friendshipismagic/SpiROSE/README.md

This is the default README, please edit me.
