friendshipismagic/SpiROSE/PCB/Rotative_base/Integration/AugmentedPins.txt

------------------------------------------------------------------------
            Part/Reference             | Pin | Augmented Net Name
------------------------------------------------------------------------
 Part 40-0219                          |
       U8                              |    3| <unconnected pin>
       U8                              |    6| <unconnected pin>
       U7                              |    3| <unconnected pin>
       U7                              |    6| <unconnected pin>
