friendshipismagic/SpiROSE/docs/ROSE_slides/SpiROSE soutenance finale.pptx

## Spi ROSE

## L’équipe

- Alexis Bauvin
- Vincent Charbonniéras
- Clément Decoodt
- Alexandre Janniaux
- Adrien Marcenat

## Objectifs du projet

- Framework de développement sur PC
- Reconfigurable à distance
- Haute densité de LED
- Persistance de vision
- Jusqu'à 30 RPS

Notes: Reprise et amélioration de l’idée de HAARP, projet antérieur.

## Pour quels usages ?

- Visualisation de données (e.g. champ magnétique)
- Visualisation 3D
- Exposition
- Jeux

## Architecture

## Slide 6

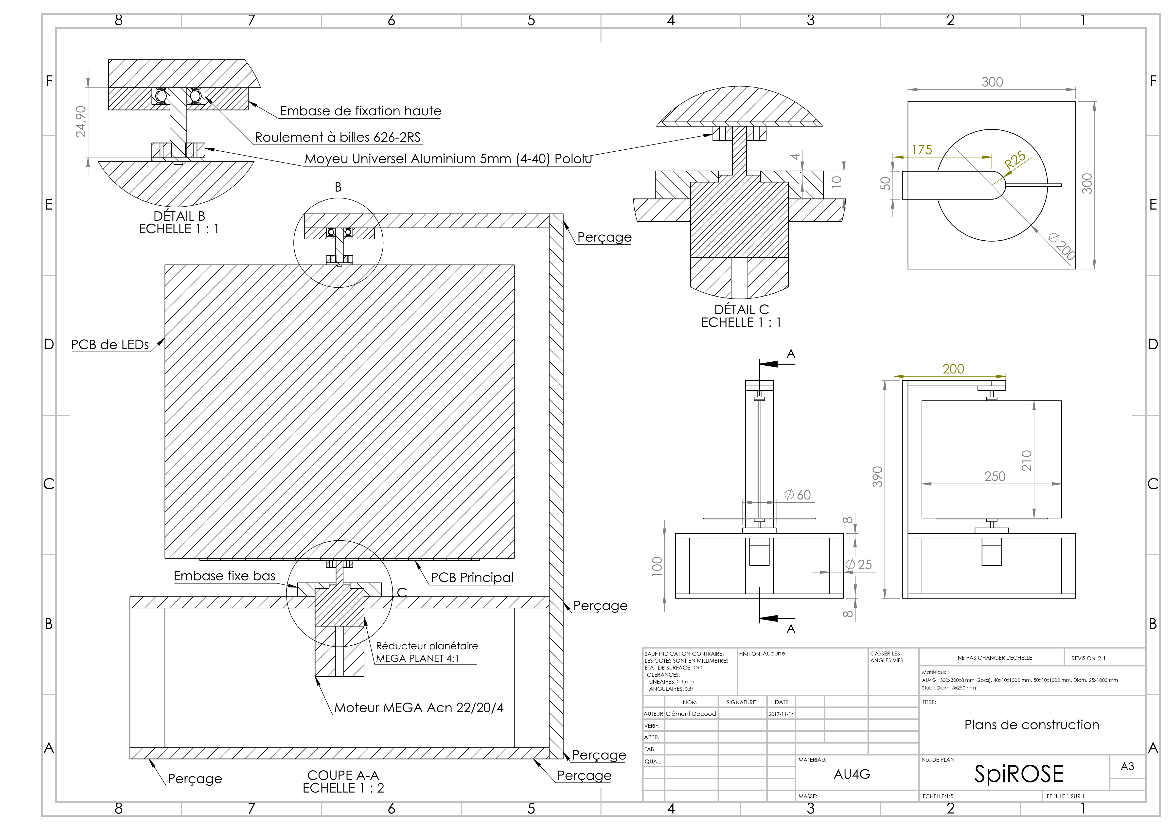
[picture p1: figure]

## Slide 7

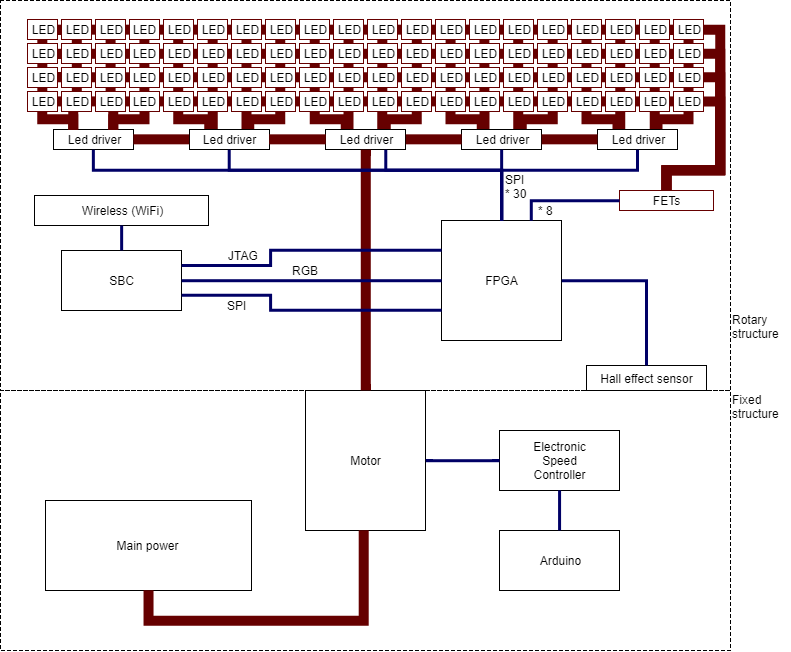
[picture p2: figure]

## Slide 8

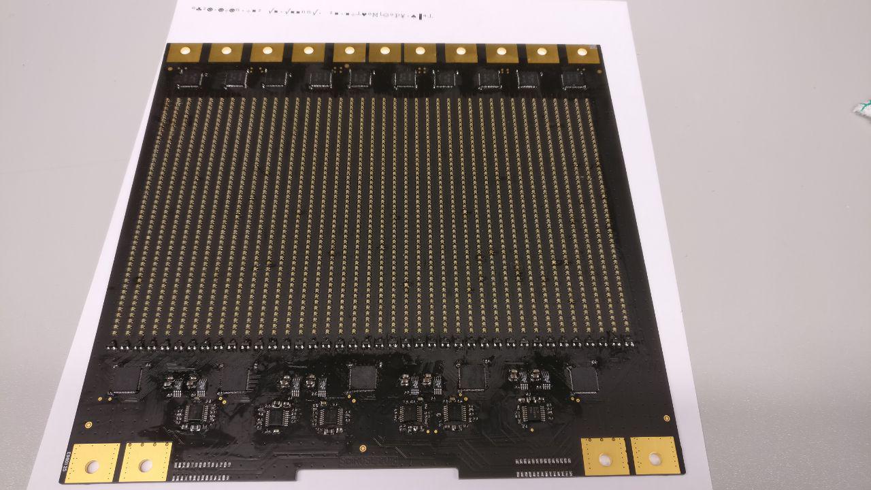
[picture p3: figure]

Matrice de 40x48 LEDS

## Slide 9

Matrice de 40x48 LEDS

Drivers de LED

## Slide 10

Matrice de 40x48 LEDS

Drivers de LED

MOSFETs

## Slide 11

Cyclone III

Notes: 1 Mbit de RAM

## Slide 12

Cyclone III

DC/DC
12V -> 5V

Notes: 1 Mbit de RAM

## Slide 13

Capteur à effet hall

Cyclone III

DC/DC
12V -> 5V

Notes: 1 Mbit de RAM

## Slide 14

Capteur à effet hall

Cyclone III

Slot pour
SBC

DC/DC
12V -> 5V

Notes: 1 Mbit de RAM

## Slide 15

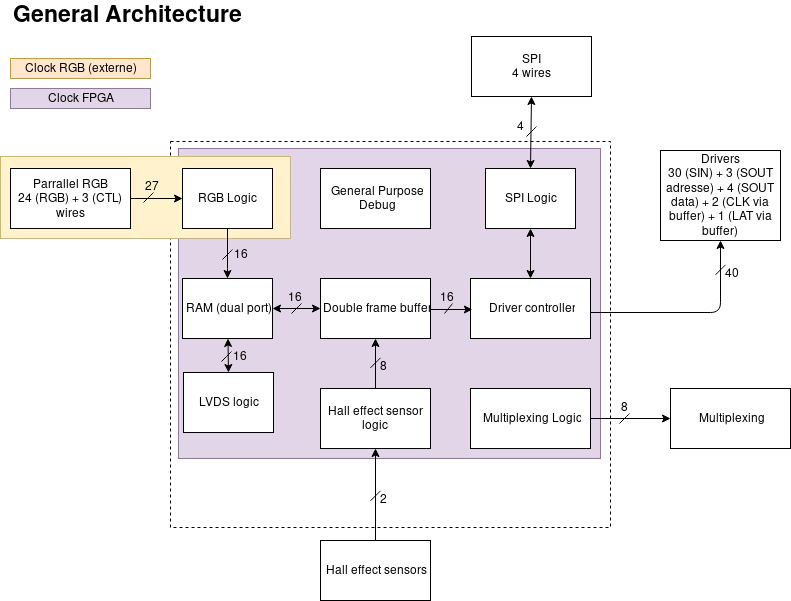
[picture p4: figure]

## libSpiROSE

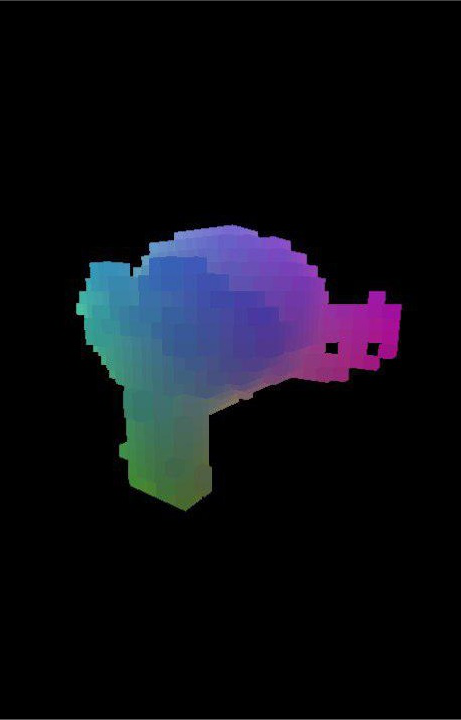
[picture p5: figure]

- Voxelisation de scènes 3D OpenGL
- Gestion des couleurs
- Génération du flux de sortie

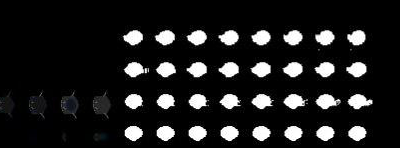
[picture p6: figure]

## Améliorations futures

- Interface web et écran LCD pour :
  - configurer l'affichage
  - lancer les applications
- Meilleur packaging
- Meilleur équilibrage pour réduire le bruit et les vibrations

## Merci pour votre attention Des questions ?

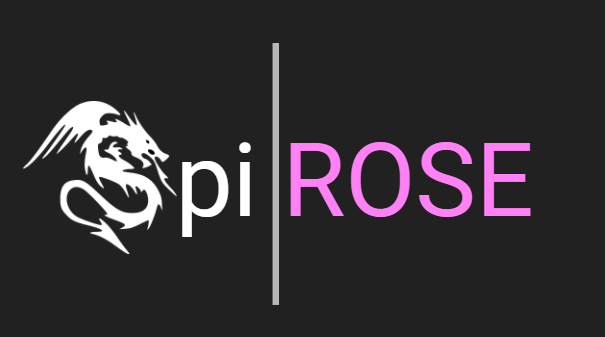
[picture p7: figure]

Logo dragon (https://pixabay.com/p-158186/?no_redirect) sous licence CC BY

## pi ROSE

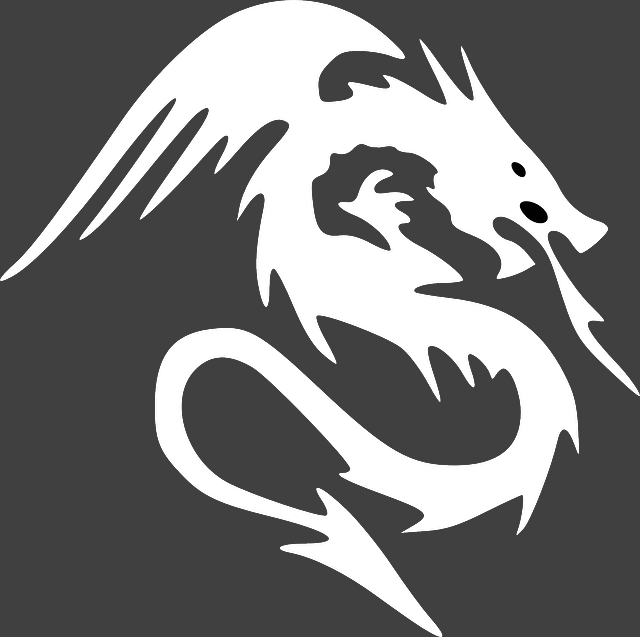
[picture p8: figure]

## Slide 20

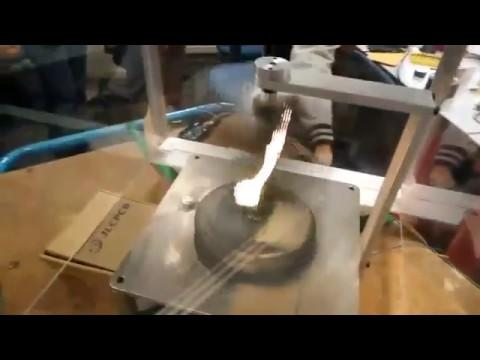
[picture p9: figure]

## Slide 21

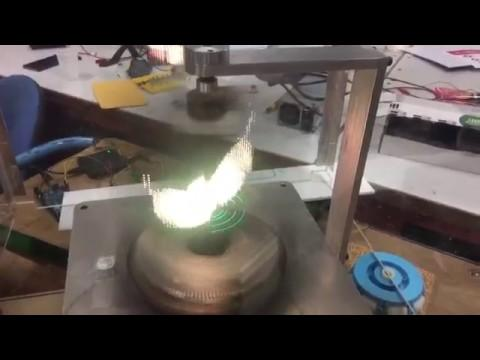
[picture p10: figure]
