friendshipismagic/SpiROSE/PCB/misc/LED_Panel_4_layers/Integration/UnusedPins.txt

Schematic unused pins from : Packager  18-Dec-2017  11:08

------------------------------------------------------------------------
            Part/Reference             |          Unused pins
                                       |  (G) - Gate, (P) - Partial Gate
------------------------------------------------------------------------
 Part 02-0098                          |
 Part 02-0118                          |
 Part 10-0058                          |
 Part 10-0060                          |
 Part 10-0068                          |
 Part 10-0103                          |
 Part 20-0073                          |
 Part 30-0014                          |
 Part 40-0307                          |
 Part 40-0320                          |
 Part 50-0005                          |
 Part 70-0029                          |
 Part 70-0076                          |
 Part 80-0063                          |
