friendshipismagic/SpiROSE/PCB/LED_Panel/Assembly/BOM.xlsx

Part | Value | Device | Package | Description | Description2 | Qty | Place | Provided_by_customer | Distributor | Ordernumber | Weblink | Remarks_customer | Unit_price | Total_price | REMARKS_BETA | OPTION1 | OPTION2 | OPTION3
C1,C2,C3,C4,C5,C6,C10,C7,C11,C12,C13,C14,C15,C8,C9 | 1uF | CAP C0402 1uF X5R 6.3V | C0402 | Capacitor Ceramic X5R / 1uF / 6.3V / ±10% / case 0402 | GRM155R60J105ME19D - Condensateur céramique multicouche CMS, 0402 [1005 Metric], 1 µF, 6.3 V, ± 20%, X5R, Série GRM | 15 | YES |  | Farnell | 2362087 | Click here | Stock: 14520 |  |  |  | 10-0060
C16,C17,C20,C18,C19,C21,C22,C23,C24,C25,C26,C27,C30,C28,C31,C29,C32,C33 | 100nF | CAP C0402 100nF X7R 16V | C0402 | Capacitor Ceramic X7R / 100nF / 16V / ±10% / case 0402 | 0402X104K160CT - Condensateur céramique multicouche CMS, 0402 [1005 Metric], 0.1 µF, 16 V, ± 10%, X5R, Walsin MLCC | 18 | YES |  | Farnell | 2496810 | Click here | Stock: 66390 |  |  |  | 10-0058
C34,C35,C36,C37,C38,C39 | 1uF | CAP C0603 1uF X5R 25V | C0603 | Capacitor Ceramic 1uF / X5R / 25V / ±10% / case 0603 | GRM188R61E105KA12D - Condensateur céramique multicouche CMS, 0603 [1608 Metric], 1 µF, 25 V, ± 10%, X5R, Série GRM | 6 | YES |  | Farnell | 1828802 | Click here | Stock: 6860 |  |  |  | 10-0068
C40,C41,C42,C43,C44,C45 | 10uF | CAP C0603 10uF X5R 6.3V | C0603 | Capacitor Ceramic X5R / 10uF / 6.3V / ±20% / case 0603 | MC0603X106M6R3CT - Condensateur céramique multicouche CMS, 0603 [1608 Metric], 10 µF, 6.3 V, ± 20%, X5R, Série MC | 6 | YES |  | Farnell | 1759393 | Click here | Stock: Plus stocké |  |  |  | 10-0103
C46,C47,C50,C48,C49,C51,C52,C60 | 100nF | CAP C0603 100nF X7R 16V | C0603 | Capacitor Ceramic X7R / 100nF / 16V / ±10% / case 0603 | C0603X104K4RACTU - Condensateur céramique multicouche CMS, FT-CAP, 0603 [1608 Metric], 0.1 µF, 16 V, ± 10%, X7R | 8 | YES |  | Farnell | 1414027 | Click here | Stock: 132555 |  |  |  | 10-0057
C53,C54,C55,C56,C57,C58,C61,C59 | 10uF | CAP C0805 10uF X5R 10V | C0805 | Capacitor Ceramic X5R / 10uF / 10V / ±10% / case 0805 | C0805C106K8PACTU - Condensateur céramique multicouche CMS, 0805 [2012 Metric], 10 µF, 10 V, ± 10%, X5R, Série C | 8 | YES |  | Farnell | 1463362 | Click here | Stock: 46486 |  |  |  | 10-0061
U16,U17,U20,U18,U21,U19 | CDCLVC1108PWR | CDCLVC1108PWR | TSSOP016_065_0510_0660_110 | High-Performance Clock Buffer, 8 output, 2.5 / 3.3V, exas Instruments CDCLVC1108PWR, case TSSOP16 |  | 6 | YES |  | Mouser France | 595-CDCLVC1108PWR |  | Stock: |  |  |  | 40-0320
J1,J2 | CLP-114-02-F-DH | CLP-114-02-F-DH | CLP-114-02-F-DH | 2*14 points female SMD connector, 2 rows, right-angle, 1.27mm, Samtec CLP-114-02-F-DH | CLP-114-02-F-DH - Connecteur carte-à-carte, Vertical, 1.27 mm, 28 Contact(s), Embase, Série CLP, Montage CMS | 2 | YES |  | Farnell | 1932124 | Click here | Stock: 200 |  |  |  | 70-0108
L1,L2,L3,L4,L5,L6 | FERRITE | FERRITE | L080505 | Ferrite bead 600ohms @ 100MHz / 200mA / case 0805 / Murata BLM21A601S |  | 6 | YES |  | Radiospares | 230-3862 |  | Stock: |  |  |  | 50-0005
D410,D390,D62,D1724,D1325,D777,D378,D420,D63,D1824,D1425,D807,D787,D1026,D408,D388,D430,D64,D1525,D1126,D817,D797,D418,D398,D440,D65,D1625,D1226,D827,D428,D450,D66,D1725,D1326,D837,D438,D460,D67,D1825,D1426,D847,D1027,D448,D470,D68,D70,D1526,D1127,D857,D458,D500,D480,D101,D69,D71,D1626,D1227,D867,D468,D510,D490,D111,D72,D1726,D1327,D877,D478,D520,D121,D73,D1826,D1427,D887,D907,D1030,D1028,D508,D488,D109,D530,D131,D74,D1527,D1130,D1128,D917,D897,D498,D518,D119,D540,D141,D75,D1627,D1230,D1228,D927,D528,D129,D550,D151,D76,D1727,D1328,D1330,D937,D538,D139,D560,D161,D77,D1827,D1430,D1428,D947,D1029,D1031,D548,D149,D570,D171,D78,D80,D1530,D1528,D1129,D1131,D957,D558,D159,D600,D580,D201,D181,D81,D79,D1628,D1630,D1229,D1231,D967,D568,D169,D610,D590,D211,D191,D82,D1730,D1728,D1329,D1331,D977,D578,D179,D620,D221,D83,D1830,D1828,D1431,D1429,D987,D1032,D608,D588,D209,D189,D630,D231,D84,D1531,D1529,D997,D1132,D618,D598,D219,D199,D640,D241,D85,D1629,D1631,D1232,D628,D229,D650,D251,D86,D1729,D1731,D1332,D638,D239,D660,D261,D87,D1829,D1831,D1432,D1033,D648,D249,D670,D271,D88,D90,D1532,D1133,D658,D259,D700,D680,D301,D281,D89,D91,D1632,D1233,D668,D269,D710,D690,D311,D291,D92,D1732,D1333,D678,D279,D720,D321,D93,D1832,D1433,D1034,D708,D688,D309,D289,D730,D331,D94,D1533,D1134,D718,D698,D319,D299,D740,D341,D95,D1633,D1234,D728,D329,D750,D351,D96,D1733,D1334,D738,D339,D760,D361,D97,D1833,D1434,D1035,D748,D349,D770,D371,D98,D1534,D1135,D758,D359,D800,D780,D401,D381,D99,D1634,D1235,D768,D369,D810,D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 | LRTBR48G | LRTBR48G | LRTBR48G | Led RGB high luminosity, OSRAM LRTBR48G-P9Q7-1+R7S5-26+N5P-68-ZB |  | 1920 | YES |  | Mouser France | 720-LRTBR48G |  | Stock: |  |  |  | 20-0073
U22,U23,U24,U25,U26,U27,U28,U29 | LTC1693-5CMS8 | LTC1693-5CMS8 | MS08_065_300_300_110 | High speed PMOS driver, Linear Tech LTC1693-5CMS8#PBF, case SO8 |  | 8 | YES |  | Mouser France | 584-LTC1693-5CMS8PBF |  | Stock: |  |  |  | 40-0336
R1,R2,R3,R4,R5,R6,R10,R7,R11,R12,R13,R14,R15,R8,R9,R31,R32,R33,R34,R35,R36,R37,R38 | 10K | RES_10k_0402 | R0402 | Resistor 10k ohms / 1% / case 0402 | RC0402FR-0710KL. - Résistance à puce CMS, Couche épaisse, 10 kohm, 50 V, Couche épaisse, 0402 [1005 Metric], 62.5 mW | 23 | YES |  | Farnell | 9239359 | Click here | Stock: 341980 |  |  |  | 02-0098
R56,R57,R58,R60,R61,R59,R62,R63,R64,R65,R66,R67,R70,R68,R69,R71,R72,R73,R74,R75,R76,R77,R78,R80,R79,R81,R82,R83,R16,R17,R20,R18,R19,R21,R22,R23,R24,R25,R26,R27,R30,R28,R29,R40,R41,R39,R42,R43,R44,R45,R46,R47,R48,R50,R51,R49,R52,R53,R54,R55 | 56 | RES_56_0402 | R0402 | Resistor 56 ohms / 1% / case 0402 | RC0402FR-0756RL - Résistance à puce CMS, Couche épaisse, 56 ohm, 50 V, Couche épaisse, 0402 [1005 Metric], 63 mW | 60 | YES |  | Farnell | 9239081 | Click here | Stock: 9322 |  |  |  | 02-0116
Q1,Q2,Q3,Q4,Q5,Q6,Q10,Q7,Q11,Q12,Q13,Q14,Q15,Q16,Q17,Q18,Q20,Q8,Q19,Q21,Q22,Q23,Q24,Q25,Q26,Q27,Q9,Q30,Q28,Q31,Q29,Q32,Q33,Q34,Q35,Q36,Q37,Q38,Q40,Q39 | SI2333CDS-T1-GE3 | SI2333CDS-T1-GE3 | SOT23 | PMOS, 5A transistor, Vishay SI2333CDS-T1-GE3, case SOT23 | SI2333CDS-T1-GE3 - Transistor MOSFET, Canal P, -7.1 A, -12 V, 28.5 mohm, -4.5 V, -400 mV | 40 | YES |  | Farnell | 1779259 | Click here (http://fr.farnell.com/webapp/wcs/stores/servlet/Search?exaMfpn=true&mfpn=1779259) | Stock: 16232 |  |  |  | 30-0014
U1,U2,U3,U4,U5,U6,U10,U7,U11,U12,U13,U14,U15,U8,U9 | TLC5957RT | TLC5957RT | QFN56E_050_800_800_100 | 48-Channel, 16-Bit ES-PWM LED Driver with Pre-Charge FET, LED OPEN Detection and Caterpillar Cancelling, Texas Instruments TLC5957RT, ase EQFN56 |  | 15 | YES |  | Mouser France | 595-TLC5957RTQT |  | Stock: |  |  |  | 40-0307
 |  |  |  |  | Total components
 |  |  |  |  | Total to solder
