friendshipismagic/SpiROSE/PCB/Rotative_base/Assembly/BOM.xlsx

Part | Value | Device | Package | Description | Description2 | Qty | Place | Provided_by_customer | Distributor | Ordernumber | Weblink | Remarks_customer | Unit_price | Total_price | REMARKS_BETA | OPTION1 | OPTION2 | OPTION3
U7,U8 | AH1885-ZG-7 | AH1885-ZG-7 | SOT553 | Hall sensor, AH1885-ZG-7, case SOT553 | AH1885-ZG-7 - Capteur à effet Hall, Omnipolaire, 0.5 A, SOT, 5 Broche(s), 1.65 V, 3.3 V | 2 | YES |  | Mouser France |  | Click here (http://fr.farnell.com/webapp/wcs/stores/servlet/Search?exaMfpn=true&mfpn=%201825248) |  |  |  |  | 40-0219
J1 | AS0B826-S43B-7H | AS0B826-S43B-7H | AS0B826-S43B-7H | MXM EDM Connector, 314 pts, 7mm, Foxconn AS0B826-S43B-7H |  | 1 | YES |  | Mouser France | 570-EDMCONNECTORKIT |  | Stock: |  |  |  | 70-0103
C70,C68,C69,C71,C72,C73,C28 | 390uF | CAP CHIM E 390uF 20V | CHIMIQUE_E12 | OSCon Capacitor 390uF, 20V, 14mOhms, Panasonic 20SVF390M, case E12 | 20SVF390M - Condensateur, 390 µF, 20 V, Radial - CMS, OS-CON SVF Series, 0.014 ohm, 1000 heures à 125°C | 7 | YES |  | Farnell | 2759063 | Click here (http://fr.farnell.com/webapp/wcs/stores/servlet/Search?exaMfpn=true&mfpn=%202759063) | Stock: 797 |  |  |  | 10-0115
C65 | 2.2nF | CAP C0402 2.2nF NPO 25V 5% | C0402 | Capacitor Ceramic 2.2nF, NP0, 25V, ±5%, Kemet C0402C222J3GACTU, case 0402 | C0402C222J3GACTU - Condensateur céramique multicouche CMS, 0402 [1005 Metric], 2200 pF, 25 V, ± 5%, C0G / NP0, Série C | 1 | YES |  | Farnell | 1535555 | Click here (http://fr.farnell.com/webapp/wcs/stores/servlet/Search?exaMfpn=true&mfpn=%201535555) | Stock: 96103 |  |  |  | 10-0105
C62,C76 | 2.2uF | CAP C0402 2.2uF X6S 6.3V | C0402 | Capacitor Ceramic 2.2uF, X6S, 6.3V, ±10% / case 0402 | GRT155C80J225KE01D - Condensateur céramique multicouche CMS, 0402 [1005 Metric], 2.2 µF, 6.3 V, ± 10%, X6S, GRT Series | 2 | YES |  | Farnell | 2672104 | Click here (http://fr.farnell.com/webapp/wcs/stores/servlet/Search?exaMfpn=true&mfpn=%202672104) | Stock: 17494 |  |  |  | 10-0117
C63,C64,C60,C59 | 10uF | CAP C0402 10uF X5R 6V3 20% | C0402 | Capacitor Ceramic 10µF, X5R, 6.3V, ±20%, TDK C1005X5R0J106M050BC, case 0402 | C1005X5R0J106M050BC - Condensateur céramique multicouche CMS, 0402 [1005 Metric], 10 µF, 6.3 V, ± 20%, X5R, Série C | 4 | YES |  | Farnell | 2346872 | Click here (http://fr.farnell.com/webapp/wcs/stores/servlet/Search?exaMfpn=true&mfpn=%202346872) | Stock: 59463 |  |  |  | 10-0106
C1,C2,C3,C4,C5,C6,C7,C10,C11,C12,C13,C14,C15,C16,C17,C18,C20,C8,C19,C9,C57,C58 | 100nF | CAP C0402 100nF X7R 16V | C0402 | Capacitor Ceramic X7R / 100nF / 16V / ±10% / case 0402 | 0402X104K160CT - Condensateur céramique multicouche CMS, 0402 [1005 Metric], 0.1 µF, 16 V, ± 10%, X5R, Walsin MLCC | 22 | YES |  | Farnell | 2496810 | Click here (http://fr.farnell.com/webapp/wcs/stores/servlet/Search?exaMfpn=true&mfpn=%202496810) | Stock: 66390 |  |  |  | 10-0058
C80,C79,C81,C82,C30,C29,C31,C32,C33,C34,C35,C36,C37,C38,C40,C39,C41,C42,C43,C44,C45,C46,C47,C50,C48,C51,C49,C52,C53,C54,C55,C56 | 330nF | CAP C0402 330nF X5R 6.3V 10% | C0402 | Capacitor Ceramic 330nF, X5R, 6.3V, ±10%, case 0402 | C1005X5R0J334K050BB - Condensateur céramique multicouche CMS, 0402 [1005 Metric], 0.33 µF, 6.3 V, ± 10%, X5R, C Series | 32 | YES |  | Farnell | 2528755 | Click here (http://fr.farnell.com/webapp/wcs/stores/servlet/Search?exaMfpn=true&mfpn=%202528755) | Stock: 1449 |  |  |  | 10-0114
C66 | 220nF | CAP C0603 220nF X7R 16V | C0603 | Capacitor Ceramic X7R / 220nF / 16V / ±10% / case 0603 | C0603X224K4RACTU - Condensateur céramique multicouche CMS, FT-CAP, 0603 [1608 Metric], 0.22 µF, 16 V, ± 10%, X7R | 1 | YES |  | Farnell | 1414032 | Click here (http://fr.farnell.com/webapp/wcs/stores/servlet/Search?exaMfpn=true&mfpn=%201414032) | Stock: 6073 |  |  |  | 10-0070
C67,C74,C77,C78 | 47uF | CAP C1206 47uF X5R 10V | C1206 | Capacitor Ceramic X5R / 47uF / 10V / ±20% / case 1206 | GRM31CR61A476ME15L - Condensateur céramique multicouche CMS, 1206 [3216 Metric], 47 µF, 10 V, ± 20%, X5R, Série GRM | 4 | YES |  | Farnell | 2495156 | Click here (http://fr.farnell.com/webapp/wcs/stores/servlet/Search?exaMfpn=true&mfpn=%201797008) | Stock: Plus stocké |  |  |  | 10-0087
C21,C22,C23,C24,C25,C26,C27,C61 | 100uF | CAP C1210 100uF X5R 6.3V 20% | C1210 | Capacitor ceramic 100uF, X5R, 6.3V, ±20%, Kemet GRM32ER60J107ME20L, case 1210 | GRM32ER60J107ME20L - Condensateur céramique multicouche CMS, 1210 [3225 Metric], 100 µF, 6.3 V, ± 20%, X5R, Série GRM | 8 | YES |  | Farnell | 1828817 | Click here (http://fr.farnell.com/webapp/wcs/stores/servlet/Search?exaMfpn=true&mfpn=%201828817) | Stock: 24912 |  |  |  | 10-0113
U9 | DS26LV32ATM | DS26LV32ATM | SOIC016_127_1000_0620_175 | Quadruple RS422 receiver, 3.3V, 32MHz, National Semiconductor DS26LV32ATM, case SOIC16 | DS26LV32ATM/NOPB - Récepteur de ligne différentielle RS422, 4 drivers, Alimentation 3V à 3.6V, SOIC-16 | 1 | YES |  | Farnell | 1468999 | Click here (http://fr.farnell.com/webapp/wcs/stores/servlet/Search?exaMfpn=true&mfpn=%201468999) | Stock: 5357 |  |  |  | 40-0221
U1 | EP3C40Q240C8N | EP3C40Q240C8N | PQFP240_050_3460_3460_380 | Cyclone III FPGA, 24675 LE, Altera EP3C40Q240C8N, case PQFP240 |  | 1 | YES |  | Mouser France | 989-EP3C40Q240C8N |  | Stock: |  |  |  | 40-0310
J4,J5,J6,J7 | FTS-114-01-F-D | FTS-114-01-F-D | FTS-114-01-F-D | 2*14 points male connector, 2 rows, right-angle, 1.27mm, Samtec FTS-114-01-F-D | FTS-114-01-F-D - Connecteur carte-à-carte, Vertical, 1.27 mm, 28 Contact(s), Embase, Série FTS, Traversant | 4 | YES |  | Farnell | 1930628 | Click here (http://fr.farnell.com/webapp/wcs/stores/servlet/Search?exaMfpn=true&mfpn=%201930628) | Stock: 200 |  |  |  | 70-0109
U6 | LTC3633EFE | LTC3633EFE | ETSSOP028_065_0980_0620_120 | Dual Channel 3A, 15V Monolithic Synchronous Step-Down Regulator, 4MHz, Linear LTC3633EFE#PBF, case ETSSOP28 | LTC3633EFE#PBF - Régulateur à découpage, DC/DC Synchrone, Entrée 3.6 V à 15 V, 2 sorties 13,5V/3A, 4,6 MHz, TSSOP-28 | 1 | YES |  | Farnell | 1839138 | Click here (http://fr.farnell.com/webapp/wcs/stores/servlet/Search?exaMfpn=true&mfpn=%201839138) | Stock: 6 |  |  |  | 40-0324
U2 | LT1765ES8 | LT1765ES8 | SOP008_127_0500_0620_175 | 3A 1.25 MHz Step-down Converter / Linear Tech LT1765ES8 / Adj output / case SOIC8 | LT1765ES8#PBF - Régulateur DC/DC à découpage Buck (Step Down), Ajustable, 3V-25Vin, 1.2V-20Vout, 3Aout, SOIC-8 | 1 | YES |  | Farnell | 1273783 | Click here (http://fr.farnell.com/webapp/wcs/stores/servlet/Search?exaMfpn=true&mfpn=%201273783) | Stock: 119 |  |  |  | 40-0003
D2 | MBRS130LT3 | MBRS130LT3 | SMB | Diode Shottky 1A 395mV 30V Motorola MBRS130LT3 case SMB |  | 1 | YES |  | Radiospares | 348-6283 |  | Stock: |  |  |  | 20-0002
D1 | MBR0540-T1 | MBR0540-T1 | SOD123 | Diode Shottky 500mA 0.5V OnSemi MBRS540 case SOD123 | MBR0540T1G - Redresseur Schottky, 40 V, 500 mA, Une, SOD-123, 2 Broche(s), 510 mV | 1 | YES |  | Farnell | 9556923 | Click here (http://fr.farnell.com/webapp/wcs/stores/servlet/Search?exaMfpn=true&mfpn=%209556923) | Stock: Plus stocké |  |  |  | 20-0019
U3 | MCP1826S-2502E/DB | MCP1826S-2502E/DB | SOT223 | 1A low voltage LDO regulator, 2.5V, Microchip MCP1826S-2502E/DB, case SOT223-3 | MCP1826S-2502E/DB - Régulateur LDO Tension fixe, 2.3V à 6V, 250mV Dropout, 2.5Vout, 1Aout, SOT-223-3 | 1 | YES |  | Farnell | 1851997 | Click here (http://fr.farnell.com/webapp/wcs/stores/servlet/Search?exaMfpn=true&mfpn=%201851997) | Stock: 58 |  |  |  | 40-0227
U4 | MCP1826S-3002E/DB | MCP1826S-3002E/DB | SOT223 | 1A low voltage LDO regulator, 3.0V, Microchip MCP1826S-3002E/DB, case SOT223-3 | MCP1826S-3002E/DB - Régulateur LDO Tension fixe, 2.3V à 6V, 250mV Dropout, 3Vout, 1Aout, SOT-223-3 | 1 | YES |  | Farnell | 1578422 | Click here (http://fr.farnell.com/webapp/wcs/stores/servlet/Search?exaMfpn=true&mfpn=%201578422) | Stock: 369 |  |  |  | 40-0325
J2 | MICROMATCH-4 | MICROMATCH-4 | AMP7-188275-4 | 4pins smd on board connector Micromatch AMP 7-188275-4 | 7-188275-4 - Connecteur carte-à-carte, 1.27 mm, 4 Contact(s), Embase, Série Micro-MaTch, Montage CMS | 1 | YES |  | Farnell | 3784710 | Click here (http://fr.farnell.com/webapp/wcs/stores/servlet/Search?exaMfpn=true&mfpn=%203784710) | Stock: 7900 |  |  |  | 70-0014
J3 | MICROMATCH-10 | MICROMATCH-10 | AMP8-188275-0 | 10pins smd on board connector Micromatch AMP 8-188275-0 |  | 1 | YES |  | Radiospares | 366-1759 |  | Stock: |  |  |  | 70-0015
L1,L2,L3,L4 | MLF2012DR56K | MLF2012DR56K | L0603 | Ferrite 560nH, Q=35, F=150-200MHz, 0.55ohms, 150mA, TDK MLF2012DR56K, case 0603 | MLF2012DR56K - Inductance haute fréquence CMS, Série MLF, 560 nH, 150 mA, 0805 [2012 Metric], Multicouches | 4 | YES |  | Farnell | 1669561 | Click here (http://fr.farnell.com/webapp/wcs/stores/servlet/Search?exaMfpn=true&mfpn=%201669561) | Stock: 3272 |  |  |  | 50-0023
U5 | PTH12040WAD | PTH12040WAD | PTH12040WAD | 50A, 8V-14V input, non isolated wide output adjsut power supply module, Texas Instruments PTH12040WAD |  | 1 | YES |  | Mouser France | 595-PTH12040WAD |  | Stock: |  |  |  | 80-0072
R11 | 0 | RES_0_0603 | R0603 | Resistor 0 ohms / 5% / case 0603 | CR0603-J/-000ELF - Résistance à puce CMS, Couche épaisse, 0 ohm, 50 V, Couche épaisse, 0603 [1608 Metric], 100 mW, ± 5% | 1 | YES |  | Farnell | 2008343 | Click here (http://fr.farnell.com/webapp/wcs/stores/servlet/Search?exaMfpn=true&mfpn=%202008343) | Stock: 21847 |  |  |  | 00-0001
R12 | 0 | RES_0_0603 | R0603 | Resistor 0 ohms / 5% / case 0603 | CR0603-J/-000ELF - Résistance à puce CMS, Couche épaisse, 0 ohm, 50 V, Couche épaisse, 0603 [1608 Metric], 100 mW, ± 5% | 1 | YES |  | Farnell | 2008343 | Click here (http://fr.farnell.com/webapp/wcs/stores/servlet/Search?exaMfpn=true&mfpn=%202008343) | Stock: 21847 |  |  |  | 00-0001
R1,R2,R3,R4,R5,R9 | 10K | RES_10k_0402 | R0402 | Resistor 10k ohms / 1% / case 0402 | RC0402FR-0710KL. - Résistance à puce CMS, Couche épaisse, 10 kohm, 50 V, Couche épaisse, 0402 [1005 Metric], 62.5 mW | 6 | YES |  | Farnell | 9239359 | Click here (http://fr.farnell.com/webapp/wcs/stores/servlet/Search?exaMfpn=true&mfpn=%209239359) | Stock: 341980 |  |  |  | 02-0098
R8 | 45.3K | RES_45.3k_0402 | R0402 | Resistor 45.3kohms / 1% / case 0402 | MCMR04X4532FTL - Résistance à puce CMS, Céramique, 45.3 kohm, 50 V, Couche épaisse, 0402 [1005 Metric], 62.5 mW | 1 | YES |  | Farnell | 2073053 | Click here (http://fr.farnell.com/webapp/wcs/stores/servlet/Search?exaMfpn=true&mfpn=%202073053) | Stock: 3462 |  |  |  | 02-0453
R7 | 73.2K | RES_73.2k_0402 | R0402 | Resistor 73.2kohms / 1% / case 0402 | MC00625W0402173K2 - Résistance à puce CMS, Couche épaisse, 73.2 kohm, 50 V, Couche épaisse, 0402 [1005 Metric], 62.5 mW | 1 | YES |  | Farnell | 1803738 | Click here (http://fr.farnell.com/webapp/wcs/stores/servlet/Search?exaMfpn=true&mfpn=%201803738) | Stock: 6702 |  |  |  | 02-0452
R10 | 100K | RES_100k_0402 | R0402 | Resistor 100k ohms / 1% / case 0402 |  | 1 | YES |  |  |  |  | Stock: |  |  |  | 02-0445
R6 | 210 | RES_210_0603 | R0603 | Resistor 210 ohms / 1% / case 0603 |  | 1 | YES |  |  |  |  | Stock: |  |  |  | 01-0224
L5,L6 | 2.2uH | SELF 2.2uH | SRN5040 | 2.2uH inductor, 3.5 A, 4.6 A, 21mOhms, Bourns SRN5040-2R2Y | SRN5040-2R2Y - Inductances de Puissance (CMS), 2.2 µH, 3.5 A, Semi-blindé, 4.6 A, Série SRN5040, 5mm x 5mm x 4mm | 2 | YES |  | Farnell | 2428229RL | Click here (http://fr.farnell.com/webapp/wcs/stores/servlet/Search?exaMfpn=true&mfpn=%202428229RL) | Stock: 1026 |  |  |  | 50-0046
L7 | 4.7uH | SELF 4.7uH | IHLP-2525 | Inductor 4.7uH 4A 33mOhms Vishay Dale IHLP2525CZER4R7M11 | IHLP2525CZER4R7M11 - Inductances de Puissance (CMS), 4.7 µH, 6 A, Blindé, 4 A, Série IHLP-2525CZ-11 | 1 | YES |  | Farnell | 1741364 | Click here (http://fr.farnell.com/webapp/wcs/stores/servlet/Search?exaMfpn=true&mfpn=%201741364) | Stock: 351 |  |  |  | 50-0025
Q1 | 2N7002 | 2N7002 | SOT23 | Basic N-Channel MOSFET, 2N7002, case SOT23 | 2N7002-T1-E3 - Transistor MOSFET, Canal N, 115 mA, 60 V, 7.5 ohm, 10 V, 2.1 V | 1 | YES |  | Farnell | 1021754 | Click here (http://fr.farnell.com/webapp/wcs/stores/servlet/Search?exaMfpn=true&mfpn=%201021754) | Stock: Plus stocké |  |  |  | 30-0004
 |  |  |  |  | Total components | 119
 |  |  |  |  | Total to solder | 119
