friendshipismagic/SpiROSE/PCB/misc/LED_Panel_4_layers/Assembly/BOM.xlsx

Part | Value | Device | Package | Description | Description2 | Qty | Place | Provided_by_customer | Distributor | Ordernumber | Weblink | Remarks_customer | Unit_price | Total_price | REMARKS_BETA | OPTION1 | OPTION2 | OPTION3
J12,J11 | BARETTE_4P_2.54_COUDEE | BARETTE_4P_2.54_COUDEE | BAR04P2.54/COUDEE | Embase mâle une rangée 4 points coudée, pas 2.54mm, à piquer, Multicomp MC34749 | MC34749 - Connecteur carte-à-carte, Angle Droit, 2.54 mm, 4 Contact(s), Embase, Série MC34, Traversant | 2 | NO |  | Farnell | 1593428 | Click here | 16370 | 70-0060
SW1 | B3U-3000P | B3U-3000P | B3U_3000P | Button Switch latéral / 2 pins / SMD / Omron B3U-3000P | B3U-3000P - Commutateur tactile, Non lumineux, 12 V, 50 mA, 1.59 N, A souder, Série B3U | 1 | NO |  | Farnell | 1333655 | Click here | 7677 | 80-0035
D3 | B220A-13-F | B220A-13-F | SMA | Schottky diode, Imoy=2A, Vf=0.5V, Vr=20V, Diodes Inc B220A-13-F, case SMA | B220A-13-F - Redresseur Schottky, 20 V, 2 A, Une, SMD, 2 Broche(s), 500 mV | 1 | NO |  | Farnell | 1858604 | Click here | 16328 | 20-0064
C26,C11 | 10nF | CAP C0603 10nF X7R 50V | C0603 | Capacitor Ceramic C0G / 10nF / 50V / ±5% / case 0603 | GRM1885C1H103JA01D - Condensateur céramique multicouche CMS, 0603 [1608 Metric], 0.01 µF, 50 V, ± 5%, C0G / NP0 | 2 | NO |  | Farnell | 2456107 | Click here | 17243 | 10-0011
C9,C4,C3,C5,C6 | 10uF | CAP C0603 10uF X5R 6.3V | C0603 | Capacitor Ceramic X5R / 10uF / 6.3V / ±20% / case 0603 | MC0603X106M6R3CT - Condensateur céramique multicouche CMS, 0603 [1608 Metric], 10 µF, 6.3 V, ± 20%, X5R, Série MC | 5 | NO |  | Farnell | 1759393 | Click here | Plus stocké | 10-0103
C20,C19 | 18pF | CAP C0603 18pF COG 10V | C0603 | Capacitor Ceramic 18pF / 10V / ±20% / case 0603 |  | 2 | NO |  | Radiospares | 211-3164 |  |  | 10-0030
C32 | 33pF | CAP C0603 33pF NPO 50V | C0603 | Capacitor Ceramic 33pF / NPO / 50V / ±5% / case 0603 | CC0603JRNPO9BN330 - Condensateur céramique multicouche CMS, 0603 [1608 Metric], 33 pF, 50 V, ± 5%, C0G / NP0, Série CC | 1 | NO |  | Farnell | 722029 | Click here | 9305 | 10-0054
C14,C17,C15,C7,C21,C24,C18,C22,C12 | 100nF | CAP C0603 100nF X7R 16V | C0603 | Capacitor Ceramic X7R / 100nF / 16V / ±10% / case 0603 | C0603X104K4RACTU - Condensateur céramique multicouche CMS, FT-CAP, 0603 [1608 Metric], 0.1 µF, 16 V, ± 10%, X7R | 9 | NO |  | Farnell | 1414027 | Click here | 149775 | 10-0057
C31 | 220pF | CAP C0603 220pF NPO 50V | C0603 | Capacitor Ceramic 220pF / NPO / 50V / ±5% / case 0603 | 06035A221JAT2A - Condensateur céramique multicouche CMS, 0603 [1608 Metric], 220 pF, 50 V, ± 5%, C0G / NP0 | 1 | NO |  | Farnell | 498579 | Click here | 14375 | 10-0040
C8 | 820pF | CAP C0603 820pF NP0 50V | C0603 | Capacitor Ceramic 820pF / NP0 / 50V / ±5% / case 0603 |  | 1 | NO |  |  |  |  |  | 10-0100
C10,C13 | 22uF | CAP C0805 22uF X5R 10V | C0805 | Capacitor Ceramic X5R / 22uF / 10V / ±20% / case 0805 | GRM21BR61A226ME51L - Condensateur céramique multicouche CMS, 0805 [2012 Metric], 22 µF, 10 V, ± 20%, X5R, Série GRM | 2 | NO |  | Farnell | 2494270 | Click here | 40458 | 10-0111
Q4,Q8,Q9 | DMN2050L | DMN2050L | SOT23 | N-Channel MOSFET, 5.9A, 0.024ohms, Diodes Inc DMN2050L , case SOT23 | DMN2050L - Transistor MOSFET, Mode d'amélioration, Canal N, 5.9 A, 20 V, 0.024 ohm, 4.5 V, 450 mV | 3 | NO |  | Farnell | 2061409 | Click here | 2853 | 30-0019
U2 | DRV8835DSSR | DRV8835DSSR | WSON_050_310_210_80 | Dual Low-Voltage H-Bridge IC, 1.5A + 1.5A, 11V, Texas Instruments DRV8835DSSR, case WSON12 | DRV8835DSSR - Driver moteur pont en H double, Alimentation 2V à 7V, 2 Sorties 11V/1.5A, WSON-12 | 1 | NO |  | Farnell | 2115235 | Click here | 688 | 40-0291
J4 | FTSH-105-01-L-DV | FTSH-105-01-L-DV | FTSH-105-01-L-DV | Dual row 1.27 CMS 2x5 points connector, Samtec FTSH-105-01-L-DV | FTSH-105-01-L-DV - Connecteur carte-à-carte, 1.27 mm, 10 Contact(s), Embase, Série FTSH, Montage CMS, 2 Rangée(s) | 1 | NO |  | Farnell | 1667759 | Click here | 29609 | 70-0081
J9,J6,J10 | JUMPER 2PTS | JUMPER 2PTS | BAR02P2.54/W2.54 | Jumper 2 points 2.54mm avec cavalier associe |  | 3 | NO |  |  |  |  |  | 70-0002
U4 | LM2735XMF/NOPB | LM2735XMF/NOPB | SOT23_5 | Boost and SEPIC switching regulator, 1.6MHz, Vin=2.7-5.5V, Vout=3-24V, 2.1A, TI LM2735XMF/NOPB, case SOT-23-5 | LM2735XMF/NOPB - Régulateur DC/DC à découpage Boost, SEPIC, Ajustable, 2.7V-5.5Vin, 3V-24Vout, 2.1Aout, SOT-23-5 | 1 | NO |  | Farnell | 1685534 | Click here | 2620 | 40-0261
U8 | LTC3530EMS | LTC3530EMS | MS10_050_30_30_110 | Wide input voltage buck-boost synchronous DC/DC converter, Vin=1.8V-5.5V, 2MHz, 600mA, Linear LTC3530EMS, case MS10 | LTC3530EMS#PBF - Régulateur DC/DC à découpage Buck-Boost, Ajustable, 1.8V-5.5Vin, 1.8V-5.25Vout, 0.6Aout, MSOP-10 | 1 | NO |  | Farnell | 1329368 | Click here | 579 | 40-0232
J2,J3,J1 | MICROMATCH-6 | MICROMATCH-6 | AMP7-188275-6 | 6pins smd on board connector Micromatch AMP 7-188275-6 | 7-188275-6 - Connecteur carte-à-carte, 1.27 mm, 6 Contact(s), Embase, Série Micro-MaTch, Montage CMS | 3 | NO |  | Farnell | 1056234 | Click here | 36 | 70-0028
J5 | MOL-47346-0001 | MOL-47346-0001 | MOL-47346-0001 | Female micro-USB B bottom SMD mount connector, Molex 47346-0001 | 47346-0001 - Connecteur USB, Blindé, Micro USB Type B, USB 2.0, Embase, 5 Voies, Montage en surface, Coudée | 1 | NO |  | Farnell | 1568026 | Click here | 22304 | 70-0065
J7 | MOL22-05-3031 | MOL22-05-3031 | MOL22-05-3031 | Connector 3 points with mating, 2.54mm, TH, series KK 7478, Molex 22-05-3031 | 22-05-3031 - Connecteur fil-à-carte, 2.54 mm, 3 Contact(s), Embase, Série KK 7478, Traversant, 1 Rangée(s) | 1 | NO |  | Farnell | 1462932 | Click here | 15208 | 70-0099
U7 | MPU9250 | MPU9250 | QFN24E_040_300_300_100 | 3 axis gyroscope - accéléromètre - magnétomètre, +/- 250 à 2000°/s, 2-16g, +/-1200uT, 3.3V, I2C, SPI, Ivensense MPU9250, case QFN24 0.4mm, http://bit.ly/2eJzppX |  | 1 | NO |  | Digikey France | 1428-1019-1-ND |  |  | 40-0301
R8,R9,R18 | 1K | RES_1.0k_0603 | R0603 | Resistor 1.0k ohms / 5% / case 0603 | MC0063W060351K - Résistance à puce CMS, 1 kohm, 50 V, 0603 [1608 Metric], 63 mW, ± 5%, Série MC | 3 | NO |  | Farnell | 9331697 | Click here | Plus stocké | 00-0074
R16 | 1.5K | RES_1.5k_0603 | R0603 | Resistor 1.5k ohms / 5% / case 0603 |  | 1 | NO |  | Radiospares | 322-9377 |  |  | 00-0078
R1,R12 | 1K | RES_1.00k_0603 | R0603 | Resistor 1.00k ohms / 1% / case 0603 |  | 2 | NO |  |  |  |  |  | 01-0289
R10,R4 | 2.4K | RES_2.4k_0402 | R0402 | Resistor 2.4k ohms / 1% / case 0402 |  | 2 | NO |  |  |  |  |  | 02-0083
R5,R3 | 4.7K | RES_4.7k_0603 | R0603 | Resistor 4.7k ohms / 5% / case 0603 |  | 2 | NO |  | Radiospares | 322-9440 |  |  | 00-0090
R20 | 10K | RES_10.0k_0603 | R0603 | Resistor 10.0k ohms / 1% / case 0603 | MC0063W0603110K - Résistance à puce CMS, Couche épaisse, 10 kohm, 50 V, 0603 [1608 Metric], 63 mW, ± 1%, Série MC | 1 | NO |  | Farnell | 9330399 | Click here | Plus stocké | 01-0385
R19 | 10K | RES_10k_0402 | R0402 | Resistor 10k ohms / 1% / case 0402 | RC0402FR-0710KL. - Résistance à puce CMS, Couche épaisse, 10 kohm, 50 V, 0402 [1005 Metric], 62.5 mW, ± 1% | 1 | NO |  | Farnell | 1117284 | Click here | Plus stocké | 02-0098
R11 | 10K | RES_10k_0603 | R0603 | Resistor 10k ohms / 5% / case 0603 | MC0063W0603510K - Résistance à puce CMS, 10 kohm, 50 V, 0603 [1608 Metric], 63 mW, ± 5%, Série MC | 1 | NO |  | Farnell | 9331700 | Click here | 70599 | 00-0098
R29 | 12.1K | RES_12.1k_0603 | R0603 | Resistor 12.1k ohms / 1% / case 0603 |  | 1 | NO |  |  |  |  |  | 01-0393
R30 | 12K | RES_12k_0603 | R0603 | Resistor 12k ohms / 5% / case 0603 |  | 1 | NO |  |  |  |  |  | 00-0100
R13,R32,R31 | 20 | RES_20_0603 | R0603 | Resistor 20 ohms / 5% / case 0603 |  | 3 | NO |  |  |  |  |  | 00-0033
R22 | 30.1K | RES_30.1k_0603 | R0603 | Resistor 30.1k ohms / 1% / case 0603 |  | 1 | NO |  |  |  |  |  | 01-0431
R23 | 33.2K | RES_33.2k_0603 | R0603 | Resistor 33.2k ohms / 1% / case 0603 |  | 1 | NO |  |  |  |  |  | 01-0435
R14 | 33K | RES_33k_0603 | R0603 | Resistor 33k ohms / 5% / case 0603 |  | 1 | NO |  |  |  |  |  | 00-0110
R26,R27 | 200K | RES_200k_0603 | R0603 | Resistor 200k ohms / 5% / case 0603 |  | 2 | NO |  |  |  |  |  | 00-0129
R25 | 340K | RES_340k_0603 | R0603 | Resistor 340k ohms / 1% / case 0603 |  | 1 | NO |  |  |  |  |  | 01-0532
L1,L2 | 10uH | SELF 10uH | XAL50 | Inductor blindée 10uH, 20%, 4.9A, 15MHz, 0.047ohms, Coilcraft XAL5050-103MEC, boitier 5.48x5.28 | XAL5050-103MEC - Inductance de puissance CMS, 10 µH, 4.9 A, 4.9 A, Blindé, 0.045 ohm | 2 | NO |  | Farnell | 2289073 | Click here | 3 | 50-0038
U6 | STM32F302R6T6 | STM32F302R6T6 | LQFP064_050_1215_1215_160 | ARM-based Cortex-M4 32b MCU+FPU, 72MHz, 32KB Flash/16KB SRAM, USB FS, 2 SPI, 3 I2C, 3USART, 1 CAN, 6 TIMs, 3 ADCs, 1 OpAmp, 3 analog comparators, ST STM32F302R6T6, case TQFP64 | STM32F302R6T6 - Microcontrôleur ARM, À usage général, STM32 F3 ARM Cortex-M4 Microcontrollers, 32 bits, 72 MHz | 1 | NO |  | Farnell | 2424421 | Click here | 113 | 40-0292
Q1,Q3 | 2N7002 | 2N7002 | SOT23 | Basic N-Channel MOSFET, 2N7002, case SOT23 | 2N7002-T1-E3 - Transistor MOSFET, Canal N, 115 mA, 60 V, 7.5 ohm, 10 V, 2.1 V | 2 | NO |  | Farnell | 1021754 | Click here | Plus stocké | 30-0004
QZ1 | 8 MHz | 8 MHz | SM49US | Quartz 8 MHz, +/- 30ppm, 40 ohms, 18pF, case HC49SMD | CAA-8.000-18-3050-X - Cristal, 8 MHz, CMS, 10.3mm x 3.8mm, 50 ppm, 18 pF, 30 ppm, Série CAA | 1 | NO |  | Farnell | 1538763 | Click here | 1816 | 81-0013
