friendshipismagic/SpiROSE/docs/mechanical_design/SpiROSE.SLDASM

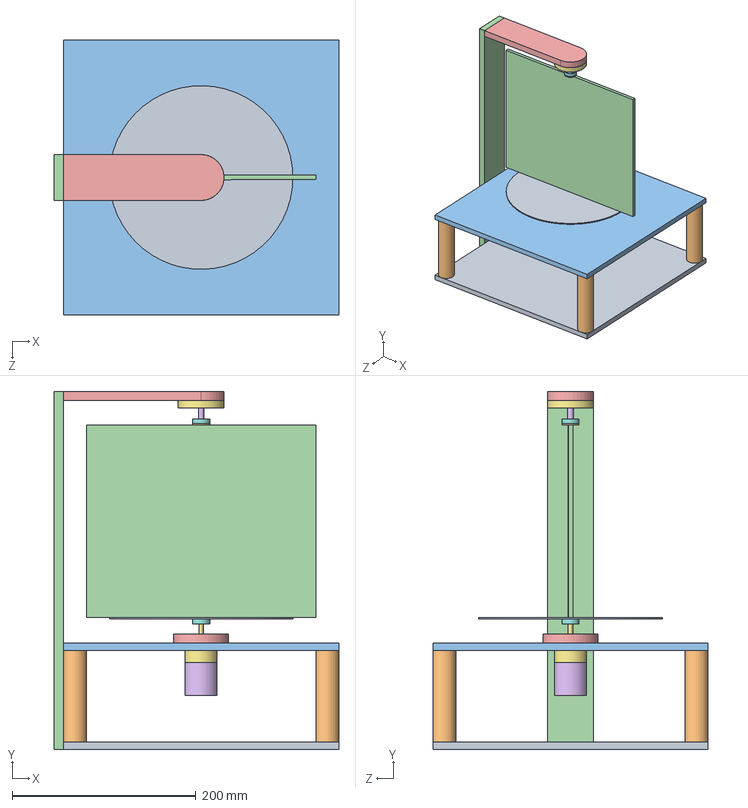
[picture p11: CAD file, 2017-11-16]
docs/mechanical_design/SpiROSE.SLDASM
310.0 x 390.0 x 300.0 mm
Fixation dessous
Pied x 4
Fixation dessus
Bras coté
Bras haut
Axe
Embase haut
l1-626-2rsh_01
l1-626-2rsh_02
l1-626-2rsh_03
l1-626-2rsh_04
l1-626-2rsh_05
l1-626-2rsh_06
l1-626-2rsh_07
l1-626-2rsh_08
l1-626-2rsh_09
l1-626-2rsh_10
l1-626-2rsh_11
l1-626-2rsh_12
Support PCB
Embase bas
Carter
Reducteur Planetaire
Moyeu x 2
PCB rotatif
PCB Haut
