friendshipismagic/SpiROSE/docs/mechanical_design/626-2RS/l1-626-2rsh.SLDASM

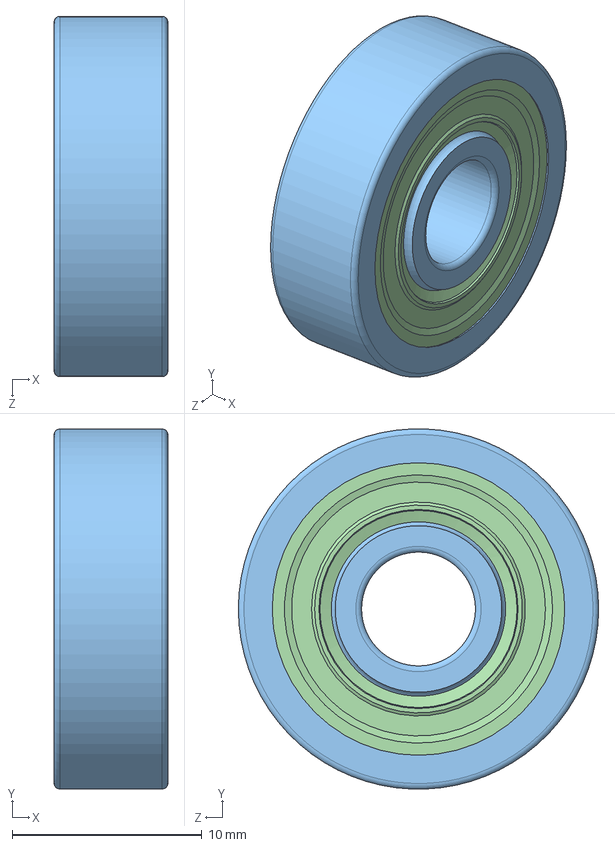
[picture p12: CAD file, 2017-11-14]
docs/mechanical_design/626-2RS/l1-626-2rsh.SLDASM
6.00 x 19.0 x 19.0 mm
l1-626-2rsh_01
l1-626-2rsh_02
l1-626-2rsh_03
l1-626-2rsh_04
l1-626-2rsh_05
l1-626-2rsh_06
l1-626-2rsh_07
l1-626-2rsh_08
l1-626-2rsh_09
l1-626-2rsh_10
l1-626-2rsh_11
l1-626-2rsh_12
