friendshipismagic/SpiROSE/docs/mechanical_design/Moteur.SLDASM

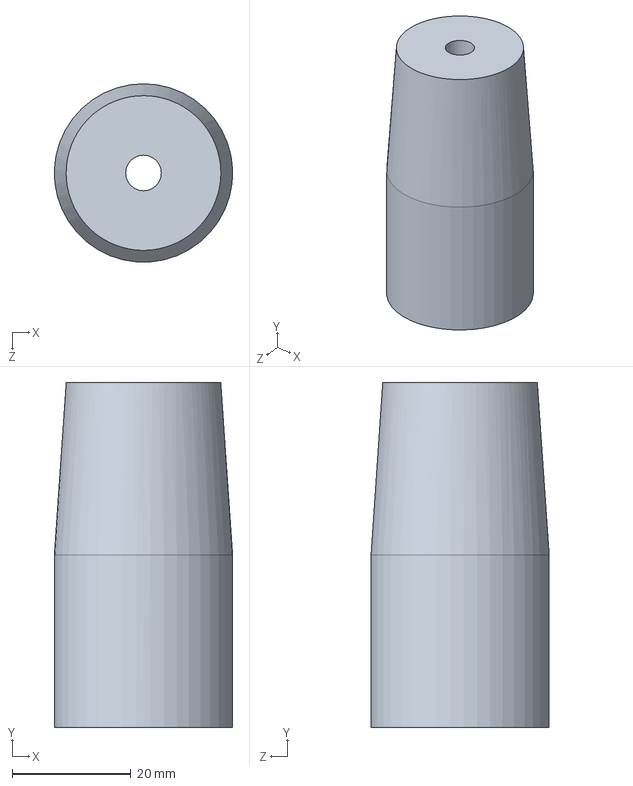
[picture p13: CAD file, 2017-11-16]
docs/mechanical_design/Moteur.SLDASM
30.0 x 58.0 x 30.0 mm
