friendshipismagic/SpiROSE/docs/mechanical_design/Moteur/Moteur.SLDASM

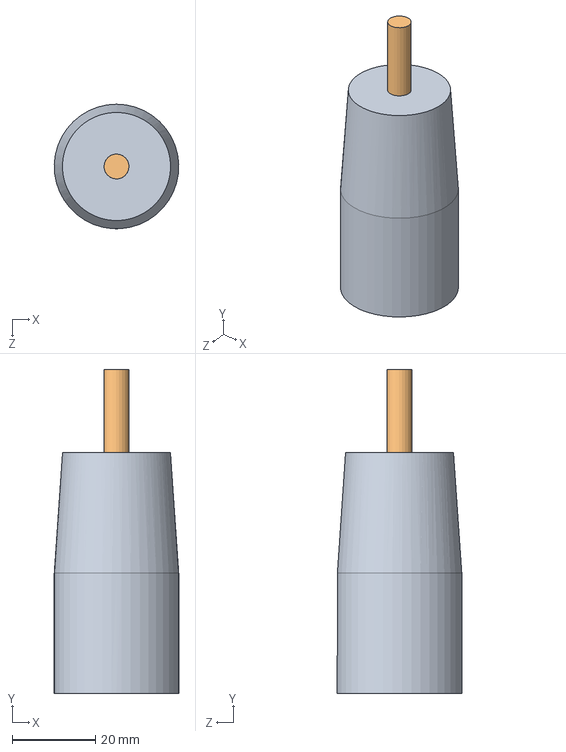
[picture p14: CAD file, 2017-11-14]
docs/mechanical_design/Moteur/Moteur.SLDASM
30.0 x 78.0 x 30.0 mm
Carter
Axe moteur
