friendshipismagic/SpiROSE/docs/mechanical_design/626-2RS/l1-626-2rsh_08.SLDPRT

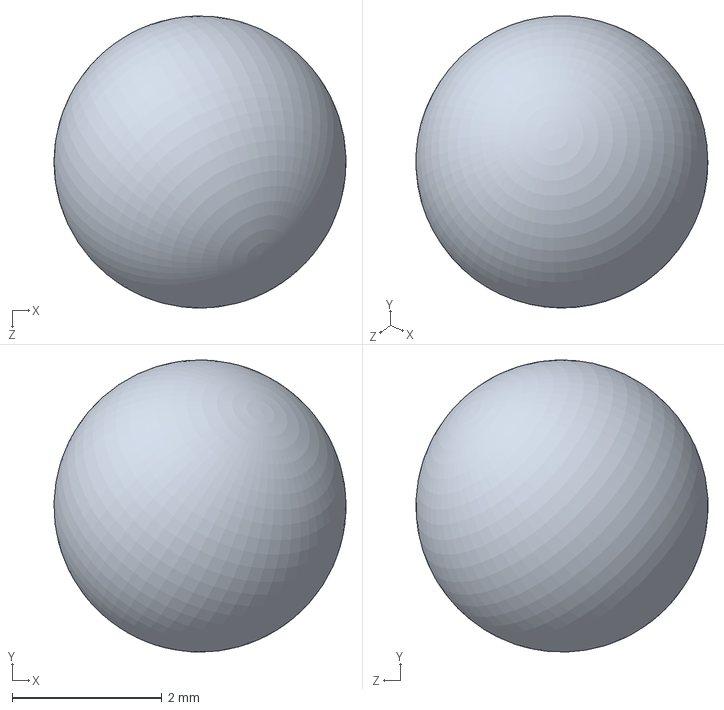
[picture p15: CAD file, 2017-11-14]
docs/mechanical_design/626-2RS/l1-626-2rsh_08.SLDPRT
3.90 x 3.90 x 3.90 mm
