friendshipismagic/SpiROSE/docs/mechanical_design/Moteur/Axe moteur.SLDPRT

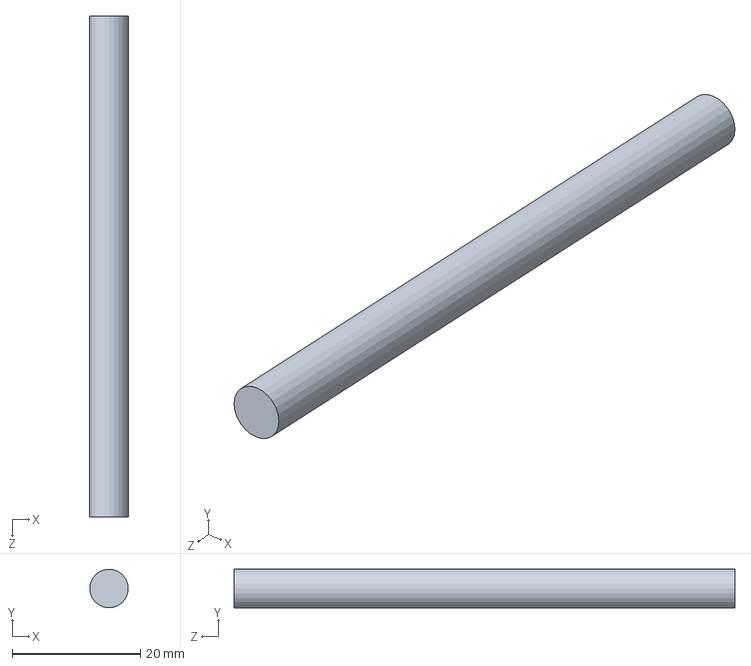
[picture p16: CAD file, 2017-11-14]
docs/mechanical_design/Moteur/Axe moteur.SLDPRT
6.00 x 6.00 x 78.0 mm
