friendshipismagic/SpiROSE/tools/framer/tests/monkey.obj

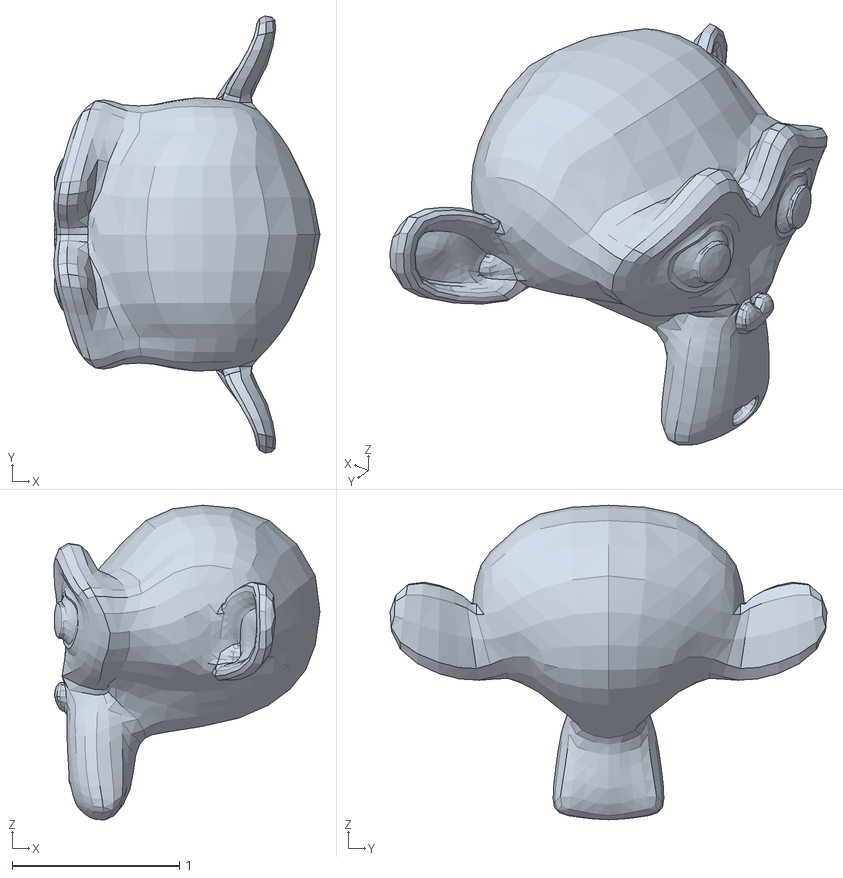
[picture p17: CAD file, 2018-01-24]
tools/framer/tests/monkey.obj
1.59 x 2.62 x 1.88
