friendshipismagic/SpiROSE/tools/renderer/mesh/text.obj

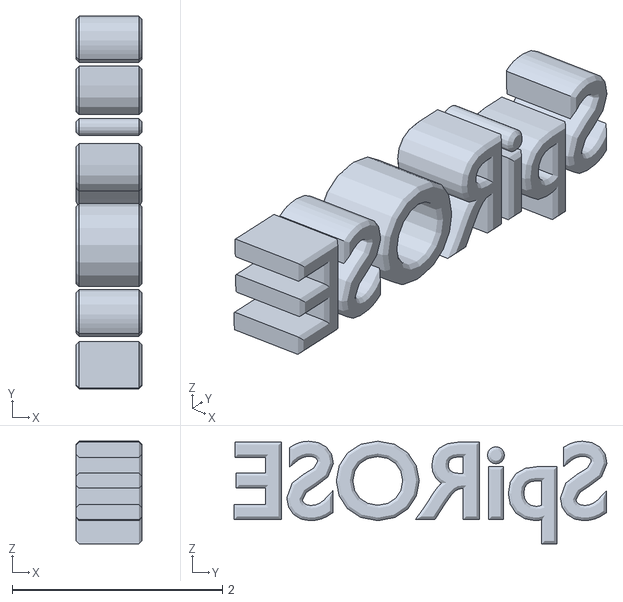
[picture p18: CAD file, 2018-01-11]
tools/renderer/mesh/text.obj
0.624 x 3.55 x 0.977
