friendshipismagic/SpiROSE/docs/mechanical_design/Bras haut.SLDPRT

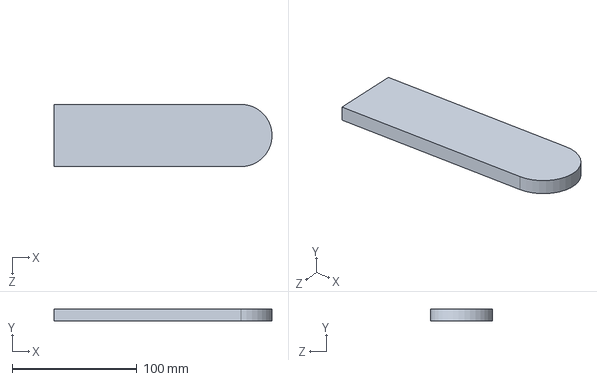
[picture p19: CAD file, 2017-11-16]
docs/mechanical_design/Bras haut.SLDPRT
174.9 x 10.0 x 50.0 mm
