friendshipismagic/SpiROSE/docs/mechanical_design/Moteur/Fixation 2.SLDPRT

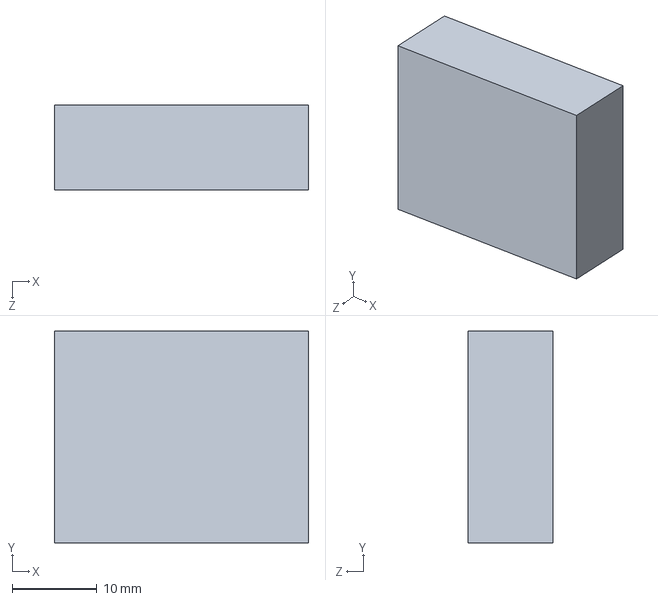
[picture p20: CAD file, 2017-11-14]
docs/mechanical_design/Moteur/Fixation 2.SLDPRT
30.0 x 25.0 x 10.0 mm
