friendshipismagic/SpiROSE/tools/framer/tests/monkey-colorized.obj

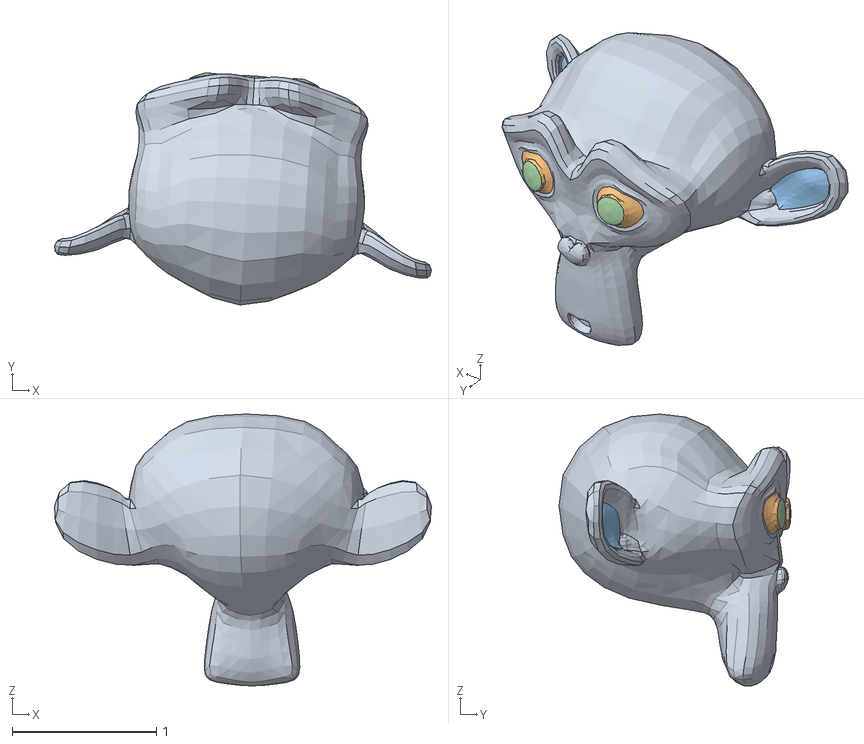
[picture p21: CAD file, 2018-01-24]
tools/framer/tests/monkey-colorized.obj
2.61 x 1.61 x 1.88
Suzanne-skull_Suzanne.001
Suzanne-eyes_Suzanne.001
Suzanne-ears_Suzanne.001
Suzanne-pupils_Suzanne.001
