friendshipismagic/SpiROSE/tools/renderer/mesh/suzanne.obj

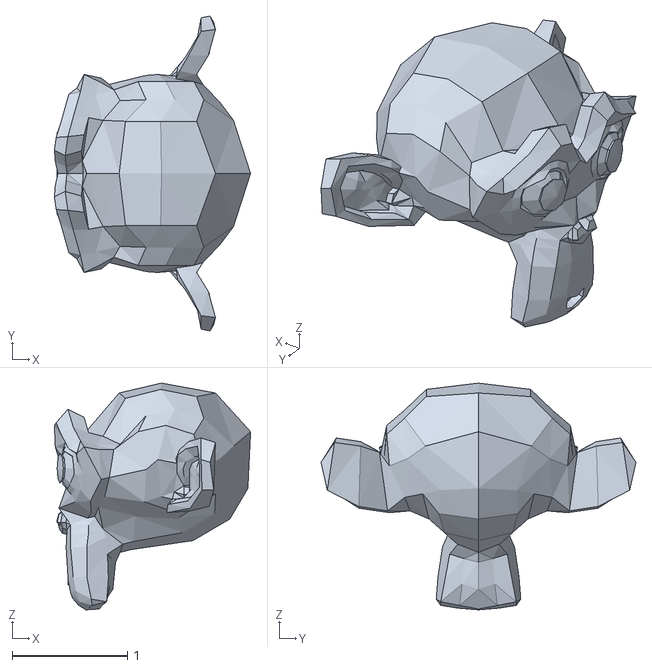
[picture p22: CAD file, 2017-12-14]
tools/renderer/mesh/suzanne.obj
1.70 x 2.73 x 1.97
