friendshipismagic/SpiROSE/docs/mechanical_design/Fixation dessous.SLDPRT

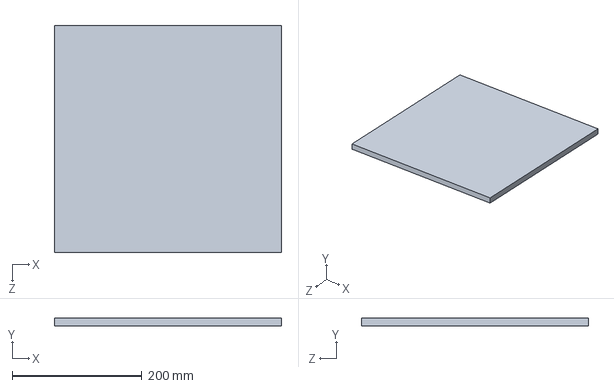
[picture p23: CAD file, 2017-11-16]
docs/mechanical_design/Fixation dessous.SLDPRT
350.0 x 12.0 x 350.0 mm
