friendshipismagic/SpiROSE/tools/renderer/mesh/suzanne-tight.obj

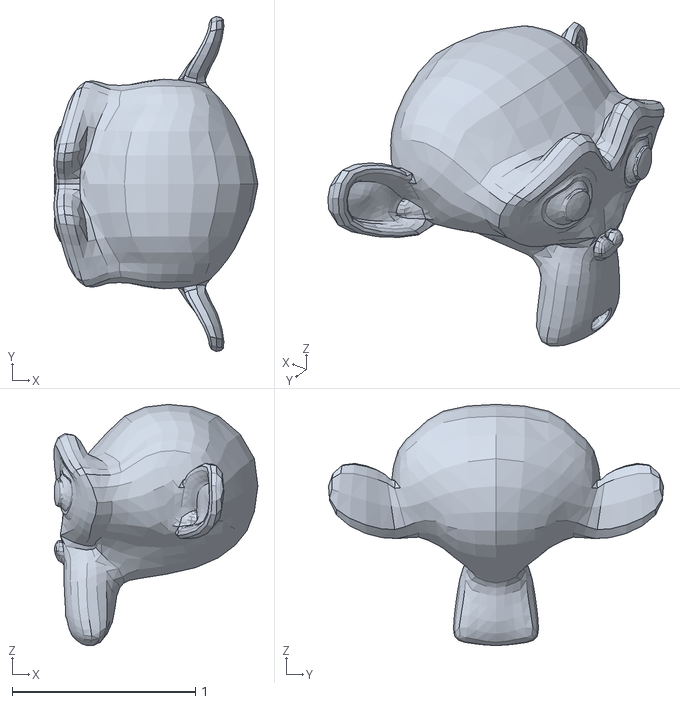
[picture p24: CAD file, 2017-12-14]
tools/renderer/mesh/suzanne-tight.obj
1.11 x 1.83 x 1.31
