friendshipismagic/SpiROSE/docs/mechanical_design/626-2RS/l1-626-2rsh_03.SLDPRT

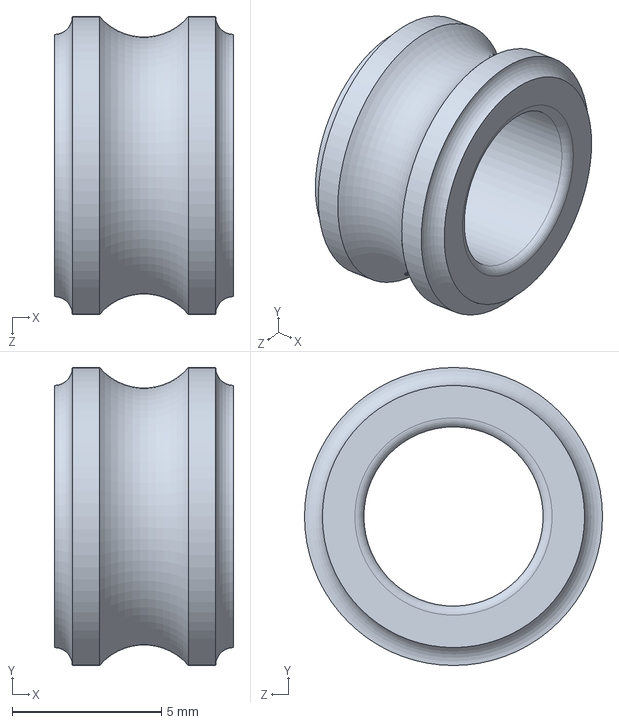
[picture p25: CAD file, 2017-11-14]
docs/mechanical_design/626-2RS/l1-626-2rsh_03.SLDPRT
6.00 x 9.98 x 9.98 mm
