friendshipismagic/SpiROSE/tools/renderer/mesh/sphere.obj

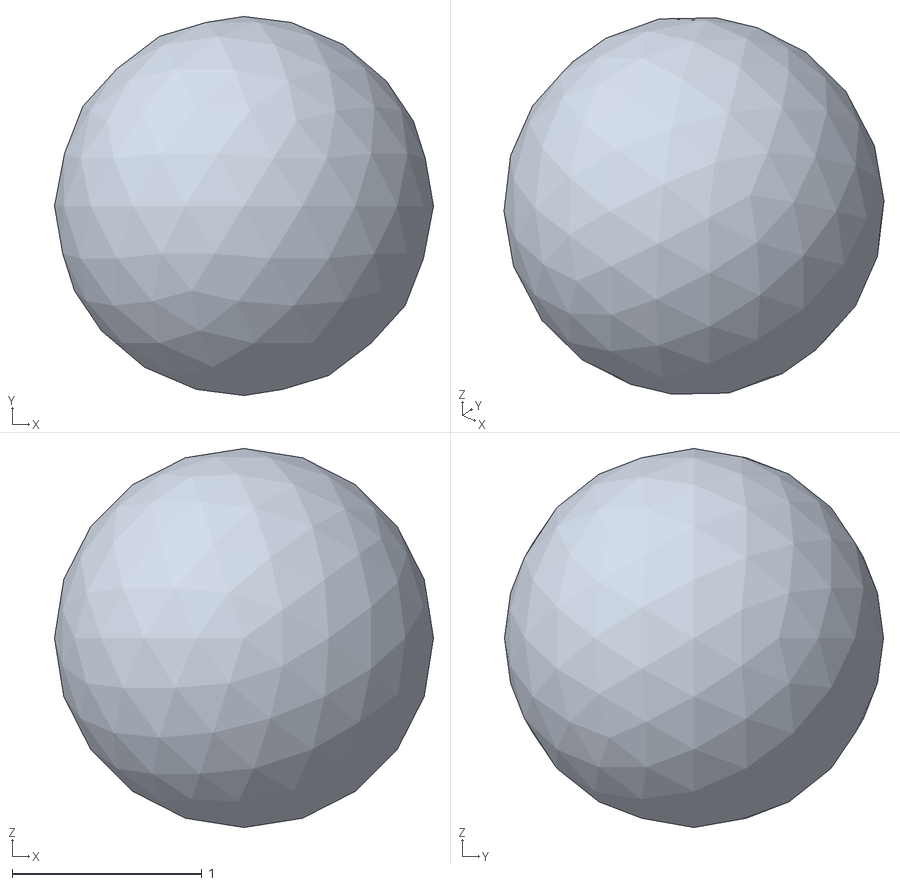
[picture p26: CAD file, 2017-12-14]
tools/renderer/mesh/sphere.obj
2.00 x 2.00 x 2.00
