friendshipismagic/SpiROSE/docs/mechanical_design/Moteur/Fixation.SLDPRT

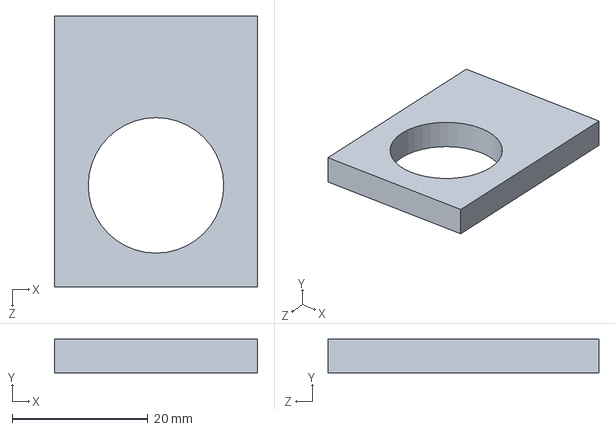
[picture p27: CAD file, 2017-11-14]
docs/mechanical_design/Moteur/Fixation.SLDPRT
30.0 x 5.00 x 40.0 mm
