friendshipismagic/SpiROSE/docs/mechanical_design/626-2RS/l1-626-2rsh_11.SLDPRT

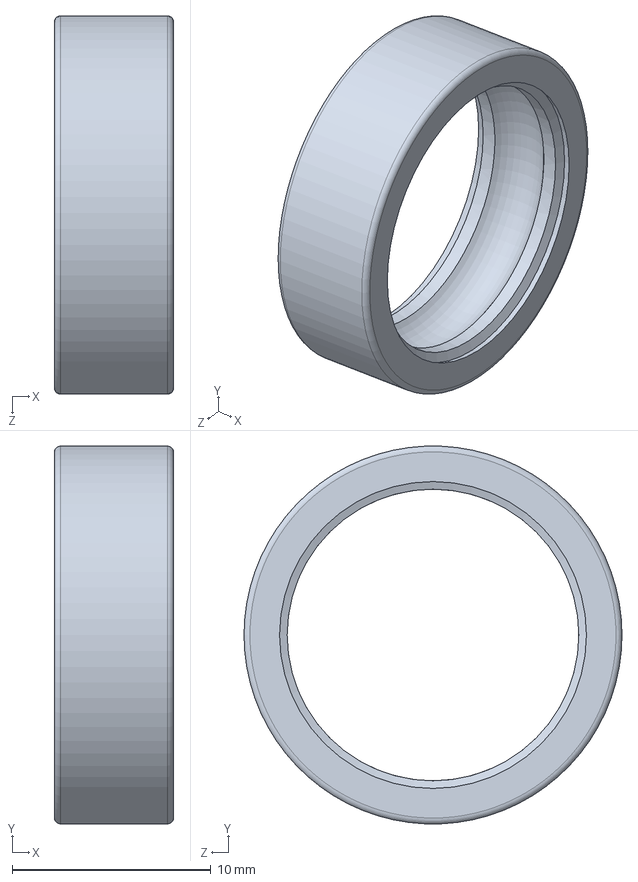
[picture p28: CAD file, 2017-11-14]
docs/mechanical_design/626-2RS/l1-626-2rsh_11.SLDPRT
6.00 x 19.0 x 19.0 mm
