friendshipismagic/SpiROSE/docs/mechanical_design/Embase bas.SLDPRT

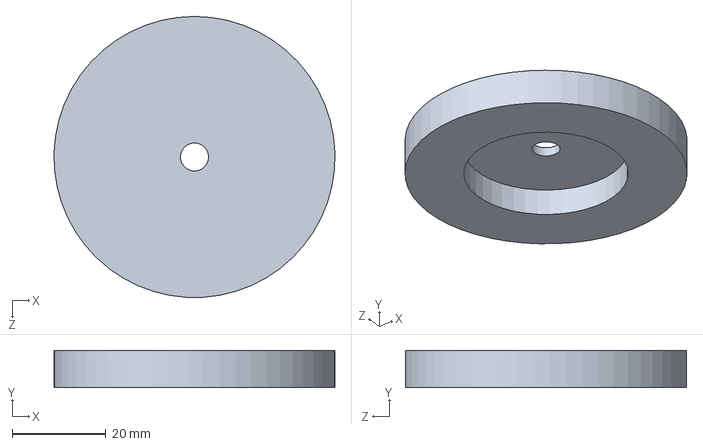
[picture p29: CAD file, 2017-11-16]
docs/mechanical_design/Embase bas.SLDPRT
60.0 x 8.00 x 60.0 mm
