friendshipismagic/SpiROSE/docs/mechanical_design/626-2RS/l1-626-2rsh_01.SLDPRT

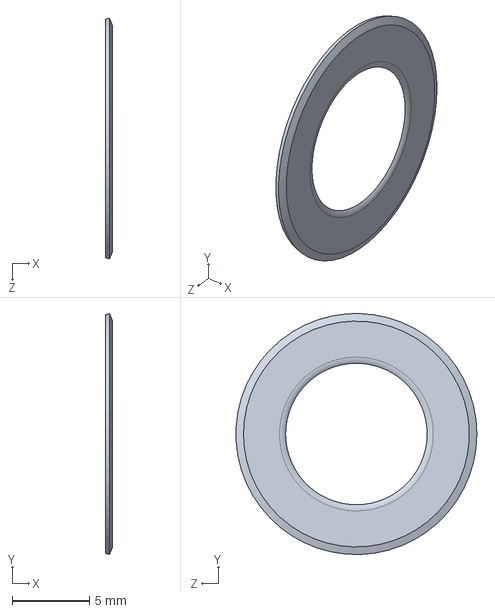
[picture p30: CAD file, 2017-11-14]
docs/mechanical_design/626-2RS/l1-626-2rsh_01.SLDPRT
0.48 x 15.6 x 15.6 mm
