friendshipismagic/SpiROSE/docs/mechanical_design/Bras coté.SLDPRT

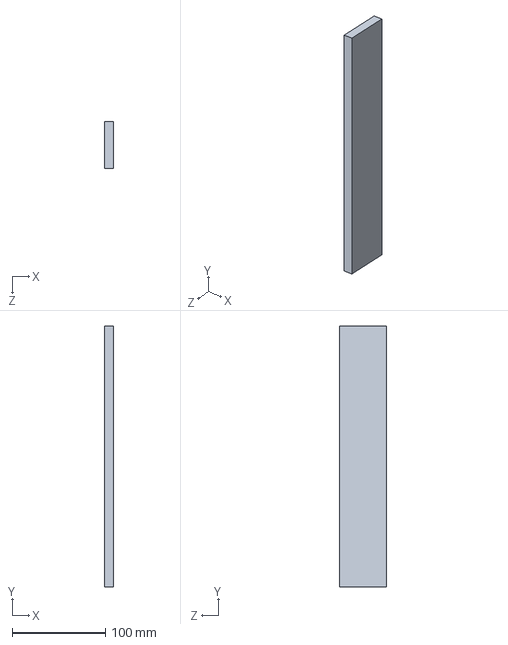
[picture p31: CAD file, 2017-11-16]
docs/mechanical_design/Bras coté.SLDPRT
10.0 x 280.0 x 50.0 mm
