friendshipismagic/SpiROSE/docs/mechanical_design/Support PCB.SLDPRT

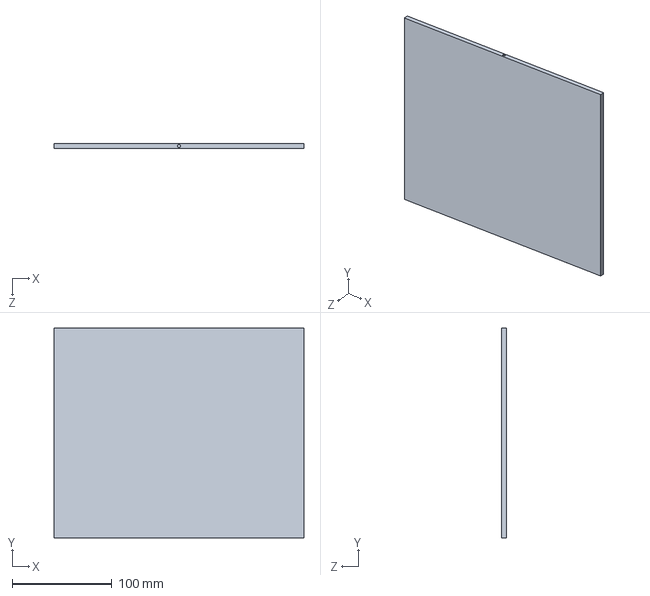
[picture p32: CAD file, 2017-11-14]
docs/mechanical_design/Support PCB.SLDPRT
250.0 x 210.0 x 5.00 mm
