friendshipismagic/SpiROSE/docs/mechanical_design/Reducteur Planetaire.SLDPRT

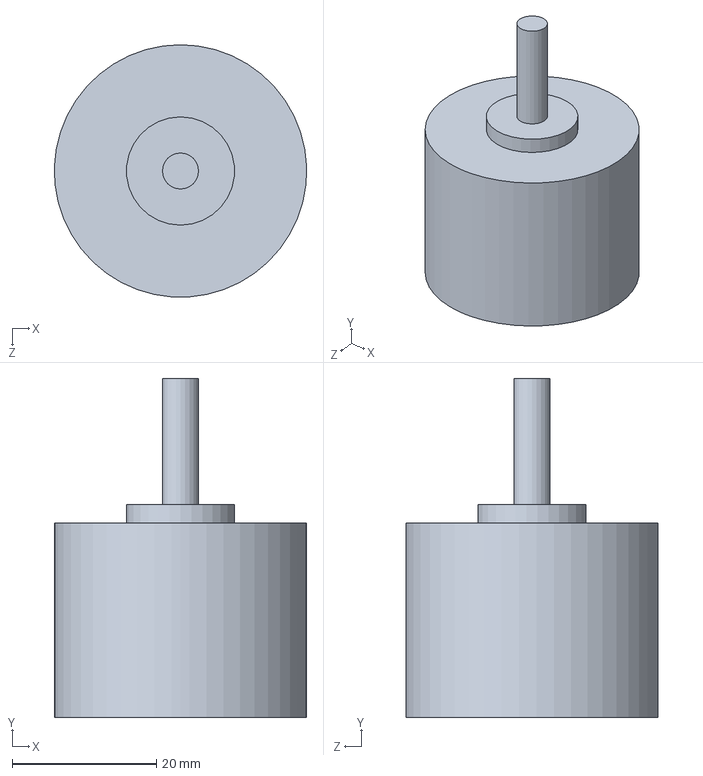
[picture p33: CAD file, 2017-11-14]
docs/mechanical_design/Reducteur Planetaire.SLDPRT
35.0 x 47.0 x 35.0 mm
