friendshipismagic/SpiROSE/docs/mechanical_design/Embase haut.SLDPRT

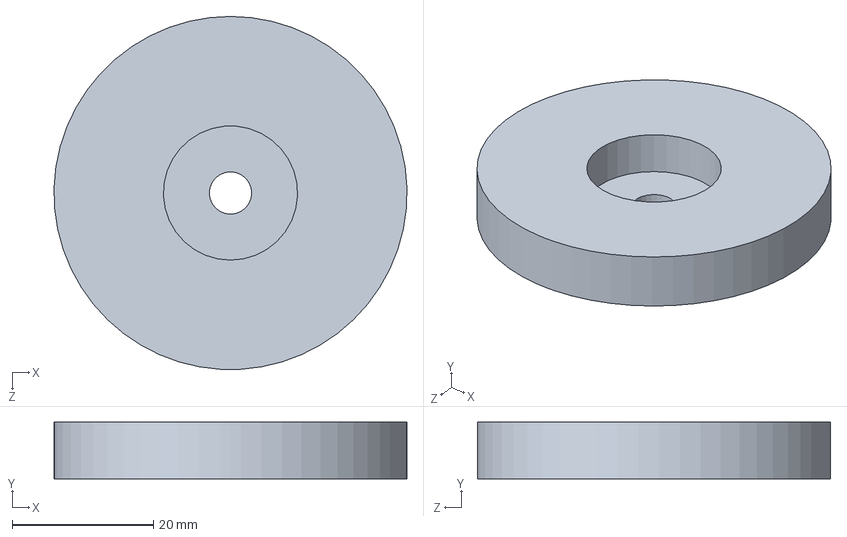
[picture p34: CAD file, 2017-11-14]
docs/mechanical_design/Embase haut.SLDPRT
50.0 x 8.00 x 50.0 mm
