friendshipismagic/SpiROSE/docs/mechanical_design/Moyeu.SLDPRT

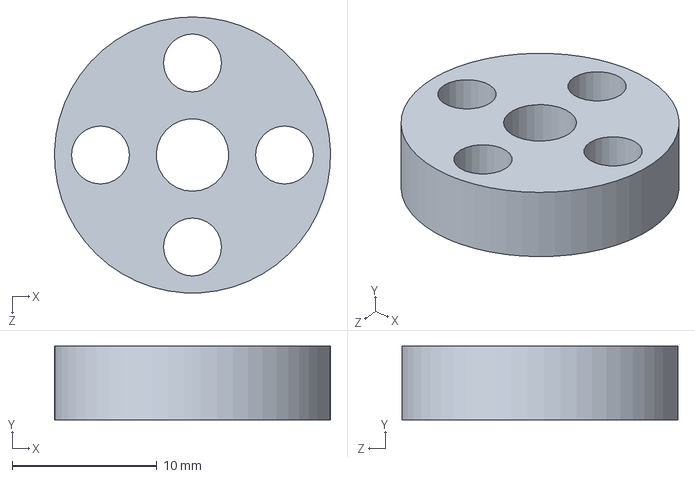
[picture p35: CAD file, 2017-11-14]
docs/mechanical_design/Moyeu.SLDPRT
19.0 x 5.08 x 19.1 mm
