friendshipismagic/SpiROSE/docs/mechanical_design/PCB rotatif.SLDPRT

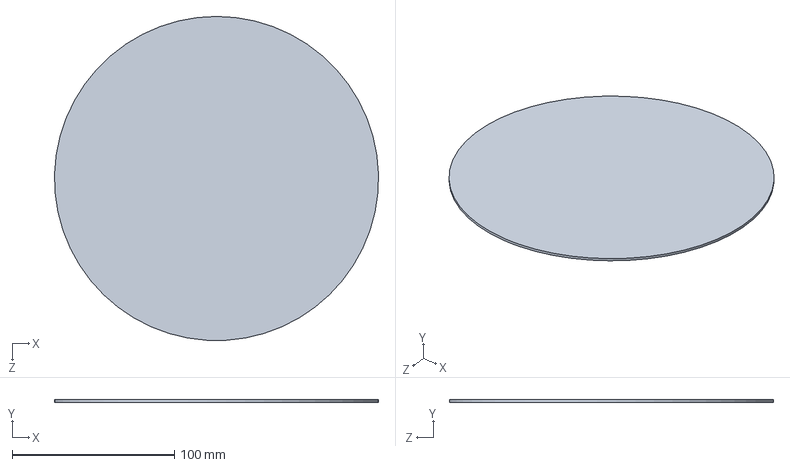
[picture p36: CAD file, 2017-11-14]
docs/mechanical_design/PCB rotatif.SLDPRT
199.9 x 1.55 x 200.0 mm
