friendshipismagic/SpiROSE/docs/mechanical_design/Carter.SLDPRT

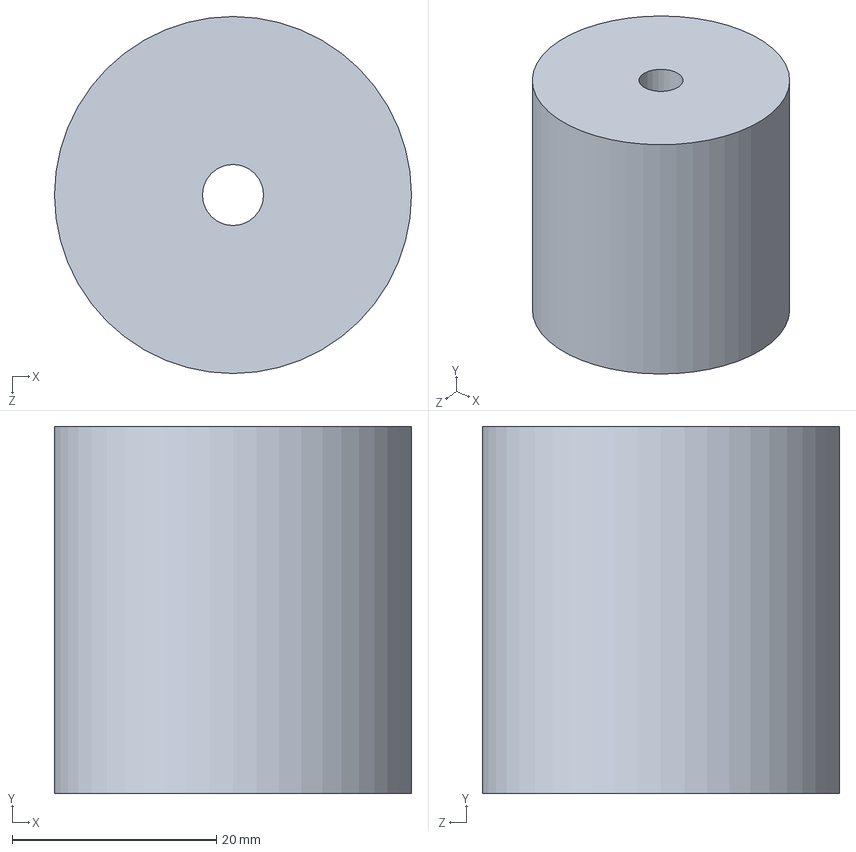
[picture p37: CAD file, 2017-11-14]
docs/mechanical_design/Carter.SLDPRT
35.0 x 36.0 x 35.0 mm
