friendshipismagic/SpiROSE/docs/mechanical_design/Axe.SLDPRT

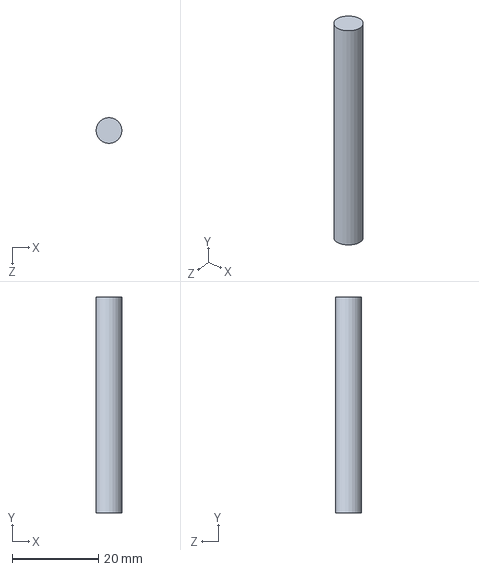
[picture p38: CAD file, 2017-11-14]
docs/mechanical_design/Axe.SLDPRT
6.00 x 50.0 x 6.00 mm
