friendshipismagic/SpiROSE/docs/mechanical_design/PCB Haut.SLDPRT

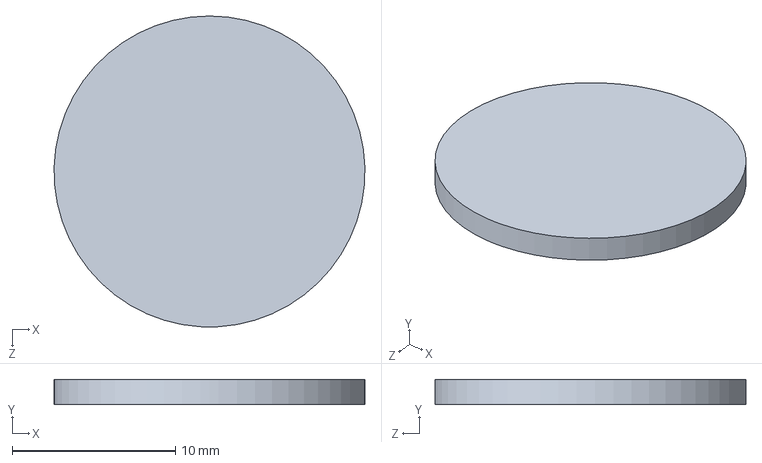
[picture p39: CAD file, 2017-11-14]
docs/mechanical_design/PCB Haut.SLDPRT
19.0 x 1.55 x 19.1 mm
