friendshipismagic/SpiROSE/docs/mechanical_design/Pied.SLDPRT

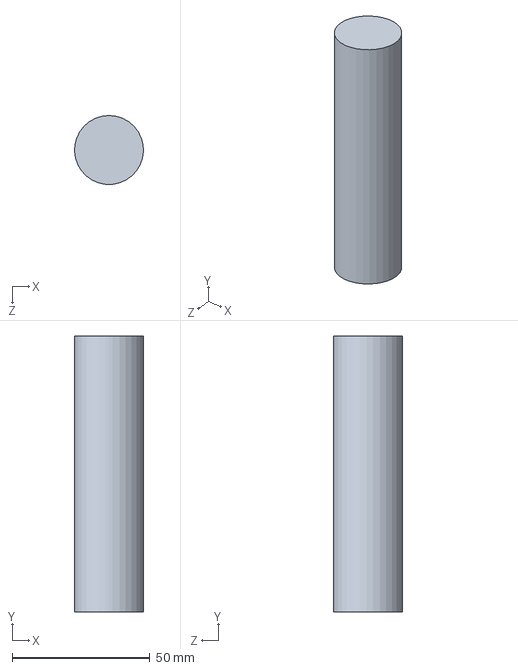
[picture p40: CAD file, 2017-11-14]
docs/mechanical_design/Pied.SLDPRT
25.0 x 100.0 x 25.0 mm
