friendshipismagic/SpiROSE/(list of files, cad)

Other CAD files:
docs/mechanical_design/626-2RS/l1-626-2rsh_07.SLDPRT
docs/mechanical_design/Moteur/Carter.SLDPRT
docs/mechanical_design/626-2RS/l1-626-2rsh_05.SLDPRT
docs/mechanical_design/Fixation dessus.SLDPRT
docs/mechanical_design/626-2RS/l1-626-2rsh_09.SLDPRT
docs/mechanical_design/626-2RS/l1-626-2rsh_06.SLDPRT
docs/mechanical_design/626-2RS/l1-626-2rsh_12.SLDPRT
docs/mechanical_design/626-2RS/l1-626-2rsh_02.SLDPRT
docs/mechanical_design/626-2RS/l1-626-2rsh_10.SLDPRT
docs/mechanical_design/626-2RS/l1-626-2rsh_04.SLDPRT
docs/mechanical_design/Axe moteur.SLDPRT
docs/mechanical_design/SpiROSE.SLDDRW
