friendshipismagic/SpiROSE/PCB/LED_Panel/Assembly/Assembly_Fiducials.pdf

PCB

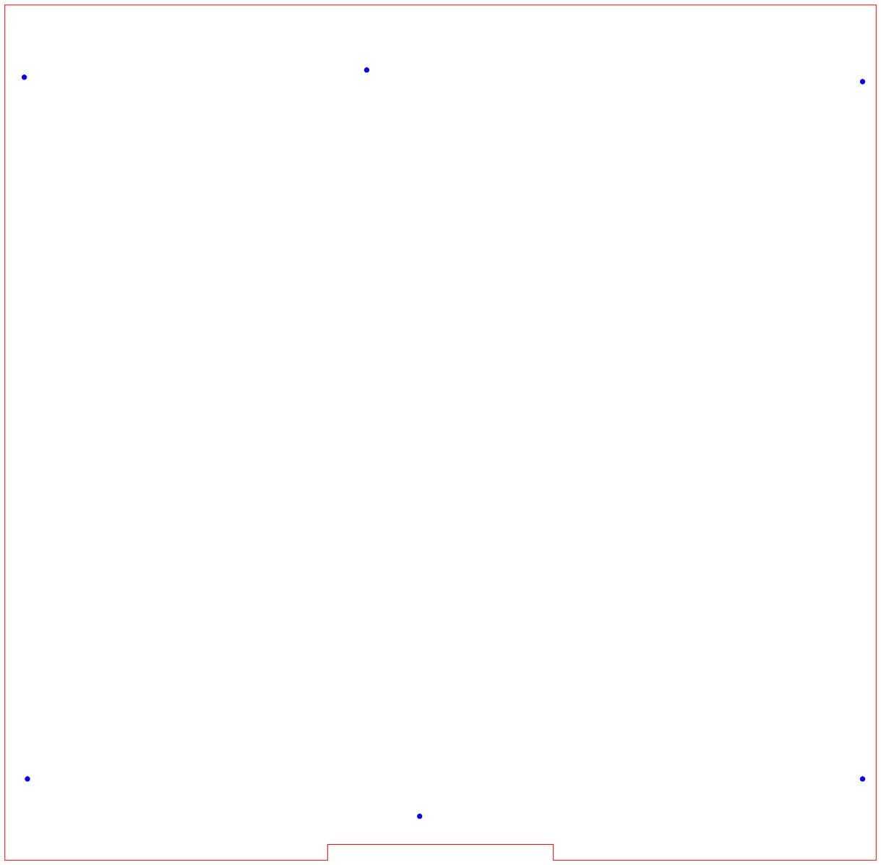
[picture p41: figure]

Fiducials_top | footbar

PCB

Fiducials_bottom | footbar
