friendshipismagic/SpiROSE/PCB/Rotative_base/Assembly/Assembly_Fiducials.pdf

PCB

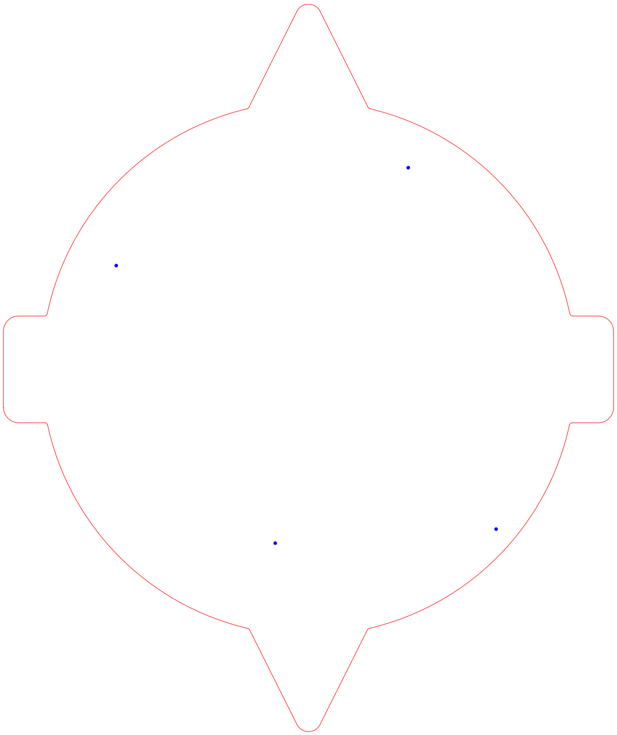
[picture p42: figure]

Fiducials_top | footbar

PCB

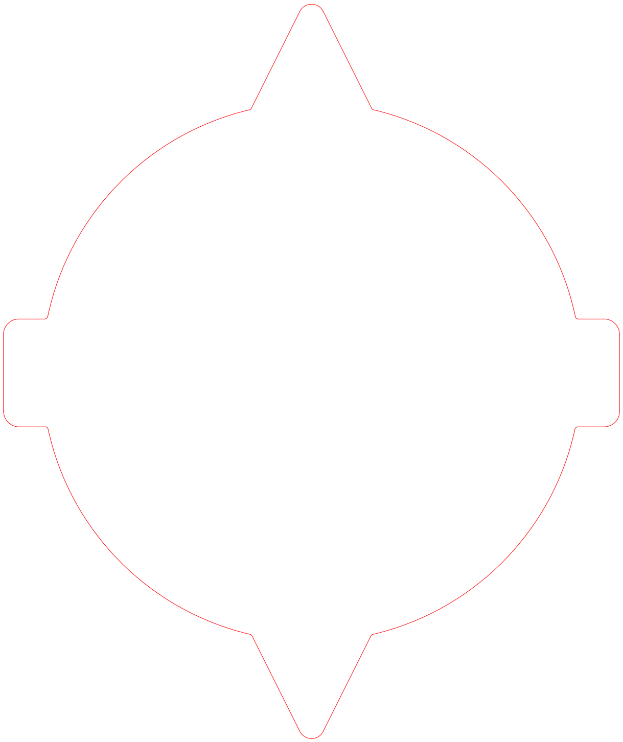
[picture p43: figure]

Fiducials_bottom | footbar
