friendshipismagic/SpiROSE/PCB/misc/pcb-test-driver/gerber/led-test.TXT

%
M48
M72
T01C0.0138
T02C0.0400
%
T01
X9155Y8269
X9549Y8860
X10041Y10533
X11222Y10533
X11222Y12305
X10041Y12305
X10041Y14076
X11222Y14076
X11222Y15848
X10041Y15848
X10041Y17620
X11222Y17620
X11222Y19391
X10041Y19391
X10041Y21163
X11222Y21163
X14962Y20474
X14962Y22246
X14962Y24017
X14962Y18506
X14864Y16931
X14864Y15061
X14864Y13289
X14962Y11517
T02
X6990Y4120
X8269Y4120
X8269Y5120
X8269Y6120
X6990Y6120
X6990Y5120
X9549Y5120
X9549Y6120
X10828Y6120
X10828Y5120
X12108Y5120
X12108Y6120
X13387Y6120
X13387Y5120
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
