friendshipismagic/SpiROSE/SBC/libSpiROSE/tests/cube-ref.png

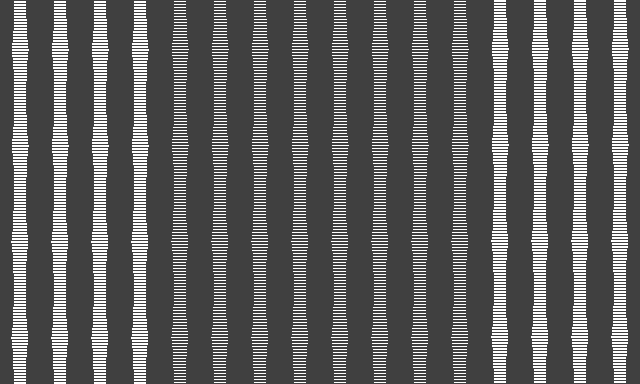
SBC/libSpiROSE/tests/cube-ref.png
