friendshipismagic/SpiROSE/SBC/libSpiROSE/tests/cube_dual-ref.png

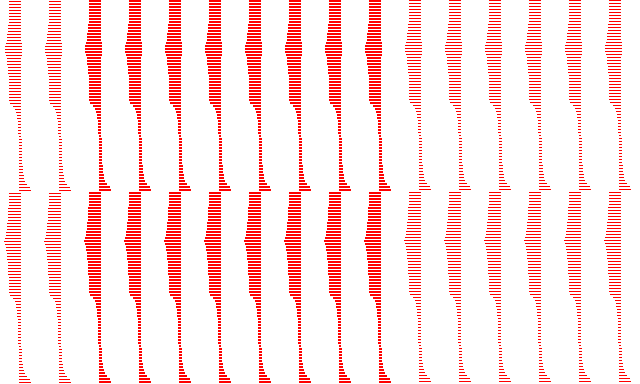
SBC/libSpiROSE/tests/cube_dual-ref.png
