friendshipismagic/SpiROSE/SBC/libSpiROSE/tests/cube_dual_view-ref.png

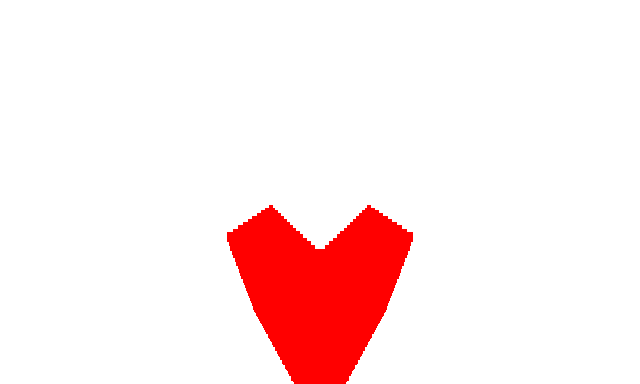
SBC/libSpiROSE/tests/cube_dual_view-ref.png
