friendshipismagic/SpiROSE/SBC/libSpiROSE/tests/cube_view-ref.png

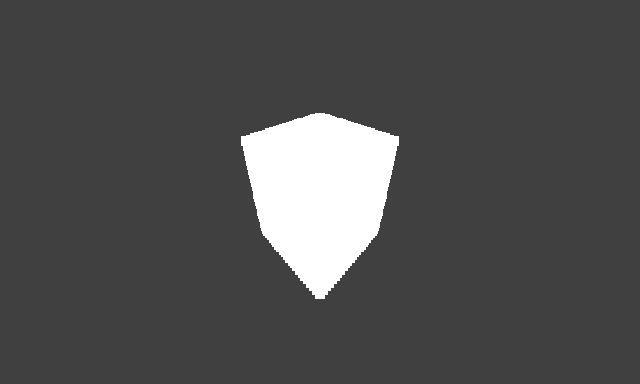
SBC/libSpiROSE/tests/cube_view-ref.png
