friendshipismagic/SpiROSE/SBC/libSpiROSE/tests/linear-ref.png

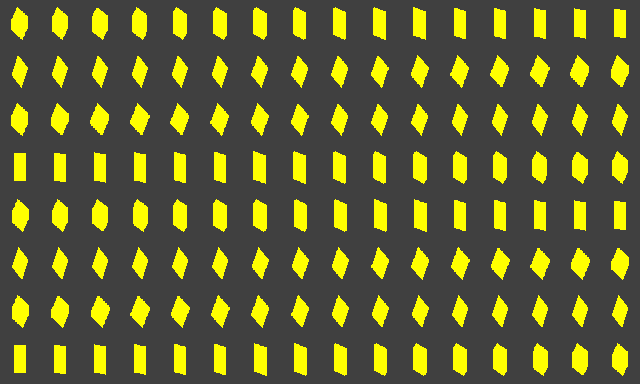
SBC/libSpiROSE/tests/linear-ref.png
