friendshipismagic/SpiROSE/tools/framer/tests/monkey-colorized.synth-ref.png

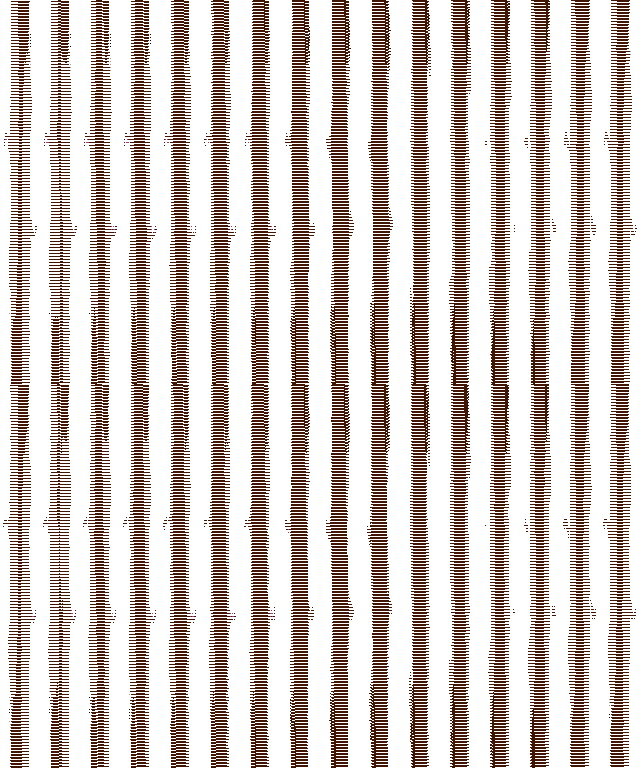
tools/framer/tests/monkey-colorized.synth-ref.png
