friendshipismagic/SpiROSE/tools/framer/tests/monkey-colorized.view-ref.png

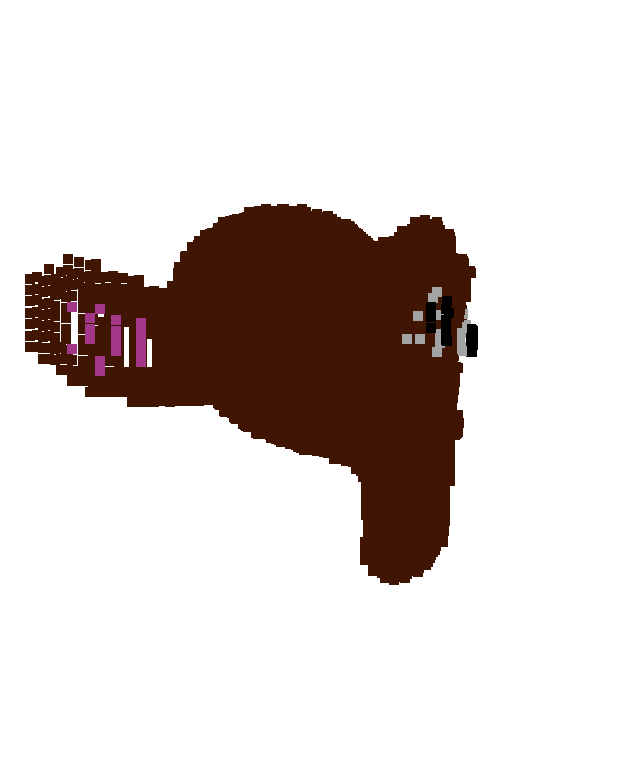
tools/framer/tests/monkey-colorized.view-ref.png
