friendshipismagic/SpiROSE/tools/framer/tests/monkey.synth-ref.png

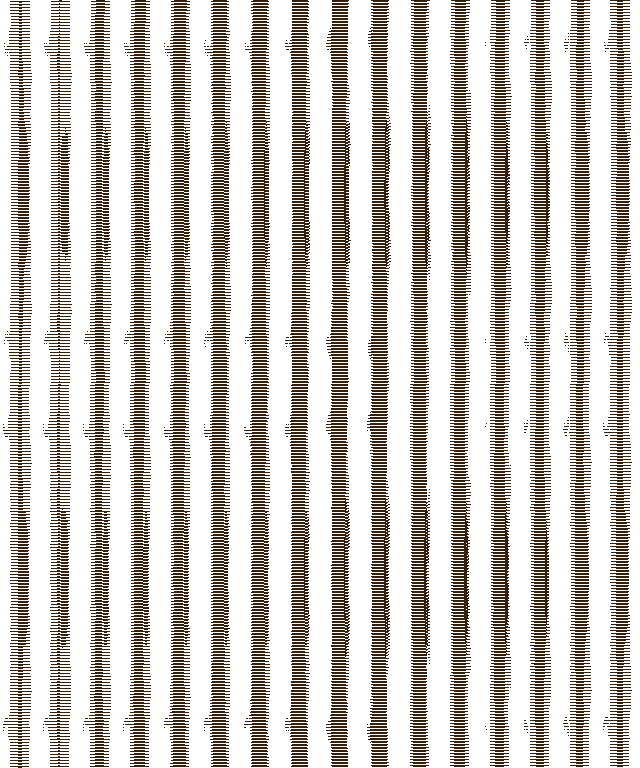
tools/framer/tests/monkey.synth-ref.png
