friendshipismagic/SpiROSE/tools/framer/tests/monkey.view-ref.png

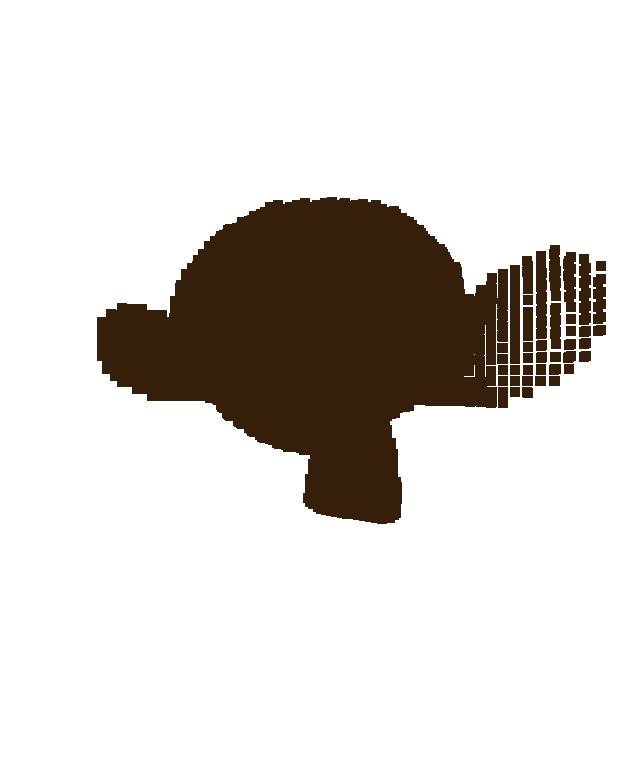
tools/framer/tests/monkey.view-ref.png
