friendshipismagic/SpiROSE/tools/renderer/tests/sphere_reference.png

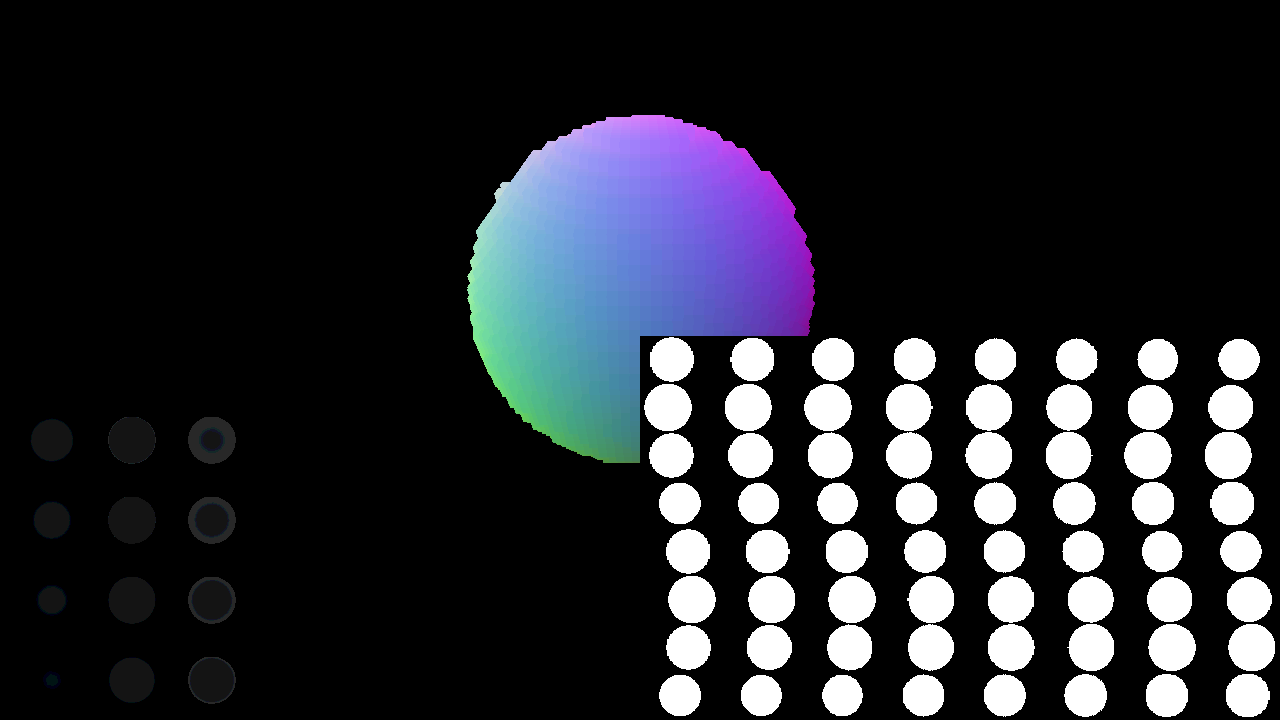
tools/renderer/tests/sphere_reference.png
