friendshipismagic/SpiROSE/tools/renderer/tests/text_t0_ref.png

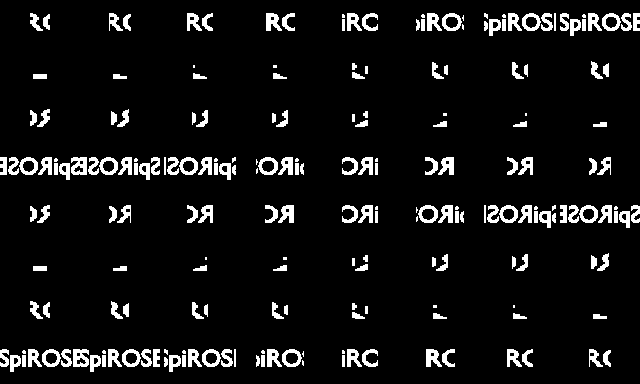
tools/renderer/tests/text_t0_ref.png
