friendshipismagic/SpiROSE/tools/renderer/tests/text_t5_ref.png

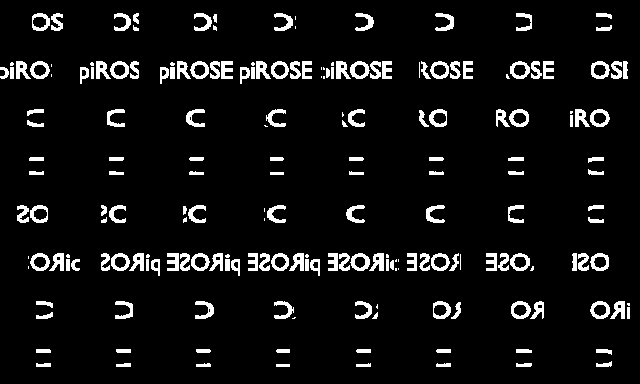
tools/renderer/tests/text_t5_ref.png
