friendshipismagic/SpiROSE/PCB/LED_Panel/LogFiles/EPDebug.txt

# EP - Embedded Passives operations log
# Tuesday, January 16, 2018, 03:00:21 PM,
