friendshipismagic/SpiROSE/PCB/LED_Panel/Schematic.pdf

+3.3V

### LRTBR48G

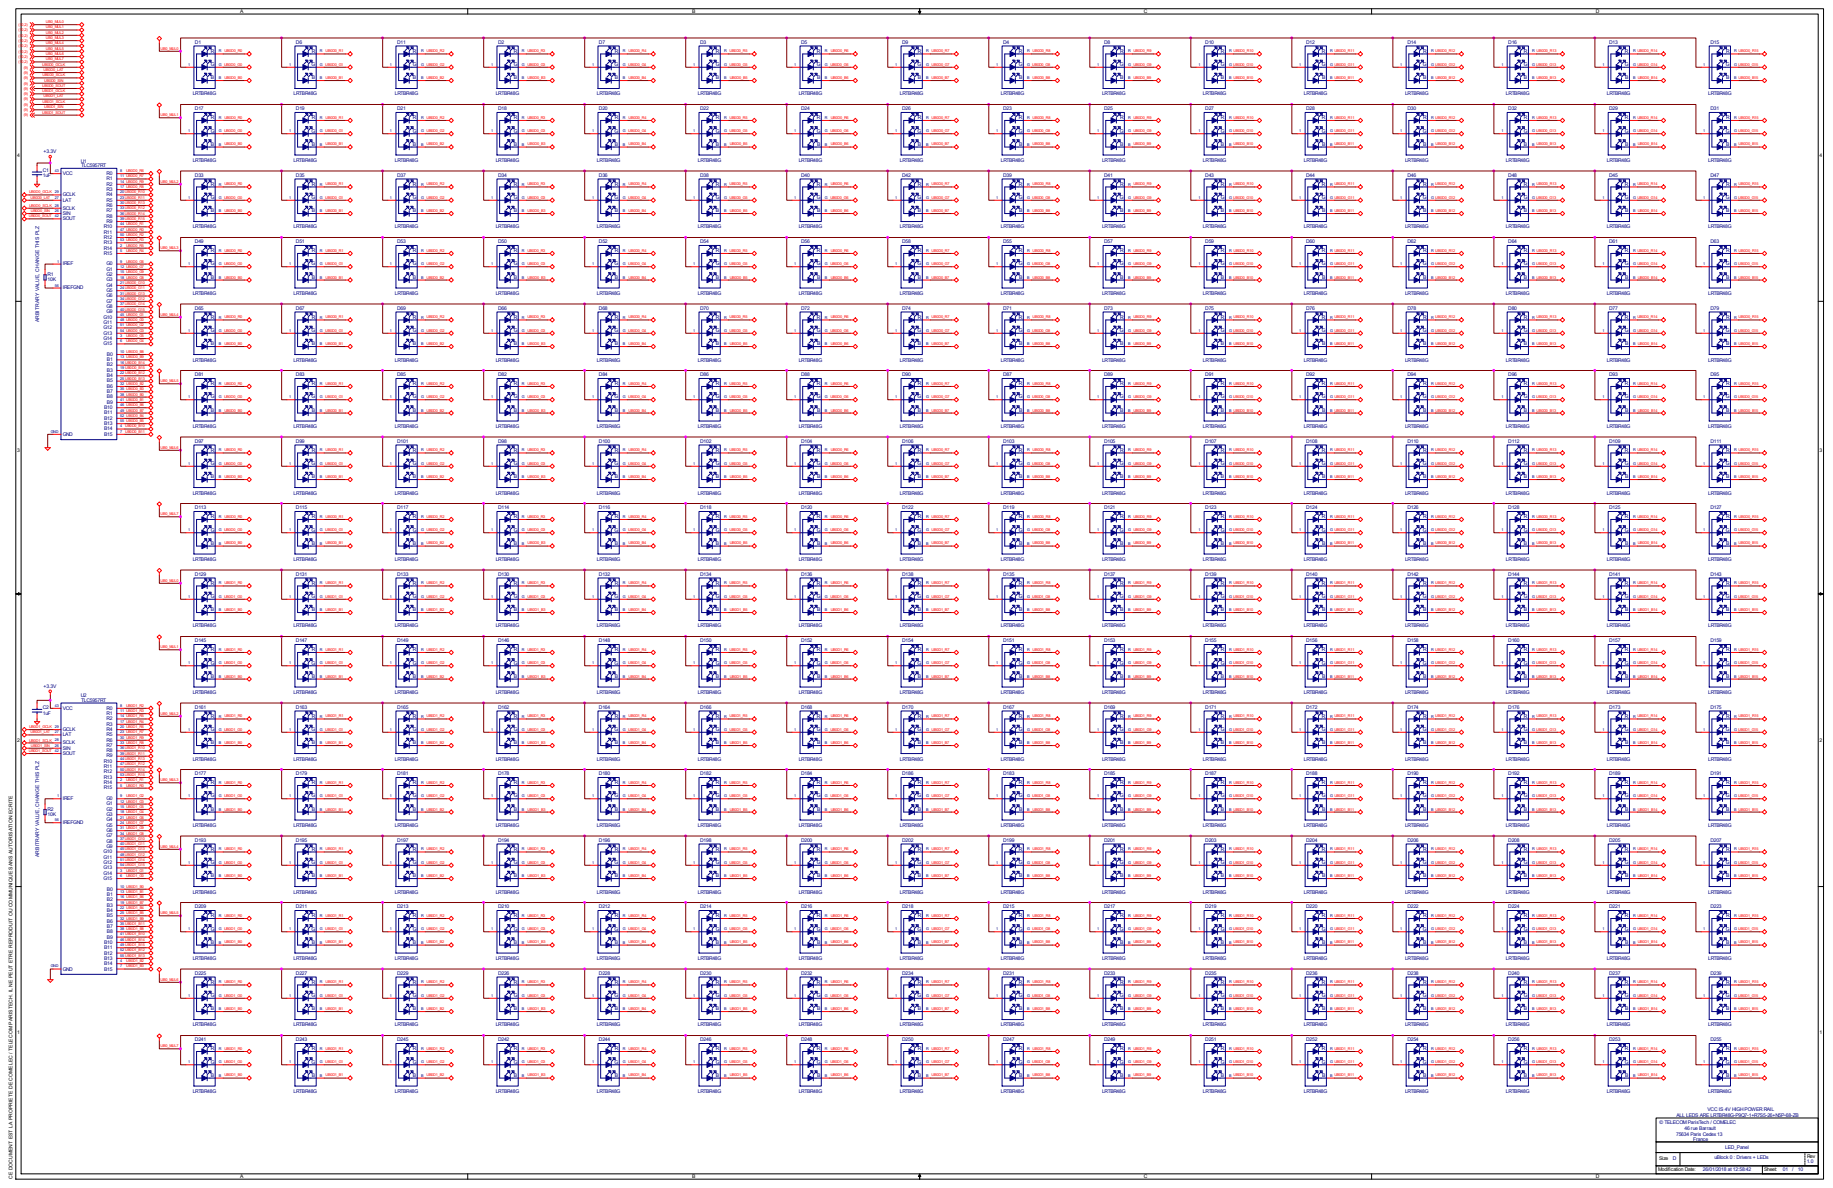
[picture p56: page 1]

ALL LEDS ARE LRTBR48G-P9Q7-1+R7S5-26+N5P-68-ZB
© TELECOM ParisTech / COMELEC

VCC IS 4V HIGH POWER RAIL

A | B | C | D

+3.3V

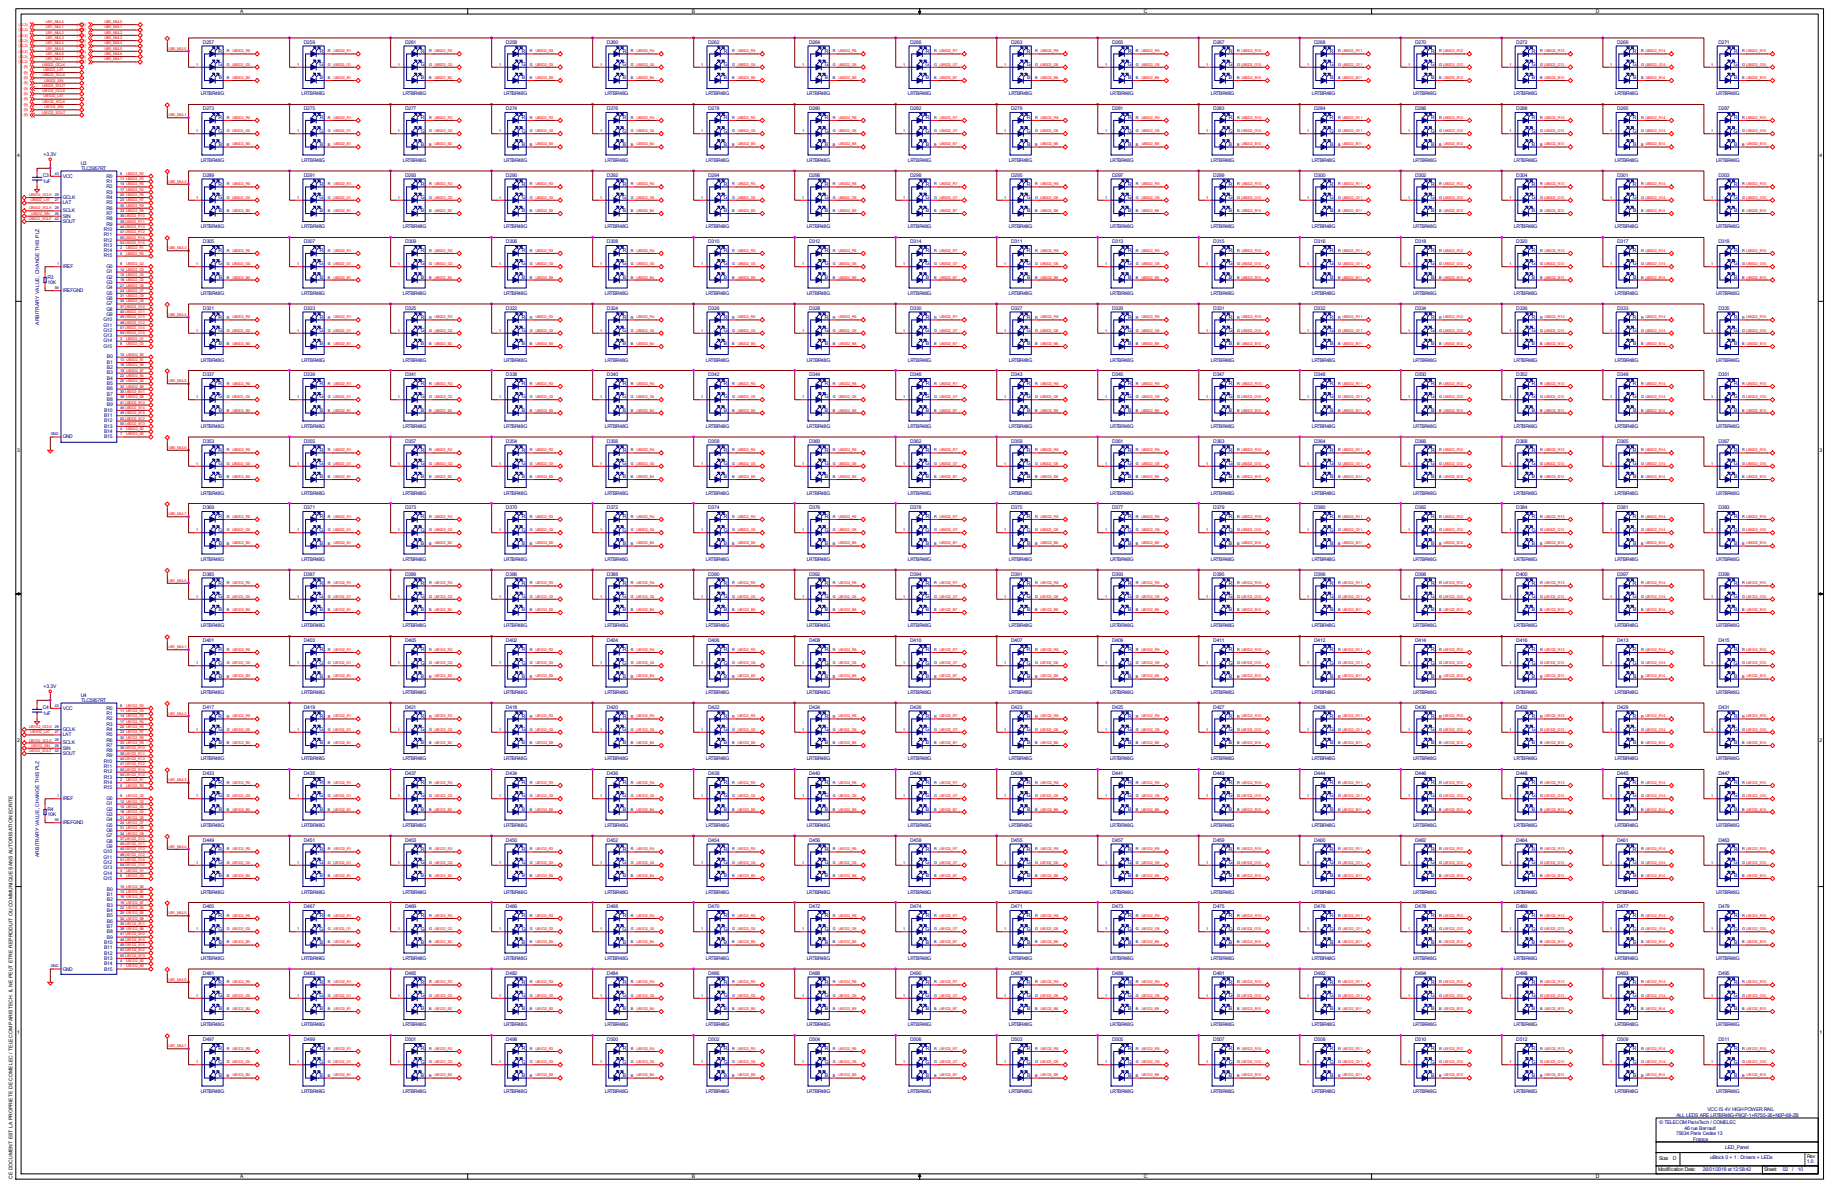
[picture p57: page 2]

A | B | C | D

+3.3V

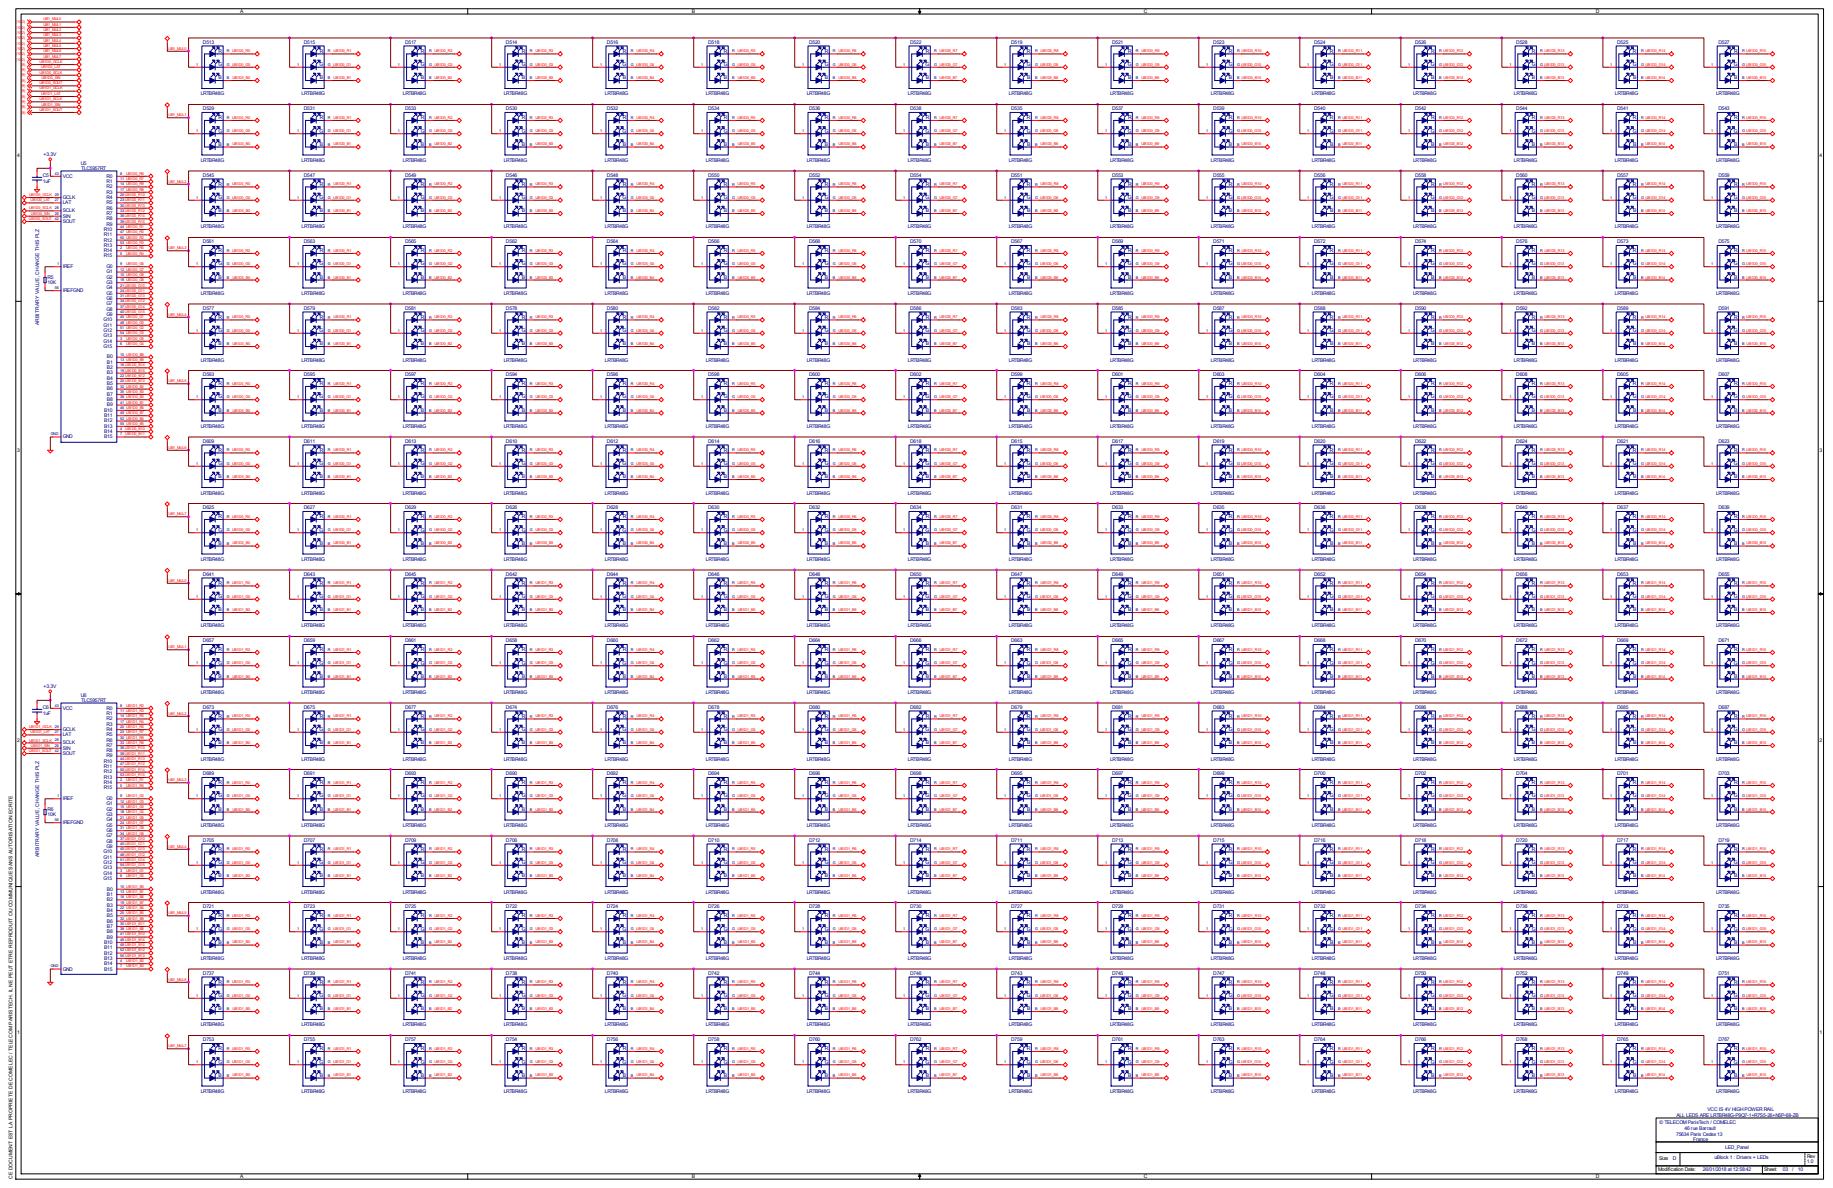
[picture p58: page 3]

A | B | C | D

+3.3V

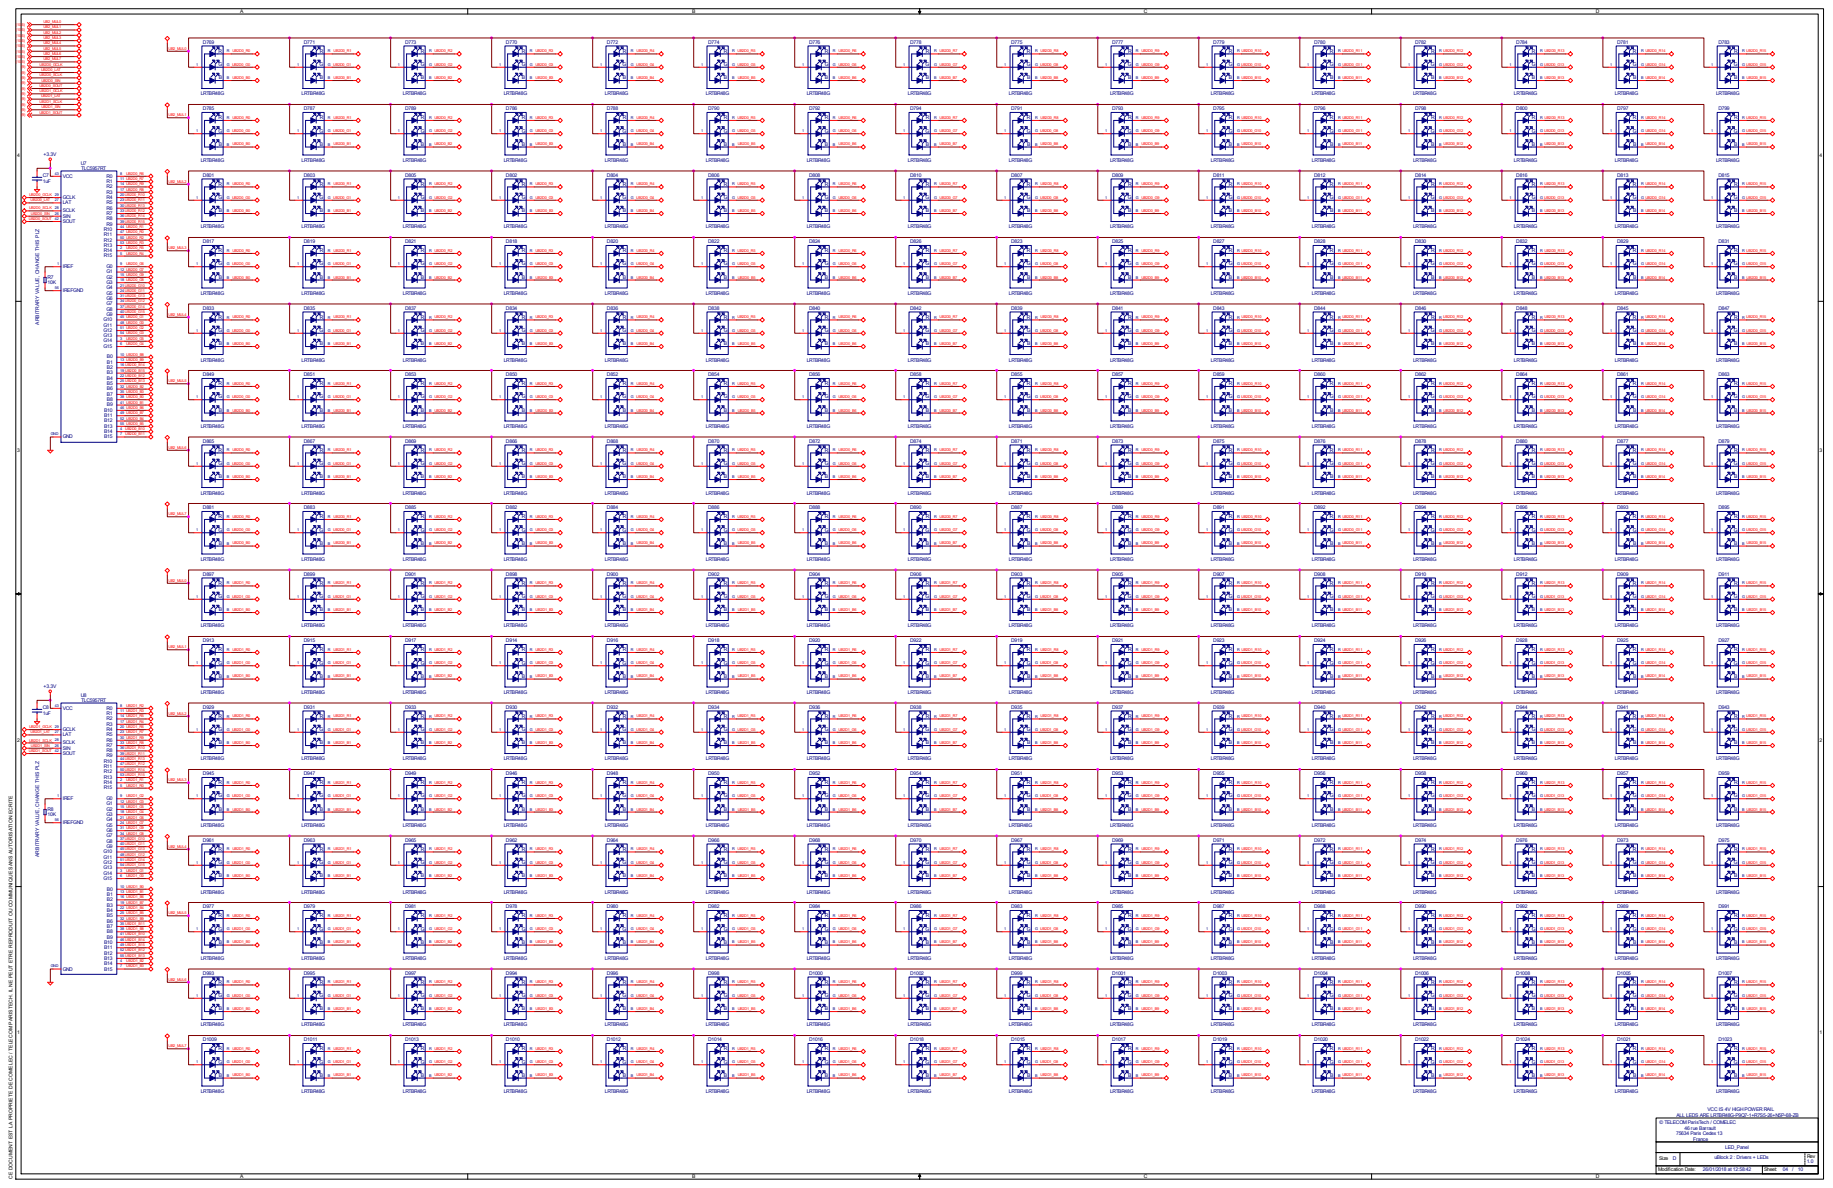
[picture p59: page 4]

A | B | C | D

+3.3V

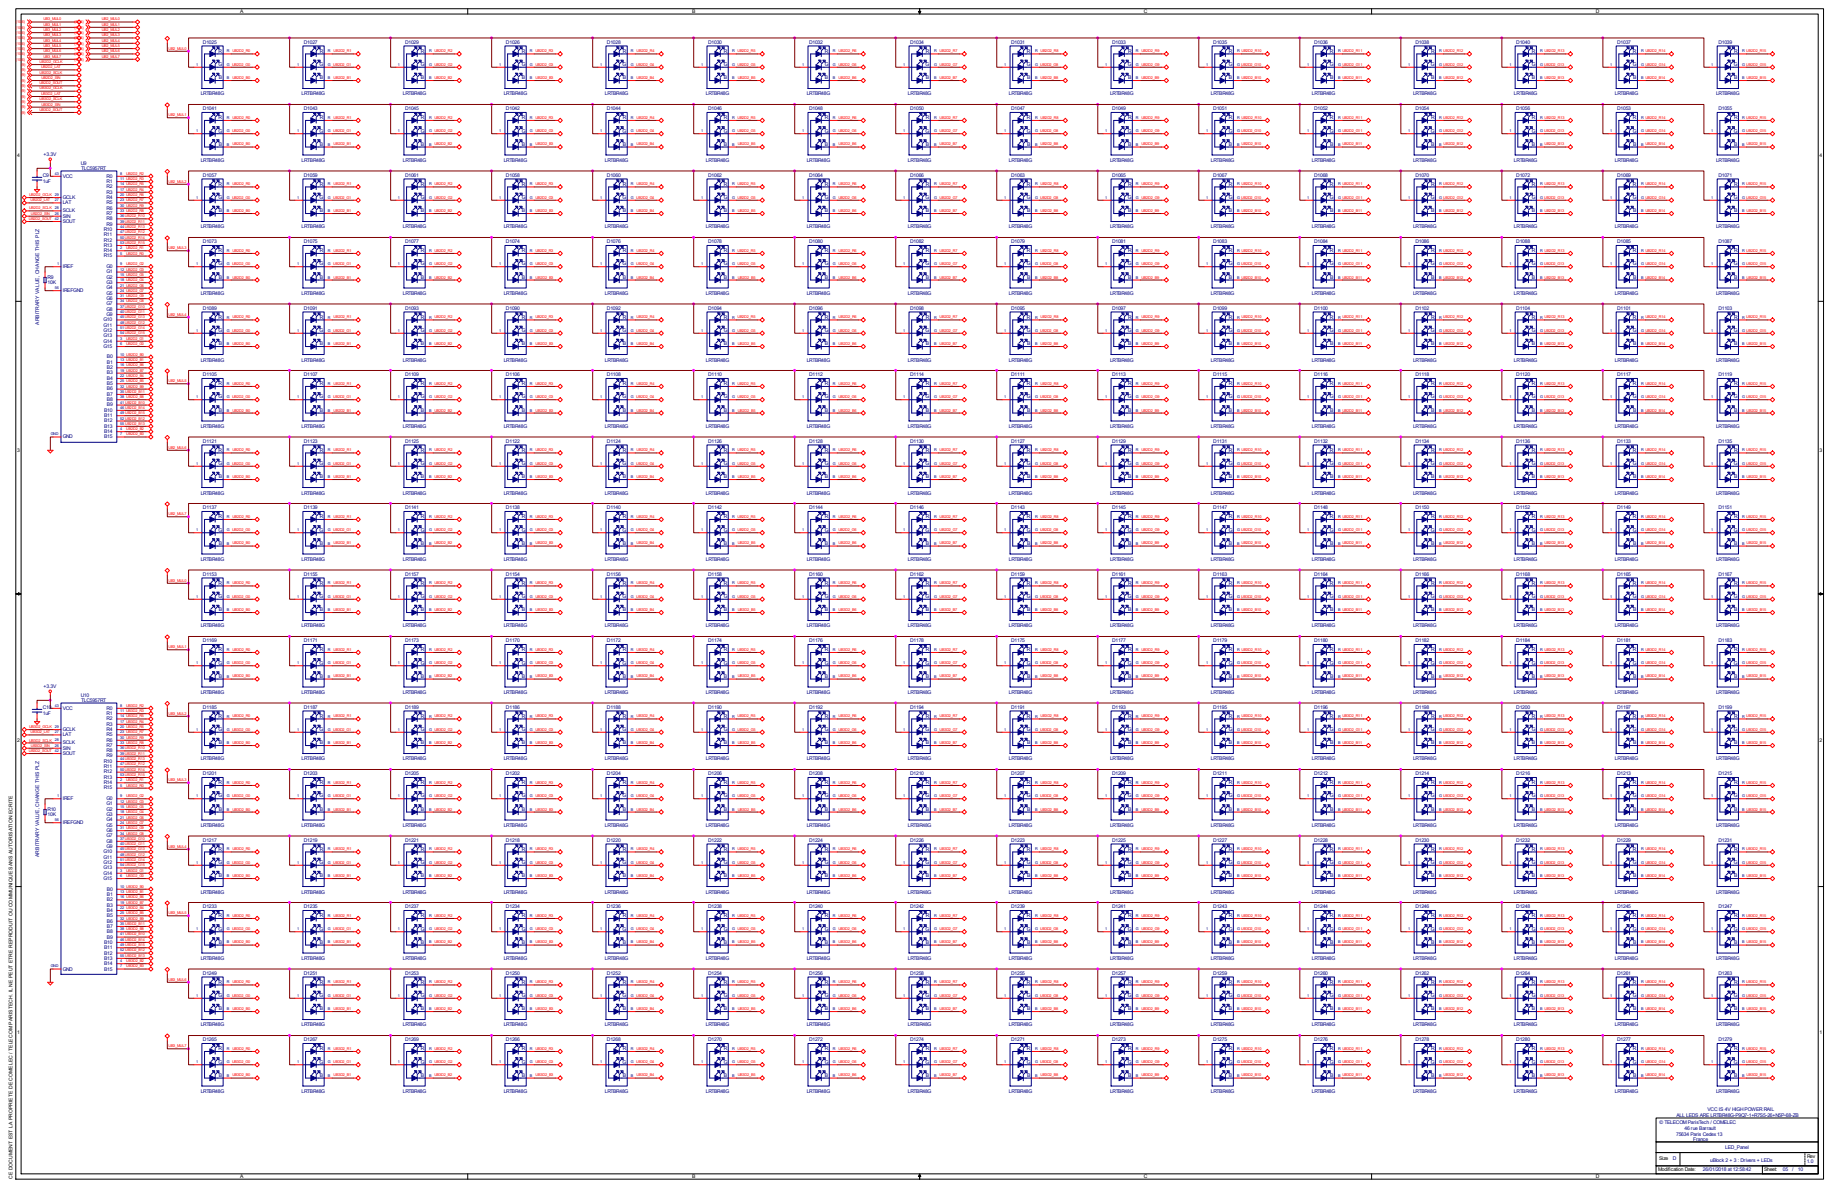
[picture p60: page 5]

A | B | C | D

+3.3V

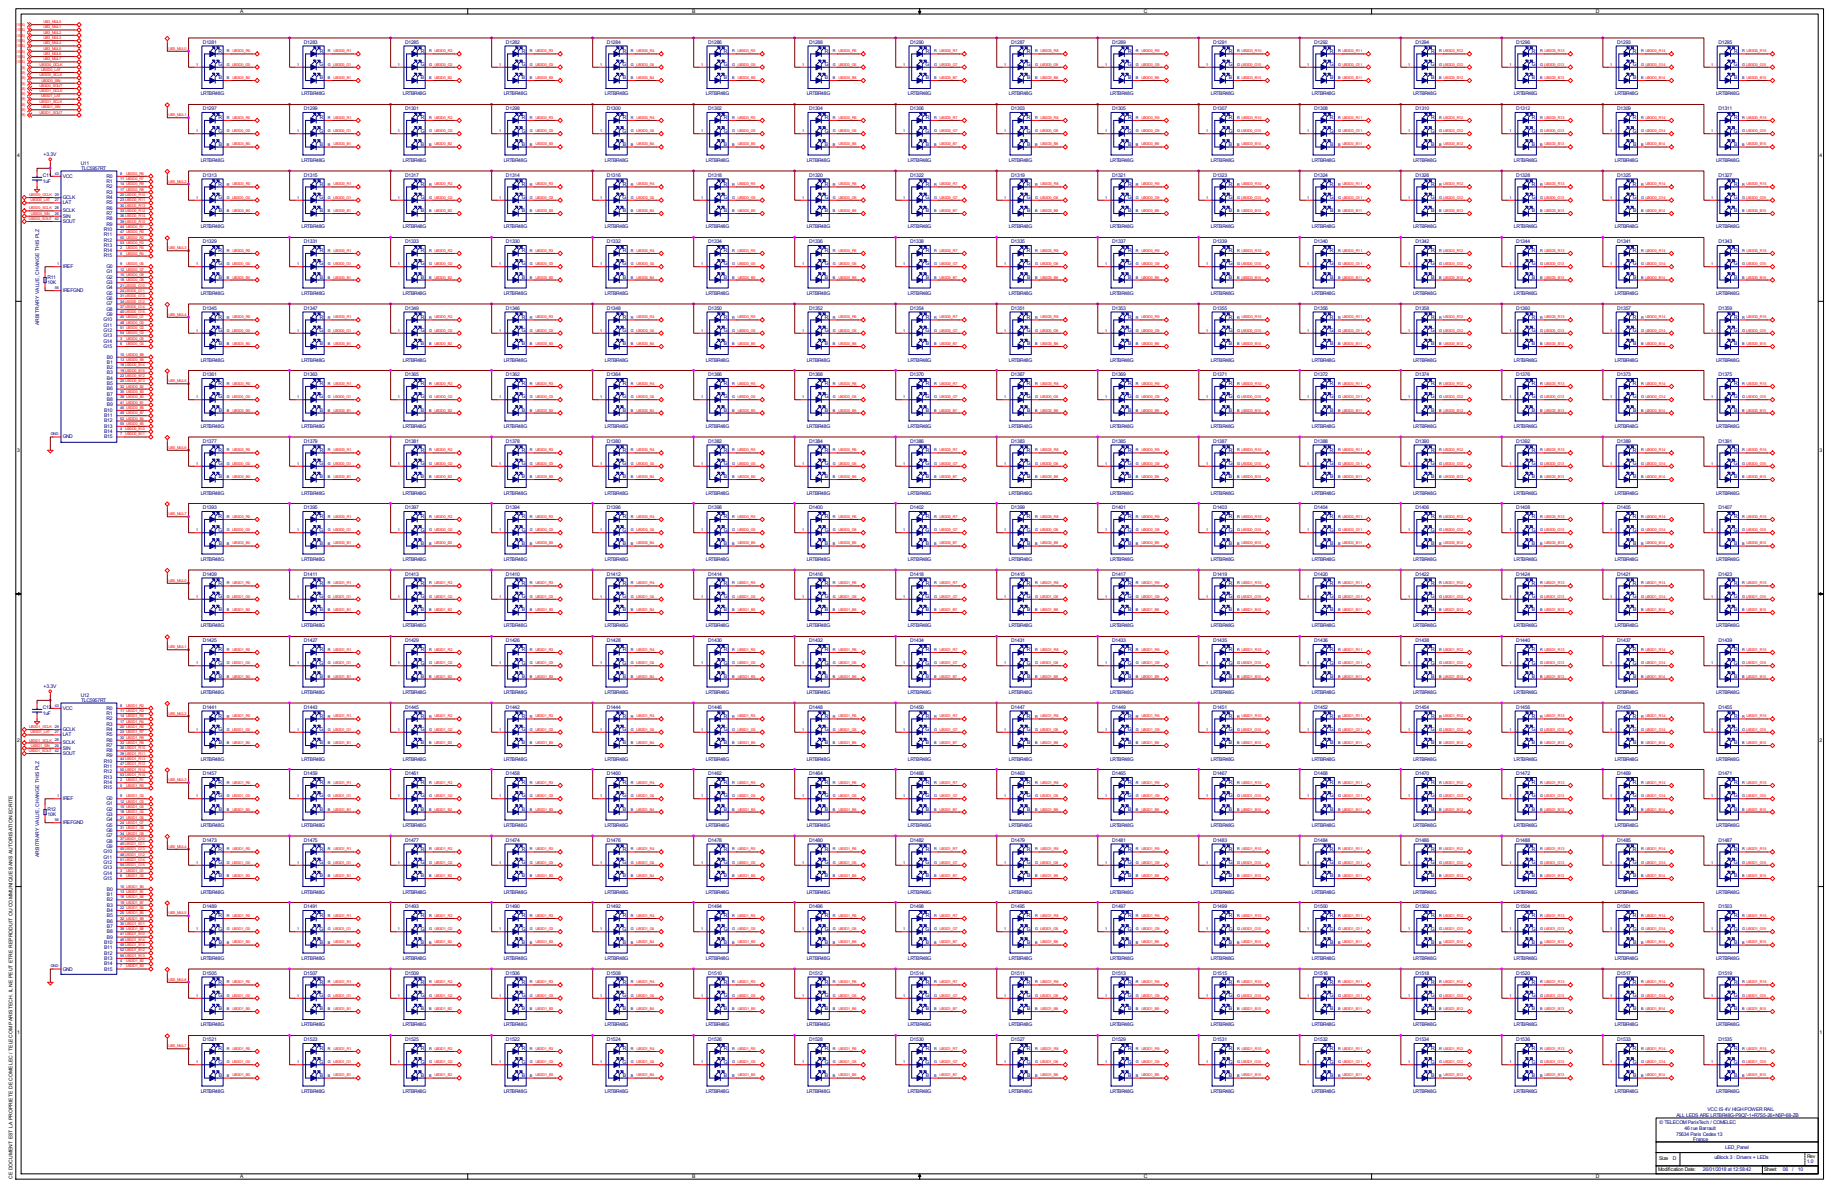
[picture p61: page 6]

A | B | C | D

+3.3V

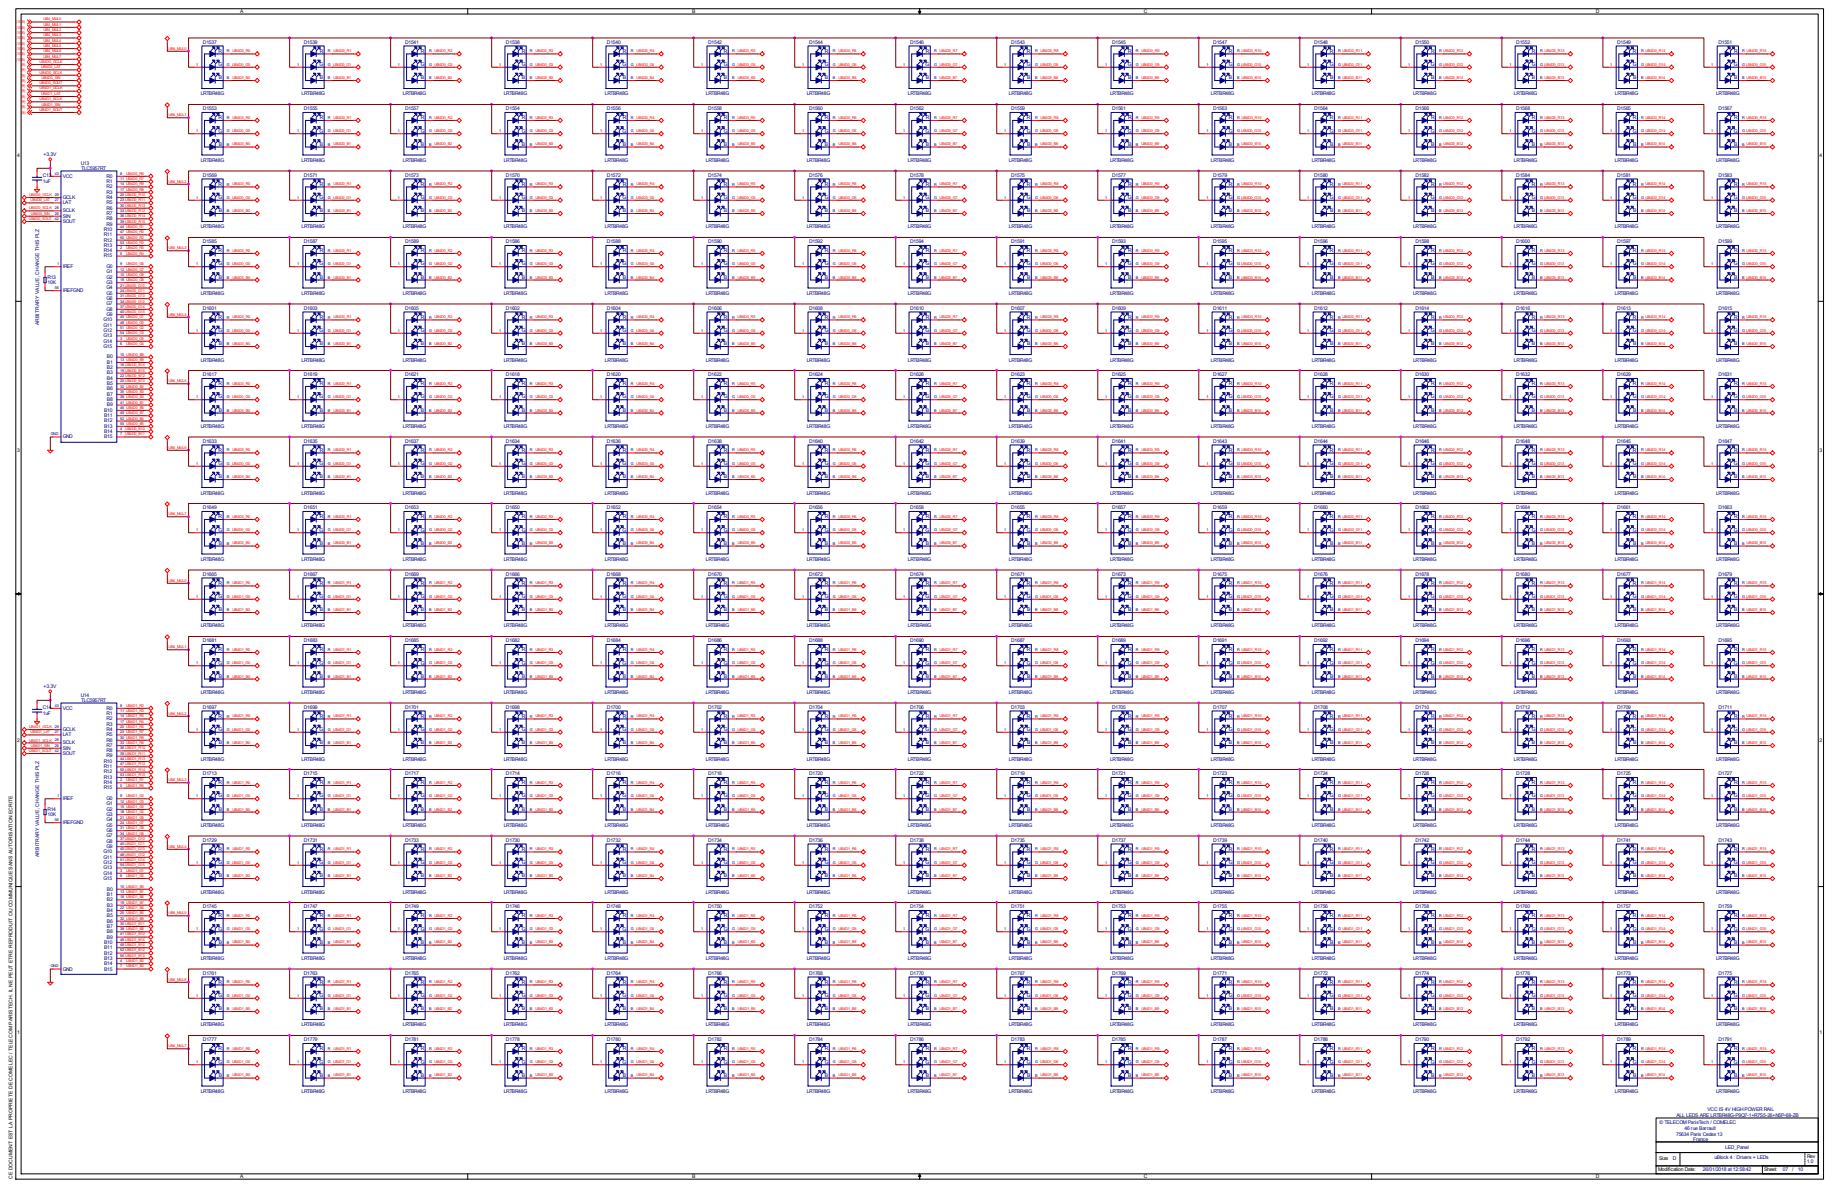
[picture p62: page 7]

A | B | C | D

+3.3V

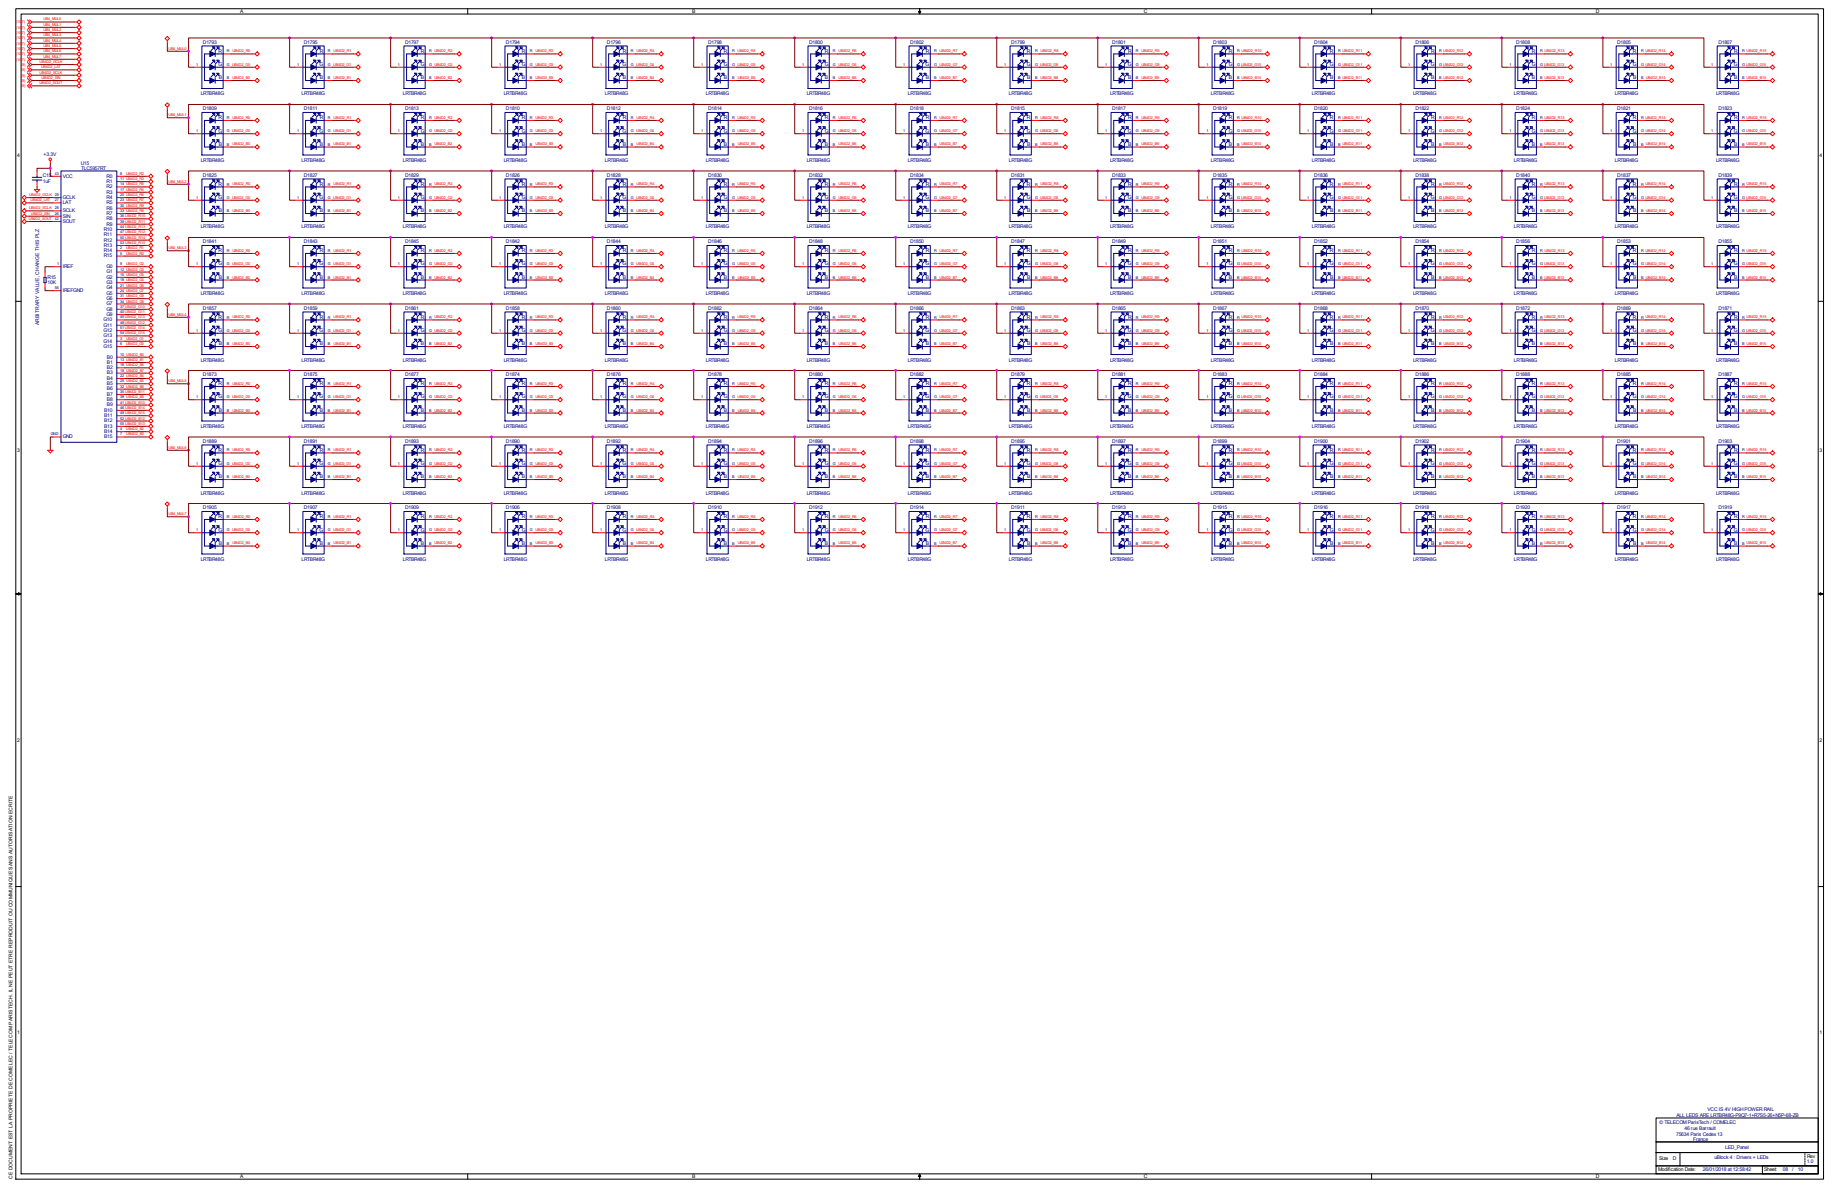
[picture p63: page 8]

# UB0D0_GCLK UB0D0_LAT

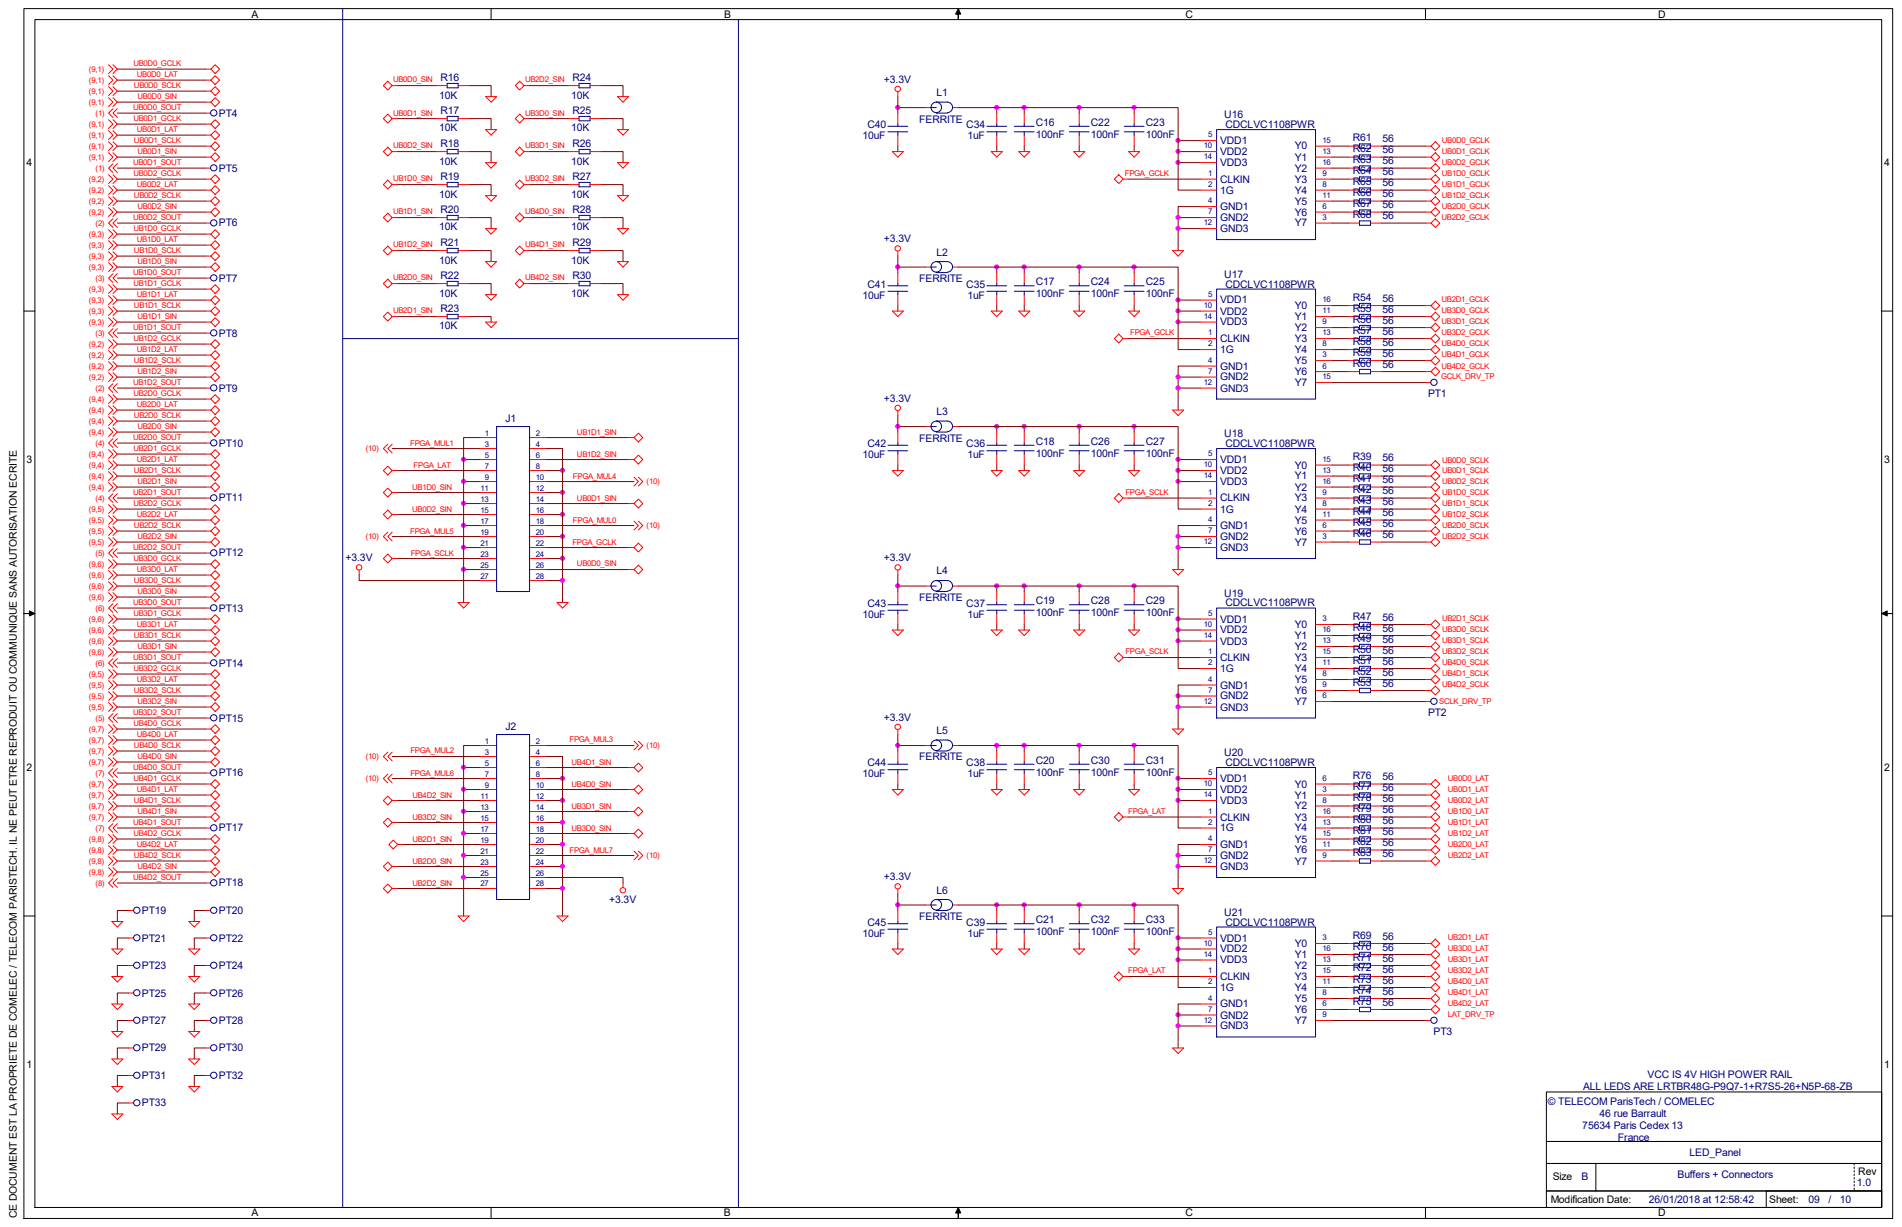
[picture p64: page 9]

ALL LEDS ARE LRTBR48G-P9Q7-1+R7S5-26+N5P-68-ZB
© TELECOM ParisTech / COMELEC

VCC IS 4V HIGH POWER RAIL

# FPGA_MUL0

4 4

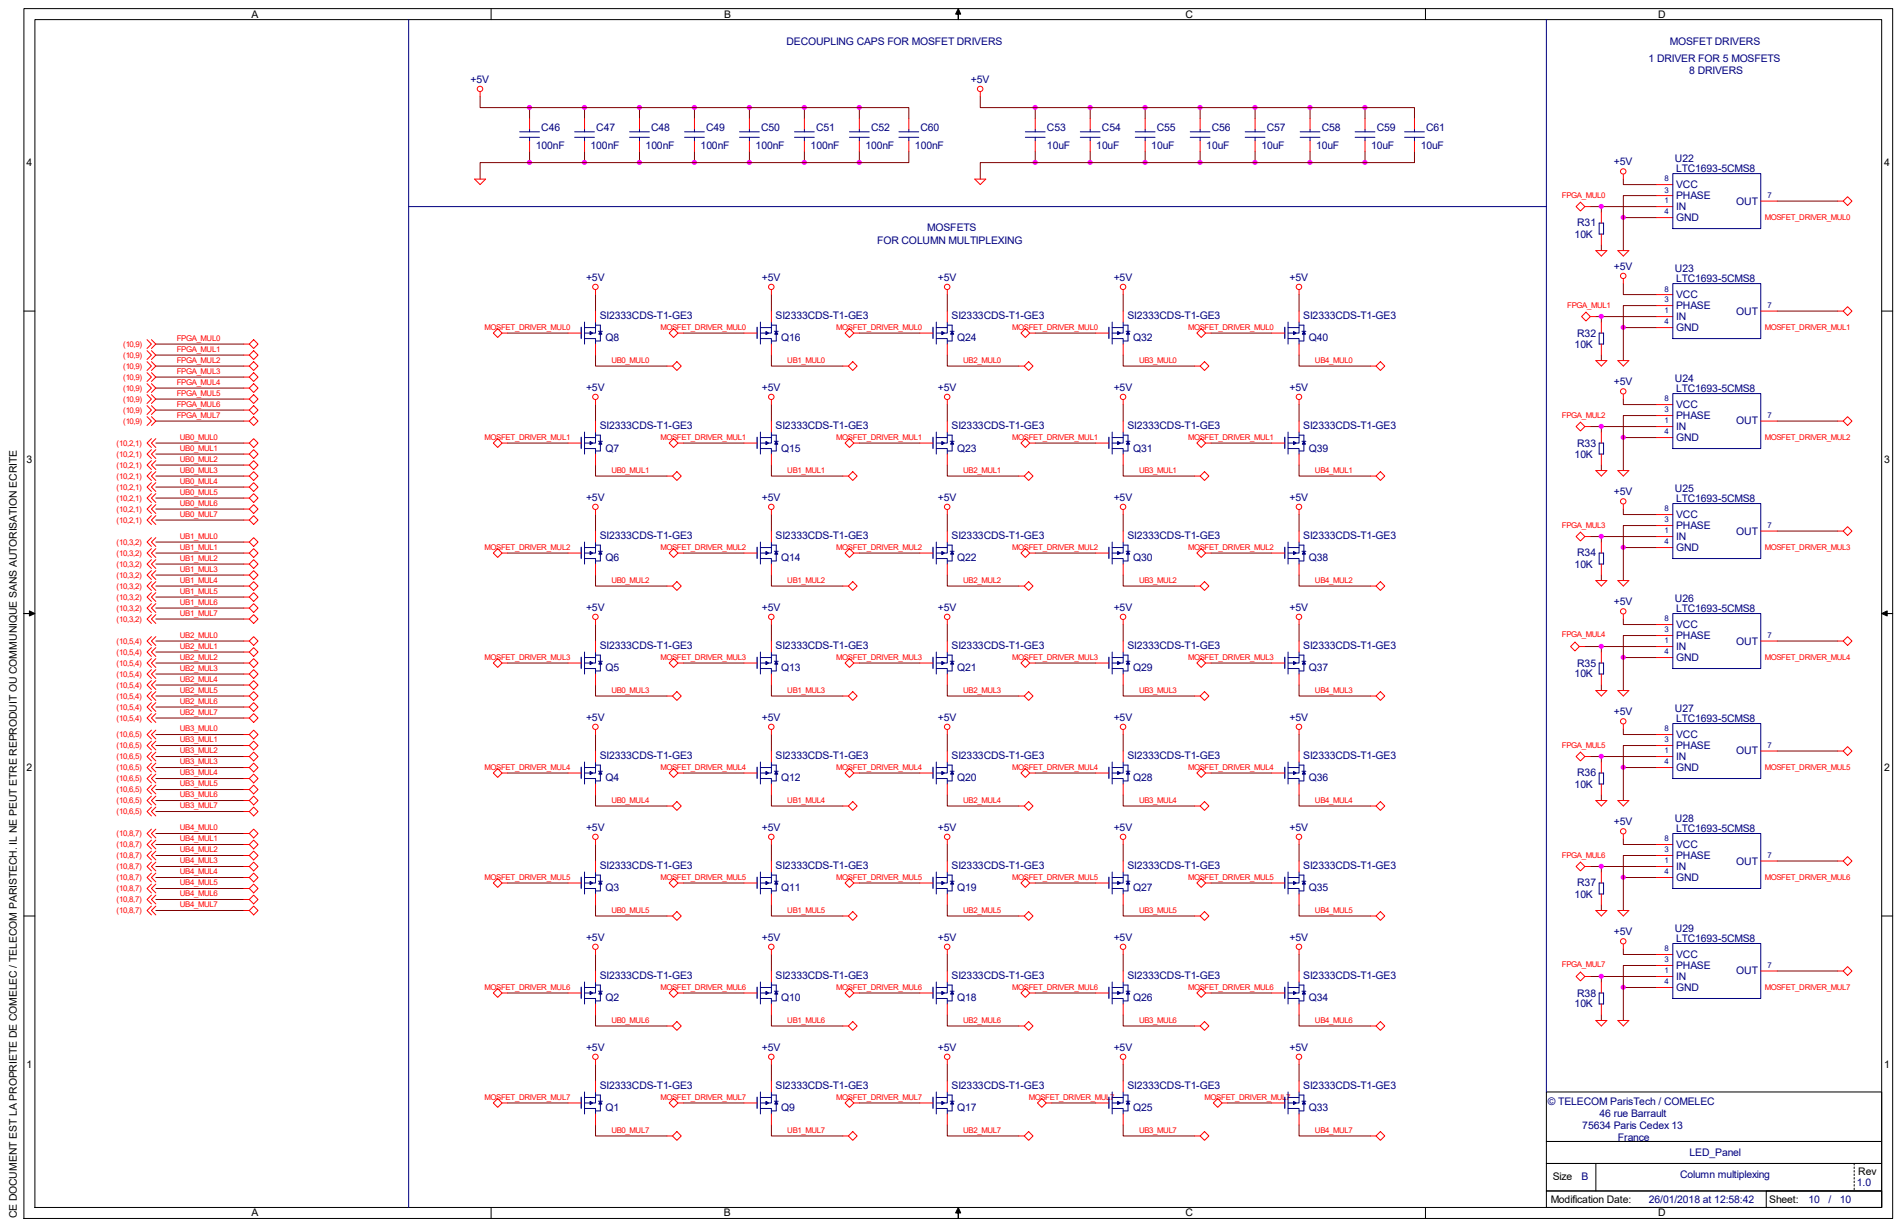
[picture p65: page 10]

DECOUPLING CAPS FOR MOSFET DRIVERS
