friendshipismagic/SpiROSE/PCB/Rotative_base/Schematic.pdf

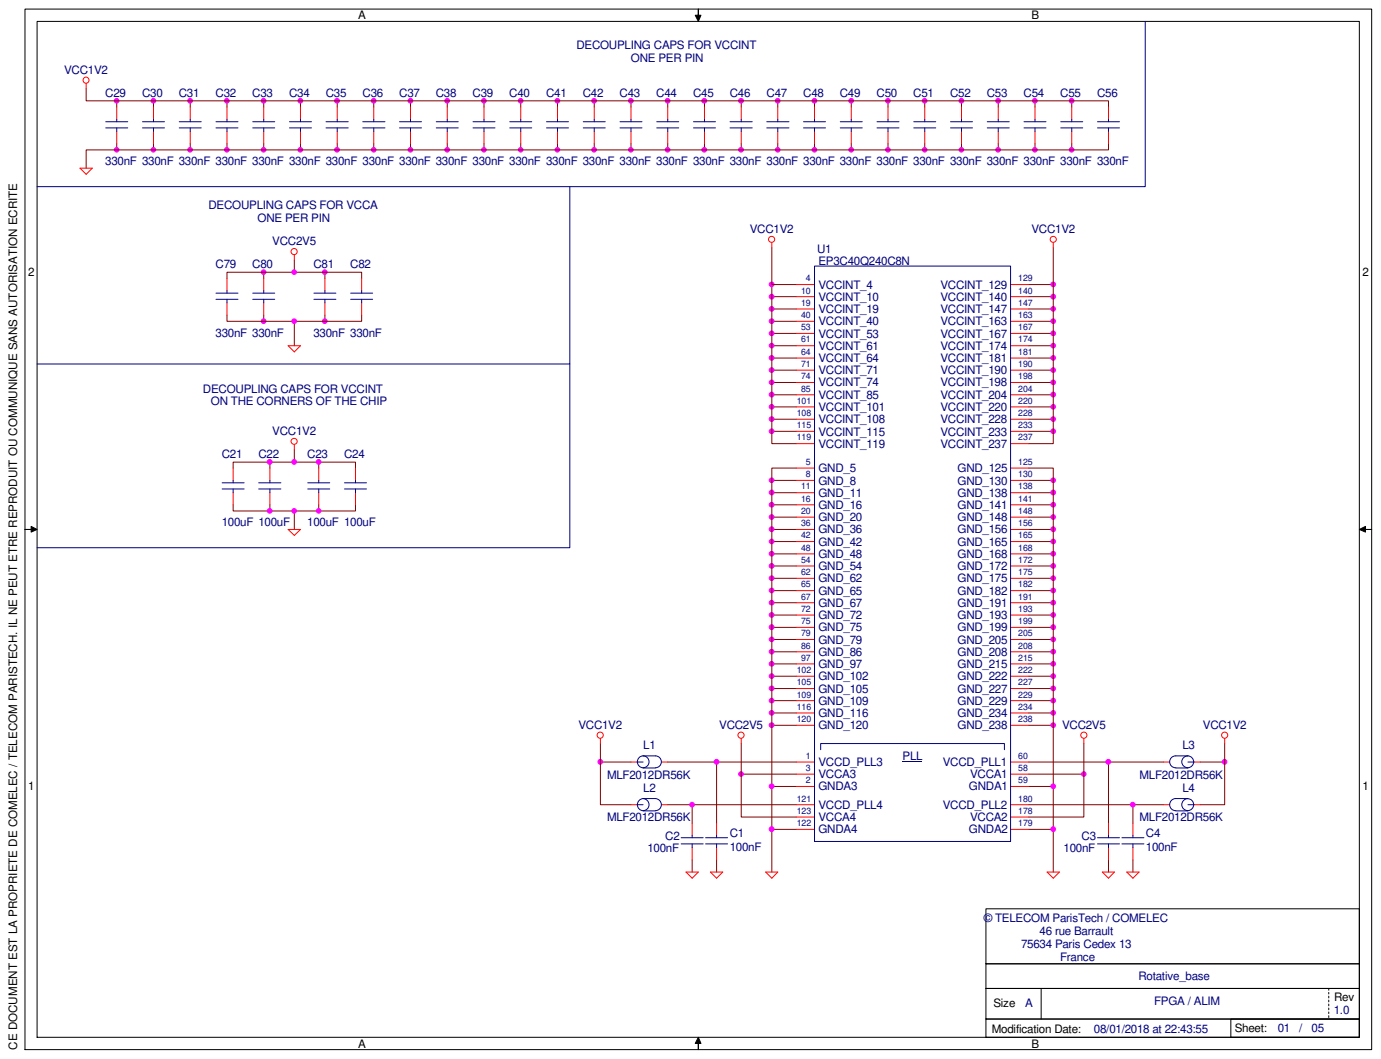
[picture p66: page 1]

DECOUPLING CAPS FOR VCCINT

CE DOCUMENT EST LA PROPRIETE DE COMELEC / TELECOM PARISTECH. IL NE PEUT ETRE REPRODUIT OU COMMUNIQUE SANS AUTORISATION ECRITE

DECOUPLING CAPS FOR VCCA

ON THE CORNERS OF THE CHIP

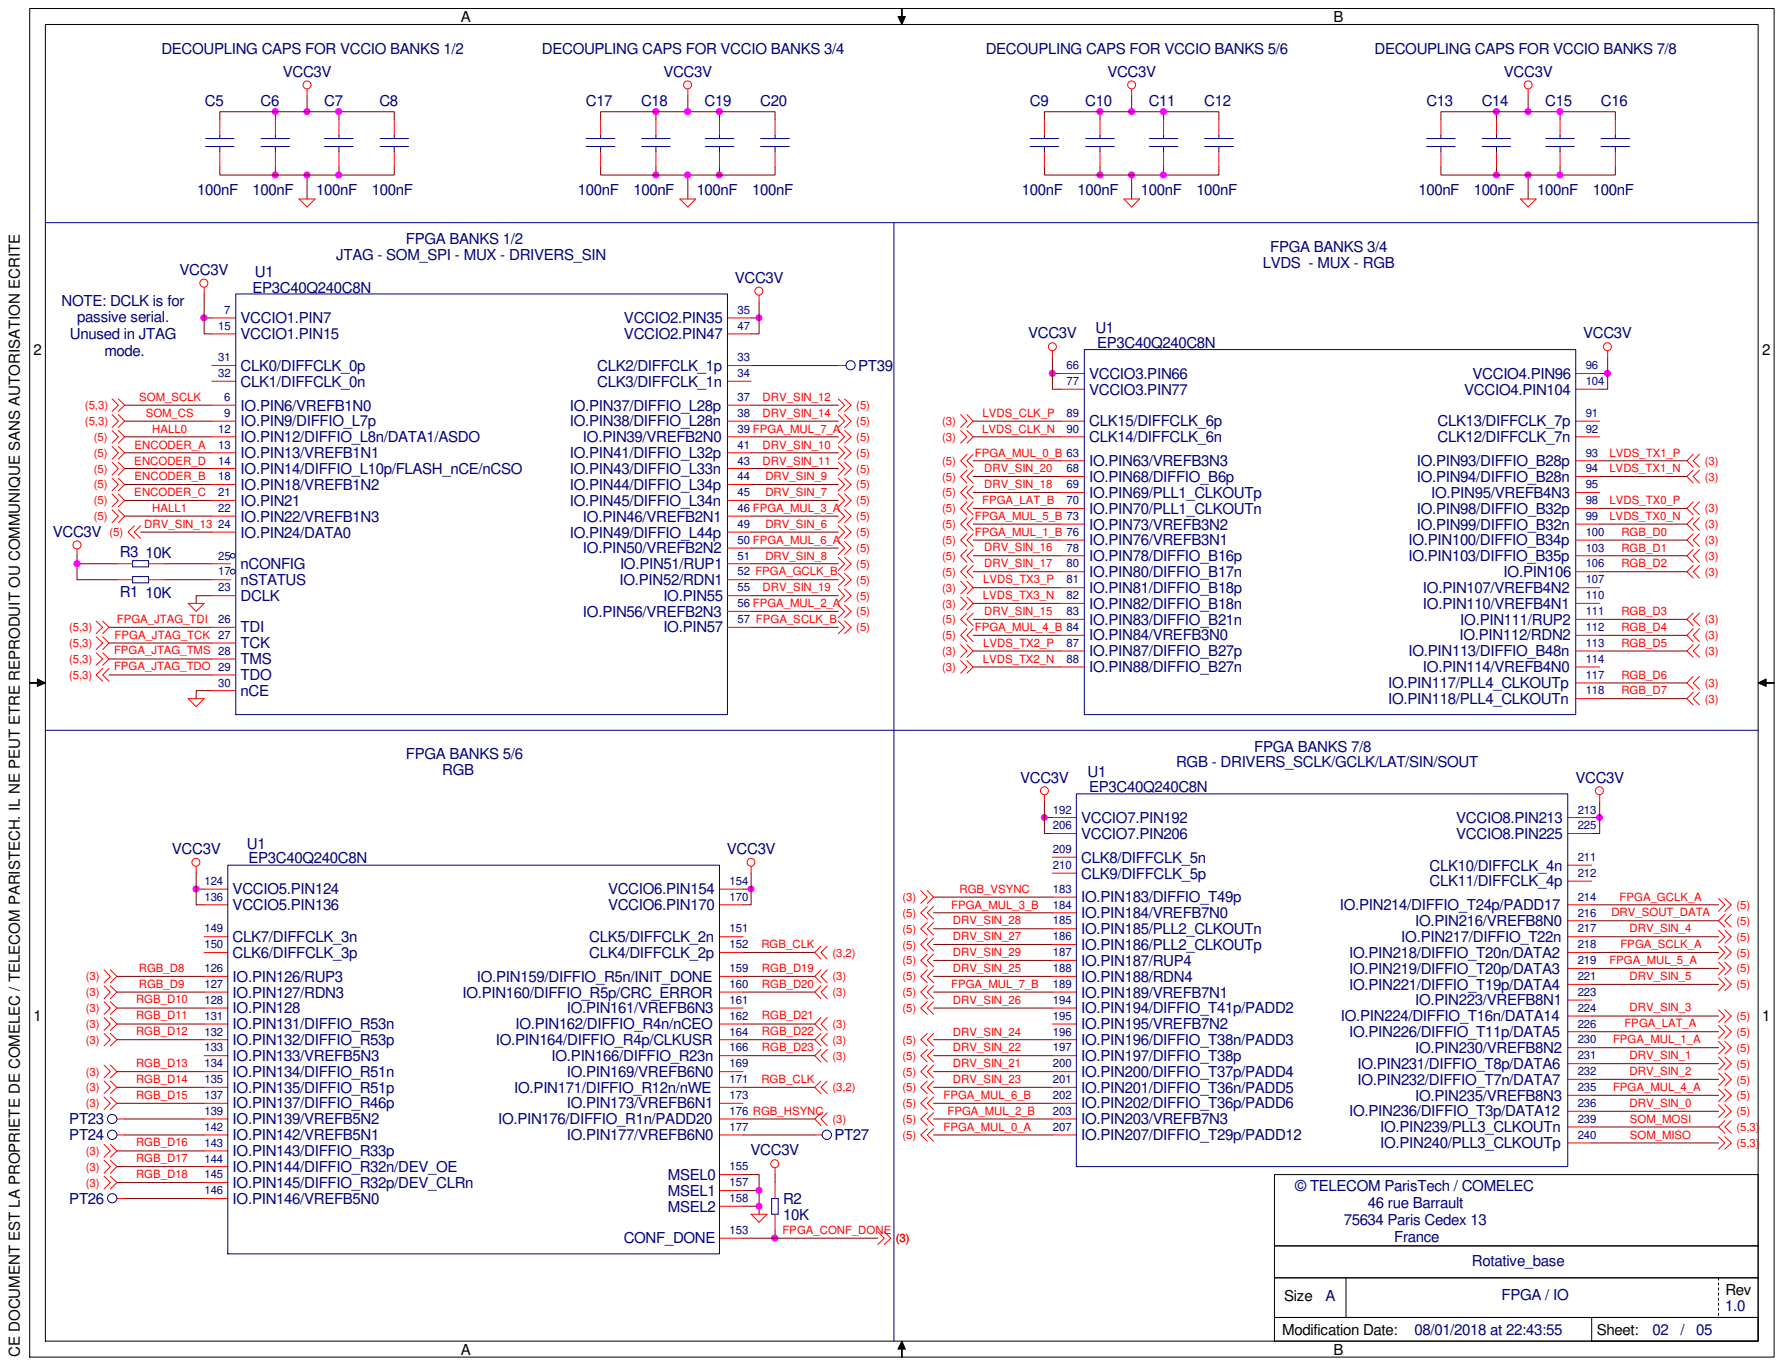
[picture p67: page 2]

DECOUPLING CAPS FOR VCCIO BANKS 1/2

DECOUPLING CAPS FOR VCCIO BANKS 3/4

DECOUPLING CAPS FOR VCCIO BANKS 5/6

DECOUPLING CAPS FOR VCCIO BANKS 7/8

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

NOTE: DCLK is for
passive serial.
Unused in JTAG

RGB - DRIVERS_SCLK/GCLK/LAT/SIN/SOUT

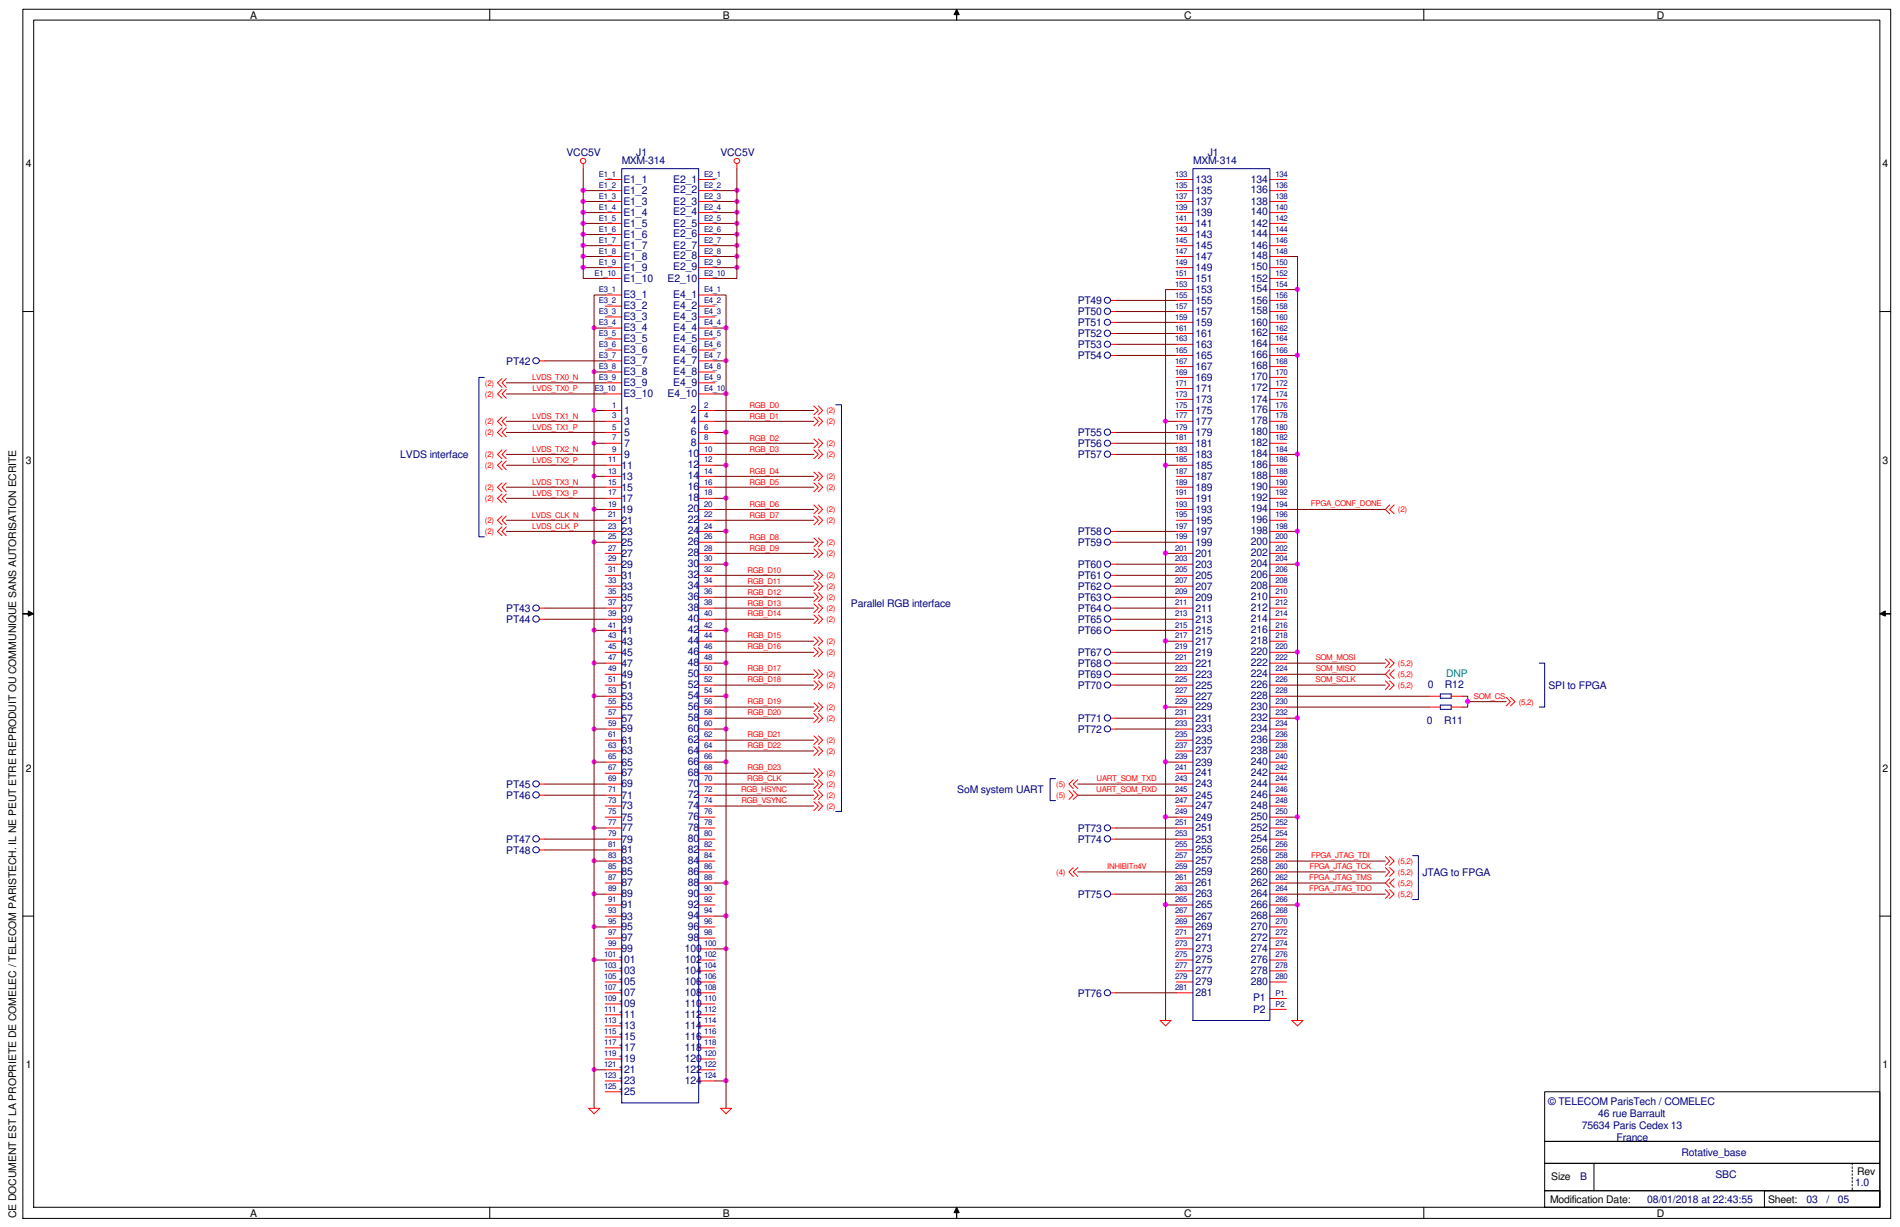
[picture p68: page 3]
RGB_D0; RGB_D1; RGB_D2; RGB_D3; RGB_D4; RGB_D5; RGB_D6; RGB_D7; RGB_D8; RGB_D9; RGB_D10; RGB_D11; RGB_D12; RGB_D13 RGB_D14; RGB_D15; RGB_D16; RGB_D17; RGB_D18; RGB_D19; RGB_D20; RGB_D21; RGB_D22; RGB_D23; RGB_CLK; RGB_HSYNC; RGB_VSYNC; LVDS_TX0_N; LVDS_TX0_P; LVDS_TX1_N; LVDS_TX1_P; LVDS_TX2_N; LVDS_TX2_P; LVDS_TX3_N; LVDS_TX3_P; LVDS_CLK_N; LVDS_CLK_P; UART_SOM_TXD; UART_SOM_RXD; FPGA_JTAG_TDI; FPGA_JTAG_TCK; FPGA_JTAG_TMS; FPGA_JTAG_TDO; SOM_MOSI; SOM_MISO; SOM_SCLK; INHIBITn4V; SOM_CS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

SPI to FPGA

SoM system UART

JTAG to FPGA

© TELECOM ParisTech / COMELEC

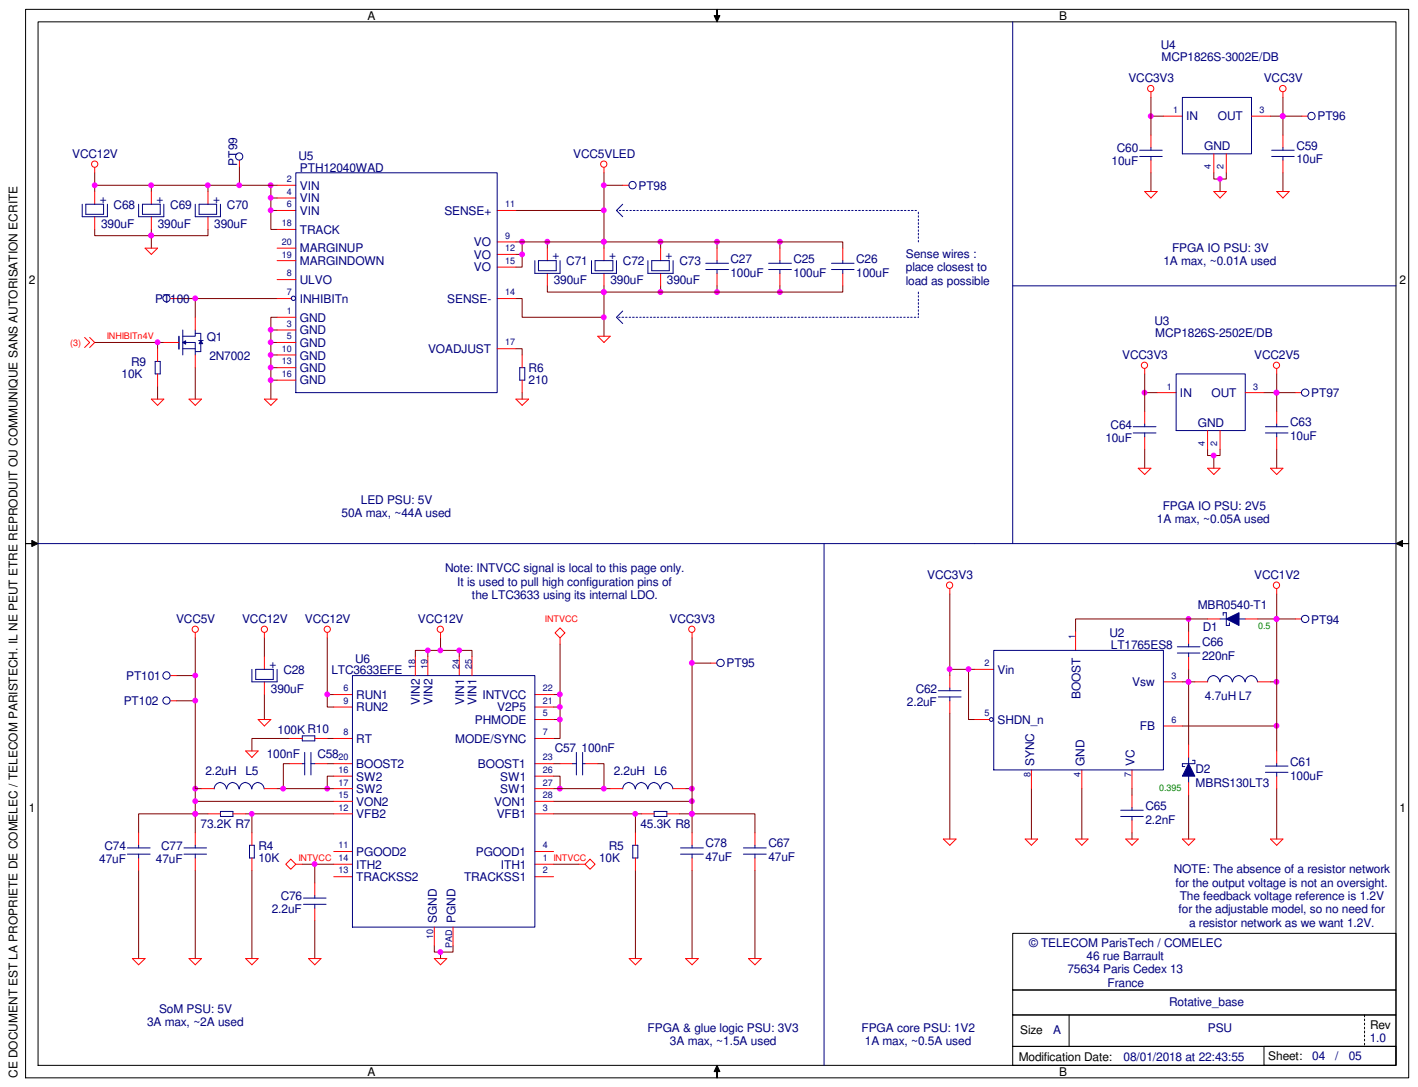
[picture p69: page 4]
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

SENSE+ VOVOVO TRACK INHIBITn

Note: INTVCC signal is local to this page only.
It is used to pull high configuration pins of
the LTC3633 using its internal LDO.

NOTE: The absence of a resistor network
for the output voltage is not an oversight.
The feedback voltage reference is 1.2V
for the adjustable model, so no need for
a resistor network as we want 1.2V.

FPGA & glue logic PSU: 3V3
3A max, ~1.5A used

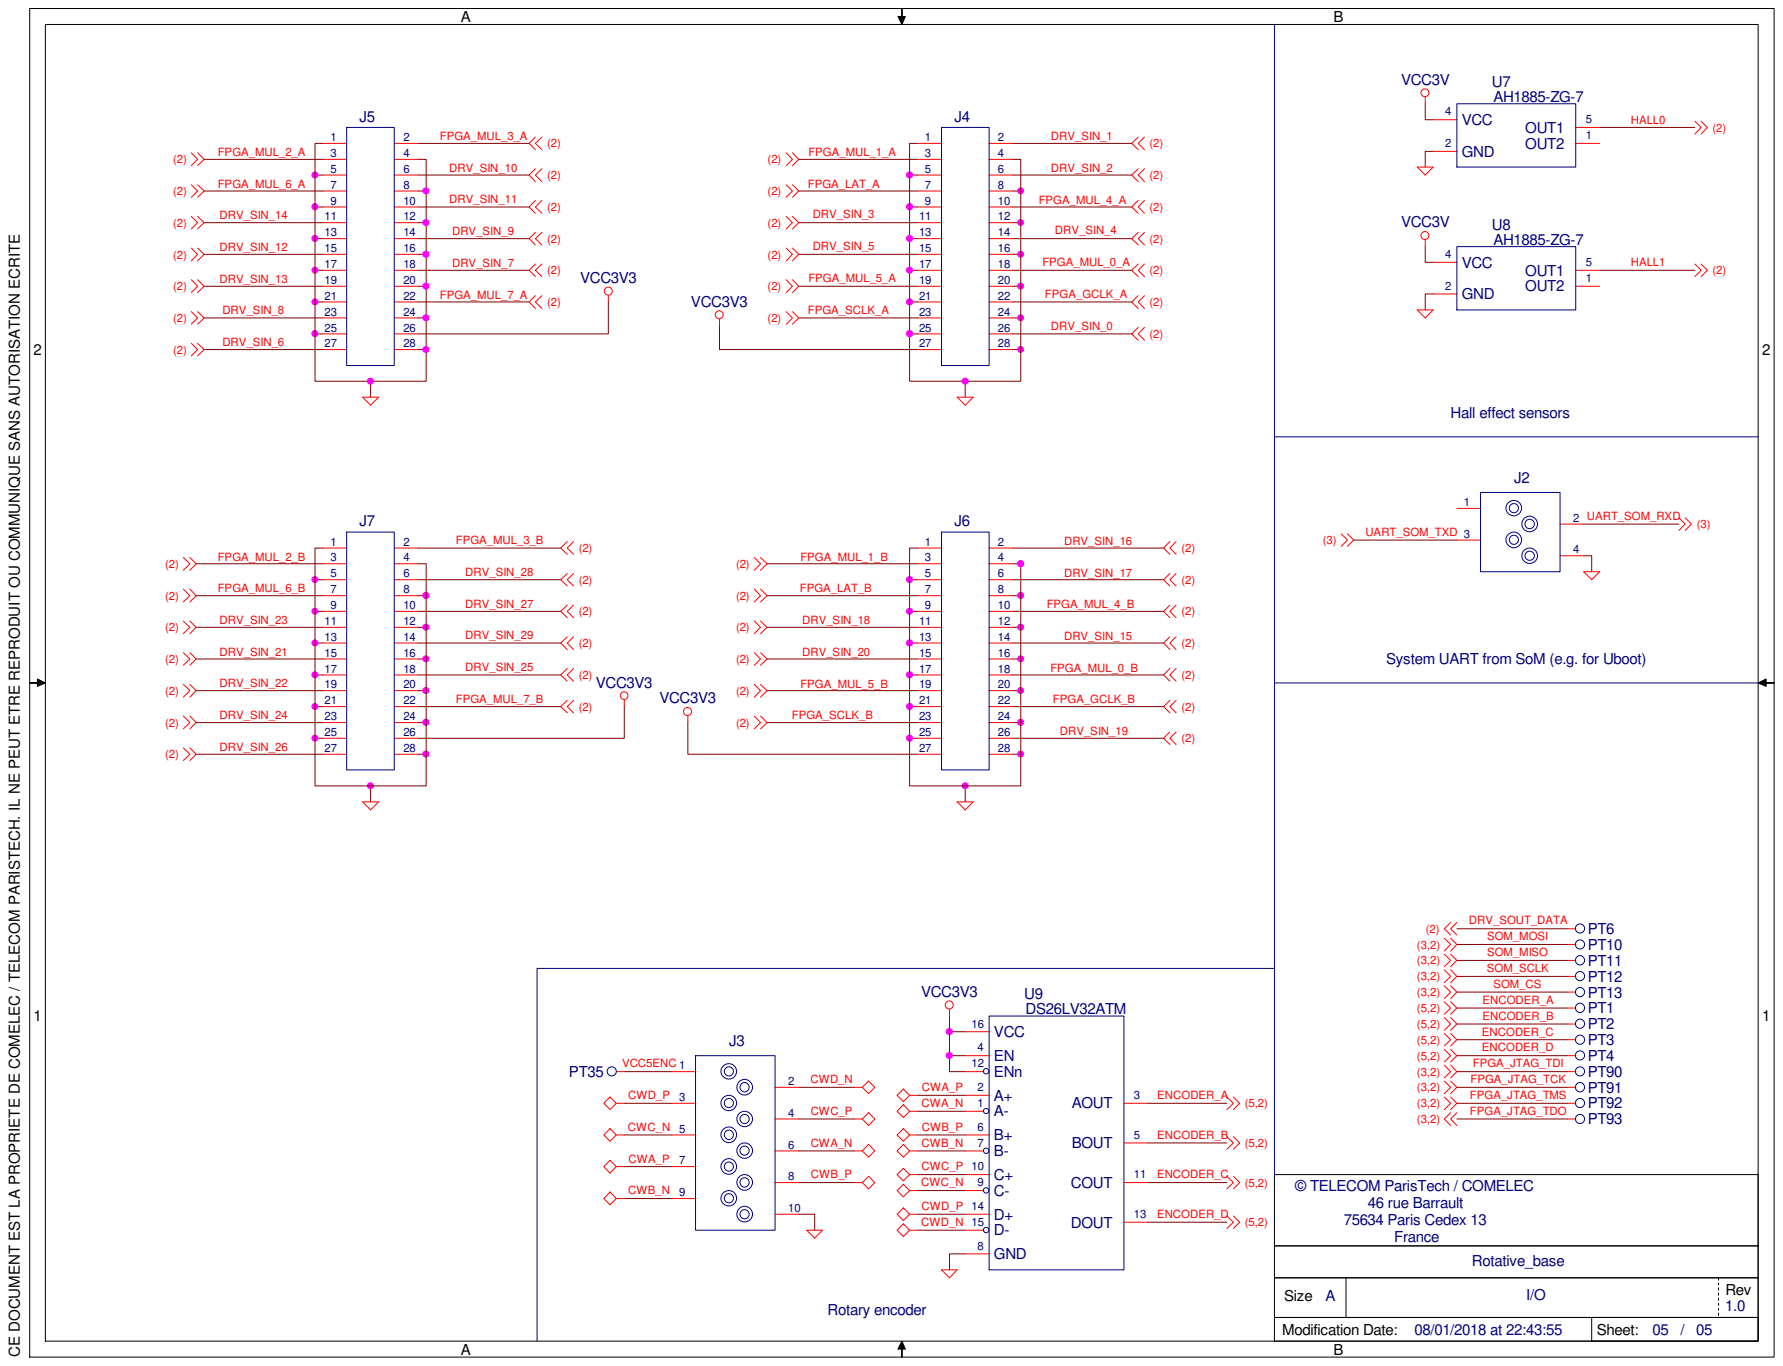
[picture p70: page 5]
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

System UART from SoM (e.g. for Uboot)
