friendshipismagic/SpiROSE/docs/mechanical_design/SpiROSE.PDF

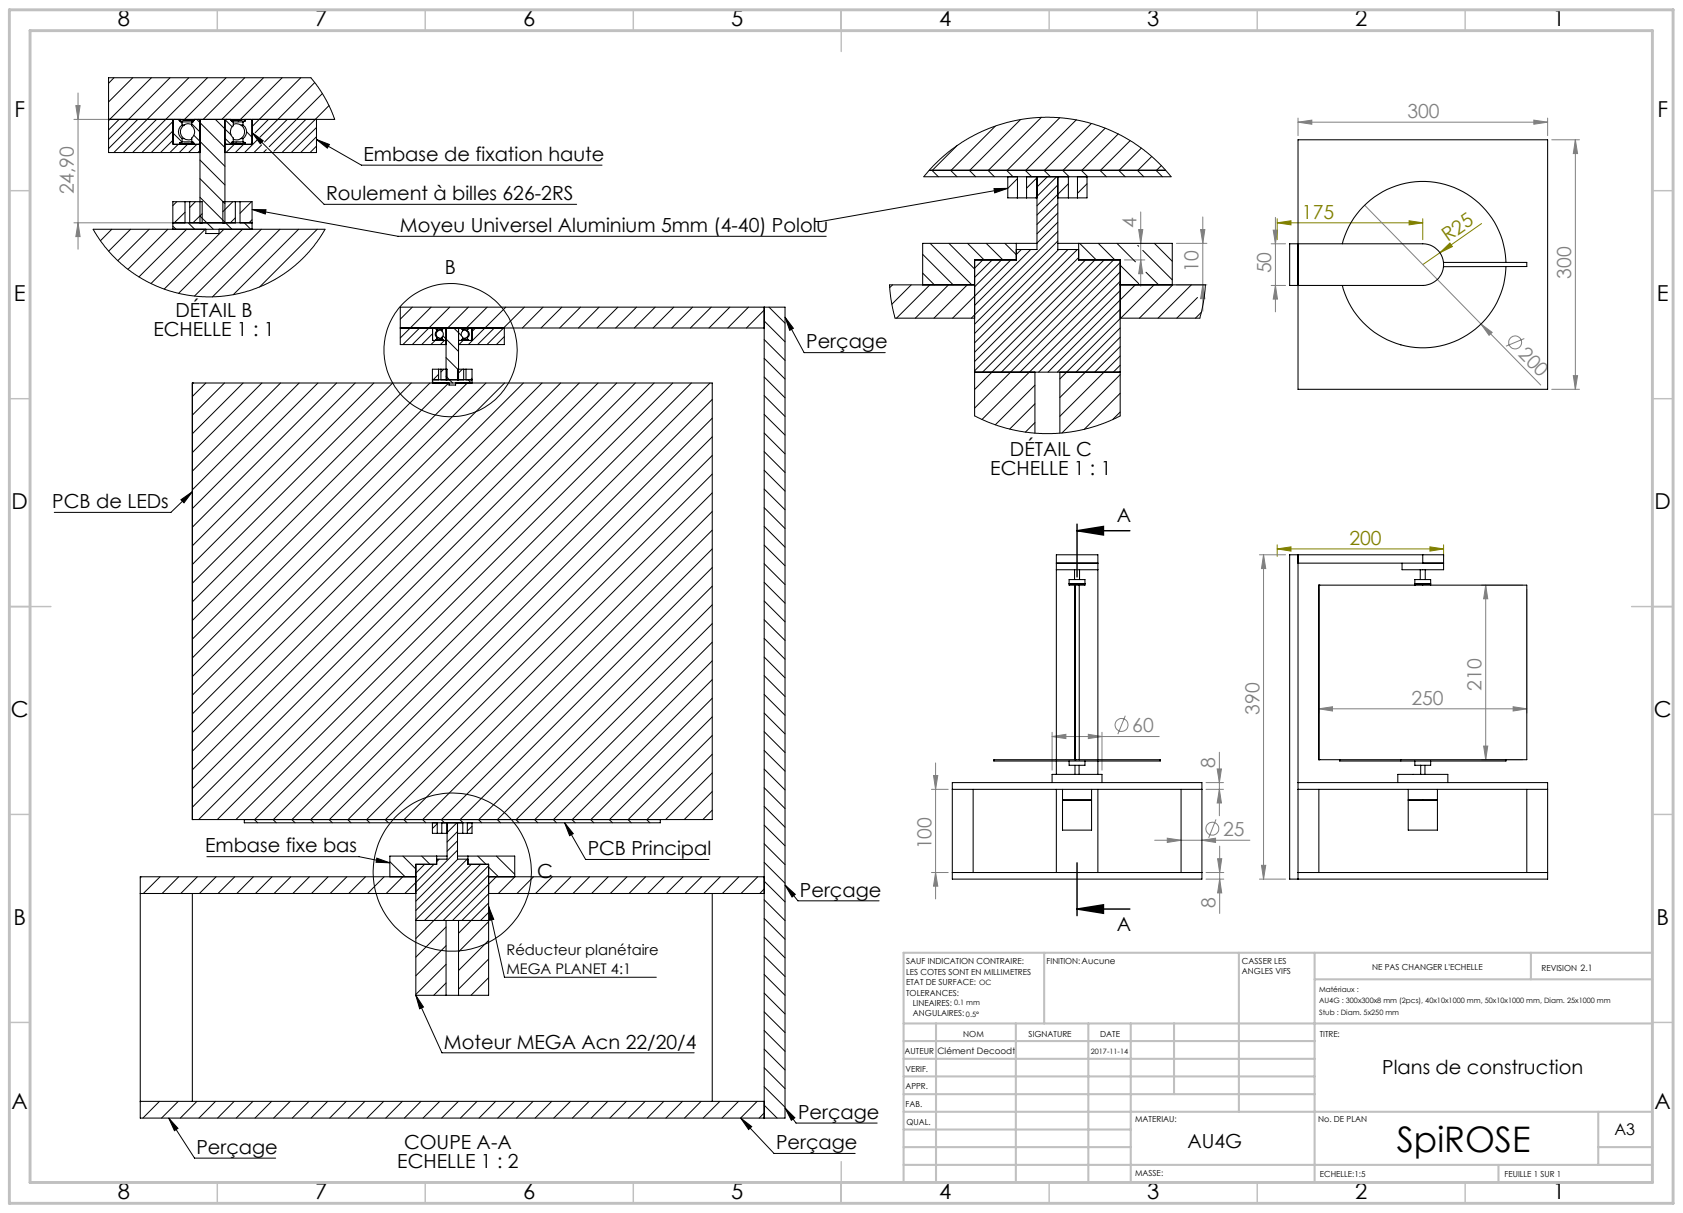
[picture p71: page 1]
COUPE A-A ECHELLE 1 : 2; Réducteur planétaire MEGA PLANET 4:1; PCB Principal; DÉTAIL B ECHELLE 1 : 1; DÉTAIL C ECHELLE 1 : 1; FINITION:; CASSER LES; ANGLES VIFS; NE PAS CHANGER L'ECHELLE; REVISION; ECHELLE:1:5; FEUILLE 1 SUR 1

Embase de fixation haute
Roulement à billes 626-2RS
Moyeu Universel Aluminium 5mm (4-40) Pololu

PCB de LEDs

Embase fixe bas

SAUF INDICATION CONTRAIRE:
LES COTES SONT EN MILLIMETRES
ETAT DE SURFACE:
TOLERANCES:
LINEAIRES:
ANGULAIRES:

Matériaux :
AU4G : 300x300x8 mm (2pcs), 40x10x1000 mm, 50x10x1000 mm, Diam. 25x1000 mm
Stub : Diam. 5x250 mm

Moteur MEGA Acn 22/20/4

NOM | SIGNATURE | DATE | | | | TITRE: Plans de construction

AUTEUR | Clément Decoodt | | 2017-11-14
VERIF.
APPR.
FAB.
QUAL. | | | | MATERIAU: AU4G | No. DE PLAN SpiROSE | A3
