friendshipismagic/SpiROSE/PCB/LED_Panel/Assembly/Assembly_Top.pdf

# PCB

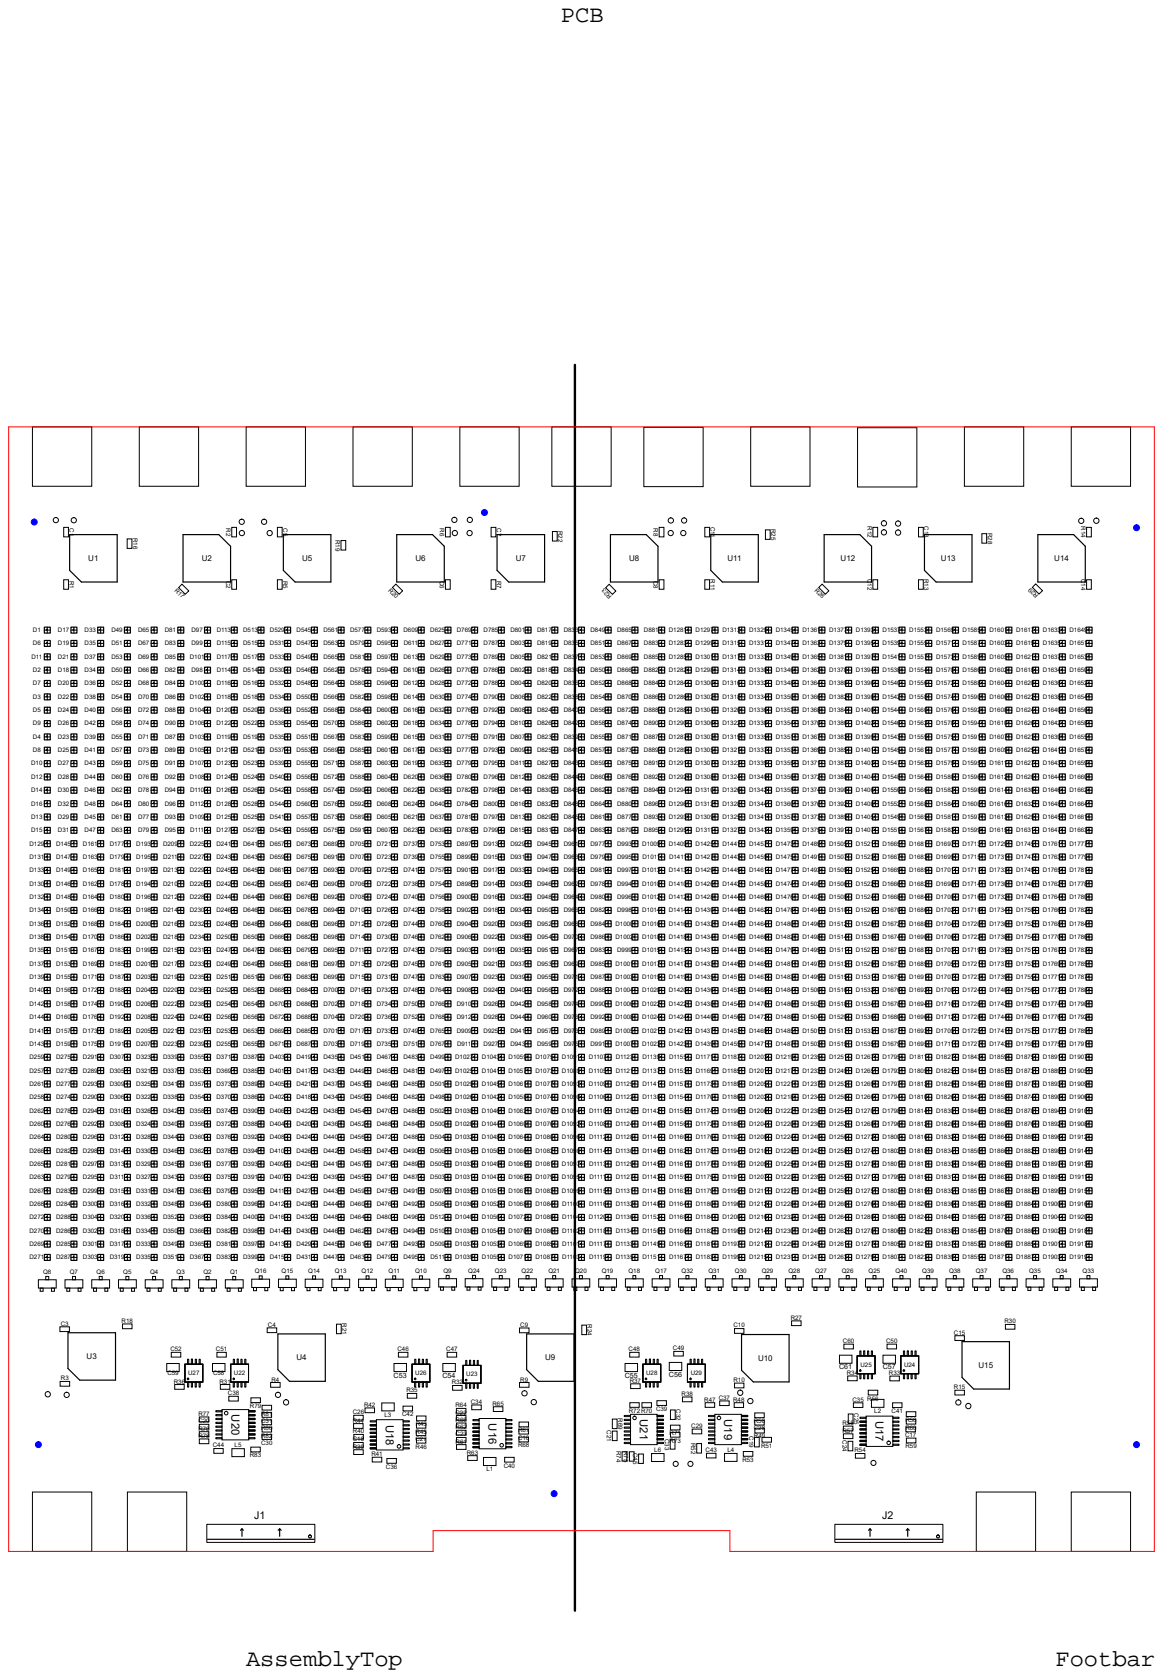
[picture p72: page 1]
