friendshipismagic/SpiROSE/PCB/misc/LED_Panel_4_layers/Schematic.pdf

# MUL0 MUL1 MUL2 MUL3 MUL4 MUL5 MUL6 MUL7 UB0D0_GCLK UB0D0_LAT UB0D0_SCLK UB0D0_SIN

+3.3V | RG

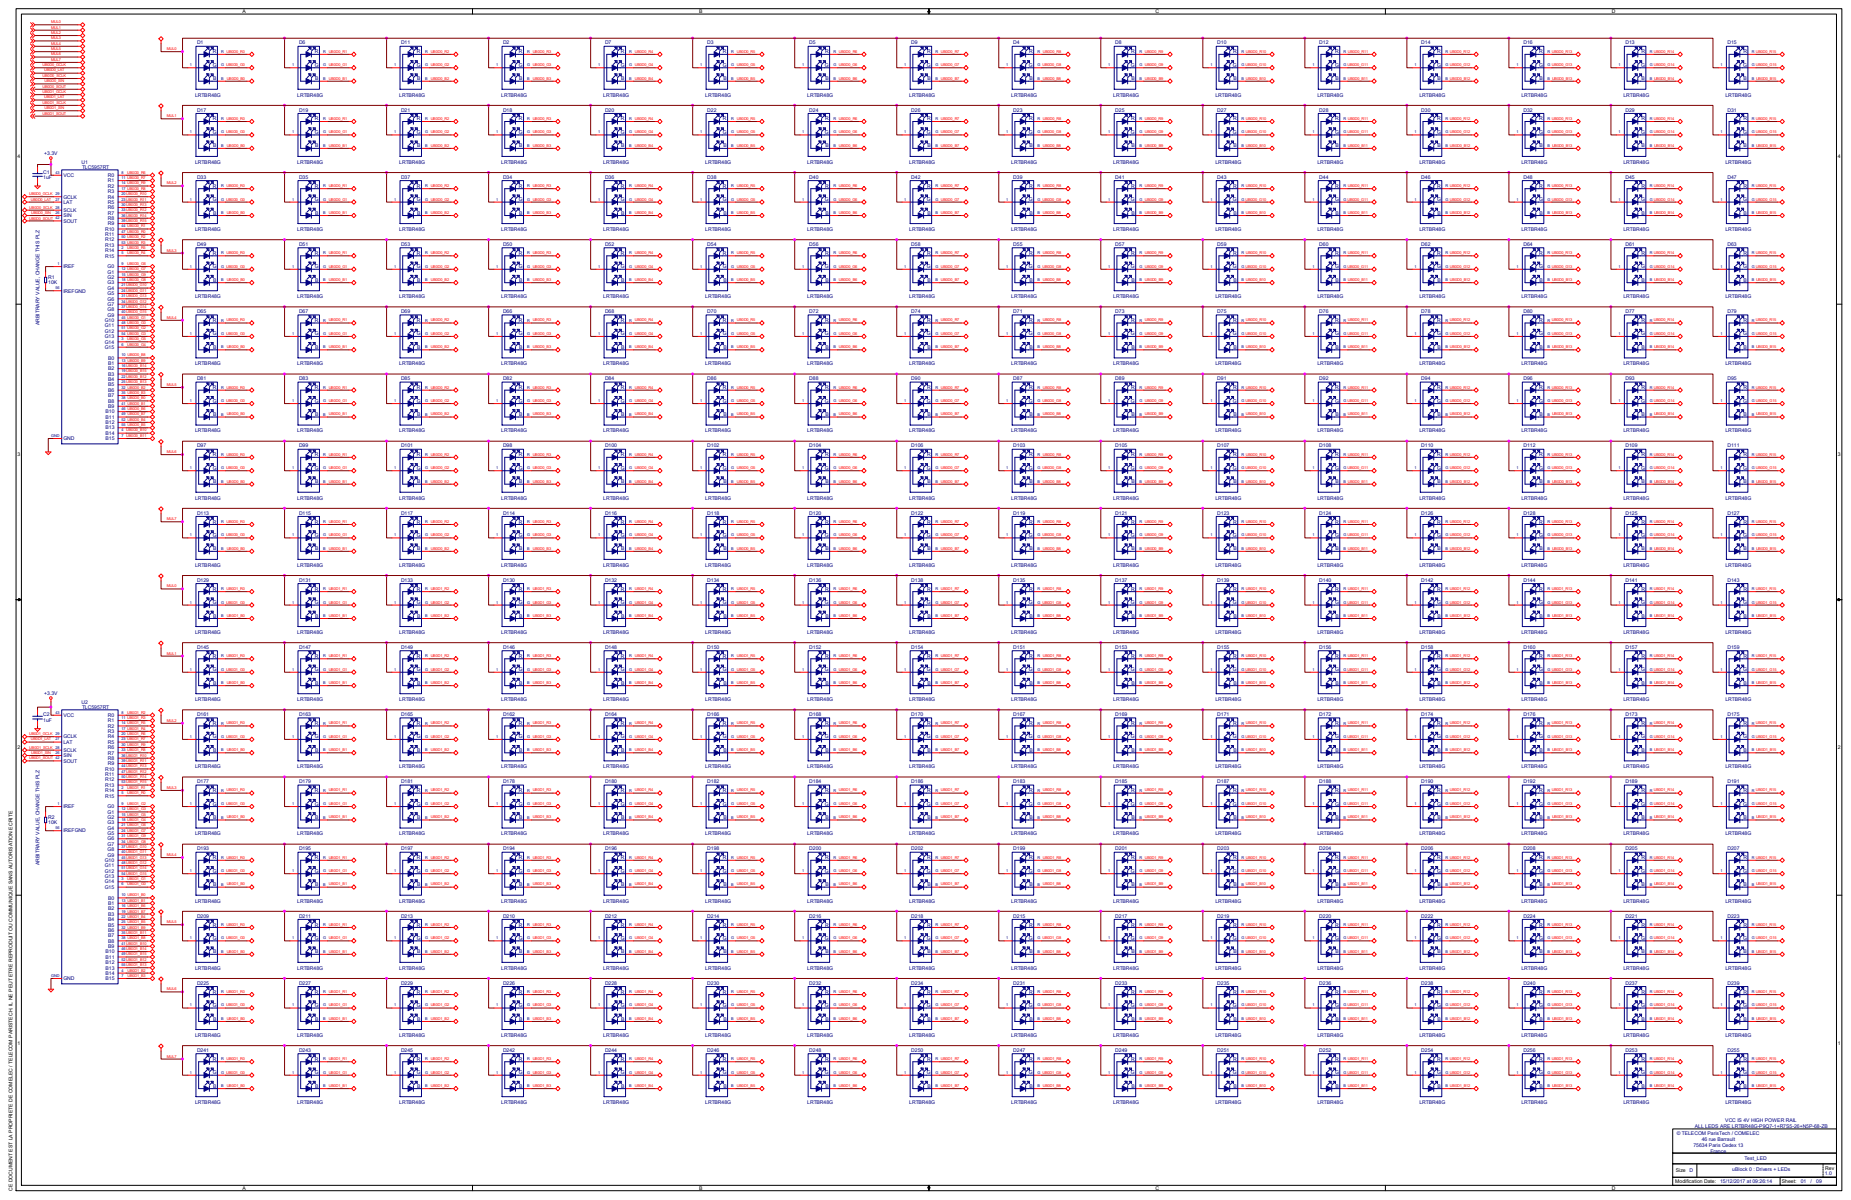
[picture p73: page 1]

VCC IS 4V HIGH POWER RAIL ALL LEDS ARE LRTBR48G-P9Q7-1+R7S5-26+N5P-68-ZB RG

uBlock 0 : Drivers + LEDs © TELECOM ParisTech / COMELEC
46 rue Barrault 75634 Paris Cedex 13 France

# MUL0 MUL1 MUL2 MUL3 MUL4 MUL5 MUL6 MUL7 UB0D2_GCLK UB0D2_LAT UB0D2_SCLK UB0D2_SIN

UB1D2_SOUT UB0D2_R1 UB0D2_R15 UB0D2_R2 UB0D2_R0 UB0D2_R5 UB0D2_R3 UB0D2_R6 UB0D2_R4 UB0D2_R9 UB0D2_R7 UB0D2_R10 UB0D2_R8 UB0D2_R13 UB0D2_R11 UB0D2_R14 UB0D2_R12 UB0D2_B13 UB0D2_B12 UB0D2_B3 UB0D2_B2 UB0D2_B1 UB0D2_B0 UB0D2_B7 UB0D2_B6 UB0D2_B5 UB0D2_B4 UB0D2_B11 UB0D2_B9 UB0D2_B10 UB0D2_B8 UB0D2_B15 UB0D2_B14 UB0D2_G1 UB0D2_G15 UB0D2_G2 UB0D2_G0 UB0D2_G5 UB0D2_G3 UB0D2_G6 UB0D2_G4 UB0D2_G9 UB0D2_G7 UB0D2_G10 UB0D2_G8 UB0D2_G13 UB0D2_G11 UB0D2_G14 UB0D2_G12

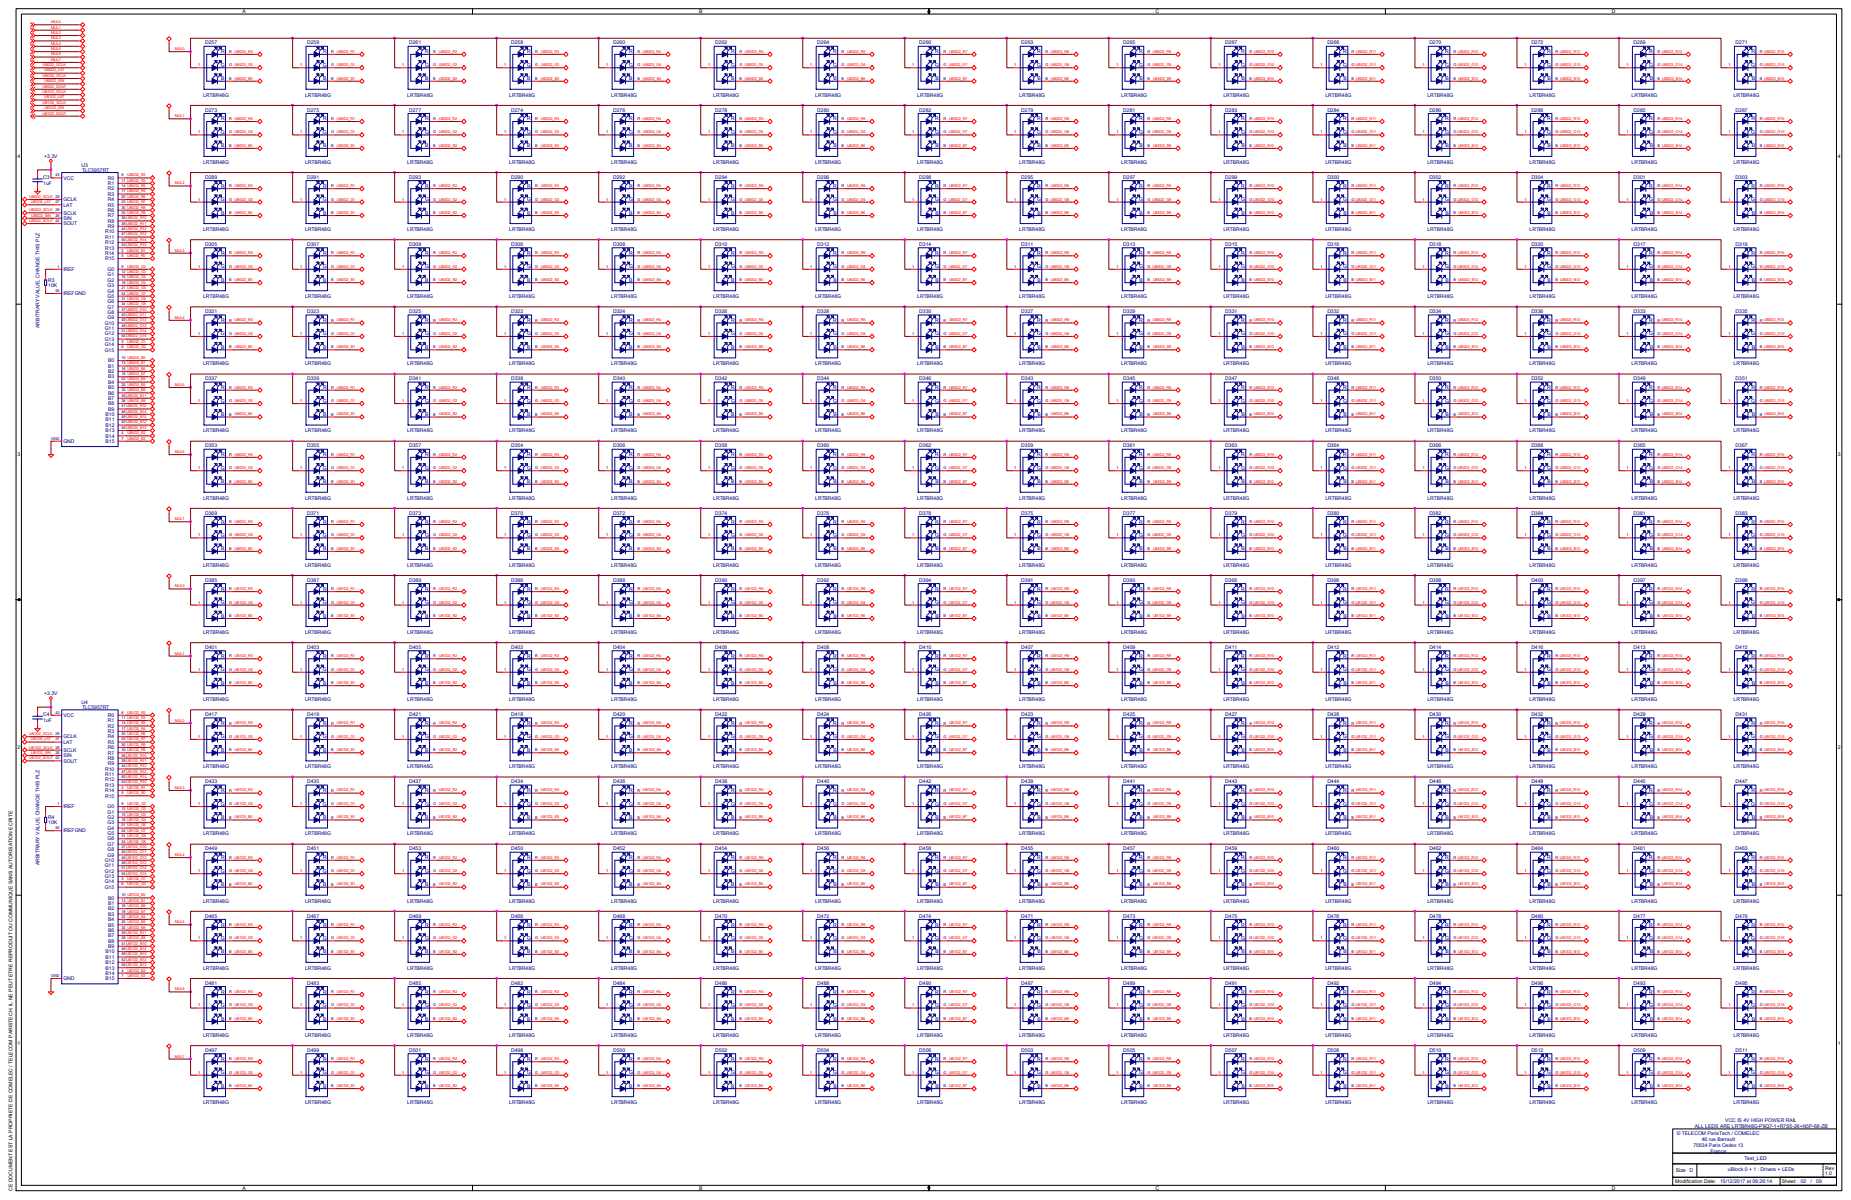
[picture p74: page 2]

1 VCC IS 4V HIGH POWER RAIL ALL LEDS ARE LRTBR48G-P9Q7-1+R7S5-26+N5P-68-ZB RG

uBlock 0 + 1 : Drivers + LEDs © TELECOM ParisTech / COMELEC

# MUL0 MUL1 MUL2 MUL3 MUL4 MUL5 MUL6 MUL7 UB1D0_GCLK UB1D0_LAT UB1D0_SCLK UB1D0_SIN

UB1D1_SOUT UB1D0_B13 UB1D0_B12 UB1D0_B3 UB1D0_B2 UB1D0_B1 UB1D0_B0 UB1D0_B7 UB1D0_B6 UB1D0_B5 UB1D0_B4 UB1D0_B11 UB1D0_B10 UB1D0_B9 UB1D0_B8 UB1D0_B15 UB1D0_B14 UB1D0_R1 UB1D0_R15 UB1D0_R2 UB1D0_R0 UB1D0_R5 UB1D0_R3 UB1D0_R6 UB1D0_R4 UB1D0_R9 UB1D0_R7 UB1D0_R10 UB1D0_R8 UB1D0_R13 UB1D0_R11 UB1D0_R14 UB1D0_R12 UB1D0_G1 UB1D0_G15 UB1D0_G2 UB1D0_G0 UB1D0_G5 UB1D0_G3 UB1D0_G6 UB1D0_G4 UB1D0_G9 UB1D0_G7 UB1D0_G10 UB1D0_G8 UB1D0_G13 UB1D0_G11 UB1D0_G14 UB1D0_G12

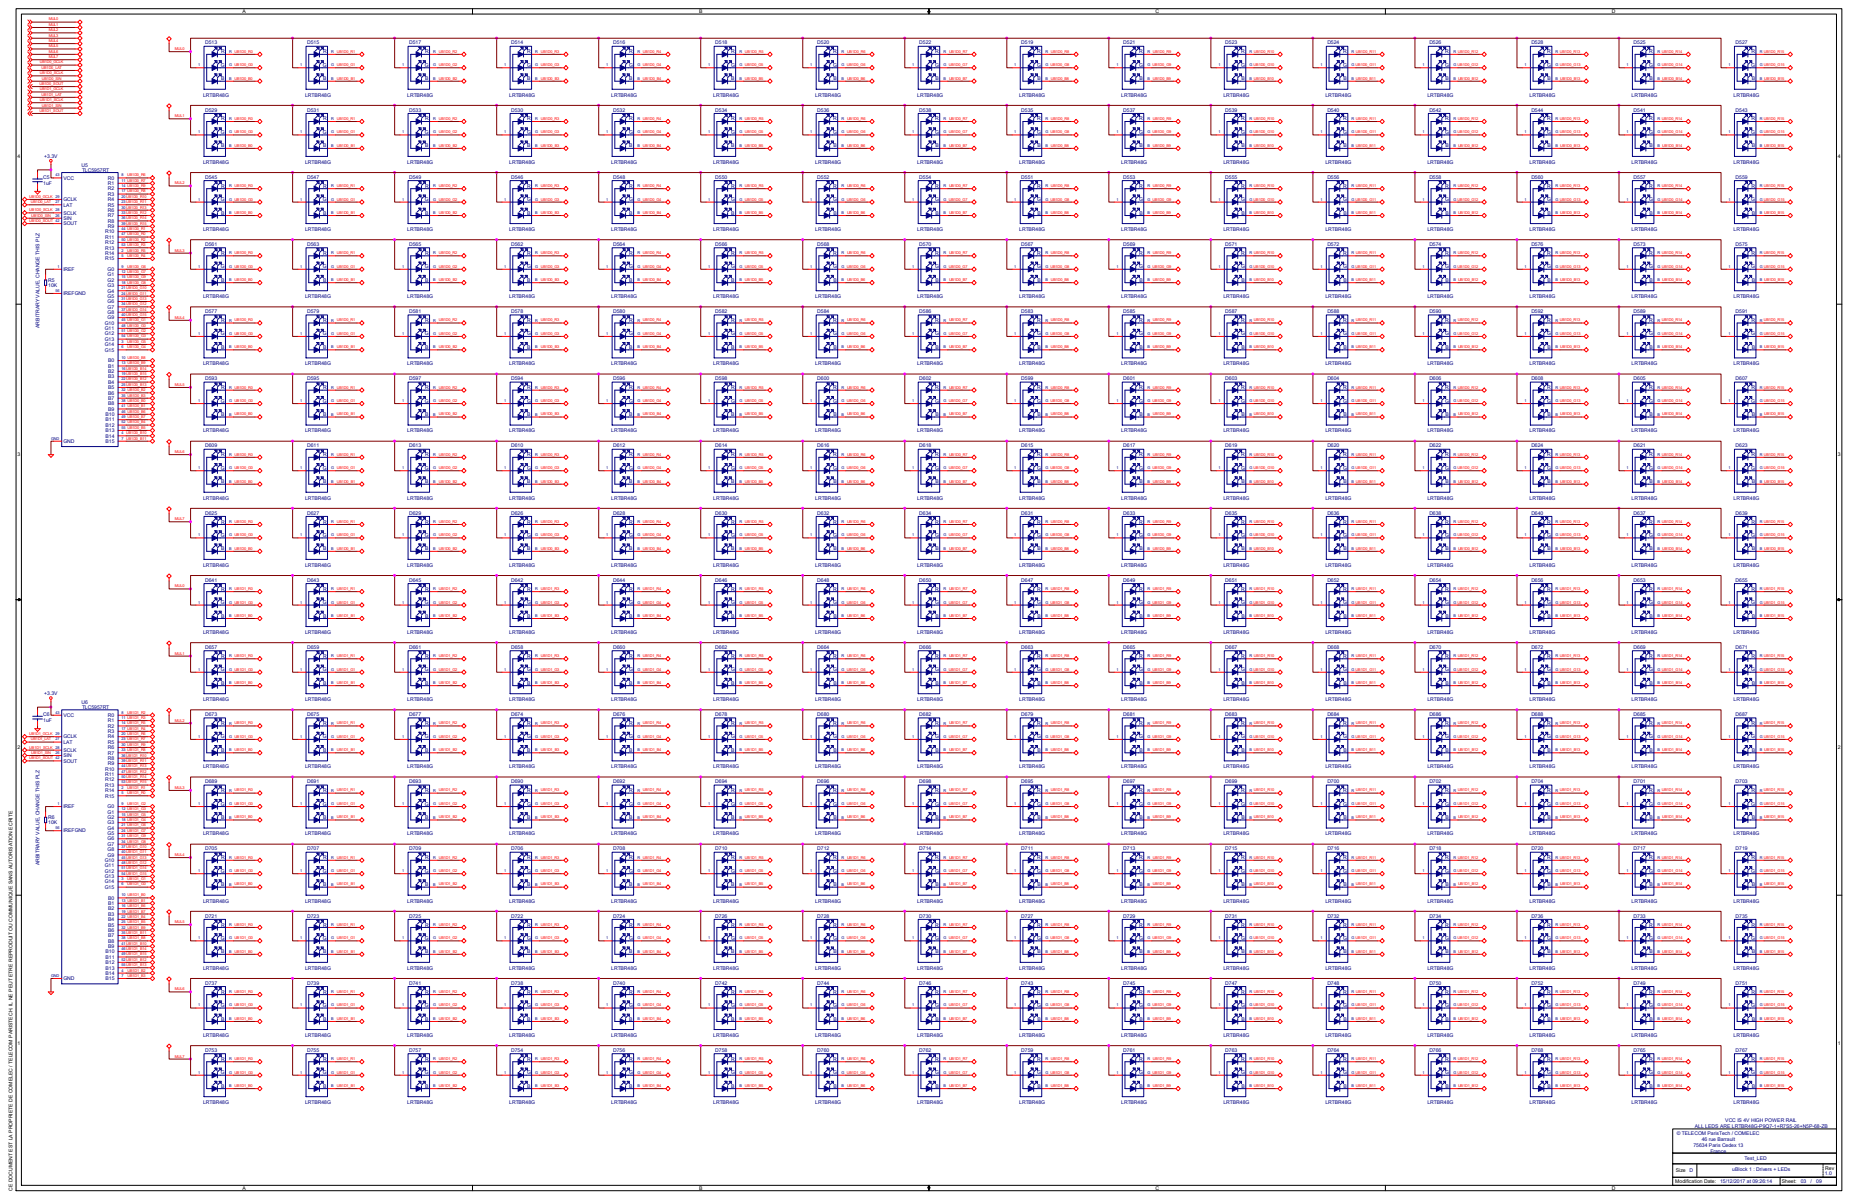
[picture p75: page 3]
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

uBlock 1 : Drivers + LEDs © TELECOM ParisTech / COMELEC

# MUL0 MUL1 MUL2 MUL3 MUL4 MUL5 MUL6 MUL7 UB2D0_GCLK UB2D0_LAT UB2D0_SCLK UB2D0_SIN

UB2D1_SOUT UB2D0_B13 UB2D0_B12 UB2D0_B3 UB2D0_B2 UB2D0_B1 UB2D0_B0 UB2D0_B7 UB2D0_B6 UB2D0_B5 UB2D0_B4 UB2D0_B11 UB2D0_B10 UB2D0_B9 UB2D0_B8 UB2D0_B15 UB2D0_B14 UB2D0_R1 UB2D0_R15 UB2D0_R2 UB2D0_R0 UB2D0_R5 UB2D0_R3 UB2D0_R6 UB2D0_R4 UB2D0_R9 UB2D0_R7 UB2D0_R10 UB2D0_R8 UB2D0_R13 UB2D0_R11 UB2D0_R14 UB2D0_R12 UB2D0_G1 UB2D0_G15 UB2D0_G2 UB2D0_G0 UB2D0_G5 UB2D0_G3 UB2D0_G6 UB2D0_G4 UB2D0_G9 UB2D0_G7 UB2D0_G10 UB2D0_G8 UB2D0_G13 UB2D0_G11 UB2D0_G14 UB2D0_G12

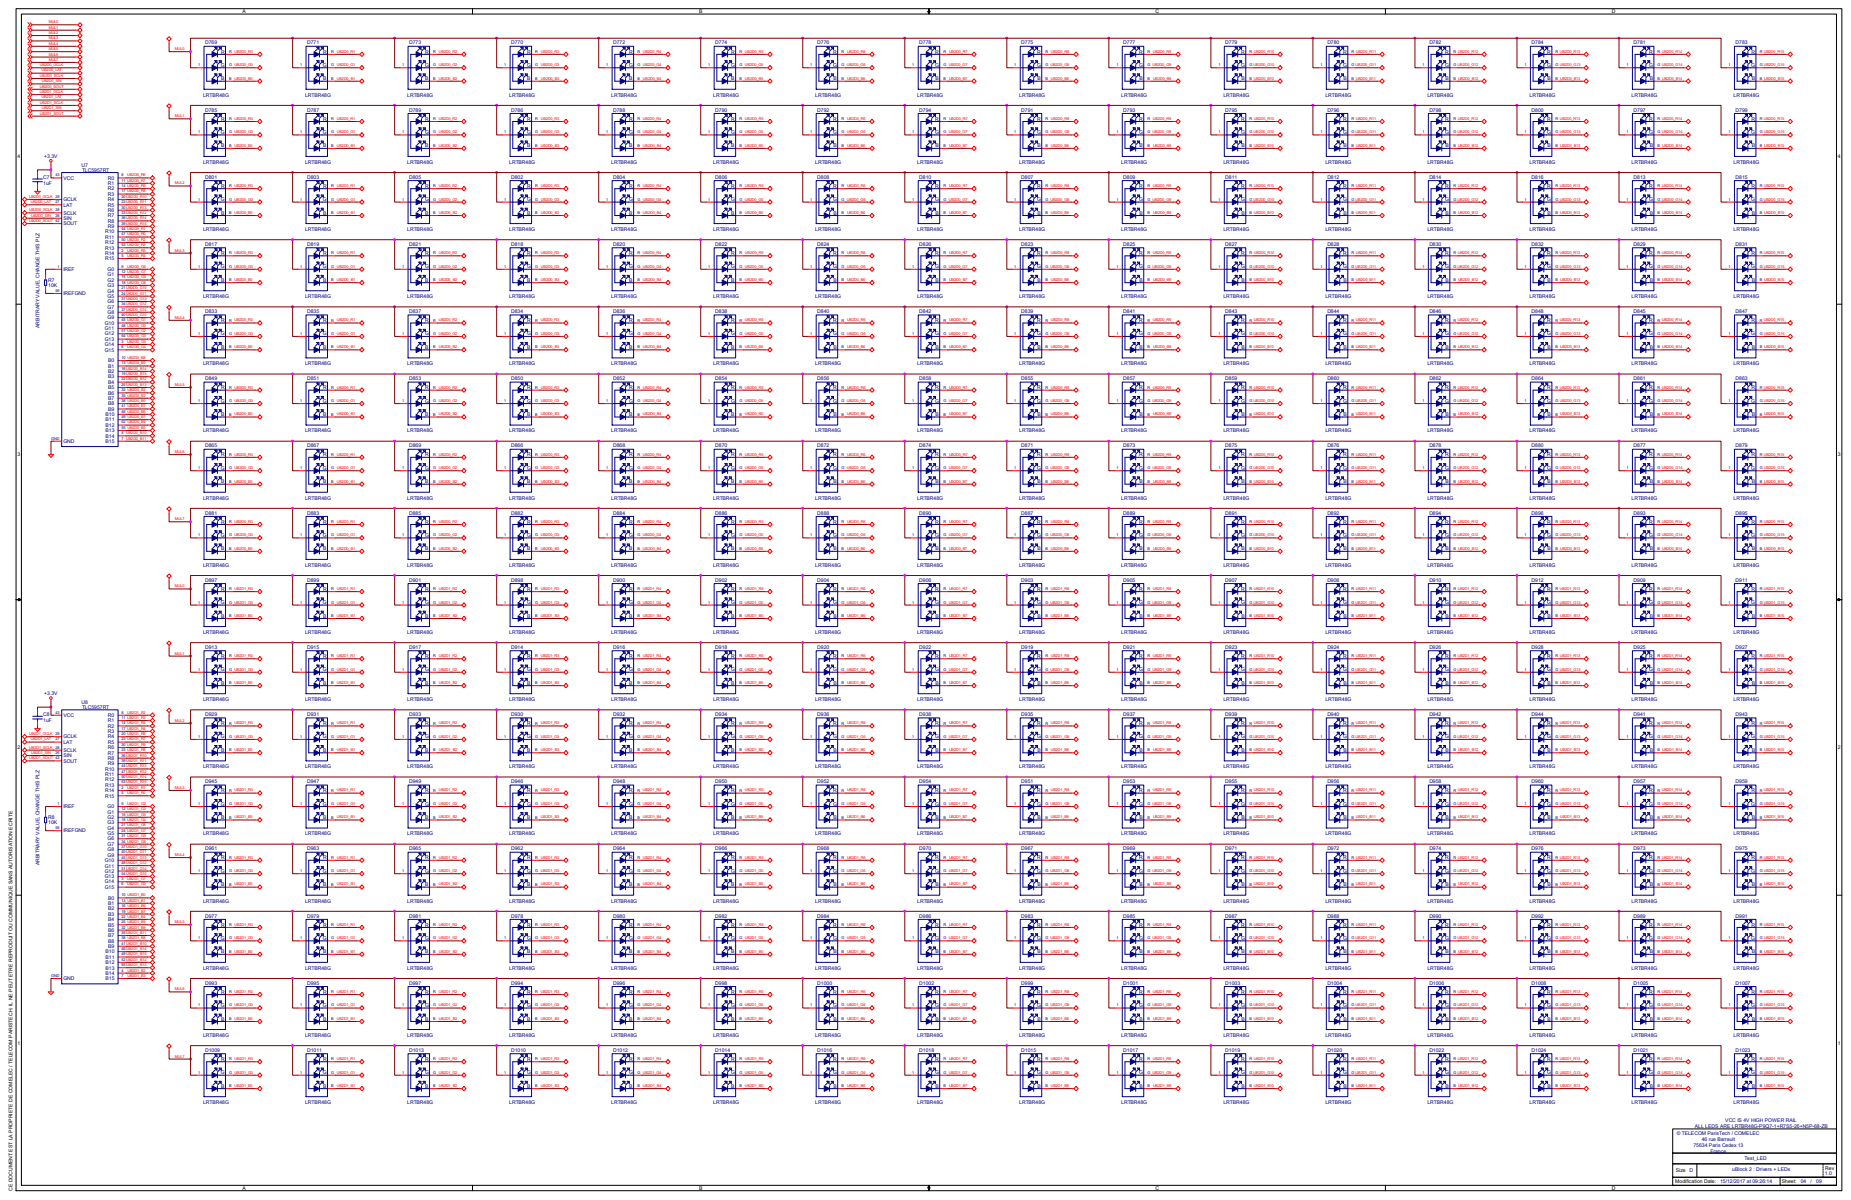
[picture p76: page 4]
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

uBlock 2 : Drivers + LEDs © TELECOM ParisTech / COMELEC

# MUL0 MUL1 MUL2 MUL3 MUL4 MUL5 MUL6 MUL7 UB2D2_GCLK UB2D2_LAT UB2D2_SCLK UB2D2_SIN

UB3D2_SOUT UB2D2_R1 UB2D2_R15 UB2D2_R2 UB2D2_R0 UB2D2_R5 UB2D2_R3 UB2D2_R6 UB2D2_R4 UB2D2_R9 UB2D2_R7 UB2D2_R10 UB2D2_R8 UB2D2_R13 UB2D2_R11 UB2D2_R14 UB2D2_R12 UB2D2_B13 UB2D2_B12 UB2D2_B3 UB2D2_B2 UB2D2_B1 UB2D2_B0 UB2D2_B7 UB2D2_B6 UB2D2_B5 UB2D2_B4 UB2D2_B11 UB2D2_B9 UB2D2_B10 UB2D2_B8 UB2D2_B15 UB2D2_B14 UB2D2_G1 UB2D2_G15 UB2D2_G2 UB2D2_G0 UB2D2_G5 UB2D2_G3 UB2D2_G6 UB2D2_G4 UB2D2_G9 UB2D2_G7 UB2D2_G10 UB2D2_G8 UB2D2_G13 UB2D2_G11 UB2D2_G14 UB2D2_G12

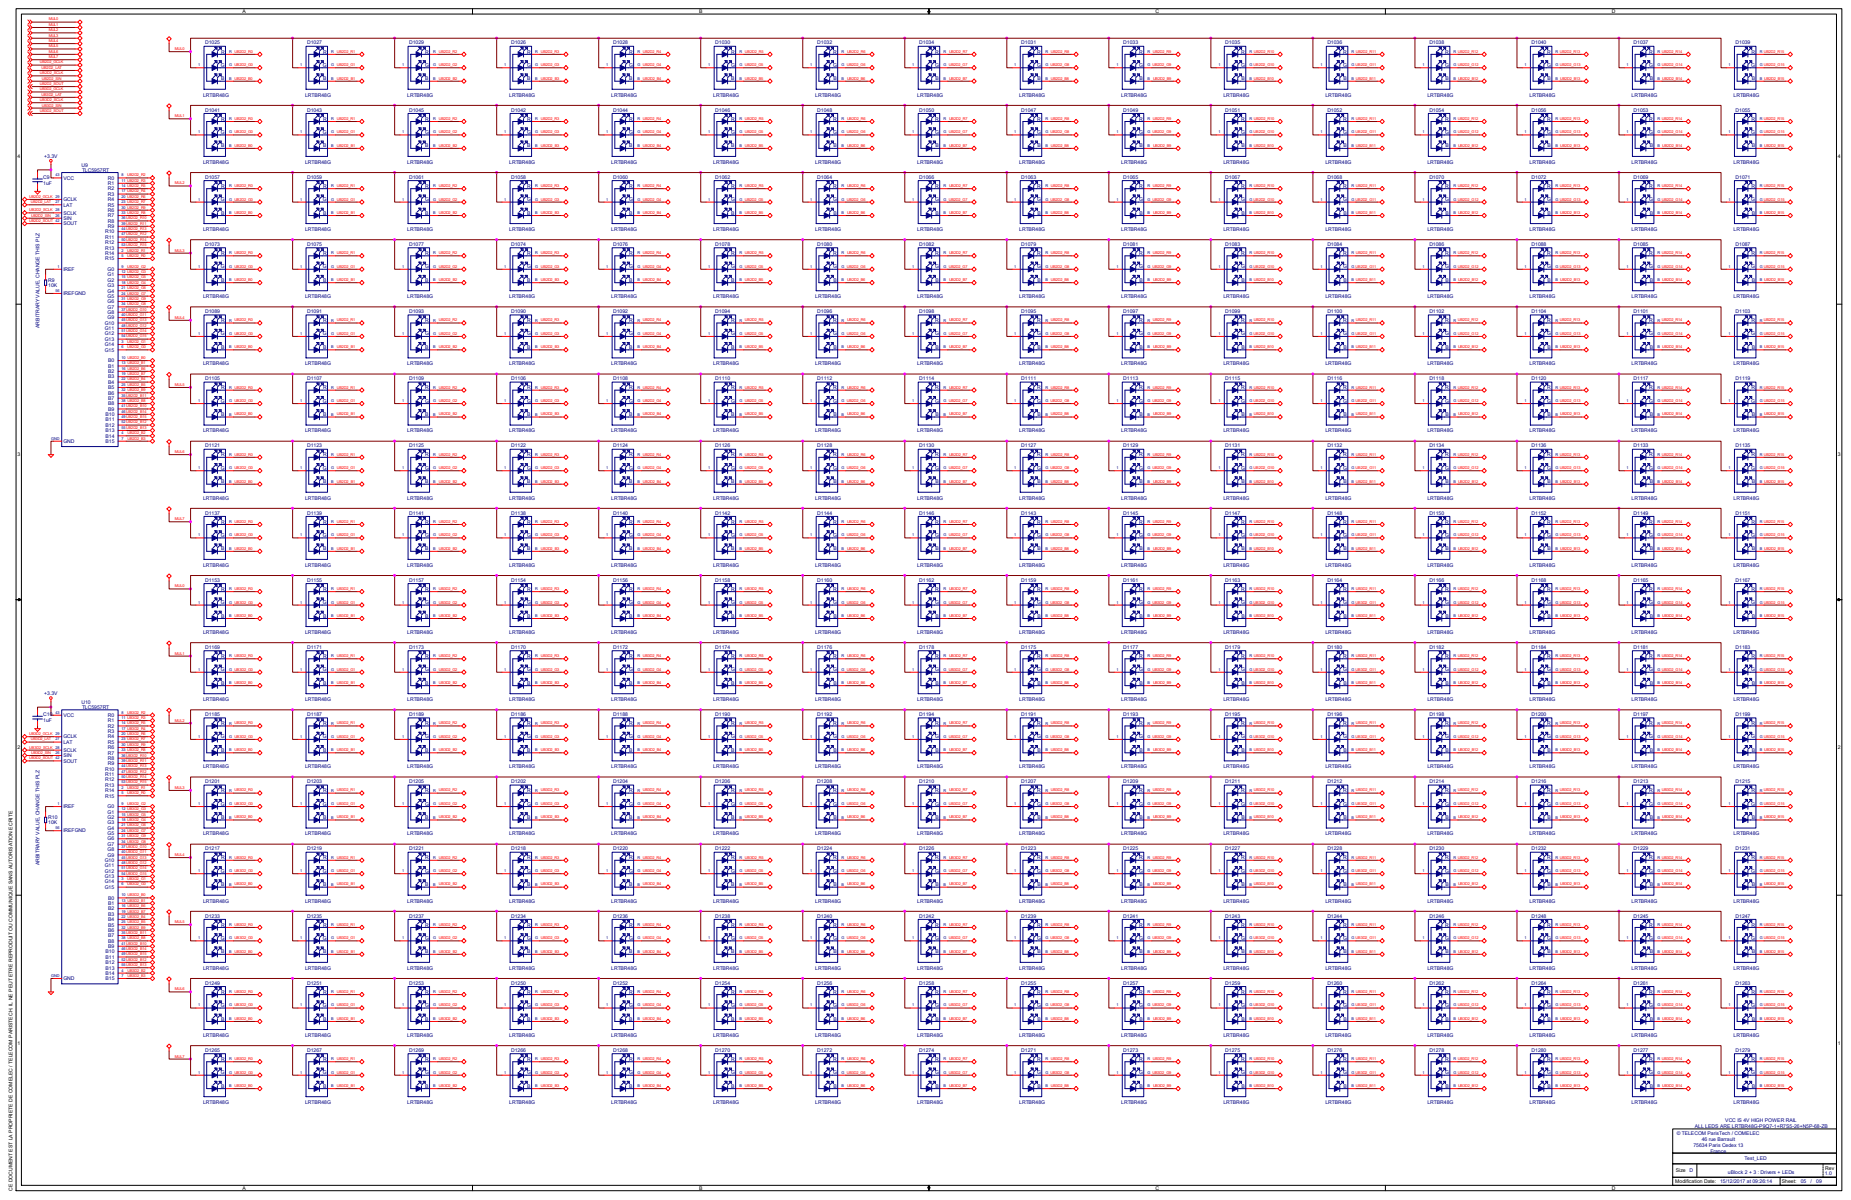
[picture p77: page 5]

10K ARBITRARY VALUE, CHANGE THIS PLZ C10

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

uBlock 2 + 3 : Drivers + LEDs © TELECOM ParisTech / COMELEC

# MUL0 MUL1 MUL2 MUL3 MUL4 MUL5 MUL6 MUL7 UB3D0_GCLK UB3D0_LAT UB3D0_SCLK UB3D0_SIN

UB3D1_SOUT UB3D0_B13 UB3D0_B12 UB3D0_B3 UB3D0_B2 UB3D0_B1 UB3D0_B0 UB3D0_B7 UB3D0_B6 UB3D0_B5 UB3D0_B4 UB3D0_B11 UB3D0_B10 UB3D0_B9 UB3D0_B8 UB3D0_B15 UB3D0_B14 UB3D0_R1 UB3D0_R15 UB3D0_R2 UB3D0_R0 UB3D0_R5 UB3D0_R3 UB3D0_R6 UB3D0_R4 UB3D0_R9 UB3D0_R7 UB3D0_R10 UB3D0_R8 UB3D0_R13 UB3D0_R11 UB3D0_R14 UB3D0_R12 UB3D0_G1 UB3D0_G15 UB3D0_G2 UB3D0_G0 UB3D0_G5 UB3D0_G3 UB3D0_G6 UB3D0_G4 UB3D0_G9 UB3D0_G7 UB3D0_G10 UB3D0_G8 UB3D0_G13 UB3D0_G11 UB3D0_G14 UB3D0_G12

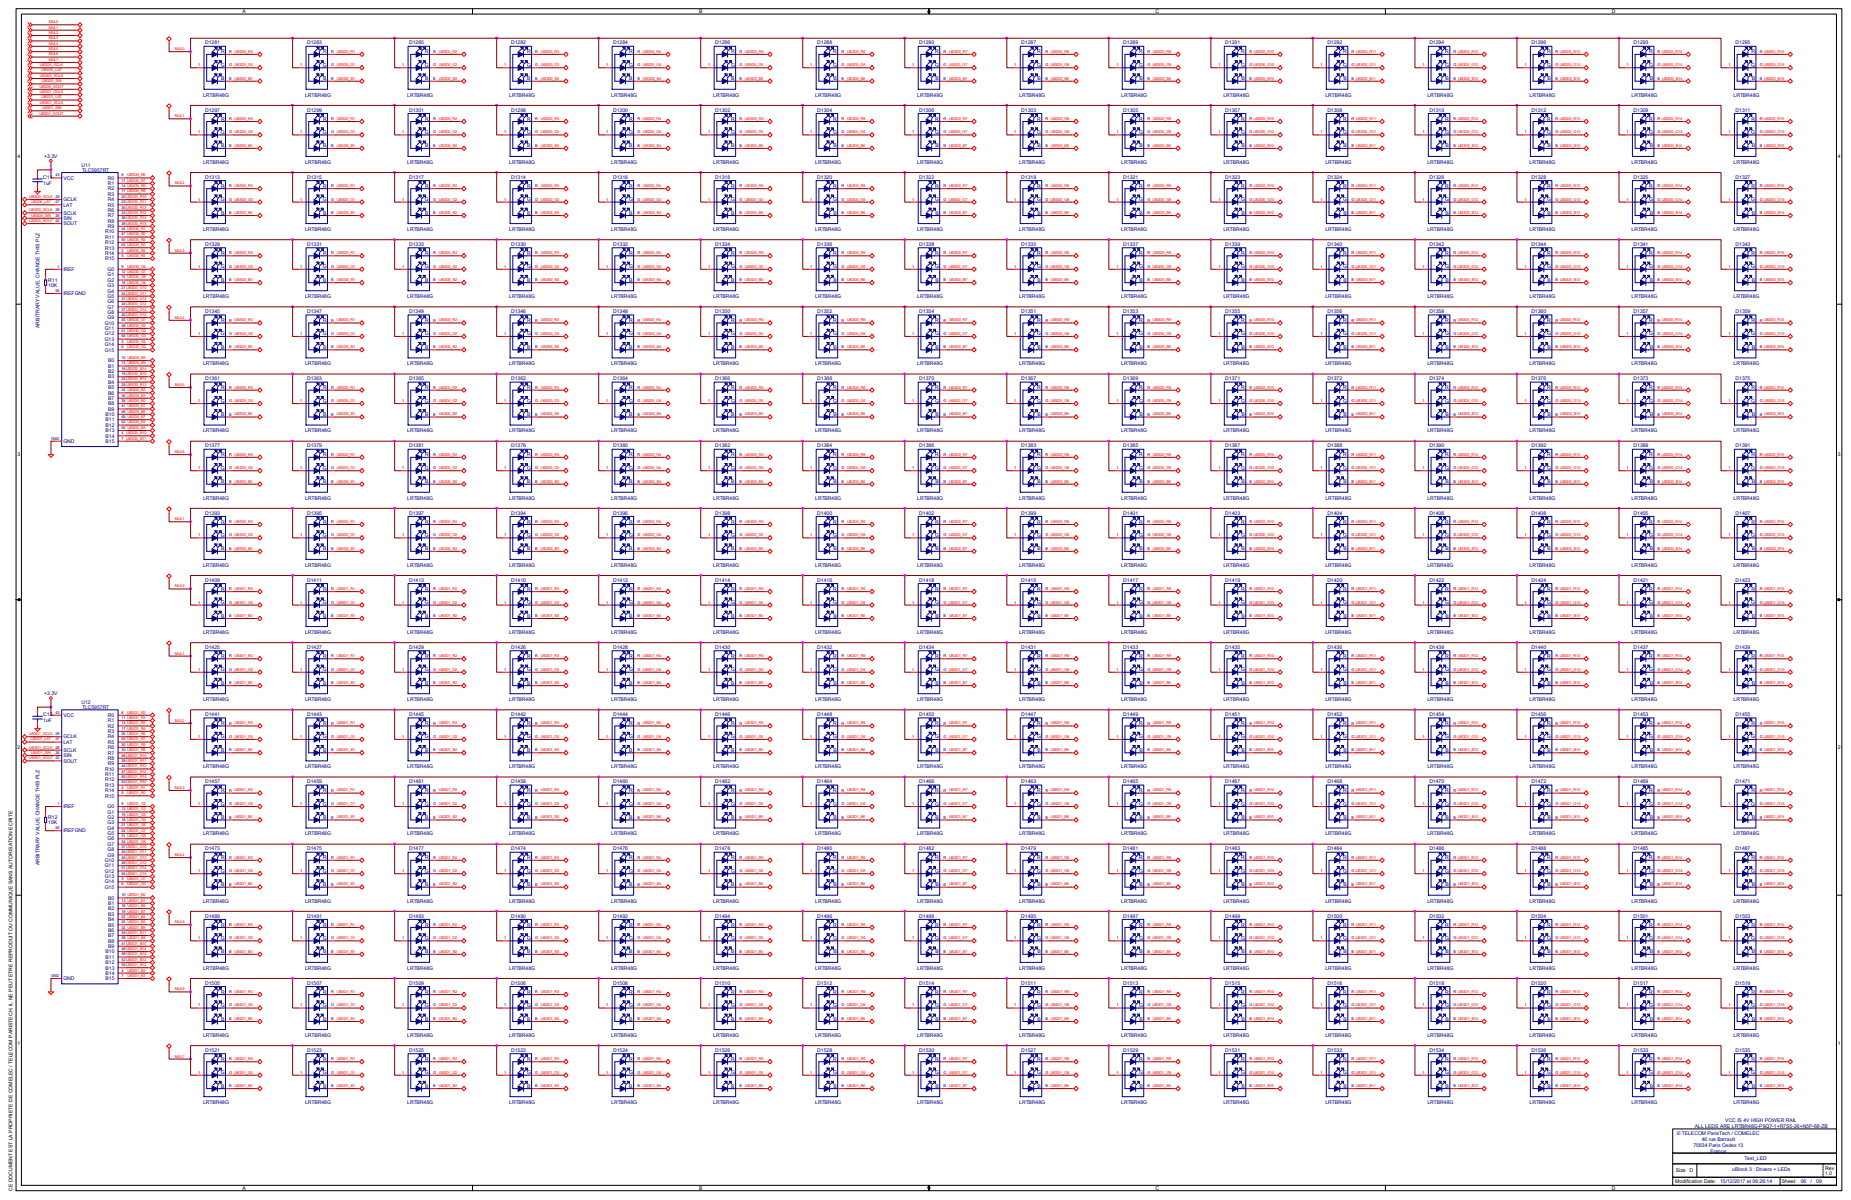
[picture p78: page 6]
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

uBlock 3 : Drivers + LEDs © TELECOM ParisTech / COMELEC

# MUL0 MUL1 MUL2 MUL3 MUL4 MUL5 MUL6 MUL7 UB4D0_GCLK UB4D0_LAT UB4D0_SCLK UB4D0_SIN

UB4D1_SOUT UB4D0_B13 UB4D0_B12 UB4D0_B3 UB4D0_B2 UB4D0_B1 UB4D0_B0 UB4D0_B7 UB4D0_B6 UB4D0_B5 UB4D0_B4 UB4D0_B11 UB4D0_B10 UB4D0_B9 UB4D0_B8 UB4D0_B15 UB4D0_B14 UB4D0_R1 UB4D0_R15 UB4D0_R2 UB4D0_R0 UB4D0_R5 UB4D0_R3 UB4D0_R6 UB4D0_R4 UB4D0_R9 UB4D0_R7 UB4D0_R10 UB4D0_R8 UB4D0_R13 UB4D0_R11 UB4D0_R14 UB4D0_R12 UB4D0_G1 UB4D0_G15 UB4D0_G2 UB4D0_G0 UB4D0_G5 UB4D0_G3 UB4D0_G6 UB4D0_G4 UB4D0_G9 UB4D0_G7 UB4D0_G10 UB4D0_G8 UB4D0_G13 UB4D0_G11 UB4D0_G14 UB4D0_G12

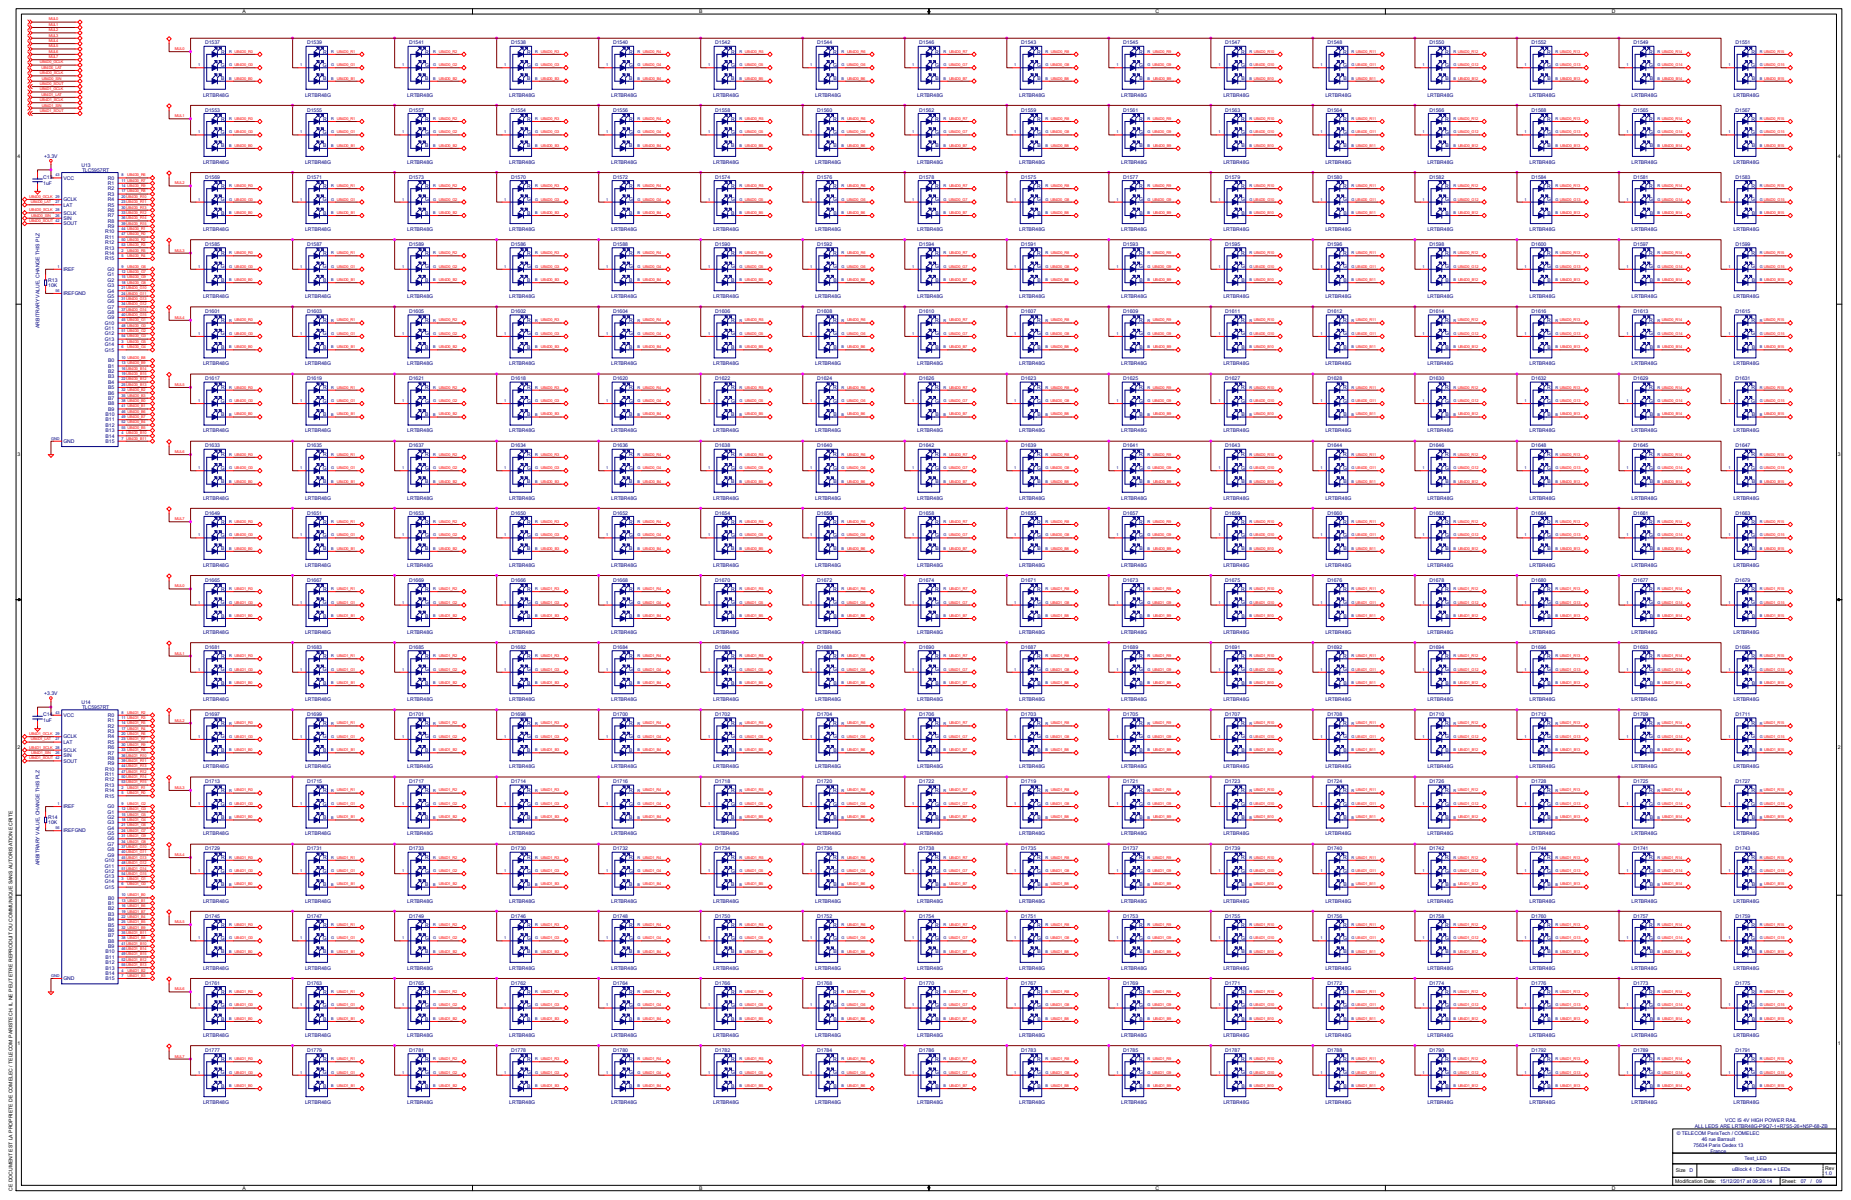
[picture p79: page 7]
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

uBlock 4 : Drivers + LEDs © TELECOM ParisTech / COMELEC

UB4D2_SOUTMUL0 MUL1 MUL2 MUL3 MUL4 MUL5 MUL6 MUL7 UB4D2_GCLK UB4D2_LAT UB4D2_SCLK UB4D2_SIN
UB4D2_SOUT UB4D2_R1 UB4D2_R15 UB4D2_R2 UB4D2_R0 UB4D2_R5 UB4D2_R3 UB4D2_R6 UB4D2_R4 UB4D2_R9 UB4D2_R7 UB4D2_R10 UB4D2_R8 UB4D2_R13 UB4D2_R11 UB4D2_R14 UB4D2_R12 UB4D2_B13 UB4D2_B12 UB4D2_B3 UB4D2_B2 UB4D2_B1 UB4D2_B0 UB4D2_B7 UB4D2_B6 UB4D2_B5 UB4D2_B4 UB4D2_B11 UB4D2_B9 UB4D2_B10 UB4D2_B8 UB4D2_B15 UB4D2_B14 UB4D2_G1 UB4D2_G15 UB4D2_G2 UB4D2_G0 UB4D2_G5 UB4D2_G3 UB4D2_G6 UB4D2_G4 UB4D2_G9 UB4D2_G7 UB4D2_G10 UB4D2_G8 UB4D2_G13 UB4D2_G11 UB4D2_G14 UB4D2_G12

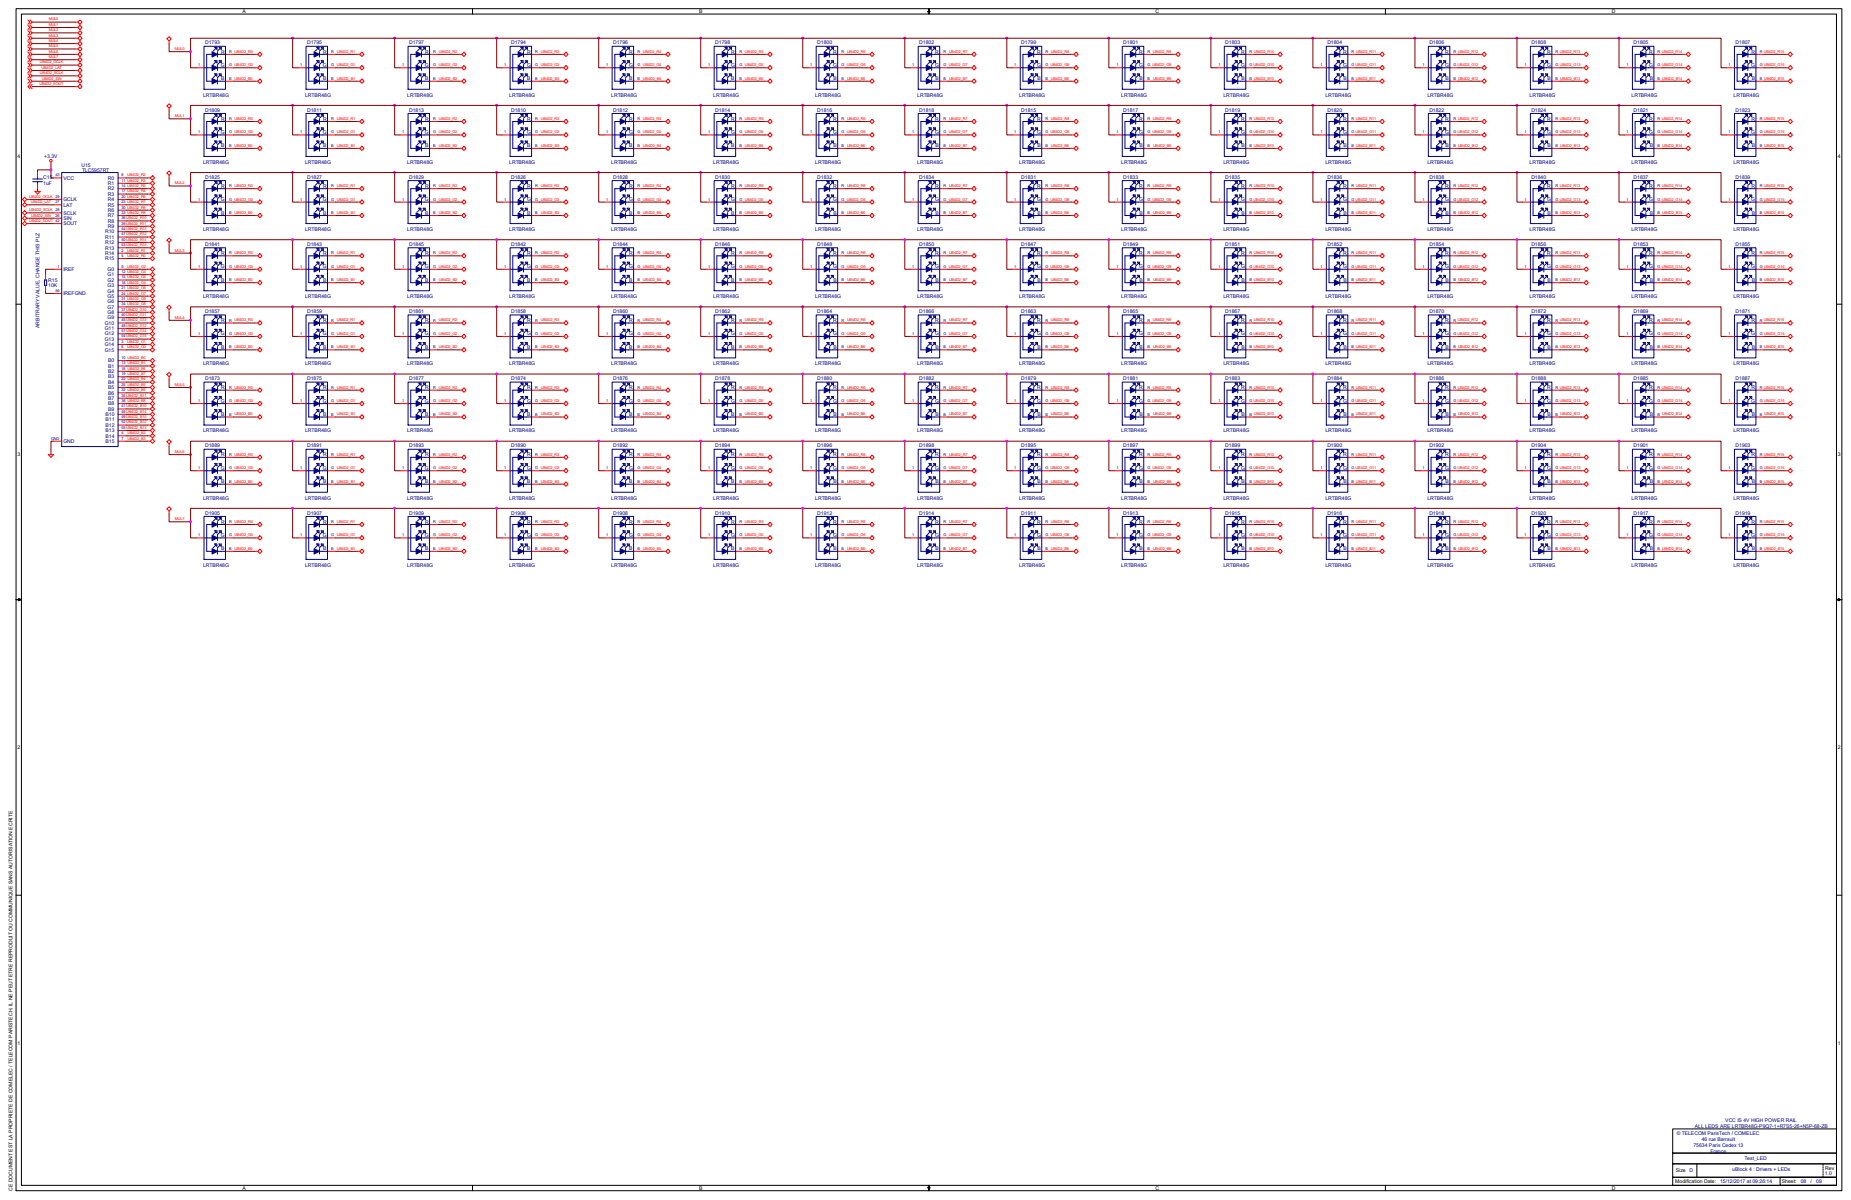
[picture p80: page 8]
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

uBlock 4 : Drivers + LEDs © TELECOM ParisTech / COMELEC

# MUL0 MUL1 MUL2 MUL3 MUL4 MUL5 MUL6 MUL7 UB1D0_GCLK UB1D0_LAT UB1D0_SCLK UB1D0_SIN

# UB0D0_GCLK UB0D0_LAT UB0D0_SCLK UB0D0_SIN

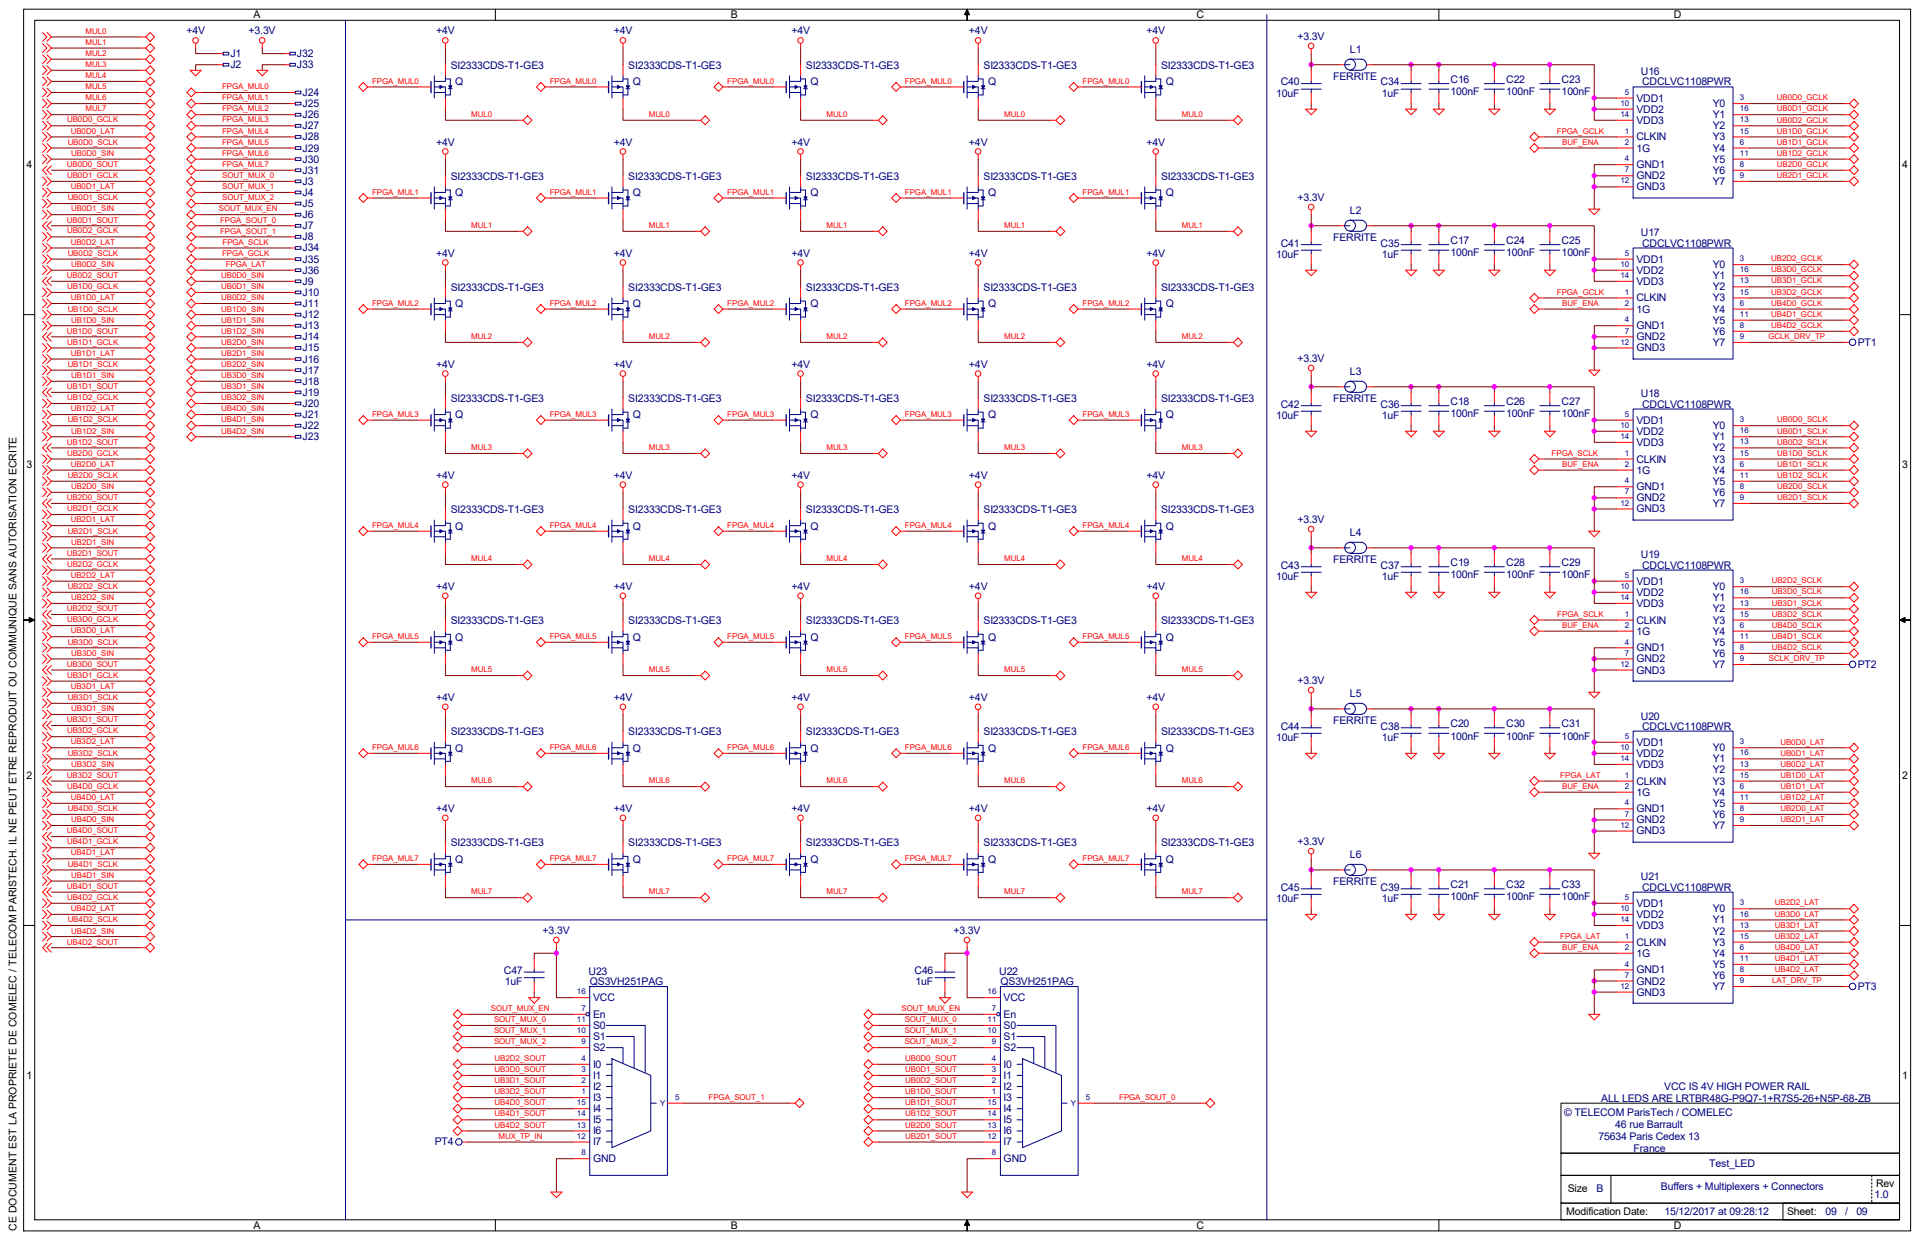
[picture p81: page 9]

1 1 CE DOCUMENT EST LA PROPRIETE DE COMELEC / TELECOM PARISTECH. IL NE PEUT ETRE REPRODUIT OU COMMUNIQUE SANS AUTORISATION ECRITE

ALL LEDS ARE LRTBR48G-P9Q7-1+R7S5-26+N5P-68-ZB
