friendshipismagic/SpiROSE/PCB/Rotative_base/Assembly/Assembly_Top.pdf

# PCB

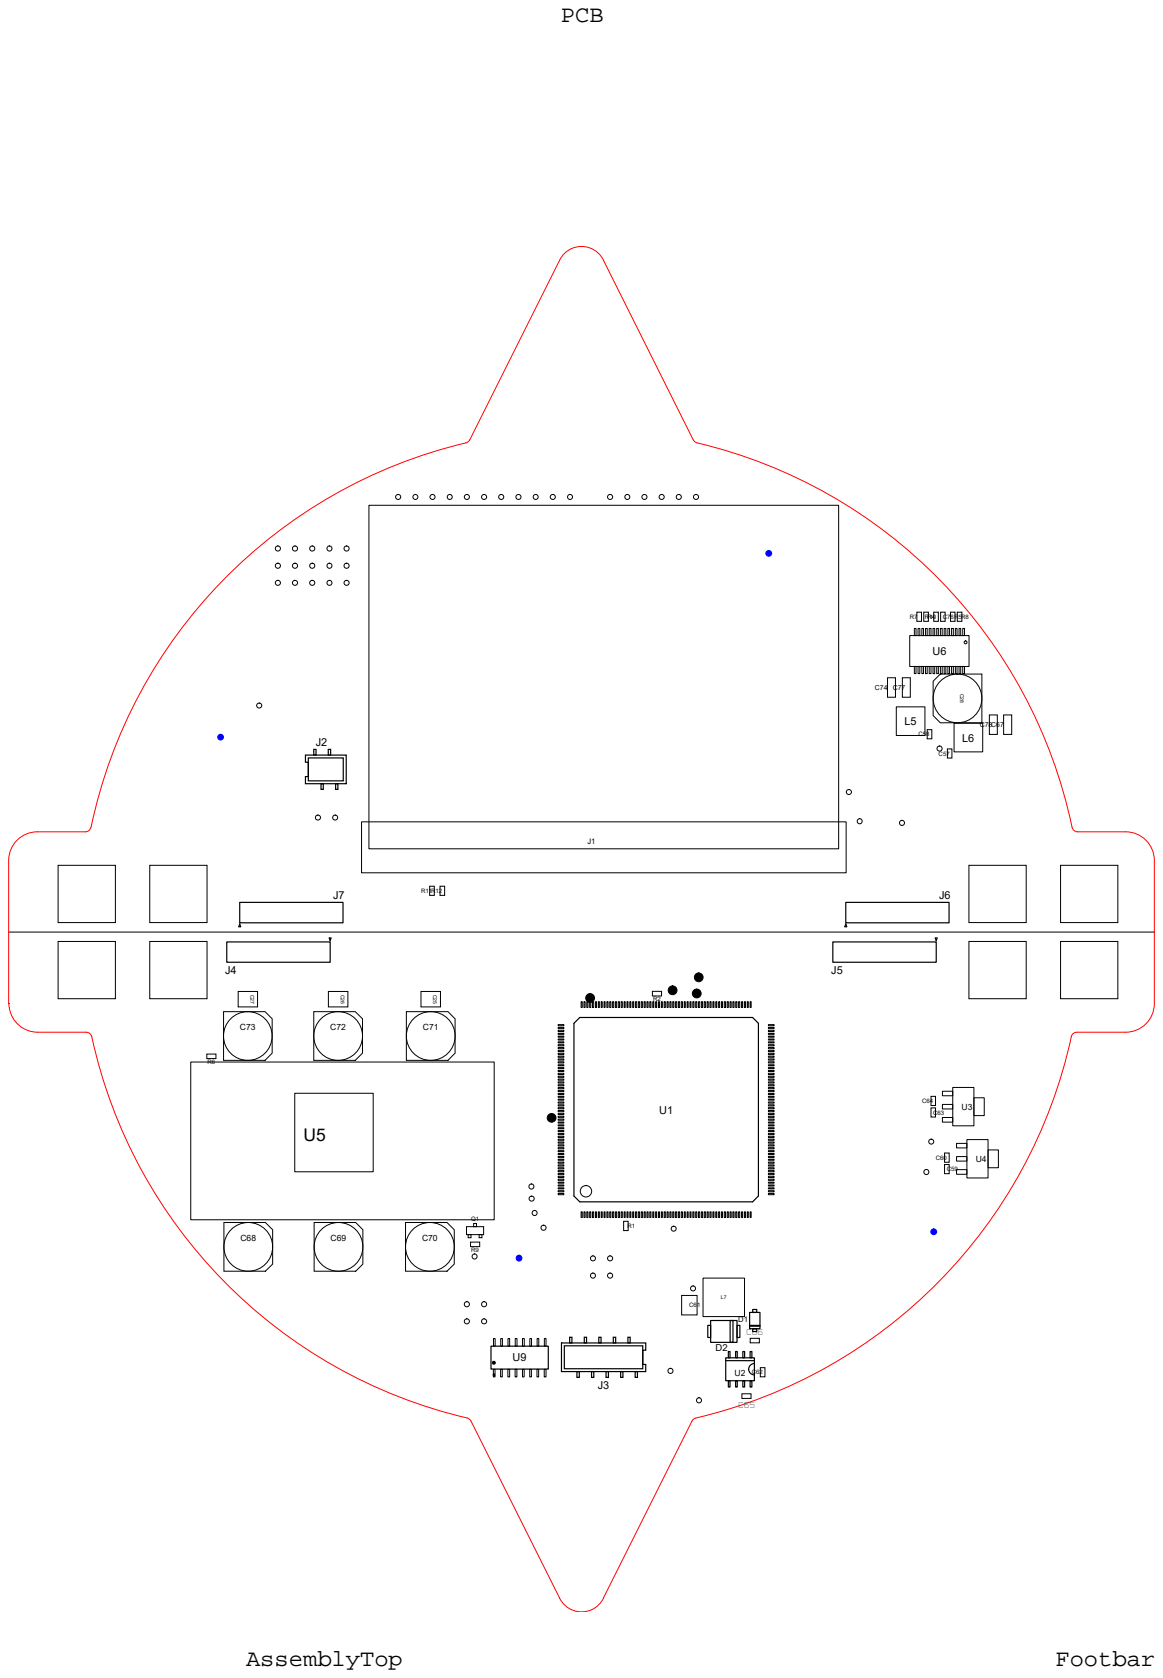
[picture p82: page 1]
