friendshipismagic/SpiROSE/PCB/Rotative_base/Assembly/PCB_Human.pdf

# PCB

# SpiROSE

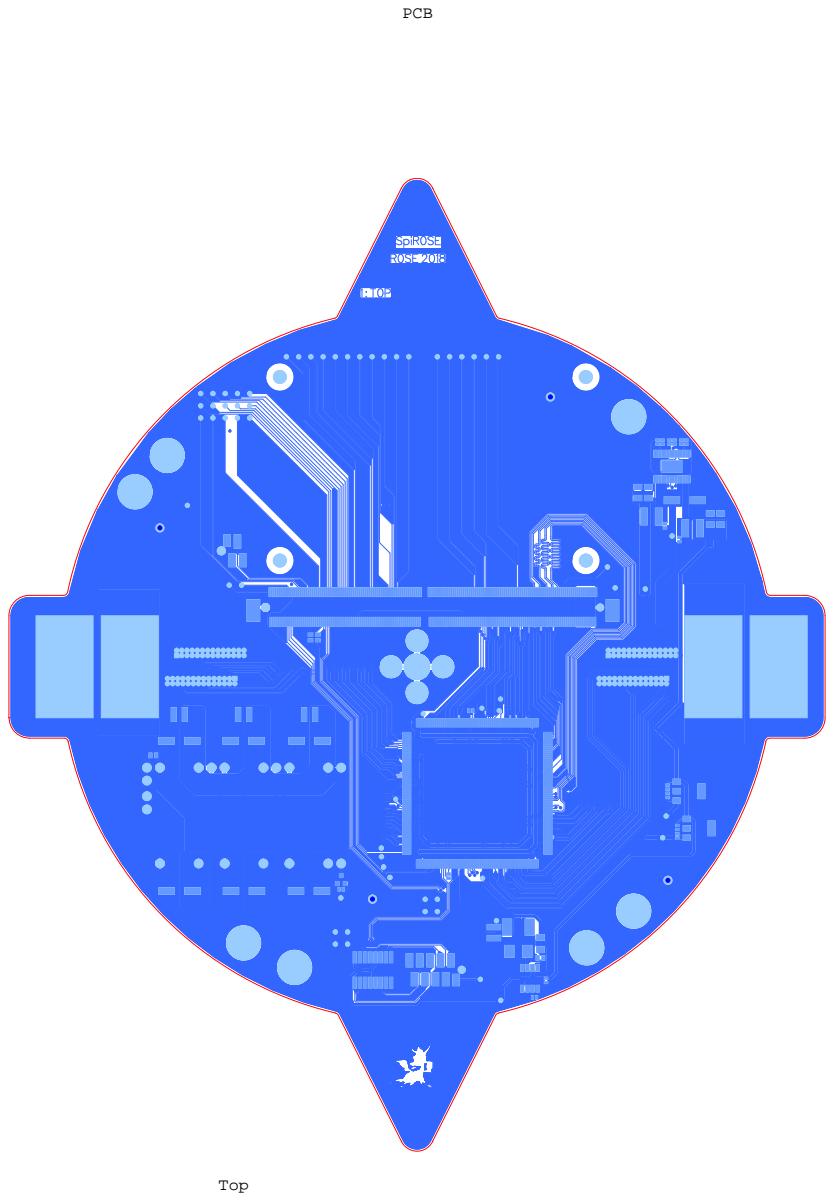
[picture p83: page 1]
Top; ROSE 2018; 1 : TOP

# PCB

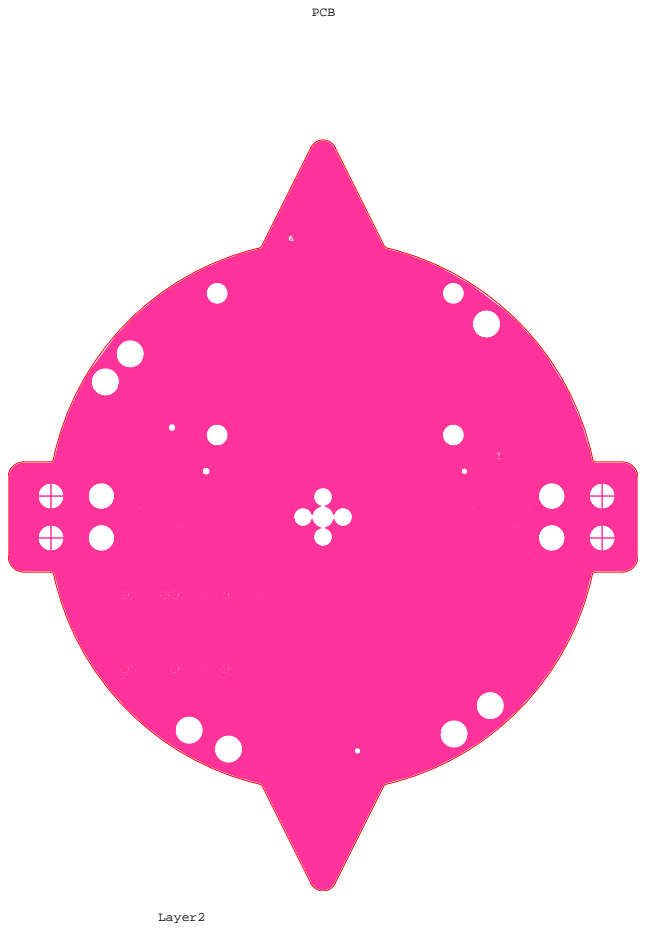
[picture p84: page 2]
Layer2

# PCB

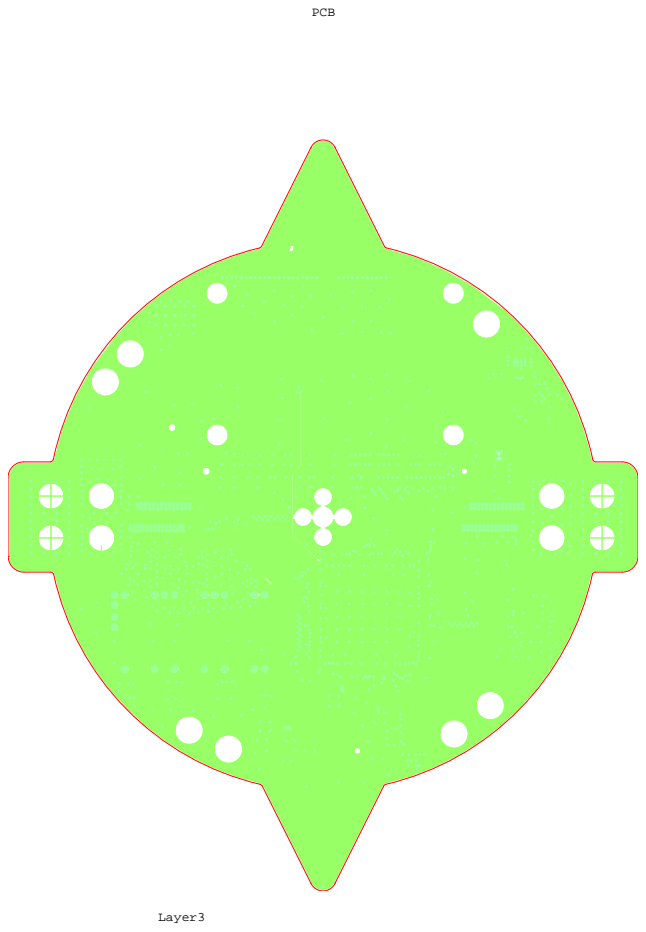
[picture p85: page 3]
Layer3

# PCB

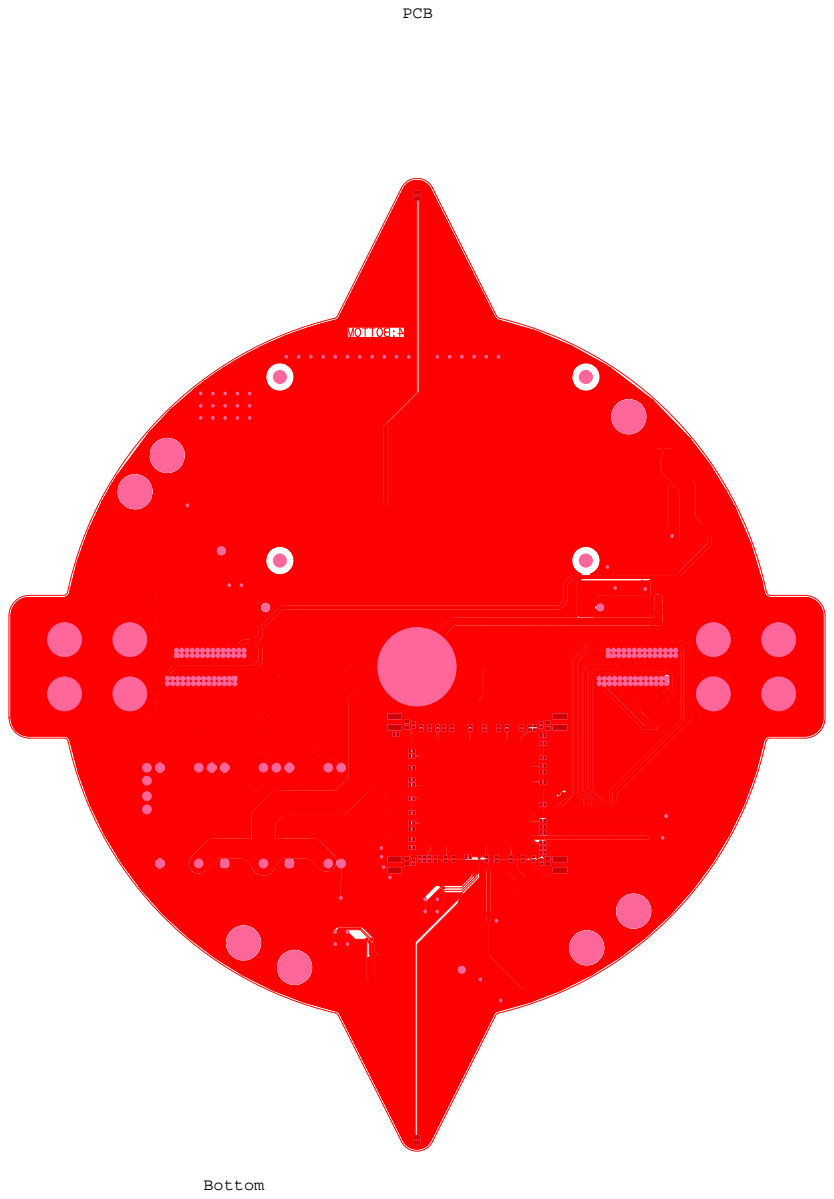
[picture p86: page 4]
Bottom; BOTTOM

# PCB

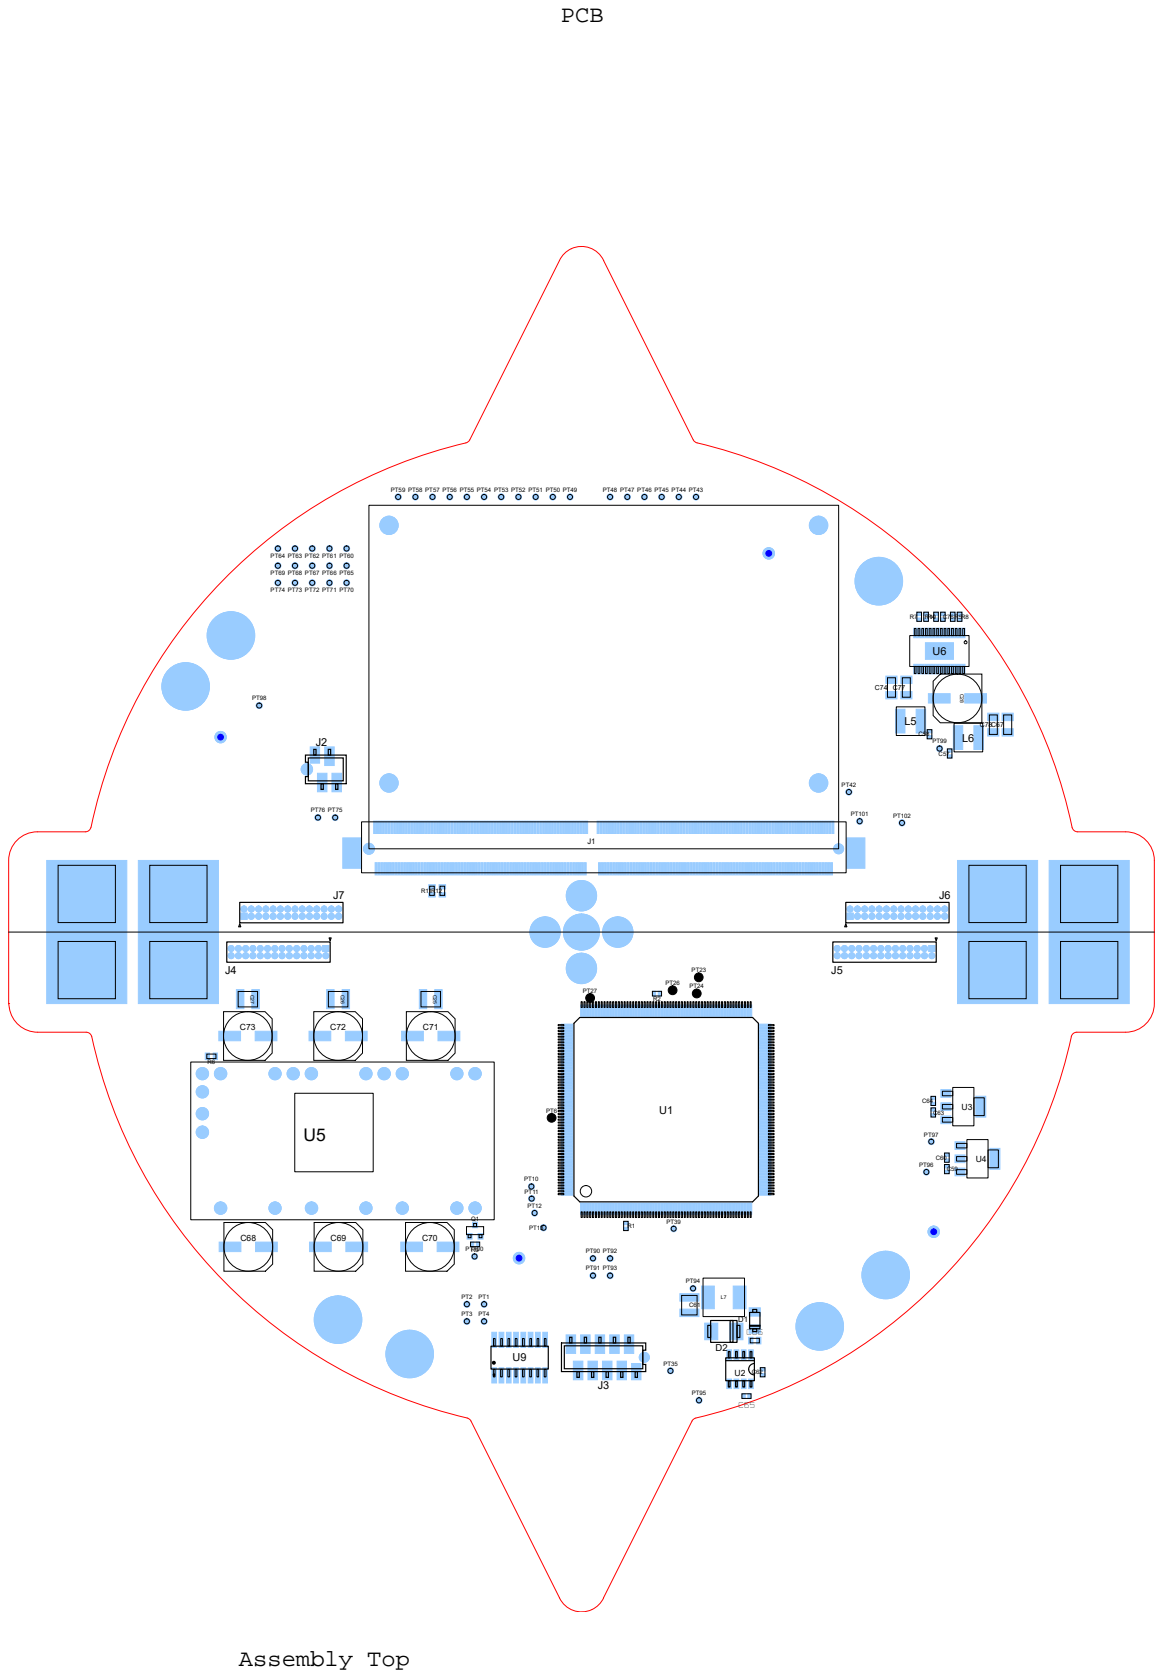
[picture p87: page 5]

# PCB

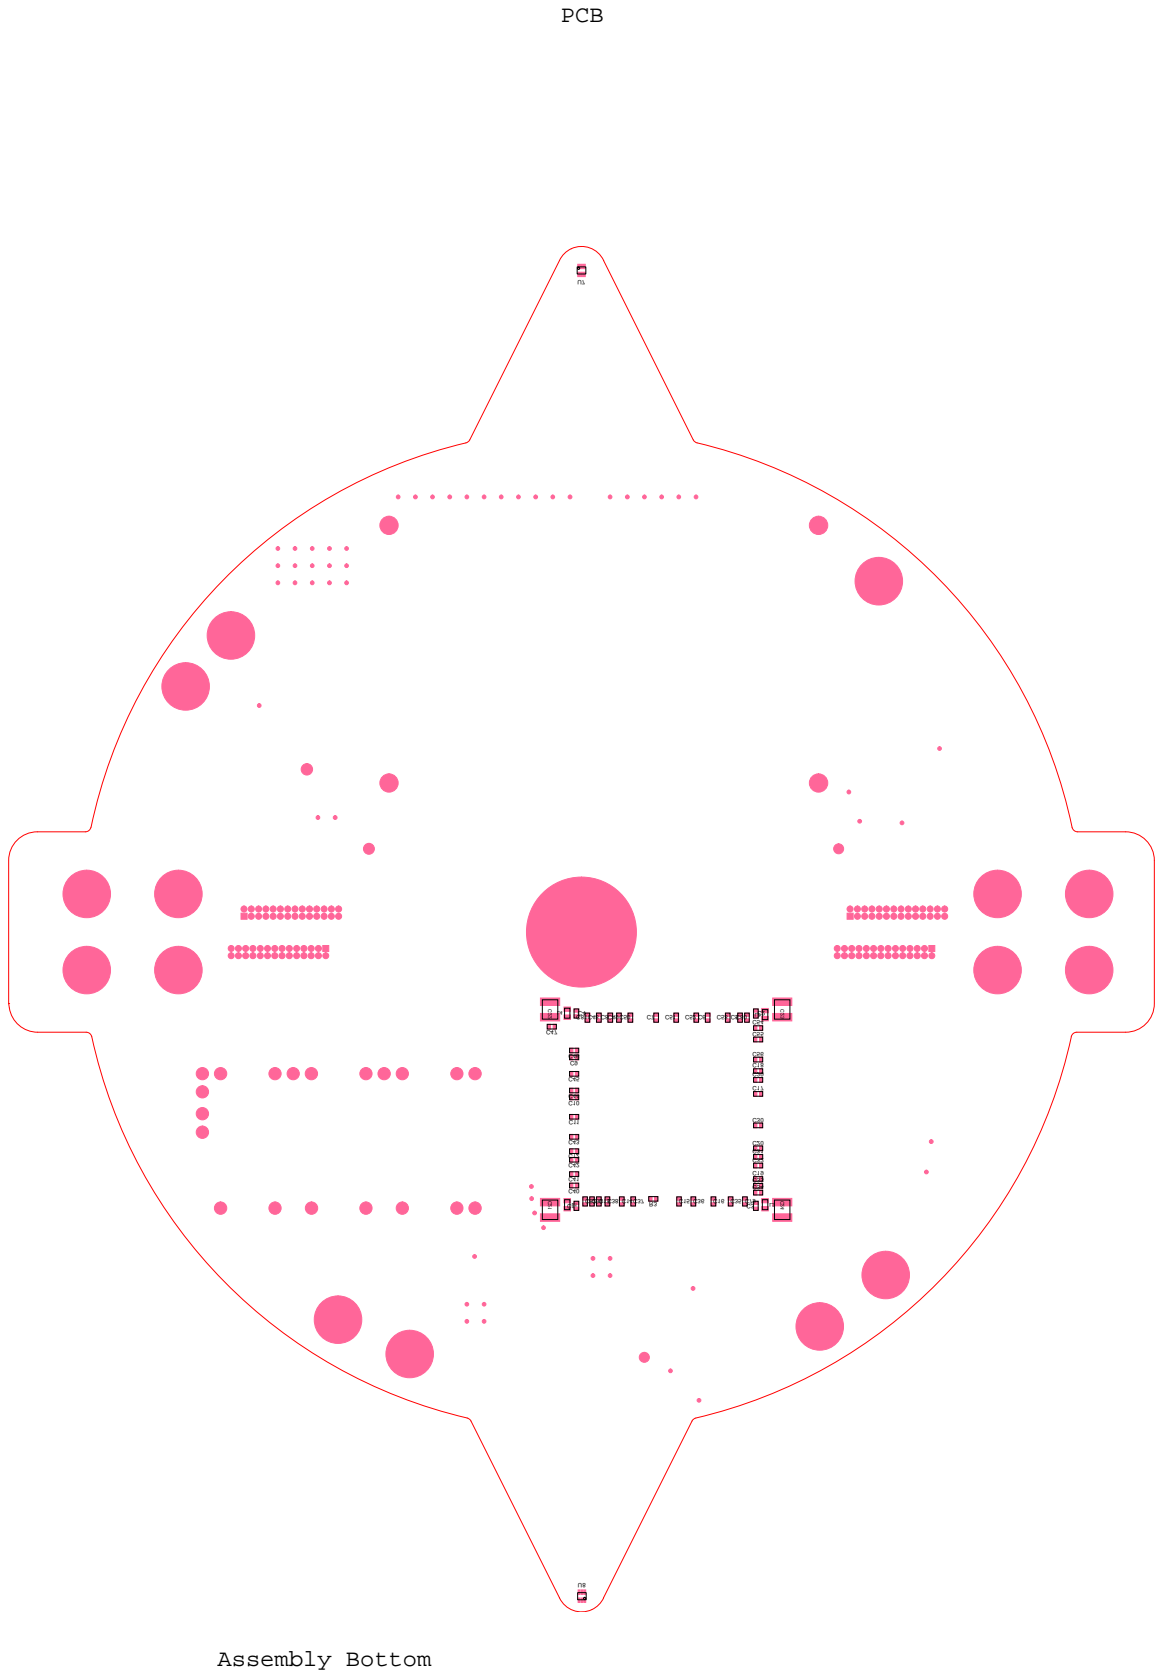
[picture p88: page 6]

# PCB

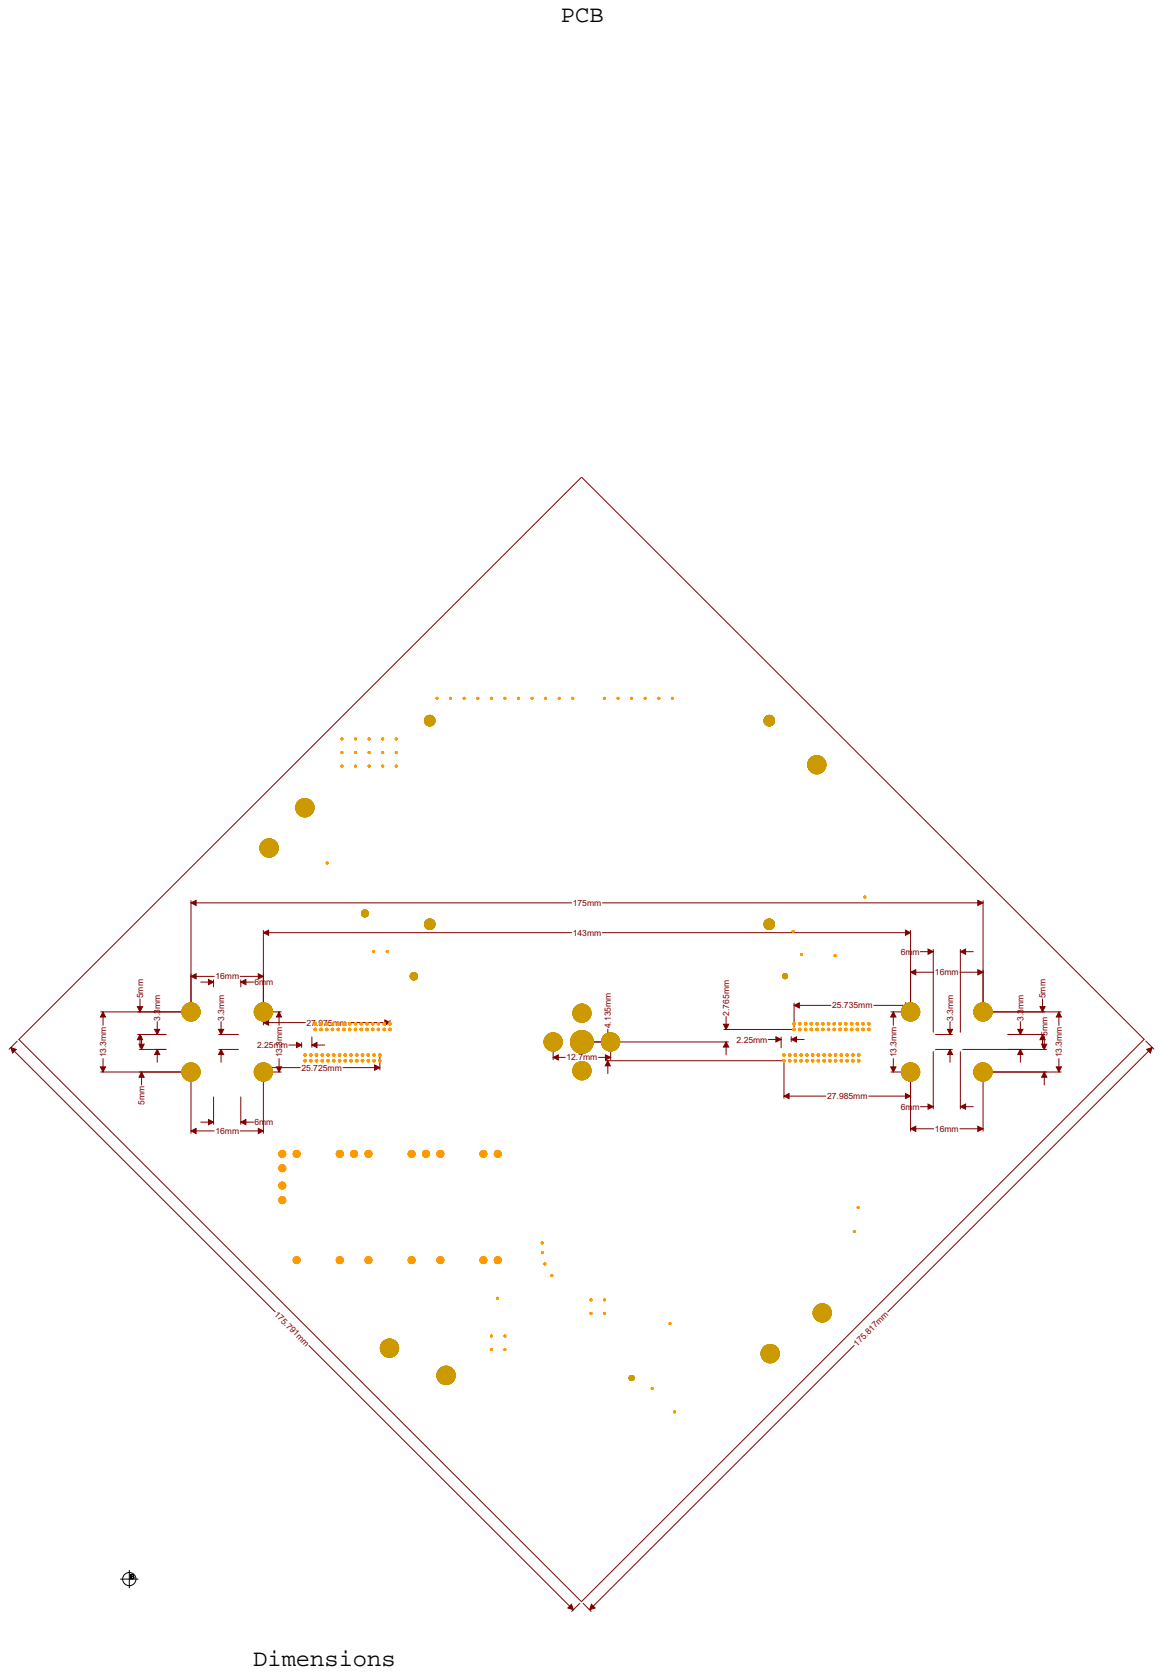
[picture p89: page 7]
Dimensions
