friendshipismagic/SpiROSE/PCB/misc/pcb-test-driver/led-test.pdf

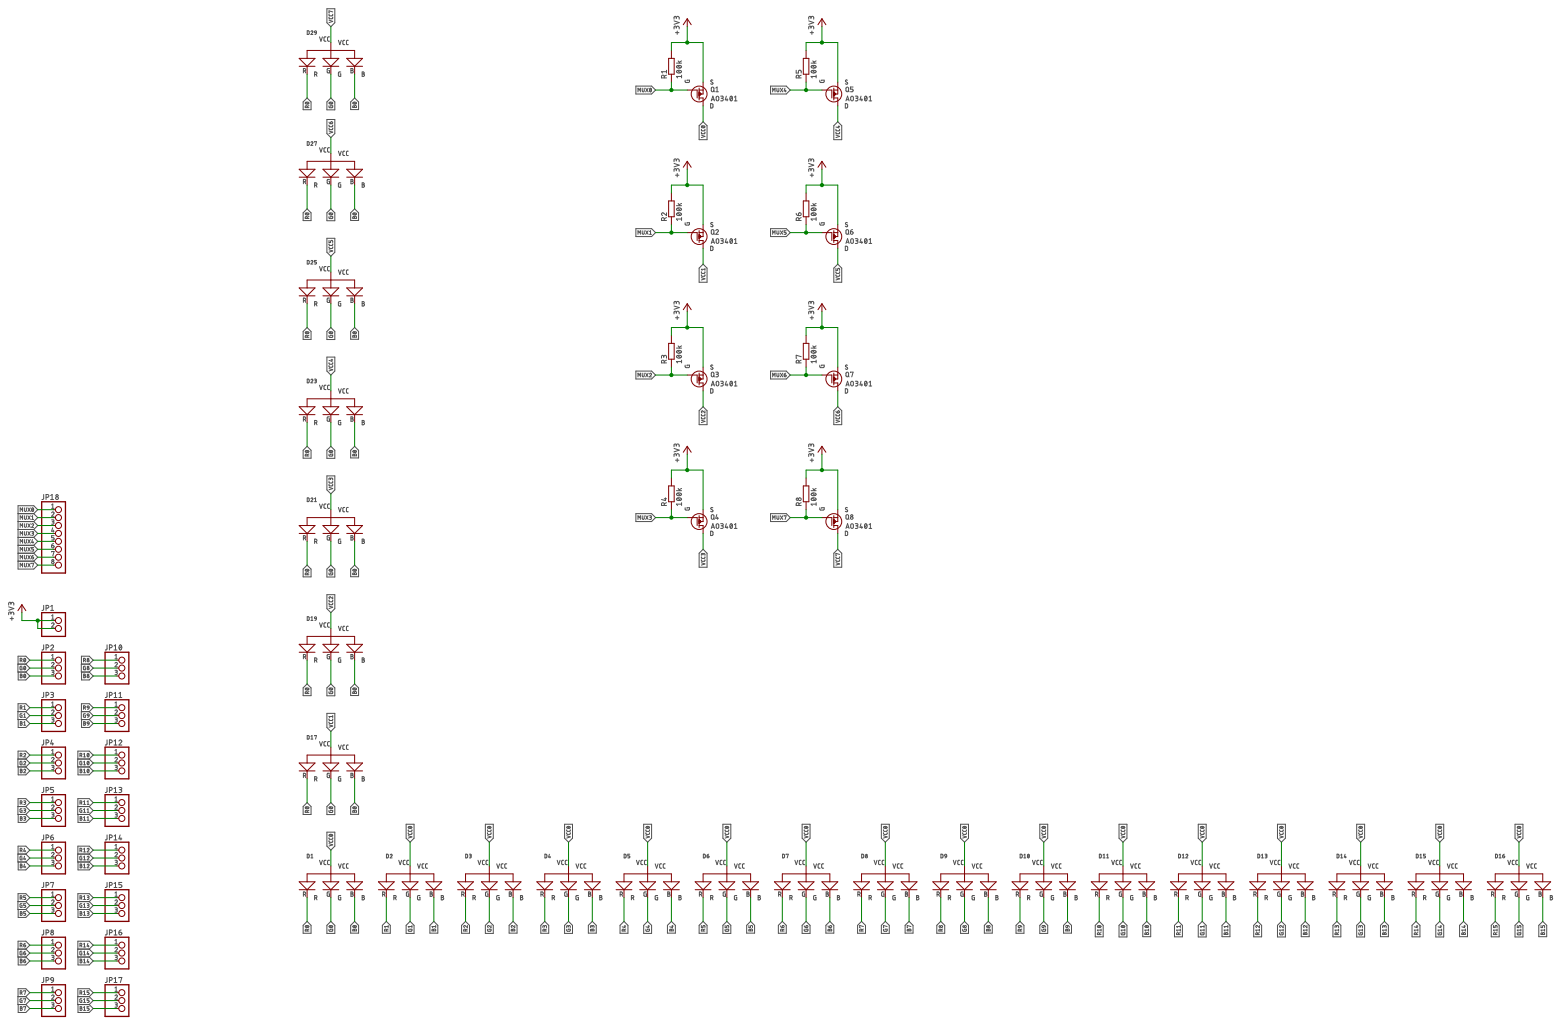
[picture p90: page 1]
