friendshipismagic/SpiROSE/(list of files, drawings)

Other design files:
PCB/LED_Panel/PCB/Output/Gerber/PCB.dsn
PCB/LED_Panel/PCB/PCB.pcb
PCB/LED_Panel/PCB/Work/CellEditorFiles/CellDB/DXF_spyro.pcb
PCB/LED_Panel/PCB/Work/CellEditorFiles/CellDB/Layout/LayoutDB.lyt
PCB/LED_Panel/PCB/Work/CellEditorFiles/CellDB/Work/BackupDatabase/LayoutDB.lyt
PCB/LED_Panel/PCB/Work/CellEditorFiles/CellDB/Work/Layout_Temp/LayoutDB.lyt
PCB/misc/LED_Panel_4_layers/PCB/Drawing/PCB/Layout/LayoutDB.lyt
PCB/misc/LED_Panel_4_layers/PCB/Drawing/PCB/Work/BackupDatabase/LayoutDB.lyt
PCB/misc/LED_Panel_4_layers/PCB/Drawing/PCB/Work/Layout_Temp/LayoutDB.lyt
PCB/misc/LED_Panel_4_layers/PCB/Layout/Revert.lyt
PCB/misc/LED_Panel_4_layers/PCB/PCB.pcb
PCB/misc/LED_Panel_4_layers/PCB/Work/BackupDatabase/Revert.lyt
PCB/Rotative_base/PCB/Layout/LayoutDB.lyt
PCB/Rotative_base/PCB/Layout/Revert.lyt
PCB/Rotative_base/PCB/Output/Gerber/PCB.dsn
PCB/Rotative_base/PCB/PCB.pcb
PCB/Rotative_base/PCB/Work/BackupDatabase/LayoutDB.lyt
PCB/Rotative_base/PCB/Work/BackupDatabase/Revert.lyt
PCB/Rotative_base/PCB/Work/Layout_Temp/LayoutDB.lyt
