friendshipismagic/SpiROSE/FPGA/src/driver_controller.sv

//
// Copyright (C) 2017-2018 Alexis Bauvin, Vincent Charbonniéras, Clément Decoodt,
// Alexandre Janniaux, Adrien Marcenat
//
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

`default_nettype none
module driver_controller #(
    parameter BLANKING_TIME=72
)(
    input clk,
    input clk_enable,
    input nrst,

    output driver_sclk,
    output driver_gclk,
    output driver_lat,
    output [29:0] drivers_sin,
    output [7:0] mux_out,

    input SOF,
    output EOC,

    input [431:0] data [14:0],
    input [47:0] config_data,
    input start_config,
    output end_config,
    output [3:0] debug
);

assign debug = {SOF, EOC, driver_state == SHIFT_REGISTER, driver_state == BLANKING};
logic should_send_config;
always_ff @(posedge clk or negedge nrst)
    if(~nrst) begin
        should_send_config <= '0;
    end else if (start_config) begin
        should_send_config <= '1;
    end else if (driver_state == PREPARE_CONFIG) begin
        should_send_config <= '0;
    end

`include "drivers_conf.svh"
logic [47:0] config_buffer;
always_ff @(posedge clk or negedge nrst)
    if(~nrst) begin
        config_buffer <= serialized_conf;
    end else if (start_config) begin
        config_buffer <= config_data;
    end

/*
 * List of the possible states of the drivers
 * STALL state is the initial state, whe the drivers are not configured
 * PREPARE_CONFIG state is the state where we send FCWRTEN command
 * CONFIG state is the configuration state
 * WRTFC_TIMING we wait 5 cycle to meet timing requirements after a WRTFC
 * PREPARE_DUMP_CONFIG state is the state where we send READFC command
 * DUMP_CONFIG state is the state where we read the config on sout
 * WAIT_FOR_SOF we pause gclk and wait for SOF
 *
 * Boot-time transition is:
 * STALL for 1 clock cycle (since a new configuration, the default one,
 *   is available)
 * PREPARE_CONFIG fo 15 cycles
 * CONFIG for 48+1 clock cycles
 * WRTFC_TIMING for 5 cycles
 * PREPARE_DUMP_CONFIG for 11 cycles
 * DUMP_CONFIG for 48+5 cycles
 */
enum integer {
    STALL,
    PREPARE_CONFIG,
    CONFIG,
    BLANKING,
    SHIFT_REGISTER,
    PAUSE_SCLK,
    WRTFC_TIMING,
    WAIT_FOR_SOF,
    SEND_TMGRST
} driver_state;

assign end_config = clk_enable && driver_state == WRTFC_TIMING && driver_state_counter == 0;

integer driver_state_counter;
integer wrtgs_cnt;
integer column_counter;
integer data_idx;
logic first_latgs;
always_ff @(posedge clk or negedge nrst)
    if(~nrst) begin
        driver_state <= STALL;
        driver_state_counter <= '0;
        wrtgs_cnt <= '0;
        column_counter <= '0;
        data_idx <= '0;
        first_latgs <= '0;
    end else begin
        if (clk_enable) begin
            case(driver_state)
                STALL: begin
                    driver_state_counter <= '0;
                    driver_state <= SEND_TMGRST;
                end

                SEND_TMGRST: begin
                    driver_state_counter <= driver_state_counter + 1'b1;
                    if(driver_state_counter == 20) begin
                        driver_state_counter <= '0;
                        driver_state <= PREPARE_CONFIG;
                    end
                end

                PREPARE_CONFIG: begin
                    // Here we wait 15 cycles to send the FCWRTEN command
                    driver_state_counter <= driver_state_counter + 1'b1;
                    if(driver_state_counter == 14) begin
                        driver_state <= CONFIG;
                        driver_state_counter <= '0;
                    end
                end

                CONFIG: begin
                    /*
                     * Here we wait 1 cycle to meet the timing requirement, and
                     * then 47 cycles to send the config data.
                     */
                    driver_state_counter <= driver_state_counter + 1'b1;
                    if(driver_state_counter == 48) begin
                        driver_state <= WRTFC_TIMING;
                        driver_state_counter <= '0;
                    end
                end

                WRTFC_TIMING: begin
                    // Here we wait 5 cycles to meet timing requirements
                    driver_state_counter <= driver_state_counter + 1'b1;
                    if(driver_state_counter == 5) begin
                        driver_state <= WAIT_FOR_SOF;
                        driver_state_counter <= '0;
                    end
                end

                BLANKING: begin
                    wrtgs_cnt <= '0;
                    data_idx <= '0;
                    driver_state_counter <= driver_state_counter + 1'b1;
                    if(driver_state_counter == BLANKING_TIME - 1) begin
                        driver_state_counter <= '0;
                        driver_state <= PAUSE_SCLK;
                    end
                end

                SHIFT_REGISTER: begin
                    driver_state_counter <= driver_state_counter + 1'b1;
                    data_idx <= data_idx + 1'b1;
                    if(driver_state_counter == 47) begin
                        driver_state_counter <= '0;
                        wrtgs_cnt <= wrtgs_cnt + 1'b1;
                        driver_state <= PAUSE_SCLK;
                        if(wrtgs_cnt == 8) begin
                            wrtgs_cnt <= 0;
                            column_counter <= column_counter + 1'b1;
                            driver_state <= BLANKING;
                            first_latgs <= '1;
                            if(column_counter == 7) begin
                                column_counter <= '0;
                                driver_state <= WAIT_FOR_SOF;
                            end
                        end
                    end
                end

                PAUSE_SCLK: begin
                    driver_state <= SHIFT_REGISTER;
                end

                WAIT_FOR_SOF: begin
                    driver_state_counter <= driver_state_counter + 1'b1;
                    if(SOF) begin
                        driver_state_counter <= '0;
                        driver_state <= BLANKING;
                        column_counter <= '0;
                        first_latgs <= '0;
                    end
                    if(should_send_config) begin
                        driver_state_counter <= '0;
                        driver_state <= SEND_TMGRST;
                    end
                end

                default: begin
                    driver_state <= STALL;
                    driver_state_counter <= '0;
                end
            endcase
        end
    end

/*
 * driver_sclk drives the SCLK of the drivers.
 * There is no difference between the configuration mode and the stream mode.
 * The SCLK is on when device is not in reset and not in blanking mode.
 */
always_comb begin
    case(driver_state)
        CONFIG: begin
            driver_sclk = clk_enable;
            /*
             * After the WRTFC command we pause SCLK for one cycle to meet
             * timing requirement
             */
            if(driver_state_counter == 'd0) begin
                driver_sclk = '0;
            end
        end

        WAIT_FOR_SOF, BLANKING, PAUSE_SCLK, WRTFC_TIMING: begin
            driver_sclk = '0;
        end

        SEND_TMGRST: begin 
            driver_sclk = driver_state_counter > 12 ? '0 : clk_enable;
        end

        default: begin
            driver_sclk = clk_enable;
        end
    endcase
end

always_comb begin
    case(driver_state)
        SHIFT_REGISTER, PAUSE_SCLK: begin
            driver_gclk = clk_enable && first_latgs;
        end

        BLANKING: begin
            driver_gclk = clk_enable && first_latgs && driver_state_counter != 0;
        end

        WAIT_FOR_SOF: begin
            driver_gclk = clk_enable && first_latgs && driver_state_counter != 0 && driver_state_counter < 513;
        end

        default: begin
            driver_gclk = '0;
        end
    endcase
end

/*
 * The LAT is a command signal for latching. It does the states transitions.
 * It is used by:
 *
 * - FCWRTEN command (15 SCLK rising edges) for enabling configuration mode
 * - WRTFC command (5 SCLK rising edges) for writing in configuration mode
 *
 * - WRTGS command (1 SCLK rising edge) for writing to GS latch
 * - LATGS command (3 SCLK rising edges) for doing a WRTGS, then writing the
 *   first GS bank to the second
 *
 * Sends FCWRTEN on PREPARE_CONFIG state, WRTFC on CONFIG state, and WRTGS and
 * LATGS on STREAM state
 *
 * driver_lat is generated on the falling edge ofthe main clock to respect
 * the hold time after the driver clock **falling edge** see TLC5957
 * datasheet page...
 */
localparam FCWRTEN=15, READFC=11, WRTFC=5, WRTGS=1, LATGS=3, LINERESET=7, NO_LAT=0;

always_ff @(negedge clk or negedge nrst)
if(!nrst)
begin
    driver_lat <= 1'b0;
end else begin
    case(driver_state)
        SEND_TMGRST: begin
            driver_lat <= driver_state_counter < 13;
        end

        PREPARE_CONFIG: begin
            driver_lat <= 1'b1;
        end

        CONFIG: begin
            driver_lat <= 1'b0;
            // Send the WRTFC during the 5 last bits to trigger latch at EOT
            if(driver_state_counter >= 49 - WRTFC) begin
                driver_lat <= 1'b1;
            end
        end

        SHIFT_REGISTER: begin
           driver_lat <= '0;
           if(driver_state_counter == 47
               || (driver_state_counter >= 45 && wrtgs_cnt == 8)) begin
              driver_lat <= '1;
          end
        end

        default: driver_lat <= 1'b0;
    endcase
end

/*
 * drivers_sin write the LEDs data or the configuration data depending on the
 * current running state.
 */
always_comb begin
    case(driver_state)
        CONFIG: begin
            drivers_sin = '0;
            if(driver_state_counter != 0) begin
                for(int i = 0; i < 30; i++) begin
                    drivers_sin[i] = config_buffer[48-driver_state_counter];
                end
            end
        end
        SHIFT_REGISTER: begin
            for(int i = 0; i < 15; i++) begin
                drivers_sin[2*i]   = data[i][431 - data_idx];
                drivers_sin[2*i+1] = data[i][431 - data_idx];
            end
        end
        default: begin
            drivers_sin = '0;
        end
    endcase
end

assign EOC = driver_state == SHIFT_REGISTER && wrtgs_cnt == 8
            && driver_state_counter == 47 && clk_enable;

integer mux_counter;
always_ff @(posedge clk or negedge nrst)
    if (~nrst) begin
        mux_counter <= 8;
    end else begin
        if(EOC) begin
            mux_counter <= mux_counter + 1'b1;
            if(mux_counter == 8) begin
                mux_counter <= '0;
            end
        end

        if(SOF || ((driver_state_counter == 512) && (mux_counter == 7))) begin
            mux_counter <= 8;
        end
    end

always_ff @(posedge clk or negedge nrst)
    if (~nrst) begin
        mux_out <= '0;
    end else begin
        mux_out <= '0;
        if(mux_counter < 8) begin
            mux_out <= 1'b1 << mux_counter;
        end
    end

endmodule
