friendshipismagic/SpiROSE/FPGA/quartus/05_memory/ram/ram.v

//
// Copyright (C) 2017-2018 Alexis Bauvin, Vincent Charbonniéras, Clément Decoodt,
// Alexandre Janniaux, Adrien Marcenat
//
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

// megafunction wizard: %RAM: 2-PORT%
// GENERATION: STANDARD
// VERSION: WM1.0
// MODULE: altsyncram 

// ============================================================
// File Name: ram.v
// Megafunction Name(s):
// 			altsyncram
//
// Simulation Library Files(s):
// 			altera_mf
// ============================================================
// ************************************************************
// THIS IS A WIZARD-GENERATED FILE. DO NOT EDIT THIS FILE!
//
// 13.1.4 Build 182 03/12/2014 SJ Full Version
// ************************************************************


//Copyright (C) 1991-2014 Altera Corporation
//Your use of Altera Corporation's design tools, logic functions 
//and other software and tools, and its AMPP partner logic 
//functions, and any output files from any of the foregoing 
//(including device programming or simulation files), and any 
//associated documentation or information are expressly subject 
//to the terms and conditions of the Altera Program License 
//Subscription Agreement, Altera MegaCore Function License 
//Agreement, or other applicable license agreement, including, 
//without limitation, that your use is for the sole purpose of 
//programming logic devices manufactured by Altera and sold by 
//Altera or its authorized distributors.  Please refer to the 
//applicable agreement for further details.


// synopsys translate_off
`timescale 1 ps / 1 ps
// synopsys translate_on
module ram (
	clock,
	data,
	rdaddress,
	wraddress,
	wren,
	q);

	input	  clock;
	input	[15:0]  data;
	input	[15:0]  rdaddress;
	input	[15:0]  wraddress;
	input	  wren;
	output	[15:0]  q;
`ifndef ALTERA_RESERVED_QIS
// synopsys translate_off
`endif
	tri1	  clock;
	tri0	  wren;
`ifndef ALTERA_RESERVED_QIS
// synopsys translate_on
`endif

	wire [15:0] sub_wire0;
	wire [15:0] q = sub_wire0[15:0];

	altsyncram	altsyncram_component (
				.address_a (wraddress),
				.clock0 (clock),
				.data_a (data),
				.wren_a (wren),
				.address_b (rdaddress),
				.q_b (sub_wire0),
				.aclr0 (1'b0),
				.aclr1 (1'b0),
				.addressstall_a (1'b0),
				.addressstall_b (1'b0),
				.byteena_a (1'b1),
				.byteena_b (1'b1),
				.clock1 (1'b1),
				.clocken0 (1'b1),
				.clocken1 (1'b1),
				.clocken2 (1'b1),
				.clocken3 (1'b1),
				.data_b ({16{1'b1}}),
				.eccstatus (),
				.q_a (),
				.rden_a (1'b1),
				.rden_b (1'b1),
				.wren_b (1'b0));
	defparam
		altsyncram_component.address_aclr_b = "NONE",
		altsyncram_component.address_reg_b = "CLOCK0",
		altsyncram_component.clock_enable_input_a = "BYPASS",
		altsyncram_component.clock_enable_input_b = "BYPASS",
		altsyncram_component.clock_enable_output_b = "BYPASS",
		altsyncram_component.intended_device_family = "Cyclone III",
		altsyncram_component.lpm_type = "altsyncram",
		altsyncram_component.numwords_a = 61440,
		altsyncram_component.numwords_b = 61440,
		altsyncram_component.operation_mode = "DUAL_PORT",
		altsyncram_component.outdata_aclr_b = "NONE",
		altsyncram_component.outdata_reg_b = "CLOCK0",
		altsyncram_component.power_up_uninitialized = "FALSE",
		altsyncram_component.ram_block_type = "M9K",
		altsyncram_component.read_during_write_mode_mixed_ports = "DONT_CARE",
		altsyncram_component.widthad_a = 16,
		altsyncram_component.widthad_b = 16,
		altsyncram_component.width_a = 16,
		altsyncram_component.width_b = 16,
		altsyncram_component.width_byteena_a = 1;


endmodule

// ============================================================
// CNX file retrieval info
// ============================================================
// Retrieval info: PRIVATE: ADDRESSSTALL_A NUMERIC "0"
// Retrieval info: PRIVATE: ADDRESSSTALL_B NUMERIC "0"
// Retrieval info: PRIVATE: BYTEENA_ACLR_A NUMERIC "0"
// Retrieval info: PRIVATE: BYTEENA_ACLR_B NUMERIC "0"
// Retrieval info: PRIVATE: BYTE_ENABLE_A NUMERIC "0"
// Retrieval info: PRIVATE: BYTE_ENABLE_B NUMERIC "0"
// Retrieval info: PRIVATE: BYTE_SIZE NUMERIC "8"
// Retrieval info: PRIVATE: BlankMemory NUMERIC "1"
// Retrieval info: PRIVATE: CLOCK_ENABLE_INPUT_A NUMERIC "0"
// Retrieval info: PRIVATE: CLOCK_ENABLE_INPUT_B NUMERIC "0"
// Retrieval info: PRIVATE: CLOCK_ENABLE_OUTPUT_A NUMERIC "0"
// Retrieval info: PRIVATE: CLOCK_ENABLE_OUTPUT_B NUMERIC "0"
// Retrieval info: PRIVATE: CLRdata NUMERIC "0"
// Retrieval info: PRIVATE: CLRq NUMERIC "0"
// Retrieval info: PRIVATE: CLRrdaddress NUMERIC "0"
// Retrieval info: PRIVATE: CLRrren NUMERIC "0"
// Retrieval info: PRIVATE: CLRwraddress NUMERIC "0"
// Retrieval info: PRIVATE: CLRwren NUMERIC "0"
// Retrieval info: PRIVATE: Clock NUMERIC "0"
// Retrieval info: PRIVATE: Clock_A NUMERIC "0"
// Retrieval info: PRIVATE: Clock_B NUMERIC "0"
// Retrieval info: PRIVATE: IMPLEMENT_IN_LES NUMERIC "0"
// Retrieval info: PRIVATE: INDATA_ACLR_B NUMERIC "0"
// Retrieval info: PRIVATE: INDATA_REG_B NUMERIC "0"
// Retrieval info: PRIVATE: INIT_FILE_LAYOUT STRING "PORT_B"
// Retrieval info: PRIVATE: INIT_TO_SIM_X NUMERIC "0"
// Retrieval info: PRIVATE: INTENDED_DEVICE_FAMILY STRING "Cyclone III"
// Retrieval info: PRIVATE: JTAG_ENABLED NUMERIC "0"
// Retrieval info: PRIVATE: JTAG_ID STRING "NONE"
// Retrieval info: PRIVATE: MAXIMUM_DEPTH NUMERIC "0"
// Retrieval info: PRIVATE: MEMSIZE NUMERIC "983040"
// Retrieval info: PRIVATE: MEM_IN_BITS NUMERIC "1"
// Retrieval info: PRIVATE: MIFfilename STRING ""
// Retrieval info: PRIVATE: OPERATION_MODE NUMERIC "2"
// Retrieval info: PRIVATE: OUTDATA_ACLR_B NUMERIC "0"
// Retrieval info: PRIVATE: OUTDATA_REG_B NUMERIC "1"
// Retrieval info: PRIVATE: RAM_BLOCK_TYPE NUMERIC "2"
// Retrieval info: PRIVATE: READ_DURING_WRITE_MODE_MIXED_PORTS NUMERIC "2"
// Retrieval info: PRIVATE: READ_DURING_WRITE_MODE_PORT_A NUMERIC "3"
// Retrieval info: PRIVATE: READ_DURING_WRITE_MODE_PORT_B NUMERIC "3"
// Retrieval info: PRIVATE: REGdata NUMERIC "1"
// Retrieval info: PRIVATE: REGq NUMERIC "1"
// Retrieval info: PRIVATE: REGrdaddress NUMERIC "1"
// Retrieval info: PRIVATE: REGrren NUMERIC "1"
// Retrieval info: PRIVATE: REGwraddress NUMERIC "1"
// Retrieval info: PRIVATE: REGwren NUMERIC "1"
// Retrieval info: PRIVATE: SYNTH_WRAPPER_GEN_POSTFIX STRING "0"
// Retrieval info: PRIVATE: USE_DIFF_CLKEN NUMERIC "0"
// Retrieval info: PRIVATE: UseDPRAM NUMERIC "1"
// Retrieval info: PRIVATE: VarWidth NUMERIC "0"
// Retrieval info: PRIVATE: WIDTH_READ_A NUMERIC "16"
// Retrieval info: PRIVATE: WIDTH_READ_B NUMERIC "16"
// Retrieval info: PRIVATE: WIDTH_WRITE_A NUMERIC "16"
// Retrieval info: PRIVATE: WIDTH_WRITE_B NUMERIC "16"
// Retrieval info: PRIVATE: WRADDR_ACLR_B NUMERIC "0"
// Retrieval info: PRIVATE: WRADDR_REG_B NUMERIC "0"
// Retrieval info: PRIVATE: WRCTRL_ACLR_B NUMERIC "0"
// Retrieval info: PRIVATE: enable NUMERIC "0"
// Retrieval info: PRIVATE: rden NUMERIC "0"
// Retrieval info: LIBRARY: altera_mf altera_mf.altera_mf_components.all
// Retrieval info: CONSTANT: ADDRESS_ACLR_B STRING "NONE"
// Retrieval info: CONSTANT: ADDRESS_REG_B STRING "CLOCK0"
// Retrieval info: CONSTANT: CLOCK_ENABLE_INPUT_A STRING "BYPASS"
// Retrieval info: CONSTANT: CLOCK_ENABLE_INPUT_B STRING "BYPASS"
// Retrieval info: CONSTANT: CLOCK_ENABLE_OUTPUT_B STRING "BYPASS"
// Retrieval info: CONSTANT: INTENDED_DEVICE_FAMILY STRING "Cyclone III"
// Retrieval info: CONSTANT: LPM_TYPE STRING "altsyncram"
// Retrieval info: CONSTANT: NUMWORDS_A NUMERIC "61440"
// Retrieval info: CONSTANT: NUMWORDS_B NUMERIC "61440"
// Retrieval info: CONSTANT: OPERATION_MODE STRING "DUAL_PORT"
// Retrieval info: CONSTANT: OUTDATA_ACLR_B STRING "NONE"
// Retrieval info: CONSTANT: OUTDATA_REG_B STRING "CLOCK0"
// Retrieval info: CONSTANT: POWER_UP_UNINITIALIZED STRING "FALSE"
// Retrieval info: CONSTANT: RAM_BLOCK_TYPE STRING "M9K"
// Retrieval info: CONSTANT: READ_DURING_WRITE_MODE_MIXED_PORTS STRING "DONT_CARE"
// Retrieval info: CONSTANT: WIDTHAD_A NUMERIC "16"
// Retrieval info: CONSTANT: WIDTHAD_B NUMERIC "16"
// Retrieval info: CONSTANT: WIDTH_A NUMERIC "16"
// Retrieval info: CONSTANT: WIDTH_B NUMERIC "16"
// Retrieval info: CONSTANT: WIDTH_BYTEENA_A NUMERIC "1"
// Retrieval info: USED_PORT: clock 0 0 0 0 INPUT VCC "clock"
// Retrieval info: USED_PORT: data 0 0 16 0 INPUT NODEFVAL "data[15..0]"
// Retrieval info: USED_PORT: q 0 0 16 0 OUTPUT NODEFVAL "q[15..0]"
// Retrieval info: USED_PORT: rdaddress 0 0 16 0 INPUT NODEFVAL "rdaddress[15..0]"
// Retrieval info: USED_PORT: wraddress 0 0 16 0 INPUT NODEFVAL "wraddress[15..0]"
// Retrieval info: USED_PORT: wren 0 0 0 0 INPUT GND "wren"
// Retrieval info: CONNECT: @address_a 0 0 16 0 wraddress 0 0 16 0
// Retrieval info: CONNECT: @address_b 0 0 16 0 rdaddress 0 0 16 0
// Retrieval info: CONNECT: @clock0 0 0 0 0 clock 0 0 0 0
// Retrieval info: CONNECT: @data_a 0 0 16 0 data 0 0 16 0
// Retrieval info: CONNECT: @wren_a 0 0 0 0 wren 0 0 0 0
// Retrieval info: CONNECT: q 0 0 16 0 @q_b 0 0 16 0
// Retrieval info: GEN_FILE: TYPE_NORMAL ram.v TRUE
// Retrieval info: GEN_FILE: TYPE_NORMAL ram.inc FALSE
// Retrieval info: GEN_FILE: TYPE_NORMAL ram.cmp FALSE
// Retrieval info: GEN_FILE: TYPE_NORMAL ram.bsf FALSE
// Retrieval info: GEN_FILE: TYPE_NORMAL ram_inst.v TRUE
// Retrieval info: GEN_FILE: TYPE_NORMAL ram_bb.v TRUE
// Retrieval info: LIB_FILE: altera_mf
