friendshipismagic/SpiROSE/FPGA/src/framebuffer_emulator.sv

//
// Copyright (C) 2017-2018 Alexis Bauvin, Vincent Charbonniéras, Clément Decoodt,
// Alexandre Janniaux, Adrien Marcenat
//
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

`default_nettype none
module framebuffer_emulator #(
    parameter POKER_MODE=9,
    parameter BLANKING_CYCLES=72
)(
    input clk_33,
    input nrst,

    // Data signal for the driver main controller
    output [29:0] data,

    // Sync signals
    input driver_ready,
    input button
);

localparam BUFF_SIZE = 15*LED_PER_DRIVER;
localparam LED_PER_DRIVER = 16;
localparam BUFF_SIZE_LOG = $clog2(BUFF_SIZE);

localparam [15:0] red   = 16'b00000_000000_11111;
localparam [15:0] green = 16'b00000_111111_00000;
localparam [15:0] blue  = 16'b11111_000000_00000;
logic [15:0] rgb_image [15*16-1:0] = '{
    red  , red  , red  , red  , red  ,
    blue , blue , blue , blue , blue ,
    green, green, green, green, green,
    red  , red  , red  , red  , red  ,
    blue , blue , blue , blue , blue ,
    green, green, green, green, green,
    red  , red  , red  , red  , red  ,
    blue , blue , blue , blue , blue ,
    green, green, green, green, green,
    red  , red  , red  , red  , red  ,
    blue , blue , blue , blue , blue ,
    green, green, green, green, green,
    red  , red  , red  , red  , red  ,
    blue , blue , blue , blue , blue ,
    green, green, green, green, green,
    red  , red  , red  , red  , red  ,
    red  , red  , red  , red  , red  ,
    blue , blue , blue , blue , blue ,
    green, green, green, green, green,
    red  , red  , red  , red  , red  ,
    blue , blue , blue , blue , blue ,
    green, green, green, green, green,
    red  , red  , red  , red  , red  ,
    blue , blue , blue , blue , blue ,
    green, green, green, green, green,
    red  , red  , red  , red  , red  ,
    blue , blue , blue , blue , blue ,
    green, green, green, green, green,
    red  , red  , red  , red  , red  ,
    blue , blue , blue , blue , blue ,
    green, green, green, green, green,
    red  , red  , red  , red  , red  ,
    red  , red  , red  , red  , red  ,
    blue , blue , blue , blue , blue ,
    green, green, green, green, green,
    red  , red  , red  , red  , red  ,
    blue , blue , blue , blue , blue ,
    green, green, green, green, green,
    red  , red  , red  , red  , red  ,
    blue , blue , blue , blue , blue ,
    green, green, green, green, green,
    red  , red  , red  , red  , red  ,
    blue , blue , blue , blue , blue ,
    green, green, green, green, green,
    red  , red  , red  , red  , red  ,
    blue , blue , blue , blue , blue ,
    green, green, green, green, green,
    red  , red  , red  , red  , red
};
logic [15:0] brg_image [15*16-1:0] = '{
    blue , blue , blue , blue , blue ,
    green, green, green, green, green,
    red  , red  , red  , red  , red  ,
    blue , blue , blue , blue , blue ,
    green, green, green, green, green,
    red  , red  , red  , red  , red  ,
    blue , blue , blue , blue , blue ,
    green, green, green, green, green,
    red  , red  , red  , red  , red  ,
    blue , blue , blue , blue , blue ,
    green, green, green, green, green,
    red  , red  , red  , red  , red  ,
    blue , blue , blue , blue , blue ,
    green, green, green, green, green,
    red  , red  , red  , red  , red  ,
    blue , blue , blue , blue , blue ,
    blue , blue , blue , blue , blue ,
    green, green, green, green, green,
    red  , red  , red  , red  , red  ,
    blue , blue , blue , blue , blue ,
    green, green, green, green, green,
    red  , red  , red  , red  , red  ,
    blue , blue , blue , blue , blue ,
    green, green, green, green, green,
    red  , red  , red  , red  , red  ,
    blue , blue , blue , blue , blue ,
    green, green, green, green, green,
    red  , red  , red  , red  , red  ,
    blue , blue , blue , blue , blue ,
    green, green, green, green, green,
    red  , red  , red  , red  , red  ,
    blue , blue , blue , blue , blue ,
    blue , blue , blue , blue , blue ,
    green, green, green, green, green,
    red  , red  , red  , red  , red  ,
    blue , blue , blue , blue , blue ,
    green, green, green, green, green,
    red  , red  , red  , red  , red  ,
    blue , blue , blue , blue , blue ,
    green, green, green, green, green,
    red  , red  , red  , red  , red  ,
    blue , blue , blue , blue , blue ,
    green, green, green, green, green,
    red  , red  , red  , red  , red  ,
    blue , blue , blue , blue , blue ,
    green, green, green, green, green,
    red  , red  , red  , red  , red  ,
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
integer rgb_idx;

// The three following logics help to compute the correct voxel and bit address
/* verilator lint_off UNUSED */
integer color_addr;
/* verilator lint_on UNUSED */
logic [29:0] [BUFF_SIZE_LOG-1:0] voxel_addr;
integer color_bit_idx;

logic prev_button;
integer animation;
always_ff @(posedge clk_33 or negedge nrst)
    if(~nrst) begin
        prev_button <= '0;
        animation <= '0;
    end else begin
        prev_button <= button;
        if(button && ~prev_button) begin
            animation <= animation + 1'b1;
            if(animation == 2) begin
                animation <= '0;
            end
        end
    end
/*
 * There are two types of driver and for each one a LUT for red and green, and
 * a LUT for blue. Drivers 1 to 20 are part of group 1, drivers 21 to 30 are
 * part of group 0. rgb_idx == 0 means that we are sending blue color.
 */
always_comb begin
    for(int i = 0; i < 30; ++i) begin
        if(i < 20) begin
            voxel_addr[i] = (rgb_idx == 0) ? DRIVER_LUT1_B[led_idx]
                                           : DRIVER_LUT1_RG[led_idx];
        end else begin
            voxel_addr[i] = (rgb_idx == 0) ? DRIVER_LUT0_B[led_idx]
                                           : DRIVER_LUT0_RG[led_idx];
        end
    end
end

/*
 * The color_bit_idx goes from 4 to 0, thus if we add the base address for the
 * green color for instance we get bits 9 to 5.
 */
assign color_bit_idx = (bit_idx > 3) ? bit_idx - 4 : 0;
assign color_addr = color_bit_idx + 32'(COLOR_BASE[rgb_idx]);

always_ff @(posedge clk_33 or negedge nrst)
    if(~nrst) begin
        data <= '0;
    end else begin
        /*
         * Since we only have 16 bit per led, but the poker mode ask for 27
         * bits, we have to pad with 0.
         */
        data <= '0;
        /*
         * If we haven't sent 16 bit yet we don't pad with 0.
         * bit_idx > 3 means that we don't send the 4 first LSB.
         */
        if(driver_ready && bit_idx > 3) begin
            for(int i = 0; i < 30; ++i) begin
                if(animation == 0) begin
                    data[i] <= rgb_image[DRIVER_BASE[i] + voxel_addr[i]][color_addr];
                end else if (animation == 1) begin
                    data[i] <= brg_image[DRIVER_BASE[i] + voxel_addr[i]][color_addr];
                end else begin
                    data[i] <= gbr_image[DRIVER_BASE[i] + voxel_addr[i]][color_addr];
                end
            end
        end
    end

/*
 * Generate counters to send the right data.
 *
 * - mul_idx is the current column
 * - led_idx is the current led
 * - bit_idx is the current bit
 * - rgb_idx is the current color
 *
 * In poker mode we send the MSB of each led first, thus bit_idx is decreased
 * every 16 cycles. When it reaches 0 we change the current column.
 */
always_ff @(posedge clk_33 or negedge nrst)
    if(~nrst) begin
        rgb_idx <= '0;
        mul_idx <= '0;
        bit_idx <= POKER_MODE-1;
        led_idx <= LED_PER_DRIVER-1;
    end else if(driver_ready) begin
        rgb_idx <= rgb_idx + 1'b1;
        // We have sent the three colors, time to go to the next led
        if(rgb_idx == 2) begin
            rgb_idx <= '0;
            led_idx <= led_idx - 1'b1;
            // We have sent the right bit for each leds in the column
            if(led_idx == 0) begin
                led_idx <= LED_PER_DRIVER-1;
                bit_idx <= bit_idx - 1'b1;
                // We have sent all the bits for each led
                if(bit_idx == 0) begin
                    bit_idx <= POKER_MODE-1;
                    // Go to next column, swap buffers
                    mul_idx <= mul_idx + 1'b1;
                    // We have sent the whole slice
                    if(mul_idx == 7) begin
                        mul_idx <= '0;
                    end
                end
            end
        end
    end


endmodule
