friendshipismagic/SpiROSE/LCD_Display/degrade_bleu.h

/* * Copyright (C) 2017-2018 Alexis Bauvin, Vincent Charbonniéras, Clément
 * Decoodt, Alexandre Janniaux, Adrien Marcenat
 *
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
 * THE SOFTWARE IS PROVIDED "AS IS", WITHOUT WARRANTY OF ANY KIND, EXPRESS OR
 * IMPLIED, INCLUDING BUT NOT LIMITED TO THE WARRANTIES OF MERCHANTABILITY,
 * FITNESS FOR A PARTICULAR PURPOSE AND NONINFRINGEMENT. IN NO EVENT SHALL THE
 * AUTHORS OR COPYRIGHT HOLDERS BE LIABLE FOR ANY CLAIM, DAMAGES OR OTHER
 * LIABILITY, WHETHER IN AN ACTION OF CONTRACT, TORT OR OTHERWISE, ARISING FROM,
 * OUT OF OR IN CONNECTION WITH THE SOFTWARE OR THE USE OR OTHER DEALINGS IN THE
 * SOFTWARE.
 */

/**
 * This file was generated from "degrade_bleu.png" using...
 *
 *	file2c -dcs degrade_bleu.png degrade_bleu.h
 *
 */
static const char degrade_bleu[] = {
    0x89, 0x50, 0x4E, 0x47, 0x0D, 0x0A, 0x1A, 0x0A, 0x00, 0x00, 0x00, 0x0D,
    0x49, 0x48, 0x44, 0x52, 0x00, 0x00, 0x01, 0xE0, 0x00, 0x00, 0x01, 0x10,
    0x08, 0x02, 0x00, 0x00, 0x00, 0xE7, 0x24, 0x30, 0xDB, 0x00, 0x00, 0x00,
    0x09, 0x70, 0x48, 0x59, 0x73, 0x00, 0x00, 0x0B, 0x13, 0x00, 0x00, 0x0B,
    0x13, 0x01, 0x00, 0x9A, 0x9C, 0x18, 0x00, 0x00, 0x00, 0x07, 0x74, 0x49,
    0x4D, 0x45, 0x07, 0xE1, 0x0B, 0x05, 0x16, 0x00, 0x02, 0xA7, 0x67, 0x1D,
    0x4A, 0x00, 0x00, 0x00, 0x19, 0x74, 0x45, 0x58, 0x74, 0x43, 0x6F, 0x6D,
    0x6D, 0x65, 0x6E, 0x74, 0x00, 0x43, 0x72, 0x65, 0x61, 0x74, 0x65, 0x64,
    0x20, 0x77, 0x69, 0x74, 0x68, 0x20, 0x47, 0x49, 0x4D, 0x50, 0x57, 0x81,
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
};

#ifdef ROMFS_DIRENTRY_HEAD
static const ROMFS_DIRENTRY degrade_bleu_dir = {
    0, 0, ROMFS_DIRENTRY_HEAD, "degrade_bleu.png", 73170, degrade_bleu};
#undef ROMFS_DIRENTRY_HEAD
#define ROMFS_DIRENTRY_HEAD &degrade_bleu_dir
#endif
