friendshipismagic/SpiROSE/LCD_Display/userfonts.h

/* * Copyright (C) 2017-2018 Alexis Bauvin, Vincent Charbonniéras, Clément
 * Decoodt, Alexandre Janniaux, Adrien Marcenat
 *
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
 * THE SOFTWARE IS PROVIDED "AS IS", WITHOUT WARRANTY OF ANY KIND, EXPRESS OR
 * IMPLIED, INCLUDING BUT NOT LIMITED TO THE WARRANTIES OF MERCHANTABILITY,
 * FITNESS FOR A PARTICULAR PURPOSE AND NONINFRINGEMENT. IN NO EVENT SHALL THE
 * AUTHORS OR COPYRIGHT HOLDERS BE LIABLE FOR ANY CLAIM, DAMAGES OR OTHER
 * LIABILITY, WHETHER IN AN ACTION OF CONTRACT, TORT OR OTHERWISE, ARISING FROM,
 * OUT OF OR IN CONNECTION WITH THE SOFTWARE OR THE USE OR OTHER DEALINGS IN THE
 * SOFTWARE.
 */

/* Start of automatically generated font definition for OpenSans_Bold16. */

#ifndef MF_RLEFONT_INTERNALS
#define MF_RLEFONT_INTERNALS
#endif
#include "mf_rlefont.h"

#ifndef MF_RLEFONT_VERSION_4_SUPPORTED
#error The font file is not compatible with this version of mcufont.
#endif

static const uint8_t mf_rlefont_OpenSans_Bold16_dictionary_data[263] = {
    0x82, 0x08, 0x15, 0x84, 0x09, 0x84, 0x04, 0x82, 0x06, 0x81, 0x0b, 0x07,
    0x87, 0x01, 0x85, 0x09, 0x81, 0x04, 0x0e, 0x04, 0x83, 0x0a, 0x81, 0x0d,
    0x82, 0x0b, 0x81, 0x02, 0x82, 0x03, 0x81, 0x09, 0x07, 0x80, 0x86, 0x01,
    0x0a, 0x06, 0x08, 0x85, 0x05, 0x81, 0x07, 0x82, 0x03, 0x81, 0x82, 0x03,
    0x81, 0x81, 0x0e, 0x81, 0x0a, 0x0d, 0x02, 0x81, 0x08, 0x82, 0x02, 0x82,
    0x01, 0x85, 0x02, 0x83, 0x0b, 0x13, 0x16, 0x85, 0x0a, 0x81, 0x12, 0x82,
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
    },
    4, /* version */
    mf_rlefont_OpenSans_Bold16_dictionary_data,
    mf_rlefont_OpenSans_Bold16_dictionary_offsets,
    53, /* rle dict count */
    97, /* total dict count */
    1,  /* char range count */
    mf_rlefont_OpenSans_Bold16_char_ranges,
};

#ifdef MF_INCLUDED_FONTS
/* List entry for searching fonts by name. */
static const struct mf_font_list_s mf_rlefont_OpenSans_Bold16_listentry = {
    MF_INCLUDED_FONTS, (struct mf_font_s*)&mf_rlefont_OpenSans_Bold16};
#undef MF_INCLUDED_FONTS
#define MF_INCLUDED_FONTS (&mf_rlefont_OpenSans_Bold16_listentry)
#endif

/* End of automatically generated font definition for OpenSans_Bold16. */
