friendshipismagic/SpiROSE/FPGA/quartus/common/pll/clock_switchover.v

//
// Copyright (C) 2017-2018 Alexis Bauvin, Vincent Charbonniéras, Clément Decoodt,
// Alexandre Janniaux, Adrien Marcenat
//
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

// megafunction wizard: %ALTCLKCTRL%
// GENERATION: STANDARD
// VERSION: WM1.0
// MODULE: altclkctrl 

// ============================================================
// File Name: clock_switchover.v
// Megafunction Name(s):
// 			altclkctrl
//
// Simulation Library Files(s):
// 			cycloneiii
// ============================================================
// ************************************************************
// THIS IS A WIZARD-GENERATED FILE. DO NOT EDIT THIS FILE!
//
// 13.1.4 Build 182 03/12/2014 SJ Full Version
// ************************************************************


//Copyright (C) 1991-2014 Altera Corporation
//Your use of Altera Corporation's design tools, logic functions 
//and other software and tools, and its AMPP partner logic 
//functions, and any output files from any of the foregoing 
//(including device programming or simulation files), and any 
//associated documentation or information are expressly subject 
//to the terms and conditions of the Altera Program License 
//Subscription Agreement, Altera MegaCore Function License 
//Agreement, or other applicable license agreement, including, 
//without limitation, that your use is for the sole purpose of 
//programming logic devices manufactured by Altera and sold by 
//Altera or its authorized distributors.  Please refer to the 
//applicable agreement for further details.


//altclkctrl CBX_AUTO_BLACKBOX="ALL" CLOCK_TYPE="Global Clock" DEVICE_FAMILY="Cyclone III" ENA_REGISTER_MODE="falling edge" USE_GLITCH_FREE_SWITCH_OVER_IMPLEMENTATION="ON" clkselect ena inclk outclk
//VERSION_BEGIN 13.1 cbx_altclkbuf 2014:03:12:18:15:27:SJ cbx_cycloneii 2014:03:12:18:15:29:SJ cbx_lpm_add_sub 2014:03:12:18:15:29:SJ cbx_lpm_compare 2014:03:12:18:15:29:SJ cbx_lpm_decode 2014:03:12:18:15:29:SJ cbx_lpm_mux 2014:03:12:18:15:30:SJ cbx_mgl 2014:03:12:21:10:00:SJ cbx_stratix 2014:03:12:18:15:31:SJ cbx_stratixii 2014:03:12:18:15:31:SJ cbx_stratixiii 2014:03:12:18:15:32:SJ cbx_stratixv 2014:03:12:18:15:32:SJ  VERSION_END
// synthesis VERILOG_INPUT_VERSION VERILOG_2001
// altera message_off 10463


//synthesis_resources = clkctrl 1 reg 3 
//synopsys translate_off
`timescale 1 ps / 1 ps
//synopsys translate_on
module  clock_switchover_altclkctrl_0fi
	( 
	clkselect,
	ena,
	inclk,
	outclk) /* synthesis synthesis_clearbox=2 */;
	input   [1:0]  clkselect;
	input   ena;
	input   [3:0]  inclk;
	output   outclk;
`ifndef ALTERA_RESERVED_QIS
// synopsys translate_off
`endif
	tri0   [1:0]  clkselect;
	tri1   ena;
	tri0   [3:0]  inclk;
`ifndef ALTERA_RESERVED_QIS
// synopsys translate_on
`endif

	(* ALTERA_ATTRIBUTE = {"POWER_UP_LEVEL=HIGH"} *)
	reg	ena_reg;
	(* ALTERA_ATTRIBUTE = {"POWER_UP_LEVEL=LOW"} *)
	reg	[1:0]	select_reg;
	wire  wire_clkctrl1_outclk;
	wire  [1:0]  clkselect_wire;
	wire  [3:0]  inclk_wire;
	wire  [1:0]  select_enable_wire;

	// synopsys translate_off
	initial
		ena_reg = {1{1'b1}};
	// synopsys translate_on
	always @ ( negedge wire_clkctrl1_outclk)
		  ena_reg <= (ena & (~ select_enable_wire[1]));
	// synopsys translate_off
	initial
		select_reg = 0;
	// synopsys translate_on
	always @ ( negedge wire_clkctrl1_outclk)
		if (ena_reg == 1'b0)   select_reg <= clkselect_wire[1:0];
	cycloneiii_clkctrl   clkctrl1
	( 
	.clkselect({select_reg}),
	.ena(1'b1),
	.inclk(inclk_wire),
	.outclk(wire_clkctrl1_outclk)
	// synopsys translate_off
	,
	.devclrn(1'b1),
	.devpor(1'b1)
	// synopsys translate_on
	);
	defparam
		clkctrl1.clock_type = "Global Clock",
		clkctrl1.lpm_type = "cycloneiii_clkctrl";
	assign
		clkselect_wire = {clkselect},
		inclk_wire = {inclk},
		outclk = (wire_clkctrl1_outclk & ena_reg),
		select_enable_wire = {(select_enable_wire[0] | (clkselect_wire[1] ^ select_reg[1])), (clkselect_wire[0] ^ select_reg[0])};
endmodule //clock_switchover_altclkctrl_0fi
//VALID FILE


// synopsys translate_off
`timescale 1 ps / 1 ps
// synopsys translate_on
module clock_switchover (
	clkselect,
	inclk0x,
	inclk1x,
	outclk)/* synthesis synthesis_clearbox = 2 */;

	input	  clkselect;
	input	  inclk0x;
	input	  inclk1x;
	output	  outclk;
`ifndef ALTERA_RESERVED_QIS
// synopsys translate_off
`endif
	tri0	  clkselect;
`ifndef ALTERA_RESERVED_QIS
// synopsys translate_on
`endif

	wire  sub_wire0;
	wire [0:0] sub_wire3 = 1'h0;
	wire  sub_wire4 = 1'h1;
	wire [1:0] sub_wire8 = 2'h0;
	wire  sub_wire7 = inclk1x;
	wire  outclk = sub_wire0;
	wire  sub_wire1 = clkselect;
	wire [1:0] sub_wire2 = {sub_wire3, sub_wire1};
	wire  sub_wire5 = inclk0x;
	wire [3:0] sub_wire6 = {sub_wire8, sub_wire7, sub_wire5};

	clock_switchover_altclkctrl_0fi	clock_switchover_altclkctrl_0fi_component (
				.clkselect (sub_wire2),
				.ena (sub_wire4),
				.inclk (sub_wire6),
				.outclk (sub_wire0))/* synthesis synthesis_clearbox=2
	 clearbox_macroname = altclkctrl
	 clearbox_defparam = "ena_register_mode=falling edge;intended_device_family=Cyclone III;use_glitch_free_switch_over_implementation=ON;clock_type=Global Clock;" */;

endmodule

// ============================================================
// CNX file retrieval info
// ============================================================
// Retrieval info: PRIVATE: INTENDED_DEVICE_FAMILY STRING "Cyclone III"
// Retrieval info: PRIVATE: SYNTH_WRAPPER_GEN_POSTFIX STRING "0"
// Retrieval info: PRIVATE: clock_inputs NUMERIC "2"
// Retrieval info: CONSTANT: ENA_REGISTER_MODE STRING "falling edge"
// Retrieval info: CONSTANT: INTENDED_DEVICE_FAMILY STRING "Cyclone III"
// Retrieval info: CONSTANT: USE_GLITCH_FREE_SWITCH_OVER_IMPLEMENTATION STRING "ON"
// Retrieval info: CONSTANT: clock_type STRING "Global Clock"
// Retrieval info: USED_PORT: clkselect 0 0 0 0 INPUT GND "clkselect"
// Retrieval info: USED_PORT: inclk0x 0 0 0 0 INPUT NODEFVAL "inclk0x"
// Retrieval info: USED_PORT: inclk1x 0 0 0 0 INPUT NODEFVAL "inclk1x"
// Retrieval info: USED_PORT: outclk 0 0 0 0 OUTPUT NODEFVAL "outclk"
// Retrieval info: CONNECT: @clkselect 0 0 1 1 GND 0 0 0 0
// Retrieval info: CONNECT: @clkselect 0 0 1 0 clkselect 0 0 0 0
// Retrieval info: CONNECT: @ena 0 0 0 0 VCC 0 0 0 0
// Retrieval info: CONNECT: @inclk 0 0 2 2 GND 0 0 2 0
// Retrieval info: CONNECT: @inclk 0 0 1 0 inclk0x 0 0 0 0
// Retrieval info: CONNECT: @inclk 0 0 1 1 inclk1x 0 0 0 0
// Retrieval info: CONNECT: outclk 0 0 0 0 @outclk 0 0 0 0
// Retrieval info: GEN_FILE: TYPE_NORMAL clock_switchover.v TRUE
// Retrieval info: GEN_FILE: TYPE_NORMAL clock_switchover.inc FALSE
// Retrieval info: GEN_FILE: TYPE_NORMAL clock_switchover.cmp FALSE
// Retrieval info: GEN_FILE: TYPE_NORMAL clock_switchover.bsf FALSE
// Retrieval info: GEN_FILE: TYPE_NORMAL clock_switchover_inst.v FALSE
// Retrieval info: GEN_FILE: TYPE_NORMAL clock_switchover_bb.v TRUE
// Retrieval info: LIB_FILE: cycloneiii
