friendshipismagic/SpiROSE/(commit log)

2017-10-25 Press W to toggle wireframe
2017-10-28 Algorithm to cut triangle with origin inside
2017-10-28 Improved rejections of triangles that should not be cut
2017-10-31 Add LED emitter datasheet (ref. LRTBR48G)
2017-10-31 Add LED Driver datasheet (ref. TLC5957)
2017-10-31 Add first requirements for LEDs, driver and FPGA
2017-11-01 tools/spec.py: change to snake_case
    In order to improve readability an respect PEP8 I changed the case from
    camelCase to snake_case.
2017-11-01 tools/spec.py: remove voltage and change LED_power
    LED_power now represent the nominal power used by a single LED (in W),
    hence the voltage is not needed anymore.
2017-11-01 Added color override in the GS for debugging
    Yep, even worse than printf debug. Color output debug :(
2017-11-01 Load suzanne and show it
    [suzanne.obj]
2017-11-01 Fixed a glitch due to z axis
2017-11-02 Fix compile on some systems
    [main.cpp]
2017-11-02 tools/spec.py: add driver computations
    Add computation of the following parameters:
    * number of driver
    * bandwidth of the outermost driver
2017-11-03 Fixed orthonormal projection for voxelization
    [main.cpp]
2017-11-03 Added render stage to display voxels as cubes
2017-11-05 tools/spec.py: change driver and voxel computation
    Because we now refresh each LED at the same rate, I changed the number of voxel
    computation, hence I also had changed the driver bandwith computation as it
    depends on the same kind of computation.
2017-11-05 Sample voxel texture in the vertex shader
2017-11-05 Do reverse-pizza in voxel render
    [main.cpp]
2017-11-05 Proper wireframe mode
2017-11-06 Add test project for LED / Driver placement-routing.
2017-11-06 Place of 8*16 LEDs + 1 driver
    [BOM.xlsx, LayoutDB.lyt, PCB.pcb, ProjectBackup.cfg, Revert.lyt, components.csv, fiducials.csv, table_de_routage.ods]
2017-11-07 Added watertight suzanne mesh
    [suzanne-tight.obj]
2017-11-07 Place and route of one LED micro-pane
    a micro-pane is a pane for only one driver.
    [LayoutDB.lyt, PCB.pcb]
2017-11-08 Schematic, Place and Route of second driver
    [LayoutDB.lyt, PCB.pcb]
2017-11-08 Add third micro-plane and place LEDs
    Vias have to be readjusted
    [LayoutDB.lyt, PCB.pcb]
2017-11-09 Place and Route last micro-panel of one column
    [LayoutDB.lyt, PCB.pcb]
2017-11-09 Change LEDs routing and fanout via layout
    [LayoutDB.lyt, PCB.pcb]
2017-11-13 Warnings for ST HAL Drivers and ugfx library removed, user source file warnings treated as errors
    Add rfc1149/rose-dev image for lint step as this step needs clang format.
    [degrade_bleu.h, gfxconf.h, main.c]
2017-11-13 Code rework for modularity purposes
    [gfxconf.h, main.c, widget.c, widget.h]
2017-11-14 (docs) Add mechanical design files, first revision
    [Axe moteur.SLDPRT, Axe.SLDPRT, Bras coté.SLDPRT, Bras haut.SLDPRT, Carter.SLDPRT, Embase bas.SLDPRT, Embase haut.SLDPRT, Fixation 2.SLDPRT]
2017-11-14 (docs) Mechanical design, second revision
    New motor, add hub
    [Axe moteur.SLDPRT, Axe.SLDPRT, Bras coté.SLDPRT, Bras haut.SLDPRT, Carter.SLDPRT, Embase bas.SLDPRT, Fixation dessous.SLDPRT, Fixation dessus.SLDPRT]
2017-11-14 Grouped options in struct to avoid name conflicts
    [main.cpp]
2017-11-15 (docs) Base thickness change from 10mm to 8mm
    This is due to issues when ordering the material.
    [Bras coté.SLDPRT, Bras haut.SLDPRT, Embase bas.SLDPRT, Fixation dessous.SLDPRT, Fixation dessus.SLDPRT, Moteur.SLDASM, SpiROSE.SLDASM, SpiROSE.SLDDRW]
2017-11-20 Add gitlab stages for SBC
    Stages are:
    - linter: Code style, etc.
    - build: build the SBC projects
    - test: unit, regression, integration, etc.
    - host: Hardware In Loop tests
2017-11-20 docs: Add EDM connector datasheet
2017-11-20 specs/grid*.svg: add led grid layouts (no staggering)
2017-11-20 (FPGA): Add empty project with pin assignment
2017-11-20 (FPGA): Use 3.0V LVCMOS logic, gitignore outputs
    The pinout is using fitter instead of manually specified pins.
2017-11-22 .gitlab-ci.yml: use default image for lint_lower_tower step
    Remove arm-none-eabi and rose-dev images as rose-dev's one is the default one.
2017-11-24 FPGA/systemc/driver.hpp: add base implementation of driver
2017-11-24 FPGA/systemc/driver.hpp: add constructor and sin_process
2017-11-24 FPGA/systemc/driver.hpp: add handle_{sin/lat} process
2017-11-24 FPGA/systemc/driver.hpp: add WRTGS naive handling
2017-11-24 FPGA/systemc/driver.hpp: add getter for FC data
2017-11-24 FPGA/systemc/driver.hpp: add latch to GS1/2
2017-11-24 FPGA/systemc/driver.hpp: add other LAT function
2017-11-24 FPGA/systemc/driver.hpp: add counter and init them
2017-11-24 FPGA/systemc/driver.hpp: Improve WRTFC/LINERESET/LATGS/WRTGS
2017-11-24 FPGA/systemc/driver: check poker mode and split sources
2017-11-24 FPGA/systemc/driver: add poker mode handling in bank
2017-11-27 FPGA: add verilator testing environment
    Squashed commit of the following:
    FPGA/sim: update makefile, not using verilator's ones
    FPGA/sim/Makefile: better separation between target
    FPGA/sim: add systemc simulation makefiles
    FPGA/Makefile: add dummy Makefile
    .gitlab-ci.yml: add ci for the fpga
    .gitlab-ci.yml: add stages for CI
2017-11-27 renderer: Fix loadShader declaration
    [main.cpp]
2017-11-29 FPGA/systemc/driver: add GCLK and getters for test
2017-11-29 FPGA/systemc/driver: use FCBuff for fc_data
2017-11-29 FPGA/systemc/driver: explains bit choice in poker mode
2017-11-29 FPGA/systemc/driver: clean up header file
2017-11-29 FPGA/systemc/driver: reset lat_counter and detail TODO
    [driver.cpp]
2017-11-29 FPGA/systemc/driver: add reference to application note
2017-11-29 FPGA/lib/driver_cmd.h: add function to generate driver sequences
2017-11-30 FPGA/systemc:driver: add const instead of values
2017-11-30 FPGA/systemc/driver: fix poker mode config check
    [driver.cpp]
2017-11-30 FPGA/tb_sc/tb_driver: add a driver testbench for tests
2017-11-30 FPGA/systemc/driver: use naming convention from CONTRIBUTING.md
2017-12-01 FPGA/src/driver.sv: add an empty driver module
    Add an empty driver module with default parameters based on the TLC5957
    features.
2017-12-01 FPGA/src/fifo_out.sv: add a fifo_out module
    The fifo_out module will read the voxels into the fifo IP and send them
    to the driver module.
2017-12-01 FPGA/src: add a voxel input in driver
    The driver has a voxel input and output. Also change the name "data" to
    "voxel_out" as it has more sense.
2017-12-01 FPGA/tb_src/driver_testbench.sv: dummy testbench
    Add empty tesbench for the driver module.
2017-12-01 Add top level device
    This device currently instanciates a single driver.
2017-12-01 FPGA/src/driver.sv: add simple always_ff block
    This block just reset signals and connect voxel_in and voxel_out.
2017-12-01 FPGA: change ADDR_WIDTH according to poker mode
    When in poker mode, the led driver (TLC5957) uses his internal registers
    differently (this is very well explained here http://www.ti.com/lit/ug/slvuaf0/slvuaf0.pdf):
    * In normal mode, we write the RGB of one LED into the 48-bit common shift
    register and then latch it into the first GS data latch (768 bit register) at
    the address selected by the GS data latch address counter (which count
    from 15 to 0). When the 16 LEDs' RGS have been written we latch the
    first GS data latch into the second one.
    * In poker mode, we write bits group, i.e. the 48 bits corresponding to
    LEDR15,LEDG15,LEDB15...LEDR0,LEDG0,LEDB0 bit n. Thus in 9-bit poker mode
    for inst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
2017-12-01 FPGA/driver_controller.sv: implement poker mode
    Implement 9-bits poker mode with 8 multiplexing:
    * A block send one bit at each posedge clk to the common shift register,
    and generate three counters (bit, bit_group, and multiplexing)
    * Another block uses the counters to generate the latch commands with the
    signal lat (WRTGS every 48 bits, LATGS every 9 bit-groups, and LINERESET
    instead of the 8-th LATGS)
2017-12-01 FPGA/driver_controller.sv: blanking, gclk and sclk
    The module driver_controller now output the gclk and sclk signal.
    Because we must wait for the end of a gclk segment (which is 2^N wide,
    in our case 512 bit wide), we have an internal blanking while we must
    driev sclk to 0 to avoid losing data. Indeed sclk is used to shif the
    common shift register, thus while we wait for the end of gclk segment we
    don't send data into it and don't want to shift it.
    [driver_controller.sv, driver_testbench.sv, top.sv]
2017-12-01 WIP: Add driver main controller
2017-12-01 FPAG/src/framebuffer.sv: add framebuffer module
    The framebuffer module uses two buffer, while one is reading the other
    is sending data to the driver_main_controller.
2017-12-01 Add LAT driver via lat_command
    Just write the state you want in lat_command to send a lat command :)
2017-12-01 Add drivers default configuration structure
2017-12-01 Add serialized version of config
    The serialized version is used to send easily the configuration to the
    drivers.
2017-12-01 Add drivers state transitions
2017-12-01 Replace driver controller by main controller
    [driver_controller.sv]
2017-12-01 Add encoder and framebuffer in top module
2017-12-01 FPGA/diver_controller.sv:add missing logic keyword
    [driver_controller.sv]
2017-12-01 FPGA/quartus: add module files to the project
    Add column_multiplexer, driver_controller, framebuffer, encoder and
    rgb_logic files to the project.
2017-12-01 FPGA/driver_controller.sv: fix fsm behaviour
    Remove internal counters, only keep sclk_data and driver_config. Add a
    PREPARE_CONFIG state to send the FCWRTEN command.
    [driver_controller.sv]
2017-12-01 FPGA/driver_controller.sv: fix combinatorial logic
    Change the size of the state enum so it can hold 5 value.
    Set driver_sin to 0 in every state apart from CONFIG and STREAM so it
    doesn't infer latch on synthesis.
    [driver_controller.sv]
2017-12-01 FPGA/driver_controller.sv: use signal sout
    Use driver_sout and driver_sout_mux to remove the warning. It is not an
    implementation of the LOD procedure, just a dummy use case.
2017-12-01 FPGA/quartus: fix several minor warning
    [driver_controller.sv]
2017-12-01 FPGA/driver_controller: fix typo in always_comb
    [driver_controller.sv]
2017-12-01 FPGA/sim/driver_controller: add files for driver_controller tests
2017-12-01 FPGA/tb/driver_controller: bind signals
2017-12-01 FPGA/framebuffer_emulator.sv: emultae framebuffer
    This module role is just to send data to the driver controller.
    Currently it just sends 1.
2017-12-01 Add DE1-SoC quartus project
    [c5_pin_model_dump.txt]
2017-12-01 Project cleanup
    [c5_pin_model_dump.txt]
2017-12-01 Fix typo, change default settings to min power out
    [driver_controller.sv]
2017-12-01 Use 3.3MHz test clock, put muxer on switches
2017-12-02 FPGA/tb_sc/tb_driver: Extern C for driver_cmd, print messages for SystemC tests, link working with SystemC 2.3.1
2017-12-03 renderer: Fix multi-target render
    [main.cpp]
2017-12-04 FPGA/tb_sc/tb_driver: Fixed SystemC2.3.2 linking issue
    [tb_driver.cpp]
2017-12-04 renderer: Add CLI option to start at a fixed time
    [main.cpp]
2017-12-04 renderer: Fix clang build
    [tga.cpp]
2017-12-04 45° drivers, route first driver
    [LayoutDB.lyt, PCB.pcb, Revert.lyt]
2017-12-04 FPGA/systemc/driver: fix writeToBank segfault in poker mode
    [driver.cpp]
2017-12-04 FPGA/systemc/driver: change behavior and name of writeToBank
2017-12-04 FPGA/systemc/driver: fix ESPWM and XREFRESH in poker mode
    [driver.cpp]
2017-12-04 FPGA/systemc/driver: fix behaviour with bank and debug
    [driver.cpp, driver.hpp]
2017-12-04 FPGA/lib/test_driver_cmd: Bug fix in test
    [tb_driver.cpp]
2017-12-04 FPGA/src: add new clock to match timing
    The drivers have non trivial timing for the lat and data, thus we need a
    high frequency clock to respect them. I have added a new clock (which
    will probably be 66 MHz) and derive sclk and gclk from it. For the
    counters (hence the driver state) the clock is in phase quadrature with
    sclk thus we send data/lat within requirement.
2017-12-04 FPGA/src: add one to all counter
    To respect the driver timing we need to pause sclk for one cycle thus
    in order to not miss the first data we need to wait, hence we count
    until 48/512 instead of 47/511.
2017-12-05 renderer: Fix scene clipping issue in non-xor mode
    [main.cpp]
2017-12-05 renderer: Fix the texture parsing, but IT WORKS
    However, see the comment at the end of shader/generate-noxor.gs. There
    is an incoherece that should be investigated
    [main.cpp]
2017-12-05 FPGA/lib/driver_cmd: clarity and consistency
2017-12-05 FPGA/lib/driver_cmd: fix poker mode ordering
2017-12-05 FPGA/tb_sc/tb_driver: Debug messages change, typo fix
    [tb_driver.cpp]
2017-12-05 FPGA/: meet timing requirement
    Swap the role of clk_lse and clk_lse quad in the driver controller, and
    change clk_lse from a local signal to an input of the module. Explain
    everything in the comments of each block.
    [DE1_SoC.sv, driver_controller.sv, driver_testbench.sv, framebuffer_emulator.sv]
2017-12-06 Route of top part, no optimisation
    [LayoutDB.lyt, PCB.pcb, Revert.lyt]
2017-12-06 FPGA/src/systemc/driver: fix comments and todo
    [driver.cpp]
2017-12-06 First final revision of top drivers route
    [LayoutDB.lyt, PCB.pcb]
2017-12-07 FPGA/src/driver_controller: Fully sync reset
    [driver_controller.sv]
2017-12-07 FPGA/src/driver_controller: Fix assignments in combinatory block
    [driver_controller.sv]
2017-12-07 FPGA/src/top_module: Add missing interconnect wires
2017-12-08 Add all LEDs + drivers + buffers in schematic
    [LayoutDB.lyt, PCB.pcb]
2017-12-08 Use hierarchical design
    [LayoutDB.lyt, PCB.pcb]
2017-12-10 renderer: Fix getopt stop on ARM
    [main.cpp]
2017-12-10 renderer: Fix shader version string on GLES
    [main.cpp]
2017-12-11 Revert "Use hierarchical design"
    Try using group copy instead of hierarchical design because of the
    difficulties we had with it.
    This reverts commit 1729f5357912b92fa5c78732d171551e63b7b0ef.
    [LayoutDB.lyt, PCB.pcb]
2017-12-11 renderer: Add bundle CI stage
2017-12-11 Add Type 152 - Cluster property to devices
    [LayoutDB.lyt, PCB.pcb]
2017-12-11 Place and route ALL LEDs and top drivers
    [LayoutDB.lyt, PCB.pcb]
2017-12-11 Better decoupling caps for buffers.
    [PCB.pcb]
2017-12-11 FPGA/tb_src/systemc/driver_controller: init testbench with reset Improve monitor so as to run some processes when special events occur. For example, start a new process to check configuration protoco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
    Add protocol check. It forces the driver controller to finish the full
    drawing as soon as it started to draw. It is not asked by the driver but
    gives a good and simple protocol check.
    Use of sc_join: as it is running in a thread with a sensibility
    list, it should use wait_clocked() instead of wait().
    [DE1_SoC.sv, clk_66_0002.v, driver_controller.sv, framebuffer_emulator.sv]
2017-12-12 tools/renderer: test sphere rendering
    Use imagemagick to take a snapshot of the rendering of a sphere, and
    then compare it to a reference one.
    [sphere.obj]
2017-12-12 Add multiplexers to schematic.
    [PCB.pcb]
2017-12-12 Add PDF export of schematic
2017-12-13 FPGA/: fix clock quadrature
    Fix clock quadrature in quartus DE1-SoC project and driver testbench.
    The driver_controller's clock-lse-quad rising edges must ocurres when
    clock_lse is high. The config is now correctly sent to the driver.
    [DE1_SoC.sv, driver_controller.sv, driver_testbench.sv]
2017-12-13 renderer: Change GLSL define for geometry shader
    Some drivers (e.g. Apple's Intel driver) will complain that macros
    beginning with GL_ are reserved.
2017-12-13 FPGA/: test led RGB
    framebuffer_emulator send data to light only the R,G or B leds. The key3
    button allow the user to change the displayed color.
2017-12-13 FPGA/tb_src/systemc/tb_driver_controller: use systemc report and clock_lse
    Use systemc report (SC_REPORT_xxxx and sc_assert), with a message
    counter by severity and a sc_main returing an error value in case of
    error.
    Use the clock_lse module to generate the clock_33 accordingly to the
    modelsim testbench and the real material.
2017-12-13 Place and route bottom of UB0+1
    [PCB.pcb]
2017-12-13 FPGA/src/framebuffer.sv: add buffer swap logic
    [framebuffer.sv]
2017-12-13 FPGA/src/framebuffer.sv: generate counters
    Generate three counters:
    * mul_idx to know which column should be sent
    * led_idx to know which voxel we are reading
    * bit_idx to know which bit of this voxel should be sent
2017-12-13 FPGA/src/framebuffer.sv: compute drivers' address
    Compute at compile time the base address for each driver.
    At runtime the framebuffer will use those base address and simply add
    the correct offset with the counters led_idx and mul_idx. If this is
    still too much computation to get the address in one cycle we can
    compute at compile time all the addresses.
    [framebuffer.sv]
2017-12-13 FPGA/src/framebuffer.sv: pad with 0 after 16 bits
    Add an rgb_counter to know which color we are sending, and wires to
    compute the correct bit address in the voxel. Since we use 6 bits for
    the green it is not a simple modulo. Instead we use a COLOR_BASE
    localparam with the strating bits of the three colors (0,5,11) and add
    to it a color_idx that goes from 5 to 0. When the color is not green we
    substract 1 to this color_idx so it goes from 4 to 0.
    [framebuffer.sv]
2017-12-13 FPGA/src/framebuffer.sv: add blanking
    Add BLANKING_CYCLES paramater and use it to do blanking at every change
    in multiplexing.
2017-12-13 FPGA/src/framebuffer.sv: use blanking when sending bit
    Don't send bit when we are in blanking area.
2017-12-13 FPGA/src/framebufer.sv: remove reading/writing buffer
    The wires reading/writing buffer oesn't create an alias so they were
    just other bufers. Instead use if(current_buffer) buffer1 else buffer2
    to multiplex between the two buffers.
    Also remove the function DRIVER_BASE_CALC as it appears impossible to
    initialize a localparam with a function (plus this function was false).
2017-12-13 FPGA/src/framebuffer.sv: initialize buffer in initial
    Use initial block to fill the buffers with 0 a time 0. This remove the
    verilator error about large loop but means that the buffers won't get
    filled with 0 at reset. Thus it should be removed in the latest
    design to refill with 0 at reset.
    [framebuffer.sv]
2017-12-13 FPGA/src/framebuffer.sv: Use output reg instead of comb. Fix typo.
    [framebuffer.sv]
2017-12-13 FPGA/src/framebuffer.sv: change frame buffer size
    The framebuffer were to big to fit in the FPGA.
    Now the framebuffer only holds a column for each driver, reducing his
    size by 8 times. Hence we have to swap buffer each time we change the
    multiplexing, and change a little bit the way we read the ram and read
    the buffer.
    [framebuffer.sv]
2017-12-13 FPGA/src/systemc/driver.cpp: fix debuging with driver
    [driver.cpp]
2017-12-13 FPGA/tb_src/systemc/tb_driver_controller: fix driver error being demultiplicated
    [main.cpp]
2017-12-14 Route bottom drivers
    Only signals left to route!
    [PCB.pcb]
2017-12-14 Test_LED: Route some wires from drivers down to the bottom
    [PCB.pcb]
2017-12-14 FPGA/src/systemc/driver: refactor and fix lat handling sensitivity
    [driver.cpp, driver.hpp]
2017-12-14 FPGA/: add new demo
    Add a new demo where the leds alternate between red, blue and green.
2017-12-14 PCB/led-test: Add schematic + PCB for LED test PCB
    [led-test.GBL, led-test.GBO, led-test.GBP, led-test.GBS, led-test.GTL, led-test.GTO, led-test.GTP, led-test.GTS]
2017-12-15 Add ESC control using an arduino
    Used for demo
2017-12-18 docs/datasheet/LTC16935f.pdf: add mosfet driver datasheet
2017-12-20 FPGA/src/spi: first implementation of spi module
2017-12-20 FPGA/tb_src/systemc/tb_spi: add testbench for spi driver
2017-12-20 tools/ESC/ESC.ino: fix style
2017-12-21 FPGA/src/rgb_logic.sv: split processes
    Split rgb_logic into different processes. It doesn't handle writing
    correctly, as it resets the address at the end of the frame whilst the
    ram can't store a full frame. It should have a parameter telling the
    maximum number of µBlocks before cycling.
    [rgb_logic.sv]
2017-12-22 FPGA/tb_src/tb_framebuffer: driver LUT, output data handling
2017-12-30 renderer: Fix visualisation w/o geometry shader
    [main.cpp]
2017-12-30 renderer: Fix GLES build
    [main.cpp]
2017-12-30 renderer: Fix distortion of the voxel viewer
    [main.cpp]
2017-12-31 renderer: Fix render for oddball heights
    When using a height not multiple of the max amount of color attachments,
    the pass count calculation was incorrect, making the leftover layers not
    being rendered.
    [main.cpp]
2018-01-06 FPGA/tb_src: fix rgb clock name in systemc testbench
    [main.cpp]
2018-01-06 FPGA/rgb_logic.sv: rest ram_addr after three images
    The fpga's ram is not large enough to store 128 images, so we just store
    three, which is enough to let the framebuffer read data before it is
    overwritten.
2018-01-06 docs/datasheets: add datasheet for connectors
2018-01-06 FPGA/tb_src/framebuffer: Add WRTGS Blanking test and integrity test with remapping of data
2018-01-06 FPGA/src/spi: change coding style to snake_case, refactoring begin/end statements
2018-01-06 Add anti ghosting and framebuffer sync
2018-01-06 Fix typos, add Random values for timings
    [driver_testbench.sv]
2018-01-06 FPGA/tb_src/systemc/tb_spi: connect spi signals to monitor
2018-01-06 FPGA/tb_src/systemc/tb_spi: add trace and generate signals
2018-01-07 renderer: Change voxelization volume
    It was constrained in a 2 units wide volume with the height changing.
    However, meshes going out of bounds vertically create voxelization
    glitches, while goint out of bounds horizontally do not. Thus, change it
    to always be 2 units high (between -1 and 1), with a width depending on
    the horizontal resolution.
    [main.cpp]
2018-01-07 FPGA/src/framebuffer.sv: change comments, buffer structure and addresses
    As explained in the wiki and the framebuffer comments, the panel are
    facing each other, thus they display the same thing at the same time, so
    we only need 40 columns in a slice. When the panels will have made half
    a turn, they will display the 40 other column, so we still have 80
    pixels wide resolution. However this implies that the framebuffer remembers
    that we have made half a turn to send the correct data, or that we change
    the generation of the slices.
    In order for the framebuffer to remain position agnostic, the later was
    chosen. The SBC needs to send even columns for 128 slices, and then odd
    columns for 128 other.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
    [framebuffer.sv]
2018-01-07 FPGA/tb_src/framebuffer: Remove interwining, fix 72-blanking, add encoder data
    [main.cpp, monitor.cpp]
2018-01-08 FPGA/tb_src/systemc/tb_spi/monitor: add command sending support with checking
    Add the support to command sending instead of only generating SCK.
    Add a function to check data and report error in case of differences.
    [monitor.cpp, monitor.hpp]
2018-01-08 FPGA/src/spi: Fix configuration command
2018-01-08 renderer: Adapt shader to only sample useful textures
2018-01-08 FPGA/src/spi: Change rotation data to 16-bit, add rotation data handling
2018-01-08 renderer: Fix stack overflow with large voxelisation resolutions
    [main.cpp]
2018-01-08 renderer: Add "SpiROSE" text mesh
    [text.obj]
2018-01-09 FPGA/src/framebuffer.sv: add WRTGS blanking cycle, fix buffer fill issue
    Add a blanking cycle after swapping the buffers, this matches the
    blanking cycle done by the driver controller after a WRTGS.
    The buffers were never filled after being swapped, this was fixed by just
    monitoring the bit_idx counter.
    [framebuffer.sv]
2018-01-09 FPGA/src/framebuffer.sv: count slices to know where to read in ram
    Remove enc_position, instead use a slice counter to know where to read
    in the ram. Add a parameter SLICES_IN_RAM used by this counter to know
    how many slices are stored in the ram.
    Fix an issue on the image_start_address: replace + 1'b1 by + mul_idx,
    otherwise we will still read the column 2.
    [framebuffer.sv]
2018-01-09 FPGA/src/framebuffer.sv: synchronize the stream start
    Add an input signal to know when the stream should start. It should be
    sent by the rgb_logic when it has written enough slices in the ram.
2018-01-09 FPGA/src/framebuffer.sv: wait for the next slice before sending data
    Add a wait_for_next_slice state that the framebuffer enters whenever it
    has sent the whole slice.
2018-01-09 Led Panel and Rotative base PCB
    LED_Panel contains the LED Panel PCB,
    Rotative_base contains the rotative base PCB,
    Test_LED contains the LED Panel 4 layers edition.
    [BOM.xlsx, DXF_spyro.pcb, LayoutDB.lyt, PCB.dsn, PCB.pcb, ProjectBackup.cfg, Revert.lyt, components.csv]
2018-01-09 Add JAM STAPL Bytecode Player ARM64 Port
    Clone from repository https://github.com/kontron/altera-stapl
    [altera-gpio.c]
2018-01-09 FPGA/src/framebuffer.sv: update to new synchronization architecture
    Use new synchronization signal to simplify code and communication
    between the modules. The framebuffer no longer needs to know how the
    driver controller works, it just waits for a driver_ready signal to send
    data, instead of counting blanking cycles.
    Remove old top module.
    [framebuffer.sv]
2018-01-10 renderer: Switch to sampler2D arrays in shaders
2018-01-10 FPGA/tb_src/systemc/tb_framebuffer: fix compile error with new FPGA architecture
    [main.cpp, monitor.cpp, monitor.hpp]
2018-01-10 FGA/src/spi: Fix miso, implement transmission and test signals
    [main.cpp, monitor.hpp]
2018-01-10 FPGA/src/:framebuffer.sv: add drivers' LUT
    There are two group of drivers, the one on the top of the panel, and the
    one ont the bottom. For each group there two LUTs, one for red and green,
    one for blue. Drivers 1 to 20 are part of group 1, drivers 21 to 30 are
    part of group 2.
2018-01-10 FPGA/src/rgb_logic.sv: add synchronization signals
    Add stream_ready signal, which is outpu when enough slices have been
    written in ram to begin the display.
    Add rgb_enable input, which is input by the SPI module when we should
    start writing in ram. When rgb_enable drives high, the rgb_logic module
    waits for vsync to be low before writing, as we want to start at the
    beginning of a frame.
2018-01-10 FPGA/src/framebuffer_emulator.sv: update to new sync architecture
2018-01-10 FPGA/tb_src/systemc/tb_column_mux/monitor.cpp: fix timing test failing with zero
    [monitor.cpp]
2018-01-10 FPGA/tb_src/framebuffer: Update to new synchronization architecture
2018-01-10 FPGA/tb_src/systemc/spi: add rotation data test and add complexity in the config test
2018-01-10 FPGA/tb_src/systemc/tb_spi: fix the test of data, sended in little endian
    The test were checking the data in big endian instead of little endian.
    now it is computing them in little endian.
    [monitor.cpp]
2018-01-11 FPGA/tb_src/systemc/tb_rgb_logic: fix signals binding according to new architecture
    [main.cpp, monitor.hpp]
2018-01-11 FPGA/framebuffer.sv: LUT endianness, writing index and swap buffer issue
    The last voxel in the buffer wasn't write because the has_reached_end check
    was done one cycle too soon.
    The LUTs declaration (color, driver, base address) written with little
    endianess in mind but stored in big endian as any normal systemverilog variable.
    I changed the declaration to store in little endian to keep the LUT easy to
    read.
    The buffer were swapped too soon, a new signal column_sent help to know
    precisely when they need to be swap.
    [framebuffer.sv]
2018-01-12 FPGA/tb_src/syctemc/tb_framebuffer/: WIP rework test
    The tests suffered from various issues:
    * The driver_ready generation didn't take into account the extra cycle
    needed by the framebuffer to sample it. Thus it should be generated one
    cycle before the real blanking cycle.
    * The fbOuput buffer was fill even in blanking cycle, so was filled with
    irrelevant data
    The code still needs some refactoring to improve test reliability and
    code readability.
    [main.cpp, monitor.cpp, monitor.hpp]
2018-01-12 FPGA/src/rgb_logic.sv: fix ram_addr being incremented while rgb_enable=0
    [rgb_logic.sv]
2018-01-12 FPGA/src/spi: Fix comments and always blocks
2018-01-12 FPGA/src/framebuffer.sv: inverse led numbre, remove extra green bit
    Use 5 bit for eery color, because the green color is already too
    powerful on our leds, and it simplifies the code.
    The led_idx was counting in the wrong order: we want to count from 15 to
    0 as we must send the bits for led 15 first.
    [framebuffer.sv]
2018-01-12 FPGA/tb_src/ststec/tb_framebuffer: fix intergity check
    * The integrity check was using the wrong multiplexing index value to
    construct the reference buffer: it should use currentMultiplexing-2 as
    it is the multiplexing phase when the data were read by the framebuffer.
    * Add a BIT(x, n) macro for readability.
    [monitor.cpp, monitor.hpp]
2018-01-12 FPGA/src/spi: fix typos and control signal
2018-01-12 FPGA/src/spi: fix typo
2018-01-12 lib: Add framework for the misc file
2018-01-12 FPGA/src/spi: change signal names, to be specific to spi
2018-01-12 FPGA/src/spi: indent comments correctly
2018-01-12 FPGA/src/framebuffer.sv: fix slice_cnt issue
    Begin to wait_for_next_slice, and update slice_cnt when updating
    wait_for_next_slice to avoid increasing it too soon.
    [framebuffer.sv]
2018-01-12 FPGA/src/framebuffer.sv: read next slice when waiting for it
    Fill the read buffer with the first column in the next slice when
    waiting for it, so it is ready to display when position_sync comes.
    This cannot be done for the very first slice, meaning that the very
    first column will not be displayed, creating a little artifact at the
    beggining of the stream. However at 30 fps we should no see it.
2018-01-12 FPGA/tb_src/systemc/tb_framebuffer: test several frame and waiting times
    Change singleFrameCheck to frameCheck with two parameters to test
    several frames and waiting times between them.
2018-01-12 FPGA/src/driver_controller.sv: add wait_for_next_slice state
    Add new sync signals, use pistion_sync in the new state wait_for_next_slice.
    Cleanup some case: remove the states whom
    behaviours were the same as default.
2018-01-12 FPGA/src/column_mux: remove module parameters, fix mux time length
    [driver_testbench.sv]
2018-01-12 tools/spi_cli: Add empty rust project for SPI
2018-01-12 FPGA/src/spi: change counter to state machine
2018-01-12 FPGA/src/spi: Add initial state for transmission_step
2018-01-12 lib: Revert to synth resolution in ublocks
    [context.cpp]
2018-01-12 lib: Fix GLSL linting
    GLSL files are now valid GLSL (without C++ raw string bouds). At build
    time, a new target will generate new files with the bounds
    [context.cpp]
2018-01-12 Implement SPI send and receive
2018-01-12 FPGA/src/driver_controller.sv: generate driver_ready and column_ready
2018-01-12 FPGA/tb_src/systemc/tb_driver_controller: complete binding
    Add driver_ready and column_reday signal, change framebuffer_sync to
    position_sync.
    [main.cpp, monitor.cpp, monitor.hpp]
2018-01-12 lib: Move binding related functions to their own file
    [context.cpp, object.cpp, spirose.h, utils.h]
2018-01-13 Add Optionnal command arguments to send via SPI
2018-01-13 lib: Move GL includes to a shorthand gl.h
    [context.cpp, context.h, gl.h, object.h, spirose.h, utils.h]
2018-01-13 Exit early on error
    [main.rs]
2018-01-13 Add default TOML driver conf, fix typos
    [main.rs]
2018-01-13 lib: Fix shader defines with null values
    [context.cpp]
2018-01-13 lib: Fix buffer overfow
    [context.cpp]
2018-01-13 lib: Fix binding buffer target for the FBO
    [context.cpp]
2018-01-13 lib: Fix voxelization and rendering
    [context.cpp]
2018-01-14 lib: Fix dumpPNG too small of a pixel buffer
    [context.cpp]
2018-01-14 lib: Fix texture uniforms to the shaders
    [context.cpp]
2018-01-14 FPGA/src/top_module.sv: remove framebuffer_sync
2018-01-14 FPGA/tb_src/systemc/tb_column_mux: fix clock and reset, handle column_ready
    clk66 was passed to monitor instead of clk33.
    nrst is now handle by the
    main, otherwise it would create a deadlock as monitor waits for clk33 to
    generate the reset, and clock_lse waits for the reset to generate clk33.
    Add a SC_CTHREAD to generate columnReady every 512 cycles.
    Check that muxOut = 0 after the reset.
    Fix timing test: the first timestamp was done at the first cycle, it
    should be reset when muxOut is no longer 0.
    [main.cpp, monitor.cpp, monitor.hpp]
2018-01-14 lib: Fix scene visualization
    [context.cpp]
2018-01-14 lib: Fix visual glitches in visualization
    [context.cpp]
2018-01-14 lib: Save images the proper way around
    libPNG and OpenGL use different Y axis orientations, thus PNGs ended up
    begin upside down.
2018-01-14 PFGA/src/rgb_logic.sv: fix sampling, signals and frame reset
    This commit adds the following:
    + fix ram not being reset at incomplete frame
    + sample addr at negedge and fix end_of_RAM signal
    + fix is_end_of_RAM using the wrong signal
    ram_addr will be sampled at posedge in the ram module, thus it needs
    to be modified at negedge in the rgb_logic module.
    Moreover, there was a bug in the is_end_of_RAM signal. It stemmed from
    the fact it wasn't written like combinatorial logic with an assign.
    Finally, is_end_of_RAM must use the ram_addr counter instead of the
    pixel_counter, because it is checking a RAM property.
    [rgb_logic.sv]
2018-01-14 FPGA/tb_src/systemc/tb_rgb_logic: fix tests for rgb logic
    Fix tests for rgb_logic, adding the following checks:
    + memory addresses are correctly incremented or reset in the normal
    behaviour
    + data written in the RAM is correct
    + rgb_enable and write_enable signals have the correct behaviour
    + in case of incomplete frame, memory addr is correctly reset
    Now, testbench generate data at negedge(clk), because it is expected to
    be treated at posedge by the rgb_logic, so that it can generate its own
    data at negedge.
    This commit also fix checkRAM next address check, which was not using the fact that
    ramAddr can cycle to 0 after a while and needed complex modulo and
    subtractions to work properly wi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
    [monitor.cpp, monitor.hpp]
2018-01-14 FPGA/tb_src/systemc/tb_spi: remove useless tests about UB in spi
2018-01-14 FPGA/: fixes from framebuffer review (see discussion MR !41)
    [framebuffer.sv, main.cpp, monitor.cpp, monitor.hpp]
2018-01-15 lib: tests: Lay foundations for testing the library
    With a sample test program
2018-01-15 FPGA/: fixes from framebuffer review
    [framebuffer.sv]
2018-01-15 FPGA/tb_sc/tb_driver.cpp: fix possible undefine behavior at init
    [tb_driver.cpp]
2018-01-15 Use packed_struct to pack the LED Config
2018-01-15 Send serialized conf via SPI
2018-01-15 FPGA/tb_src/systemc/tb_spi: fix send command test
    Change data at falling edge of sck, as spi.sv samples at rising edge.
    The ss signal must be sent before the first falling edge of sck,
    otherwise the spi module will miss the first data.
    [monitor.cpp, monitor.hpp]
2018-01-15 Add rgb_enable SPI command
2018-01-15 FPGA/src/driver_controller/sv: add psi configuration signals
    Add new_configuration_signal, which is sent by the spi when the driver
    should be configured again. It overrides any state and forces the
    PREPARE_CONFIG state.
2018-01-15 tools/spi-cli: factorize code inside SpiCommand impl
2018-01-15 tools/spi-cli: use Write+Read instead of Spidev type
2018-01-15 FPGA/src/spi: Add rgb enable/disable commands and signals
2018-01-15 tools/spi-cli: test that commands are recognized
2018-01-15 FPGA/tb_src/systemc/tb_driver_controller: fix config cast
    to_uint() was used but this loses the bit [63:32]. Now to_uint64() is
    used.
    Test if the new configuration is sent.
    [main.cpp, monitor.cpp, monitor.hpp]
2018-01-15 FPGA/tb_src/systemc/tb_driver_controller: fix clock and config test
    clock66 was used instead of clock33 in monitor.
    The new config test now spawns and resets the test that check if latgs
    falls at the end of a segment of gclk. Otherwise the segment counter
    wasn't reset when the new config was sent.
    [main.cpp, monitor.cpp, monitor.hpp]
2018-01-15 lib: Fix fitting dimensions algorithm
    [spirose.cpp]
2018-01-15 FPGA/tb_sc/tb_driver: fix log being monstrously enormeous
    [driver.cpp, tb_driver.cpp]
2018-01-15 FPGA/src/driver_controller.sv: fix style and comments
    [driver_controller.sv]
2018-01-15 lib: Proper synthesis for the LED panel.
2018-01-15 FPGA/sensor: Add sensor module, and test base skeleton
2018-01-15 FPGA/src/sensor: Fix handling of signal
2018-01-15 FPGA/hall_sensor: Renaming sensor to hall_sensor
2018-01-15 lib: tests: Fix lint
    [cube_interlace_test.cpp]
2018-01-15 lib/tests: Remove useless sample test
2018-01-16 lib: Fix typos in shaders for GLES
    [context.cpp]
2018-01-16 Add device option to choose SPI device
2018-01-16 FPGA/quartus-DE1_SoC: fix missing signals
    [DE1_SoC.sv]
2018-01-16 FPGA/src/hall_sensor: Fix bug where position_sync was not set to 1 after a top cycle
    [hall_sensor.sv]
2018-01-16 Add insertion outlines and gerber for LED panel placement
    [BOM.xlsx, LayoutDB.lyt, PCB.dsn, PCB.pcb, Revert.lyt]
2018-01-16 FPGA/: rename spi to spi_slave
2018-01-17 FPGA/src/spi.sv: fix byte order and simplify process
2018-01-17 FPGA/src/spi.sv: use comb logic to process shift reg on last cycle
    A bug in the SPI module design led to having the last byte of the config
    processed later, because it needed one cycle more of spi_clk to do it.
    By moving to combinatorial logic for the shift register comparison, we
    can avoid the need of this additional cycle and do the decoding at the
    exact time the new byte is entirely received.
2018-01-17 FPGA/: rename spi into spi_slave
2018-01-17 FPGA/src/framebuffer_emulator;sv: update fb emulator to new sync archi
2018-01-17 FPGA/quartus/hall_sensor: Add DE1-SoC hall sensor test bench
2018-01-17 FPGA/quartus/hall_sensor: Add blinking led for positio_sync visualisation
2018-01-17 FPGA/src/: fix conf use, add buttons to change conf in the top module
    [DE1_SoC.sv, driver_controller.sv, framebuffer_emulator.sv]
2018-01-17 Revert SLICES_IN_RAM to 18
    [framebuffer.sv]
2018-01-17 Remove old SystemC testbench for SPI
2018-01-18 FPGA/tb_src/systemc/tb_spi_slave: fix send command
    When sending a command we first enable sck and wait for its first
    negedge. However when sending commands right after another sck is
    already enable so we don't need to wait, otherwise we will loose a cycle
    and command will be misunderstood.
    [monitor.cpp]
2018-01-18 Test build of spi-cli
2018-01-18 Test SPI cli serialization
2018-01-18 framer: Add basics for the framer
2018-01-18 framer/ci: Setup CI
2018-01-19 framer: Load scene and count objects
2018-01-19 framer: Extract colors from materials
2018-01-19 framer: Voxelize scene and dump to png
2018-01-19 FPGA/quartus-de1soc/parallel-rgb_test/: add display through ram
    Use rgb_logic to write in ram, and a module vga_dumper to read it.
    A button allows to switch between displaying directly the incoming stream or
    the one coming from the ram.
    rgb_logic was using wrong blanking, it has been inverted.
    [DE1_SoC.sv, rgb_logic.sv, vga_dumper.sv]
2018-01-19 framer: Proper option parsing
2018-01-19 framer: Use verbose option
2018-01-19 framer: Add usage description
2018-01-19 framer: Fix signed/unsigned comparison warning
    [main.cpp]
2018-01-19 framer: Add option to view 3D view of voxels
2018-01-19 FPGA/quartus/common: simplify pin instance assignment
2018-01-19 FPGA/quartus/prod: source pin assignment and add makefile
2018-01-20 FPGA/quartus-de1soc/test_panel: toggle config correctly
    [DE1_SoC.sv]
2018-01-20 FPGA/quartus-de1soc/column_mux_test/ add column mux test project
    The project just use driver_controller and column_mux modules.
    switch 9 and 8 connect their ouputs to the gpio.
2018-01-20 Invert 0 and 1 for columns
    [DE1_SoC.sv]
2018-01-20 FPGA/tb_src/driver_controller: Add tests for poker data mode and synchronization with driver_ready
2018-01-20 Send command and arguments as one SPI transaction
2018-01-20 WIP: FPGA/quartus-de1soc: change pinout for drivers
2018-01-21 FPGA/src/rgb_logic: Revert changes on the active state of HSYNC and VSYNC for RGB since it can be chosen on the SBC side
    [rgb_logic.sv]
2018-01-21 FPGA/src/framebuffer_emulator: add rgb image and lut
2018-01-21 FPGA/src/framebuffer_emulator: add rgb animation
2018-01-21 FPGA/quartus-DE1_SoC: Add project from framebuffer to FPGA DE1_SoC
2018-01-21 FPGA/quartus/common: fix LVTTL to LVCMOS for spi and configure PT_6
2018-01-21 FPGA/quartus/common: update assignment to 3.0V LVCMOS
2018-01-21 Rework SPI cli arguments and display
    [main.rs]
2018-01-21 framer: Better viewing angle
2018-01-21 framer: Add simple monkey face test
    [monkey.obj]
2018-01-22 framer/tests: Add multicolor framer test
    [monkey-colorized.obj]
2018-01-22 FPGA/src: move drivers_conf.sv to drivers_conf.sv.conf
2018-01-22 FPGA/src/framebuffer_emulator.sv: fix lint
2018-01-22 FPGA/src/spi_iff.sv: add spi interface module
2018-01-22 FPGA/src/spi_decoder.sv: add spi command decoder module
2018-01-22 FPGA/quartus-de1soc/spi_test: add new spi module
2018-01-22 FPGA/src/spi_iff,spi_decoder: fix missing miso assignment, fix last_ss
    Default state for ss is high, thus last_ss should be reset to 1 instead
    of 0.
    out_reg was too large (56 bit instead of 48), and miso assignment was
    missing.
    miso should receive the msb of out_reg, hence "miso <= ou_reg[47]".
    [DE1_SoC.sv, spi_decoder.sv, spi_iff.sv]
2018-01-22 FPGA/src:sync_sig;sv: use majority vote to avoid glitches
    [DE1_SoC.sv, clk_66_0002.v, spi_decoder.sv, spi_iff.sv, sync_sig.sv]
2018-01-22 Fix SPI MISO transmission
    - cmd_write must be captured when SS falls, not when it raises,
    as the command to which a response is sent is signaled when
    SS raises. There will be no clock cycle to prepare the response
    otherwise.
    - spi_clk ought to be ignored when SS is up. And when SS raises,
    out_reg and spi_miso can be returned to their respective reset
    state.
    - spi_miso can be wired to out_reg[47], it does not need to be
    a register which will incur an additional delay of one more
    clock cycle (in addition to the two clock cycles already
    used to stabilize the SPI clock).
    [spi_iff.sv]
2018-01-22 Set MISO to floating when device is not selected
2018-01-22 Better SPI command decoding
    - Compute the number of bytes in the received command.
    - Return the old configuration when setting a new one.
    - Implement rotation data retrieval.
    - Check that an integral number of bytes has been received.
2018-01-22 Avoid combinatorial computations between registers non sync inputs
    Also, avoid mixing blocking and non-blocking assignment on the same
    signals even if Quartus does not complain when done in the reset block.
    [sync_sig.sv]
2018-01-22 spi out reg: missing closing end in if block
    [spi_iff.sv]
2018-01-22 FPGA/tb_src/systemc/tb_spi_iff/: rework spi test
    Replace spi_slave with spi_iff and spi_decoder.
    Add a clock_lse for the monitor module, so it can generate a lower
    spi_clk.
    [main.cpp, monitor.cpp, monitor.hpp, spi_decoder.sv]
2018-01-22 Fix include file name
    [spi_decoder.sv]
2018-01-22 FPGA/quartus-de1soc/rgb_animation_test/: add button to switch color
2018-01-22 Change pin assignment
2018-01-22 FPGA/quartus_DE1_SoC/framebuffer: Add mux signals and color switch
2018-01-22 FPGA/src/driver_controller: Update to match the new clock architecture
2018-01-22 Revert "FPGA/src/driver_controller: Update to match the new clock architecture"
    This reverts commit fd3897fc79f796a25cdebeeac4fe4fd2786c7da7.
    [driver_controller.sv, main.cpp]
2018-01-22 FPGA/src/framebuffer_emulator: resolve lint issue
    [DE1_SoC.sv, framebuffer_emulator.sv]
2018-01-22 FPGA/lib/driver_cmd: fix lint issue
2018-01-22 FPAG/lib/driver_cmd: fix lint issue
2018-01-22 Stay stuck in STALL unless we have a new config.
    At reset, a new configuration is available (the serialized one).
    [driver_controller.sv, spi_decoder.sv]
2018-01-22 FPGA/quartus-de1soc/spi_test/DE1_SoC.sv: fix spi_miso, rgb_enable led and rotation_data assignment
    [DE1_SoC.sv]
2018-01-22 FPGA/driver_controller: Update to newest clock architecture, update of the testbench
2018-01-22 FPGA/column_mux: Correction with respects to the unique clk at 66 MHz, overdrive timing correction
    [main.cpp]
2018-01-23 FPGA/src/driver_controller.sv: fix typo in signal name
    [driver_controller.sv]
2018-01-23 FPGA/src: Remove clock_lse modules, Rename framebuffer clock
2018-01-23 FPGA/tb_src/framebuffer: Change framebuffer systemc tests to unique clock
2018-01-23 FPGA/tb_src/systemc/tb_hall_sensor/: fix test
    storePositionSync and CheckPositionSync were'nt spawn at the right time.
    Add a second argument to sendHallSignals to choose the length of the
    second half turn. Try small and big speed variations.
    Give the sendHallSignals arguments to the CheckPositionSync method so it
    can compute the expected position_sync number.
    [hall_sensor.sv, main.cpp, monitor.cpp, monitor.hpp]
2018-01-23 FPGA/quartus/05_spi_test: add spi test project for EP3C40
2018-01-23 FPGA/quartus/common: Add assignment in tcl file for the encoder pins
2018-01-23 PCB/: cleanup
    [BOM.xlsx, LayoutDB.lyt, PCB.pcb, ProjectBackup.cfg, Revert.lyt, components.csv, fiducials.csv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]
2018-01-23 PCB/: add README.md to explain projects
2018-01-23 SBC/libSpirose: fix file organization
    Move src/ content to src/spirose so that it becomes possible to build
    other parts of the project (like framer) without installing the library
    in /usr/lib/.
    [context.cpp, context.h, gl.h, object.cpp, object.h, spirose.cpp, spirose.h, utils.cpp]
2018-01-23 FPGA/quartus-de1soc/parallel_rgb_test/: fix gpio declaration
    [DE1_SoC.sv]
2018-01-23 FPGA/quartus-de1soc/rgb_animation_test: remove wire and fix typo
    [DE1_SoC.sv]
2018-01-23 FPGA/quartus/single_led: Add single led test architecture
2018-01-24 tools/framer/Makefile: fix new path to libspirose
2018-01-24 .gitlab-ci.yml: fix build for framer
2018-01-24 framer: Fix CI
2018-01-24 framer: Fix bundle step
2018-01-24 FPAG/src/: replace counter logic declaration with integer
    [driver_controller.sv, framebuffer.sv, framebuffer_emulator.sv, hall_sensor.sv, hall_sensor_emulator.sv, rgb_logic.sv]
2018-01-24 Better error handling and reporting in spi_cli
    [main.rs]
2018-01-24 FPGA/quartus/common: Fix overlapping wildcards in pin assignment
2018-01-24 FPGA/quartus/single_led: Update signals to new pin assignment notations
2018-01-24 FPGA/quartus/hall_sensor: Change to new notations for driver pin assignment
2018-01-24 Add TCL of pin assignments to main tcl
2018-01-24 Add PLL, fix typo
    [spi_test.sv]
2018-01-24 Correct top module and add timing assignments
    [topmodule.sv]
2018-01-24 FPGA/quartus/hall_sensor: Add driving of new_configuration_ready to get out of the STREAM state of driver controller
2018-01-24 fpga/rgb_test: Fix test build
    [rgb_test.sv]
2018-01-24 FPGA/quartus/single_led: Use of correct top module for the test
    [top.sv]
2018-01-24 framer: Fix deps variables
2018-01-24 FPGA/quartus/single_led: Fix for signals
    [clock_66.v, top.sv]
2018-01-24 FPGA/quartus/single_led: Rework of the test number
    [top.sv]
2018-01-25 Add mux, fix typos
    [top.sv]
2018-01-25 FPGA/src/framebuffer.sv: fix lut
2018-01-25 FPGA/quartus/hell_sensor: Fix the sending of new_configuration_ready
    [top.sv]
2018-01-25 FPGA/src/framebuffer: fix sync between framebuffer adn driver_controller
    [driver_controller.sv, framebuffer.sv]
2018-01-25 FPGA/quartus/09_column_mux/: rename project, add driver lut
2018-01-25 FPGA/quartus/10_single_led/: fix ram_data value
    [top.sv]
2018-01-25 FPGA/src/: add driver_lut module
2018-01-25 Fix typos, add default_nettype none to test 09
    [top.sv]
2018-01-25 Bugfix: Full panel display, columns are all ok
    [driver_controller.sv]
2018-01-25 FPGA/src/framebuffer: Fix the way the data is output relatively to the clokc_enable signal
    [framebuffer.sv]
2018-01-26 FPGA/spi: Add SV implementation for MUX commands
2018-01-26 FPGA/spi: Add driver data command to spi parser
2018-01-26 FPGA/src/spi_iff,spi_decoder.sv: fix verilator lint and tb
    [main.cpp, monitor.hpp, spi_decoder.sv, spi_iff.sv]
2018-01-26 New version of driver controller
2018-01-26 FPGA/src/: simplify driver controller
2018-01-26 FPGA/src/driver_controller: fix missing state transition
    [driver_controller.sv, main.cpp]
2018-01-26 FPGA/src: add control of every led
2018-01-26 FPGA/quartus/12_spi_display: add project using spi to control leds
2018-01-26 Rewrite unsafe code and provide better error messages
    from_str_radix() will complain about non-binary data with a meaningful
    message.
    [main.rs]
2018-01-26 PCB/LED_panel: update resistor value
2018-01-26 FPGA/src/driver_controller.sv: fix verilator lint
    [driver_controller.sv]
2018-01-26 FPGA/src/ separate driver_controller from the one used in spi demo
2018-01-26 FPGA/src/framebuffer.sv: remove framebuffer test
2018-01-26 FPGA/quartus/06_spi_test/: fix top name issue
    [top.sv]
2018-01-26 FPGA/quartus/09_column_mux: remove sout in driver_controller
2018-01-26 FPGA/src/driver_controller_spi_driven: fix lut
2018-01-26 Bugfix: include right driver_controller (with spi)
    [top.sv]
2018-01-26 FPGA/src/driver_controller_spi_driven: use litendian on lut
2018-01-26 FPGA/quartus/caterpillar_test: fix project to test lut
    [top.sv]
2018-01-26 Bugfix: remove ambiguous caterpillar.qsf name
    [top.sv]
2018-01-26 Add 3rd LUT for driver
2018-01-27 FPGA/src/driver_controller_spi_driver: fix lut for 3rd driver line
2018-01-27 FPGA/src/framebuffer.sv: update to send data by 48 bit packet
    The new driver_contreoller module now require 48 bit packet when sending
    driver ready, corresponding to a bit of each led (or to speak in terms
    of lat command, one WRTGS). After 9 driver_ready (8 WRTGS plus 1 LATGS)
    we swap the buffers.
    [framebuffer.sv]
2018-01-27 FPGA/src/ resync framebuffer and driver_controller
    Change the way driver_ready signals are sent to the framebuffer: one is
    sent for each 48 bit packet.
2018-01-28 FPGA/src/framebuffer.sv: fix counters
2018-01-28 FPGA/src/: fix driver_ready sent too soon to framebuffer
    [framebuffer.sv]
2018-01-28 FPGA/src: fix driver_ready sent 9 times instead of 8
2018-01-29 FPGA/src/framebuffer.sv: fix missing column_ready in slice_cnt increment
    [framebuffer.sv]
2018-01-29 FPGA/src/driver_controller_spi_driven: fix sync signals sent to the framebuffer
2018-01-29 FPGA/src/framebuffer.sv: change ram_addr computation
2018-01-29 FPGA/src/framebuffer.sv: try to fix gclk segment
    [framebuffer.sv]
2018-01-29 FPGA/src/framebuffer.sv: send test pattern
2018-01-29 Add send_driver spi_cli command to send full data to drivers
2018-01-29 Add manage and release spi commands to help debugging with the spi module
2018-01-29 Rename signals from SPI
2018-01-29 FPGA/src/: rework driver_controller
2018-01-29 FPGA/src/framebuffer_poker_lut: add lut for poker mode
2018-01-29 Fix 12_spi_display compilation errors
    [driver_controller.sv, spi_decoder.sv, top.sv]
2018-01-29 Use fixed framebuffer_poker_lut in spi_display
    [top.sv]
2018-01-30 FPGA/src/: add spi debug command, fix mux in driver_controller
    [color_lut.sv, driver_controller.sv, hall_sensor_emulator.sv, spi_decoder.sv, top.sv]
2018-01-30 FPGA/src/driver_controller.sv: send gclk only after config and first latgs
2018-01-30 FPGA/src/driver_controller: fix delayed assignment in always_comb
    [driver_controller.sv]
2018-01-30 FPGA/src/: test driver_controller with spi, add lut
2018-01-30 FPGA/src/driver_controller.sv: add TMGRST, LINEREST, and allow to resend config
2018-01-30 Fix typo in signal length
    [top.sv]
2018-01-30 Send 48 bytes of driver data
2018-01-30 spi_decoder: Add command to override driver LUT
2018-01-30 SPI: fix mosi shift register size
    [spi_decoder.sv, top.sv]
2018-01-30 Fix incorrect pin assignment
    [poker_formatter.sv]
2018-01-30 Remove last byte sent by error on send_driver_rgb
    [main.rs]
2018-01-30 Bugfix: send_poker send 1b of 0 at the end, shouldn't
    [main.rs]
2018-01-30 Accept a configurable SPI frequency
2018-01-30 Trace SPI device opening in verbose mode
2018-01-30 FPGA/src/driver_controller: fix deadlock when reconfiguring
    [driver_controller.sv]
2018-01-30 Add reset command in spi_cli
    [main.rs]
2018-01-31 Replace PLL with double-output PLL (slow and fast) and clock_switchover circuit. As of now : slow = 1MHz, fast = 59MHz.
    [clk_66_0002.v, clock_switchover.v, clock_switchover_bb.v, pll.v, pll_bb.v, pll_syn.v, top.sv]
2018-01-31 Fix FPGA lint errors and remove ram
    [ram.v, ram_bb.v, spi_decoder.sv]
2018-01-31 FPGA/src/framebuffer.sv: update to new LRU arch
2018-01-31 Remove clock switch-over to hold timing requirements
2018-01-31 Add RAM+framebuffer in top module, fix address width
    [framebuffer.sv, top.sv]
2018-01-31 FPGA/src/ram_line_writer.sv: add ram_line_writer for spi
2018-01-31 FPGA/src: fix memory manipulation with spi
    [ram_line_writer.sv, spi_decoder.sv]
2018-01-31 FPGA/tb_src/driver_controller: Fixed testbench, test for for the TMGRST command
    [main.cpp, monitor.cpp, monitor.hpp]
2018-01-31 FPGA/src/driver_controller: Add timing constraint after TMGRST
2018-01-31 Receive image from device
2018-01-31 Fix spi_display for memory manipulation
    [spi_decoder.sv, top.sv]
2018-01-31 FPGA/src/spi_decoder.sv: fix opcode decoding for GET_PIXEL_COMMAND
    [spi_decoder.sv]
2018-01-31 tools/spi_cli: add command to debug framebuffer
2018-01-31 Set default SPI speed to 14Mbps
2018-01-31 FPGA/src/framebuffer.sv: update pixel_index counter to reset after first read
    [framebuffer.sv]
2018-01-31 FPGA/src/framebuffer: wait one cycle more for the ram_data
2018-01-31 FPGA/src/spi_decoder: fix multiple driver column and add fb profiling commands
    [spi_decoder.sv]
2018-01-31 Bugfix: use pixel_data and ram addr
    [ram_15.sv]
2018-01-31 Fix conflict resolution error in fb
    [framebuffer.sv]
2018-01-31 Implement SPI reset
2018-01-31 FPGA/quartus/: invert mux on one panel
    [ram_15.sv, top.sv]
2018-01-31 ram_lru: Fix CI with stubs folder
    [ram.v]
2018-01-31 docs: Add hall effect sensor datasheet
2018-02-02 Prevent useless warnings and deny warnings
    [main.rs]
